peterdelecto/cubevox/hardware/reference/README.md

fxbox sources (Teensy-H7-Port 48f1e82), read-only reference; not the cubevox schematic.
