peterdelecto/cubevox/hardware/RUNLOG.md

# Run log
mechanical rules | no ledger (ran before this pass) | rules write: fab table, 3 netclasses, 0 custom rules; facts minima clearance 0.15, track 0.15, via 0.6/0.3, annular 0.15, hole clearance 0.25, edge 0.5 mm.
mechanical register | P0001-P0029 | register init seeded 29 pending entries from classification.json (brief sha 24c1c9e0).
mechanical fixed parts | E0001-E0036 | 36 decided entries, 36 do_not_move courtyard reservations (J1/J101/J106/J108 cite canon:37), board sha aa7361d3 unchanged. Edge-mount dry read for J1/J101/J106 computed x 148.5 (J1 +23.11, J101 -41.5, J106 -83.5 mm from the owner pose), J108 refused (axis +x vs extents 13.57/13.65); nothing applied.
mechanical gates | ledger 0012 (audit) | courtyard_inside_outline PASS 222 checked; edge_connector_mouth_at_edge not measured (J101, J108 no .wrl; J1 +1.527, J106 +3.700 mm); model_inside_courtyard FAIL J106 (right 3.4, below_board 11.0 mm). Gate rows carry no ledger id.
mechanical phase | state.json | phase placement moved from intake; only gate 1 read (state pass intake folds to purpose), mechanical rows were not part of the leaving gates.
placement skeleton render read | layout/renders/skeleton.png, Haiku | 1 yes, 2 no (J117 OLED header faces into the board: it is the panel display, not an edge connector, owner-placed E0019), 3 yes, 4 yes, 5 yes, 6 yes; most crowded upper left (MCU island). Stop: skeleton, owner review of the IC positions.
placement skeleton | D0002, ledger 0018, commit 7fb2764 | U1 (106,84,0) SAI pins to the band under the OLED, U8 (124,102.5,90), U6 (142,102.5,90), U106 (161,88,0), K101/K102 (66/78,56.5) at the output jack; 75 mcu/codec/output passives parked x>=268 for the cluster pass. Airlines: ADC_DOUT 130.1->22.8 (45), I2S_LRCLK 135.5->39.8 (60), USB_DP/DM 51.4/52.8->48.2/49.0 (50); closure 52 intended, 0 unintended; D0001 blocked (K101/K102 in E0031 by 1.5 mm) and re-posed. PRE_OUT 29->233 declared: bypass relay at the jack (canon 84).
placement usb_esd | D0003, ledger 0019, commit 1fed204 | intended 6, unintended 0; airline USB_DM 48.95>53.67 (budget 50, EXCEEDED), USB_DP 48.16>54.69 (budget 50, EXCEEDED), reach C18 5.68>3.93, body_tight 8>7, drc 92>88. Engine row at y 39.05 x 116-134.
placement input_9v | D0004, ledger 0020, commit a9ead93bea4d | intended 4, unintended 0; airline_total_mm 13886.2>13897.4; reach:D105 123.95>134.79; reach:D106 124.92>139.62; 
placement buck5_in | D0005, ledger 0021, commit 25a1a75168c1 | intended 4, unintended 0; airline_total_mm 13897.4>13913.9; reach:C112 5.27>8.39; reach:C113 1.99>8.03; 
placement buck33_out | D0006, ledger 0022, commit 7de04acd3295 | intended 5, unintended 0; airline:/h7core_block/BUCK_SW 8.985>11.829; airline_total_mm 13913.9>13915.8; reach:C21 10.46>8.88; reach:C22 12.53>8.85; 
placement buck33_in | D0007, ledger 0023, commit cc7880faa219 | intended 3, unintended 0; airline:/h7core_block/BUCK_SW 11.829>11.861; airline_total_mm 13915.8>13920.3; reach:C20 2.48>5.45; 
placement ldo_3v3a | D0008, ledger 0024, commit c64e513ed873 | intended 3, unintended 0; airline_total_mm 13920.3>13919.8; reach:C24 2.81>3.56; reach:C25 4.66>4.53; 
placement review | ledger 0024 state | cluster-pass agent stopped: D0003 usb_esd put USB_DP/DM airlines 53.7/54.7 over the 50 budget (canon 29 placement_gate) and D0005/D0007 raised buck input cap reach 2.0->8.0 and 2.5->5.5 (canon 36), accepted under canon:31 (tier 2 excusing tier 1). Power and USB clusters re-placed by hand from the pin map.
placement buck5_out | D0009, ledger 0025, commit 7d85575 | L101 (96,46,0) SW pad on pin 5 line, C114/C115 (100.5/103.5,46,270), C19 (109,46,0); reach up (instrument reads the 5V pin, not L101) declared.
placement buck5_in | D0010, ledger 0026, commit a36a9e9 | C113 (97,53,90), C112 (99.5,53,90) on U103 east flank, C116 (93.5,50,0); reach C112 8.39->4.58, C113 8.03->2.09; airline_total -22.7.
placement buck33_in | D0011, ledger 0027, commit 859d652 | C20 (92,60.9,270) west flank, C23 (96,64,180); reach C20 5.45->2.58; BUCK_SW airline 11.86->8.28.
placement i2c_pullups | D0012, ledger 0028, commit 025b569 | R142/R143 (137/139.5,60.5,270) north of J117 pins; airline_total -29.8.
placement buck33_out | D0013, ledger 0029, commit 7359655 | L1 (97.5,68,180) SW pad under pin 5, C21/C22 (102.5/105.5,68,270); BUCK_SW airline 8.28->6.03 (budget 6, trial route decides); reach C21/C22 9.05/11.28 (reads U1/U4 pins).
placement ldo_3v3a | D0014, ledger 0030, commit 740c9ca | C24 (102.5,63.5,270), C25 (109.5,63.5,270); reach C24 2.33, C25 4.86.
placement pwr_led | D0015/D0018, ledger 0031/0034, commit f6281e8/02f7096 | R10 (109,68,0), D3 (112.5,68,180) east of C22.
placement analog_rail | D0016/D0018, ledger 0032/0034, commit f09063f/02f7096 | FB101 (107,51.5,270) under C19 5V pad, C117 (109.5,51.5,90), R151/R152/C163 (112/114/116,51.5); airline_total -36.1. First pass left C117-R151 at 0.09 and C22-R10 at 0.28 (floor 0.3); D0018 re-spaced both, body_tight 4->2.
placement usb_esd | D0017, ledger 0033, commit 2cb6ede | row y 40.5 under J1: R5 C18 D2 R4 R6 R7 (120.5..132.5), D2 rot 0 flow-through; USB_DM 53.67->48.84, USB_DP 54.69->48.05 (budget 50); reach C18 3.02. Brief side=bottom not followed (register entry).
placement mcu block | D0019-D0030, ledgers 0035-0046 | crystal Y1 (105,95.5,270) HSE_IN 6.7/8, XTAL_OUT 4.1/8, HSE_OUT 3.7/5; SAI stubs R27/R29 2.8/2.6 of 3; VCAP1/2 2.6/2.4 of 5; decaps by pin: W C56/C2, N C57/C1, E C61/C5, E C58/C3, S C4 (pin 6), S C7 plane-fed 7 mm (pin 11, crystal takes the slot), C59 to the north row; bulk C32/C6/C31 north where 3V3 arrives; VDDA C9/C11/C10 row 1, FB1/C8 row 2; mux RC C55/R30 at x 114; reset/boot west; J3 west; LED west. Brief cluster memberships differ from the pin truth for C57 C58 C12 C13 C3 C6 C32 C31 C59 (correction for the owner at the stop). Section gaps under 3.0: north decaps to the power row 1.1-1.6, east decaps to J117 1.0 (canon 110, tier 1 reach over tier 2 gap).
placement codex 3a | audit/2026-10-02-round3-placement-questions.md | 6 questions, 6 replies: BUCK_SW budget 8 and USB 60 pass (brief change for the owner), pin 11 loop and via escape unsure pending geometry, crystal asymmetry and 3V3A run pass.
placement reset_boot room | D0031, ledger 0047, commit 504e361 | owner: more room left of the MCU. SWRESET1 (74,97), C14 (79,97,270), SWBOOT1 (84,97) in a row.
mechanical hand-solder | E0047-E0049 (E0053 after the J108 move), brief assembly.hand_solder_clearance_mm 3.0 | owner: clearance for hand soldering J101/J106/J108. Reservations 3 mm around each connector's pads; foreman has no floor by that name so the number lives in assembly and the reservations enforce it. D105/D106 moved to y 49 (D0032, ledger 0048).
mechanical owner moves | D0033, ledger 0049, commit cff1a08 | owner 2026-10-02: J108 +3 mm rearward (housing face at the edge per the STEP, pads 1.5 mm inside; bushing length NOT VERIFIED, datasheet has no drawing), J117 and ENC101 2.5 mm north (codec gap 2.6 -> 5.1), i2c pull-ups and enc_menu_rc followed. do_not_move entries E0025/E0028/E0031 retired and re-issued at the new poses (E0050-E0052 retired in between because a lock blocks its own move; re-added after D0033). J108's B.Cu courtyard then overlapped K101/K102 by 2.0 on the body-gap read: relays moved to a column x 76, y 59/70 (D0034).
parts J108 swap | ledger 0051 (ERC), 0053 (D0035), commit 1f52183 | owner 2026-10-02: output jack is HOOYA PJ-611E C309282, not NMJ6HCD2. Footprint AUDIO-TH_PJ-611E_1 and .wrl copied from the fxbox library (model offset 2.84/-2.85 kept), symbol spliced into cubevox.kicad_sym, cubevox.json J108 pins 6 OUT_TIP / 2 GND, schematic regenerated with --check-nets (parity: J108 only), ERC 0. Board footprint replaced, netlist sync, parity 0/0/0. Pose (72.5,41.0,90 B): mouth local +x to -y, front face 0.35 inside the edge, thread 8.7 proud; K101/K102 to y 60/70.5 for the body gap. Locks E0056/E0053 retired, E0057/E0058 issued. PARTS.md row 22 and spec item 9 updated.
placement preamp | D0036-D0043, ledgers 0054-0061, commits e337e10..889e0c7 | U104 to (200,79.5,90); mic legs stamped at x 193/207 (R10x y 59.5, clamp row y 63.5, 47u y 70.5, bias R at the pins y 77.5); TRS caps outboard y 70.5 with 100k bleeds below; INA feedback flanking U104, C158 under it, C118 on pin 8; diff quad in one row under U105 at y 90.5 (first at 90.0 left 0.25 to U105's courtyard, re-spaced D0043); C132/R116 between U105 and the pot, C159 east. MIC_P/MIC_N airlines 15.3/15.9 -> 13.6/13.6; body_tight 0 at ledger 0061. All six parts that stood in J101's hand-solder zone are out of it.
placement codec/output/control | D0044-D0053, ledgers 0062-0071 | adc_supply two columns east of U8 with the SAI band above; dac_supply column east of U6 plus C33 west; adc_input at pin 13 (R119/C136/C137 re-spaced D0053 after C137's 1206 courtyard, 5.27 wide not 4.69, overlapped R30 and C138); dac_output chain east at y 100.5; vref under U106, C160 the fan-out; output_buffer north of U106; relay drivers west/east/south of K101/K102; control rows kept from the pre-loop script, C147 and the pot_mux parts moved onto the stamp/grid. parked parts 0; airline_total 10540 -> 6773.
placement silk | ledger 0075, board 88e6877 | foreman silk --prefixes U,RV,SW,J: 38 refs stay on silk, 185 to F.Fab. DRC after: silk_overlap 0 (was 70), silk_over_copper 32, courtyard 0, edge 2 (J1 shell legs, owner part).
placement sai escape | D0054/D0055, ledgers 0073/0074 | routable 0072: 521/523, I2S_LRCLK unrouted at U1 pin 3. R29 to x 99.5, R27 to 97.75 (off-grid, stub 2.97 of 3.0), C2 to x 95. Re-read of routable pending.
placement brief corrections (draft for the owner) | brief sha 6c674db3 unconfirmed | flow order by anchor y with the loop note, mechanical dropped from the flow sections; BUCK_SW 8 / USB 60 (Codex 3a); hand-solder clearance 3.0; J108 PJ-611E pose, J117/ENC101 north; decap memberships by pin; usb_esd side top; buck5_in/buck33_in row. classification.json is still the confirmed 24c1c9e0 set, so the placement_gate reads BUCK_SW against 6 until the owner confirms.
placement render read | layout/renders/placement.png, Haiku | 1 no (the combo jack J101 protrudes about half its body length past the rear edge; owner pose E0028 with 6.9 mm overhang, flange and barrel through the rear plate; NOT VERIFIED against the Neutrik drawing, same open item as J108 had), 2 yes, 3 yes, 4 yes, 5 cannot tell (refs too small in the render), 6 no stray text. Most crowded: the OLED and MCU region.
placement routable | ledger 0076 (routable, after D0055) | 523 connections, 521 routed, 2 unrouted: /3V3 U1-11 -> U1-6 (both plane-fed by via in the power pass; the oracle has no planes) and /GND C12-2 -> U1-49 (ground pass). I2S_LRCLK now routes. Violations 8 (oracle's own, no copper written).
placement inspect | layout/inspections/0002, Sonnet reader | 26 warnings: 22 read a pin-side cluster as "not one row/column" (the brief's axis kind taken literally; placements are pin pairs by design, recorded per cluster E0037-E0078), 4 "no highlight in the crop" (instrument), 1 real: J101/J106/J108 references mirrored on the front silk (DRC mirrored_text_on_front_layer 3; foreman silk placed the flipped parts' refs on F.SilkS) -> silk/production pass item: move to B.SilkS.
placement STOP | board 88e6877, ledger 0075/0076, commit b9491b4 | gate: courtyard DRC 0, body gaps under floor 0, parked 0, every passive in a cluster entry, critical placement_gate all pass except BUCK_SW 6.03/6 (brief 8 drafted, Codex PASS), routable 521/523. Owner review requested: render, brief re-confirm (sha 60510ed3), J101 overhang question to Codex.
codex round 3 response | audit/2026-10-02-round3-response.md | BUCK_SW and USB conditional PASS (8/60 are bookkeeping budgets, not approval of long copper; keep the SW loop tight, keep the pair's ground reference); HSE asymmetry and 3V3A run conditional PASS; NRST/mux escape UNSURE (settling and oscillator clearance to verify at routing and bench); VDD pin 11 FAIL as placed: move a 100 nF beside pins 10/11, short wide connections, not a plane-fed cap 7 mm away. J101: ST-NCJ6FAH gives 6.35 mm seating face to nearest pin row and 5.7 mm face to barrel front; with the model front as the barrel front the board edge sits 1.2 mm behind the seating face (conditional on the model datum).
mechanical J101 face | D0056, ledger 0078 | Neutrik ST-NCJ6FAH: pegs 6.35 behind the panel face; pegs at y 35.31 put the face 0.99 proud of the edge. Owner: move 1.0 mm. J101 (190,45.2); locks and hand-solder zone reissued (E0082/E0083 after retiring E0028/E0047).
mechanical OLED standoffs | D0057, ledger 0079, E0084-E0087 | owner: more clearance for the OLED standoffs. J117 holes are 3.2 mm (M3) at (120.58/150.99, 63.25/91.75); 4.0 mm clearance reserved around each; C3 to (116,95.5), R146 (156.5,93), C160 (157.5,97), C161 (155,101), C139 (155.5,105) moved out of reach.
placement pin 11 | E0088 | owner: shared top-side cap with a 3 mm stub (C4 serves pins 6 and 11, pin 10 via 1 mm from the pad), over a bottom-side 0402.
placement mcu west | D0059, ledger 0084, commit 28636d6 | owner 2026-10-03: use the space west of the OLED. Whole MCU section -10 mm in x (41 moves), east decaps 11.8 mm from J117, standoff radii clear; USB 54/55 of 60, I2S 50/49 of 60, ADC_DOUT 32 of 45; body_tight 0. J101 D0056 (y 45.2, ledger 0080) and standoff parts D0057->D0058 (ledger 0083) applied after KiCad released the board (edits were refused while it was open). E0083-E0086 standoff reservations, E0087 J101 hand-solder zone.
critical start | D0064-D0068, ledgers 0089-0093 | crystal (HSE_IN/HSE_OUT/HSE_XTAL_OUT), SAI source stubs, VCAP1/2, BUCK_SW+BST, BUCK5_SW+BST routed on F.Cu, 45 deg only, route check 0 problems each. Placement reopened for the corner first: Y1 (96.2,96.7), R1 (99,95), C4 (93.35,94.5), R29 straight under pin 4 (91.5,95.25), C15/C16/C7, VDDA row east by 1 (D0062/D0063), C13 west of pin 73 (D0066) so VCAP2 does not cross the USB escape; escape plan for pins 10/11/14/15: vias at (94.3,93.6) (94.9,92.9) (96.6,92.9) (97.4,93.1), SAI pins 2/3/5 fan straight south at x 90.25/90.7/92.35.
critical usb pair | D0069, ledger 0094, commit ee4c8b4 | DP 57.18 / DM 59.26 mm, 2 vias each, mismatch 2.08 of 5.9, B.Cu pair at 0.401 pitch, F.Cu ties at J1/D2/U1, VBUS (0.3) and CC1/CC2 tied, GND vias (125.5,42.75) (92.25,74.0). Fails against stale classification 50 mm (brief draft 60) and gates 51/56 (45 mm coupled flagged on the pair itself, 79% coupled); CC2 hops VBUS on B.Cu (vias 123.64,37.5 / 120.5,38.2); U1 GND via moved from (90.9,73.9), which was 0.125 from C13 pad 1.
power 5V | D0070/D0071, ledgers 0095/0096, commits 9aa01cd/34d8c87 | width 0.4 (table 0.30 for 0.43 A, canon 48), In2 for the L101/U3/U4/relay runs, 9 5V vias, 9 GND vias (5 decap grounds, U103.4, U4.2, 2 CC2 grounds); gates 20, 47 pass, T-junctions 1 (pad), width steps 0, collinear 0. D0071 also removed a 1.4 mm collinear overlap at U3.2 and widened the D2 pin 2 ground tie 0.2 to 0.3. Not met: gate 63 FB101 5VA legs (5VA rail), C19 GND IC-side 3.17 vs 3.0 (anchor is J1.2).
parts STEP models | SW101-108, SWBYPASS1 (ST-0-102 STEP, offset 0/0/0 rot 0), J1 (USB-C STEP, 0/-2.35/0 rot 180), J106 (PJ-002A STEP, -7/4.3/0 rot 180), J108 (PJ-611E EasyEDA C309282 STEP, 10.69/-1.4/6.48 rot 270) | STEP is model 1, wrl dropped to avoid doubled geometry. Aligned numerically by VRML export of a model-only footprint: leads within 0.05 mm of pads, body bbox equals the wrl bbox (J108 exactly, SW/J106 exactly, J1 STEP is 0.29 mm nearer the pads than the wrl). foreman parts reads only .wrl so these refs read "not measured"; baseline J106/J108 model_courtyard_mismatch (B.Cu height read as below_board) is no longer reported. renders/cubevox-panel-parts.step/.png/-side.png re-exported.
power 3V3 | D0072-D0075, ledgers 0097-0100, commits f1e544d/030aaf9/4bcc29f/9f0582a | width 0.4 (table 0.30 for 0.41 A), 0.3 at pads; L1/C21/C22/R10 on F.Cu, In2 ring around U1 and a y 124 bus to the toggle pull-ups, 47 3V3 vias, 24 GND vias (18 decap grounds, U1 49/74/99, Y1.2, U8.5, U6.19). Gates 20, 45, 47 pass, right angles 0, mid-run T 0, collinear 0; all 18 3V3 decaps pass gates 63 and 68. D0072 left 3 mid-run Ts and 0.2 mm stubs (gate 47), so D0073 rebuilt the rail whole and D0074/D0075 removed 4 reversal overlaps and one acute corner at (93.15,99.2).
power 3V3A | D0076, ledger 0101, commit bfea272 | width 0.3 (table 0.20 for 0.06 A, 0.25 floor from canon 48), In2 trunk to the 14 pot pins with two B.Cu hops over the 3V3 lines (30 mm), 17 3V3A vias, 12 GND vias (C25 C27-C30 C101 C111 and IC pins U6 3/9, U101 17, RV111/RV113 pin 1). Gates 47, 48, 63, 68 pass for FB1.1, C25, C27-C30, C101, C111; FB1.2 legs belong to VDDA (D0080).
power 5VA | D0077, ledger 0102, commit c7e9b79 | width 0.3 (table 0.20 for 0.08 A), In2 east from C117 to U104/U105/U106 and R20.1 with 1 mm of B.Cu, 14 5VA vias, 9 GND vias (C117 C118 C127 C130 C134 and U104/U105/U106 pin 4, U6.11). Gates 47, 48, 63, 68 pass for the 5VA decaps and FB101.
power 9V_JACK | D0078, ledger 0103, commit fa51156 | width 0.4 (table 0.30 for 0.27 A), J106.3 to J106.2 and D106.2 on In2, 2 vias. D106 9V_JACK legs pass gate 63.
power VIN_9V | D0079, ledger 0104, commit 77d1e57 | width 0.4 (table 0.30 for 0.27 A), one 129 mm In2 run from D105/D106 to U103 with a 1.5 mm B.Cu hop over the 5V lines, 7 VIN_9V vias, 4 GND vias (C112 C113 D105.2 J106.1). Gates 47, 48, 63, 68 pass for C112, C113, D105, D106.
power VDDA | D0080, ledger 0105, commit 6bdb0f6 | not in the lead's rail list, closes gate 63/68 for C8-C11 and FB1.2: width 0.3, F.Cu links U1.20/21 to C9/C11/C8/C10/FB1.2, 6 VDDA vias, 5 GND vias; the C10 via at (108.45,96.85) has no In2 tie (3V3A line blocks, no hop taken on this analog rail).
power ADC_VCC | D0081, ledger 0106, commit b1e7400 | not in the lead's rail list: width 0.3, R20.2/C44/C45/U8.3 on F.Cu with one B.Cu hop (5 mm), 3 ADC_VCC vias, 2 GND vias. Not met: gate 68 C45 ground via 2.25 mm vs 2.0 (every via cell within 2.0 mm of C45.2 is blocked by C46/C47/C49 and the 3V3 vias).
power VREF | D0082, ledger 0107, commit c553e48 | not in the lead's rail list: width 0.3, In2 run (103 mm) tying C160.1 and the five divider ends R103/R106/R112/R123/R146 with two B.Cu hops, 9 VREF vias, 1 GND via. C160 passes gates 63 and 68.
power ground ties | D0083/D0084, ledgers 0108/0109, commits 5134ba5/7aa3991 | C18.2 own ground via (gate 68, was 2.75 mm) and the CC2 ground via moved to (119.6,37.4) so J1.2, the nearest anchor for C19 ground, has a via at 2.4 mm (gate 63 now 0 leg fails). Gate 63 passes; gate 68 fails only C45.
power STOP | ledger 0109 | rails 5V, 3V3, 3V3A, 5VA, VIN_9V accepted plus 9V_JACK, VDDA, ADC_VCC, VREF; 191 vias on the board; gates 20, 45, 47, 48, 63 pass, 68 fails C45; right angles 0, mid-run T 0, collinear 0, micro 0; DRC errors unchanged (5, J101 annular and edge). Gates 10, 19, 35, 37, 51, 56, 89, 111 fail for reasons outside the power pass.
mechanical OLED north 5 | D0085, ledger 0110, commit 4665dc8 | owner 2026-10-03: J117 (135.785,72.5), ENC101 (173.942,70.5) and their pull-ups and RC parts 5 mm north, 7.5 mm in total; E0054/E0055/E0083-E0086 retired and re-added as E0090-E0095 at the new poses and hole centres. Body gaps min 0.28 (two crystal pairs), courtyard_open none. Closure read drc_board_errors 5 -> 30 and shorting_items 0 -> 7 from the 3V3 copper left on the old pin positions. Enclosure: window and mounting holes 7.5 mm north of the first drawing.
power 3V3 OLED rebuild | D0086, ledger 0111, commit 848a404 | removed 25 segments and 5 vias of 3V3 near J117, R142/R143, R127-R129 and routed J117.2, R142/R143, R127, R128, R129 again (In2 0.4, one 3.9 mm B.Cu hop over the VIN_9V line, 4 vias). drc_board_errors 30 -> 5, shorting_items 7 -> 0, unconnected 384 -> 378; right angles 0, mid-run T 0, collinear 0.
brief reconfirm | sha 0ac6ed47 | classification.json regenerated with `foreman brief check cubevox.kicad_pcb --brief layout/brief.json --write-classification`; USB max length 50 -> 60 mm.
power relay rebuild | D0092, ledger 0119, commit 9188f8a | after D0090 (relay group 3 mm east): removed 13 segments and 2 vias of 5V/3V3 copper on the old poses, re-laid K102.1 via + D109.1 link, the In2 5V run to K102 and SWBYPASS1.1, R120.1 via and In2 tie, C20.1 to its via straight on. drc_board_errors 9 -> 3, shorting_items 2 -> 0, unconnected 384 -> 378.
pad entry audit | tools/pad_entry_check.py | owner rule canon 132 (straight-on pad entry): 51 violations on the board, all 45 degree entries; 47 after D0092.
pad entry repair | D0093-D0105, ledgers 0120-0132, commits cb3906e..f3fd9dd | one declaration per group: 3V3 13 (D0093, D0094 removed two overlaps against existing stubs), 5V+GND 4 (D0095), VDDA 6 (D0096), 3V3A 3 (D0097), ADC_VCC 3 (D0098), 5VA 2 (D0099), 9V_JACK 2 (D0100), VCAP 2 (D0101, VCAP1 3.20 mm, VCAP2 1.51 of 5), buck BST 4 (D0102, two diagonal tails trimmed), SAI U1.1 (D0103, 2.31 of 3 mm), USB R6.1 (D0104, VBUS), crystal 6 (D0105: HSE_IN 5.49 of 8, HSE_XTAL_OUT 2.65 of 8, HSE_OUT 4.46 of 5, 0 vias, 0.28 mm pairs untouched). Checker count 51 -> 0; no new vias; drc_board_errors 3, shorting 0, overlaps 0, mid-run T 0, right angles 0.
J101 NPTH | D0106 (supersedes D0091), ledger 0134, commit 4ad30f3 | owner converted J101's three peg pads to NPTH (footprint library changed to match). D0091 refused on accept: its baseline 0116 predated the router rebuild, so PRE_OUT and the airline total read as unintended; retired and re-declared on baseline 0132. drc_board_errors 3 -> 0, drc_board_total 120 -> 114, unintended 0. Lock re-added as E0099 (B.Cu courtyard box at y 45.2). GUI save had dropped the foreman.pour_* board properties; the committed board keeps them.
power redundancy cleanup | D0110-D0124, ledgers 0139-0153, commits d039319..474f08b | via hops and loops removed on /3V3 (A north row D0110, B C5/C61 D0111, C D0112-D0115), /3V3A (D0116 C29/C30, D0117-D0119 U6/C101/C111, B.Cu reroute fixed a GND short and a right angle), /5VA (D0120-D0122), VDDA (D0123, F.Cu only, no In2 feed), VIN_9V (D0124). Vias 187 -> 160, segments and copper down, loop-closing segments 0 on all five nets (cvx_loops.py), drc_board_errors 0, pad_entry_check 0, unintended 0. Gate 63 regresses where one shared via sits beyond 3.0 mm of a decoupler leg (C6, C32, C46, C1, C57, others).
canon 133/134 cleanup | D0125-D0127, ledgers 0155-0157, commits 2b92627, 34baba0, 9c176a6 | D0125 /3V3: C21/C22/R10 joined on F.Cu, via 101.65,65.5 removed, In2 crossing loop at 106.96,70.99 removed. D0126 /5V: second C19 via 105.0,47.1 removed, In2 trunk re-attached to via 105.55,47.65. D0127 ADC_VCC: all three vias and B.Cu/In2 hops removed, F.Cu chain carries the net. Gate 134 8 -> 0. Gate 133 8 -> 5; the five left are 0.0 mm artifacts of through vias on the edge of TH pads (RV111.3, J106.3, and GND vias at RV111.1, RV113.1, J106.1), not copper loops.
gate 45 and right-angle cleanup | D0128-D0129, ledgers 0158-0159, commits da40681, a492418 | /3V3 In2 junctions rebuilt so no angle is under 90 degrees: 82.55,91.25, 92.5,95.9, 101.65,65.5 and 105.8,70.5 (the last two from D0125). Branches leave the trunk perpendicular with a stub of 0.9 mm or less, then bend 45 degrees. Gate 45 4 -> 0, right_angles 0.
TH-pad via trial | D0130 removed the vias at RV111.3 and J106.3 (gate 133 5 -> 3) but gate 63 went 30 -> 33 fails (C29, C30, D106 lost their via); D0131 (ledger 0161, commit 6f4cce5) restored them. Gate 63 stays at 30 fails, all introduced by D0110-D0127, none present at ledger 0138.
TH-pad via move | D0132, ledger 0162, commit dee3363 | RV111.3 via moved to 187.0,144.0 (straight F.Cu track from the pad centre), J106.3 via moved to 232.6,37.0 (straight F.Cu track from the pad centre, In2 re-attached to J106.2). Gate 133 5 -> 3 (GND artifacts left), gate 63 unchanged at 30, gate 134 0.
ADC_VCC U8.3 split | D0133, ledger 0163, commit cffde3b | F.Cu segment 125.2,103.2 to 128.85,103.2 split at U8.3's centre (126.8,103.2) so it ends in the pad. Segments 616 -> 617, unintended 0, gate 63 unchanged at 30.
USB D2 + VBUS link | D0160, ledger 0192, commit 2fc50c9 | D2 flow-through pads bridged (DP 6-1, DM 4-3), J1's two VBUS pins joined by a B.Cu hop to a new via on the A4B9 track. Unconnected 169 -> 166, DRC errors 0.
Codec bus | D0161, ledger 0193, commit 2d55ecf | I2S_BCLK, I2S_LRCLK, I2S_DATA, ADC_SCKI, ADC_DOUT routed MCU -> codec on B.Cu lanes over the 3V3 island (DATA 93.9/94.15, LRCLK 94.5, BCLK 100.55, DOUT 101.2, SCKI 102.3). Pin 6/11 3V3 via moved under pads 7-9 at 94.3,92.9 feeding C4.1; U8 west GND vias moved under the body; U6 GND vias at x 141/143; ADC_VCC rebuilt R20 > C44 > C45 > U8.3. Gate 71 21 -> 6, gate 45/133/134 pass.
Codec bus fix | D0162, ledger 0194, commit c9b6fe7 | Ground via beside every bus via (gate 17 pass), BCLK and LRCLK chained through U8.8/U8.7 instead of branching at vias, DOUT via in line with U8.9, R20/C44 0.35 mm west for a ground via at 136.4,100.1. Gate 132 0 on the bus nets.
LRCLK U8 turn | D0163, ledger 0195, commit b0f59ff | LRCLK F.Cu leg north of U8 lengthened to y 96.3 so gate 136 reads a turn, not a jog. Gate 136 15 -> 14.
J1 west 10.39 mm (owner) | D0164, ledger 0196, commit 348adb9 | Owner moved J1 to x 115.00; D2, C18, R4-R7 and their copper moved with it; VBUS hop rebuilt with on-axis via entries. USB pair rerouted as an orthogonal staircase (four chamfers, diagonals <= 5.9 mm) in place of the 45 mm diagonal. J1 lock E0096 retired, E0108 at the new pose (declare --owner does not re-anchor locks for --actions plans).
USB pair coupling | D0165, ledger 0197, commit c0d9e2f | DM shifted beside DP right after D2 (one 2 mm lane shift) so the pair runs coupled. DP 58.12, DM 57.68 of 60 mm, 0 vias; gates 56, 45, 133, 134 pass. J1 A6/B6 crossover jog recorded as a rule 136 reason.
Owner USB reroute | D0168, ledger 0202, commit 99ab857 | Owner's hand reroute of USB_DP/DM recorded (DP 54.99, DM 54.55 mm, 0 vias) with the 0.041 mm DM sliver merged. D0166 retired (baseline already held the edit). Long 45 degree runs kept by the owner, reason E0110.
R120/C162 to pin 63 | D0169, ledger 0203, commit 90524de | FX_ON_SENSE pull-up and filter moved beside U1.63 (own 3V3 via, own GND via); the 9.8 mm 3V3 trace from the 5V island is gone. K101.5 link left for signal routing.
C3 via stubs | D0170, ledger 0204, commit 187353f | C3 0.3 mm north; 3V3 and GND vias on 0.85 mm side stubs clear of the codec bus B.Cu lanes.
Power LED | D0171, ledger 0205, commit b334761 | R10/D3 column at x 108.3 beside the MCU corner decoupler column; PWR_LED_A routed.
C139/C161 north | D0172, ledger 0206, commit c6cc969 | C139 1.0 mm, C161 0.75 mm north (C160 courtyard limits C161); C139 clears SW105 by 1.41 mm.
MCU pin study | D0186 ledger 0227 (addfda4), D0194 ledger 0235 (39227c6) | Every movable U1 net moved to the edge facing its destination, ordered so the fan-out does not cross (PINMAP.md section 2). I2C1 PB8/PB9 → I2C2 PB10/PB11, nets renamed I2C_SCL/SDA. CC1/CC2 off the MCU (USB data only). Airline total 6978 → 6663 mm. Schematic 43 pins changed (allowed), ERC 0, parity 0/0/0.
VA divider | D0188 ledger 0229, D0190 ledger 0231, D0192 ledger 0233 | R151/R152 beside U106's 5VA pin (C130), C163 at the MCU end (114.5, 87.2). D0188 put C163's GND via on VREF's B.Cu run; the landing helper had auto-declared the short, fixed in D0190 and the helper now refuses rising error metrics. U106 reference moved onto its body (silk overlap). DRC 0.
U106 divider north | D0196 ledger 0237 | R151/R152/C130 north of U106, 2.4 mm clear of the OLED courtyard (owner). 5VA via (158.0, 83.1) on the 5VA island.
Designator prune | D0198 ledger 0241 | One visible designator per part: 186 passives keep the centred Fab text (field hidden), 38 U/RV/SW/J keep the silk field (Fab copy removed).
West fan-out clearing | D0200 ledger 0243 (cb245d8) | USER_LED to PE11 with R3/D1 east of U1, R2 at SWBOOT1, R150/R153 swapped, C12 horizontal. DRC 0, parity 0/0/0.
SWD + MUTE_N | D0202 ledger 0246 | SWCLK/SWO in the J3 pocket (jogs excused E0111/E0112), SWDIO on B.Cu over the 3V3 island (E0113), MUTE_N into R150 from below. Gate 20 flags the SWDIO pocket via, but canon 20 sends a via crossing to a power reference (B.Cu over In2 3V3) to rule 17; gate defect to file.
K101/D104 off J108 | D0204 ledger 0248 | Owner: K101 and D104 physically interfered with J108. K101 rot 90 at (86.3, 49.2), 1.0 mm east of J108's courtyard; D104 below its coil pins at (88.08, 56.05). D104/J108 overlap (-2.27) gone.
C14 at SWRESET1 | D0206 ledger 0250 | Owner: C14 beside SWRESET1 like R2 at SWBOOT1, (60.95, 86.15). ST places the NRST cap at the pin; the long NRST run to U1.14 must stay short of noisy nets.
C29/C30 3V3A bulk | D0208 ledger 0252 | Owner: misplaced between the pot rows. Now at (165, 100.3/102.4) on the 3V3A island's north edge, 12 mm east of the LDO feeder's island entry (153.4, 99.5), each pad on its own via.
ENC102 RC at the encoder | D0210 ledger 0255 | Owner: C146/C147/R130/R131 sat 30 mm from ENC102 across RV103. Now on ENC102's A/B pins (y 151.5/153.6), chain R → C → encoder pin straight down each line. Pull-ups fed by two 3V3 traces from the 3V3 island (vias 55.5/75.5, 128.5), because In2 under the encoders is the 3V3A island.
Clock top-layer attempt | D0211 retired | MCLK via U8's under-body channel shorted U8's own GND/3V3 vias there (7 vias between the pin rows) and a GND via at (88.15, 103.3). Board restored to D0210. Moving U8's ground vias out of the channel would lengthen U8's ground return; not taken.
In2 second GND plane | D0213 | Stack SIG/GND/GND/SIG (canon 10, owner 2026-10-03). In2 copies In1's GND zone; the four rails become traces. 75 rail vias left dangling until each rail is routed.
5VA rail | D0216 | B.Cu 0.3 mm traces from the FB101 via. Gate 134 pairs at (202.5, 82.5) and (135.65, 96.375) still to merge.
3V3A rail | D0222 | B.Cu 0.3 mm. Old F.Cu feeder diagonal (148, 88)→(153.4, 93.4) still a gate 136 row.
J108 3D model | D0226 | J108 uses the PJ-611E STEP with the library offset; panel-parts STEP export carries every jack.
5V trunk | D0229 | B.Cu 0.5 mm from the buck, 8 connections. J117's footprint rule areas now in the router's obstacle map (D0227 crossed them, retired).
J101 2 mm north | D0231 | Owner: the combo jack's through-plate screw holes did not stand proud enough for the enclosure. Traces follow; brief pin and overhang updated.
5V U4/C24 branch | D0234 | VIN_9V on B.Cu at y 55.5 walls the LDO off, so F.Cu: trunk via (156.1, 59.375) → C24.1 → U4.3, and a U4.1-U4.3 tie under the body west side (jog excused E0114). Three plane vias removed.
5V loops | D0236 | D0229 left a 17 mm B.Cu ring at FB101 and a buck loop through via (102.3, 45.5). Both removed; gate 133 0.
5V C20/U3 vias | D0238, D0240 | Vias (93.35, 58.75) and (95.5, 58.9) and their B.Cu branches removed; via (90.6, 59.95) moved onto C20.1's axis. D0240 refills zones (fm edit leaves stale fill around new vias).
3V3 trunk attempt | D0242, undone D0244 | Router plan closed two loops (gate 133). Router fixed: raster island grouping, start disk blocked after the first leg. Remaining loops come from per-pad decoupler vias, so pairs are merged before re-routing.
3V3 via merges | D0247 | U1.100 → C56.1 straight, via (87.25, 90.0) gone; U1.75 into C57's via (88.25, 75.16), via (90, 75.25) gone; R135/R132 share one via at (88.5, 127.0). Top-row U1 decouplers still to merge, then route 3V3.
J101 2.5 mm south | D0249 | Owner correction: J101 at (190, 45.7), 0.5 mm south of its D0056 spot. Traces follow; brief pin and overhang updated.
3V3A/5VA via merges | D0251, D0253 | Each pin feeds its cap on F.Cu with one via: C28.1 → via → U101.24 → C27.1 (C28 0.08 mm S, C27 0.06 mm W; pin 24's via and its 25 mm branch gone), C29.1 → C30.1, U104.8 → C118.1 (C118 0.1 mm W), C134.1 → R20.1 (C134 0.125 mm N). Two 13 mm B.Cu loops the router drew around U104 and over C134 removed. Gate 134 0 on all rails.
3V3A feeder | D0254 | The 7.6 mm diagonal at (148, 88) becomes orthogonal runs with 0.5 mm chamfers along y 90, clear of J117's rule area.
5V pad entries | D0255, D0256 | Buck output node (L101.2, C114.1, C115.1, C19.1, trunk via) is a solid F.Cu 5V pour; its pads are too large and offset for centred traces. K102, C20/U3 and U103 enter from pad centres; K102's via moved onto the pad axis and the trunk bend moved so no diagonal exceeds 6 mm. Gate 132 has no rail rows.
Owner hand cleanup | D0258 | Owner re-drew rail and I2S traces. Audit found three 3V3A loops at pot pin 3s, a 5V loop under the buck via, an 8.4 mm diagonal, a dangling stub and a 45-degree via entry.
Pot-row 3V3A bus | D0260 | Straight buses at y 147.4 (west) and y 143.5 (east), one stub per pin 3, columns pass through the pins. Loops and stub gone.
Via and 5V drop | D0261, D0263 | C101's 3V3A via onto the B.Cu trunk row; the buck via drops on one stem (west branch at y 56.8, chamfer to the y 60.8 trunk).
I2S spacing | D0264, D0266 | DATA and LRCLK lane-change past the x 102/106.85 GND vias: 0.75 then 0.7 mm centres (3W); LRCLK no longer under Y1. Gates 35 and 51 pass.
U4 input cap | D0268 | C24 turned 180 and moved 0.35 mm: U4.1 (IN) -> C24.1 straight 2.2 mm. Gates 63/71 still read a 5V via 7 mm off (plane model); decided E0115.
ADC_VCC 0.3 mm | D0269 | Widened from 0.15 between the C44/C47 and C45/C46 rows; forced jog excused E0118.
Signal-via ground | D0271 | GND vias beside the two CC2 vias and the SWDIO via; gate 20 passes. CC2's B.Cu bridge stays (E0119).
3V3 escape | D0273 | U1 pin 6/11 escape 0.3 mm once clear of the pin field.
Decisions | E0115-E0120 | VDDA bulk caps upstream of C9/C11 by design (E0116); C44/C47 each have their own GND via, gate 68 pairs them by nearest-via (E0117); J1 GND pin to shield trace (E0120).
5VA drop | D0275 | The x 155 drop from the U106/C130 via lands on the west trunk at (155, 96.375); the 9 mm detour east to R117's via and back along y 97.2 is gone (owner).
Pot 3V3A daisy chain | D0277 | Owner: supply runs pad to pad, no stubs. East RV109 -> RV111 -> RV113 -> RV101 along y 145.5, over each pot's pins 1-2 at y 143.5, into pin 3 from the north. West enters RV105 from RV106 below, then RV104 and RV103 from the east.
Toggle pull-up chain | D0280 | 3V3 runs pad to pad through R138.1-R141.1: in from the south, out east on the pin row, down to y 126.3 under each toggle's cap and GND via, up into the next pin 1. R127/R128 keep their T: ENC101 and ENC_MENU_B block the south, the trunk holds the north (owner asked).
3V3 owner routing + fixes | D0281-D0283 retired, D0284 ledger 0332, commits 822caab, 9d97768 | Owner joined 3V3 pads on F.Cu (C2, FB1 vias gone) and began the B.Cu trunk (83.57,79.73 to 86.48,90.71; 91.5,70.31 to 93.7,72.4). Lead: one via per F.Cu group, so (86.5,75.125) and (94.3,92.9) removed; U1.6-U1.100 tie centred on pin 100 at y 90.0; U1.99 GND via to (90.8,89.0) to clear it; micro segments and an overlap at the source via cleaned; pin 6 run 0.3 mm throughout. Open on 3V3: gate 132 at via (97.95,65.3) and J3.1, gate 136 jogs at (96.84,70.26) and (93.4,69.57).
3V3 source cleanup | D0285/D0287 amended, D0286 ledger 0335, D0288 ledger 0339 | U3.1 sense line leaves the F.Cu detour round L1.1 and runs B.Cu from C22's via (88.6,66.825) along y 66.825 into via (97.95,65.3) from the south. A branch off the source trunk failed: a T is either a 45 degree acid trap (gate 45) or two right angles. C1.1 joins C57.1 on F.Cu; J3.1 keeps only its west run to via (83.57,79.73), since J3's peg at (85.0,78.46) blocks a straight north exit. 3V3 rows on gates 45, 132, 133, 134, 136: none.
3V3 orphan vias | D0289 ledger 0341, snapshot bcc57c3 | Owner: the In2 3V3 island went in D0213 but its vias stayed and routing used them. All 29 dangling 3V3 vias removed with their 26 pad stubs (chains up to 3 mm); the encoder feed (55.5..75.5,128.5), the toggle chain end (140.5,122) and the R128 feed (145.5,52) keep open ends for the trunk. Micro segment at via (91.5,70.31) removed. Rule saved: a plane's vias leave with the plane. Open: owner's B.Cu jog at (90.65,70.65), gate 136.
Power-up order decision | Codex 2026-10-04, owner relayed | If 3V3A rises before 3V3 the pots can drive STM32 ADC pins above the injection limit. Fix: sequence the TLV75533 (3V3A) EN from a qualified 3V3 power-good, not series resistors on the wipers. AP63203 has no PG pin, so this needs a supervisor on 3V3 (open-drain, holds EN low until 3V3 is valid) added to the schematic. Schematic change pending; board work on 3V3 continues meanwhile.
3V3 session 2 repairs | snapshot a79cb67, D0290 amended to D0291, ledger 0347, commit b072bb2 | Owner routed 3V3 31 to 13 unconnected. Fixes: C8/C164/C10 each regain their own GND via beside the pad; micro segments and overlaps cleared; T-junctions at R127/R128 straightened; mid-run branches removed. Two extra B.Cu vias for C46 to U6.20 were rejected (one via per pad group) and removed, leaving that link open (3V3 14 unconnected) until C46 is re-placed at pin 20. DRC 0 errors, dangling 2, vias 201. Gate 63 "trace to IC" rows on C3/C5/C6/C7/C31/C32/C46/C47/C59 stand; decoupler re-placement plan pending owner approval.
3V3 decouplers: pin 75 | D0292 ledger 0348, commit 046531b; sch 93cf446 | C1 deleted, C57 now 100 nF. The 3V3 via (88.25,75.16) was a 90-degree F.Cu junction, so it moved to (87.25,74.48): B.Cu trunk in, F.Cu straight through from the J3 run into C57.1. Pin 75 enters C57.1 from the south with its chamfer ending in pad copper. C1's GND via removed. Vias 201 to 200.
3V3 decouplers: pin 50 | D0293 ledger 0349, commit 7cce521 | C5 deleted, C61 now 100 nF at (105.1,77.52) rot 90, pin 50 one straight 1.55 mm, GND via (104.3,77.04). C12 (VCAP1) to (107.15,79.0), closer than the planned 108.71; VCAP1 0.3 mm through the pin row, 0.4 mm from x 104.6, GND via (108.72,79.0). Spine C32.1 to R10.1 is now one diagonal; C32.1's south side feeds C61.1 from the east.
3V3 decouplers: bulk + U8.4 | D0294 ledger 0350, commit d083b2a | C31/C59 deleted and C6.1 to C32.1 joined straight. C46 is registered bulk (brief adc_supply) at (129.225,99.19) rot 90, fed from C47.1's north side, GND via (129.225,97.6); trace to U8.4 is 4.13 mm. C6/C32 entry bulk and C21/C22 buck output caps are reasoned under brief vdd_decap_north and buck33_out. Regression: C46's old GND via (135.5,104.0) was the return via for I2S_LRCLK via (137.1,103.1), so gates 17/20 now fail there (2.47 mm to the nearest GND via, reopens O0164/O0165). Open.
3V3 decouplers: U6.20 DVDD | D0295 ledger 0351, commit 00b9edc; D0297 ledger 0353, commit ee905e7 | New C165 100 nF 0402 at (137.01,105.43) rot 180, pin 20 straight 1.64 mm, GND via (136.53,106.2); trunk reaches C165.1 from the south first. C33 to (136.43,104.13) rot 180, LDOO straight 1.93 mm, GND via (134.85,104.13). SW104 pads start at y 111.71, clear of the trunk chamfer. D0297 fixed C165's FPID nickname (schematic parity back to the 116 pre-existing items).
3V3 decouplers: pins 100/27, C7, tie | D0296 ledger 0352, commit 682a4ba | In-line pairs C56/C2 at pin 100 (fed through new via (82.75,90.0)) and C58/C3 at pin 27 (fed from the FB1 riser). FB1 island tied to the main trunk by V1 (109.5,71.975), B.Cu x 109.5, V2 (109.5,91.0). C7 now directly below pin 11 (pin 11 to C7.1 straight, fed from C4.1); Y1, C15 and C16 moved 2 mm south; HSE_IN/HSE_OUT jog at the pin tips; pin 6 enters C4.1 from the north. Five old gate-132 rows on HSE nets cleared. Vias 198 to 200.
I2S_LRCLK return via | D0298 ledger 0354, commit dd1f35b | GND via (136.2,103.15), 0.90 mm from the I2S_LRCLK via (137.1,103.1), at least 0.27 mm from all F/B copper, tied by the In1/In2 GND planes. Gates 17/20 pass again (0 vias beyond 2.0 mm). O0164/O0165 stay open in the register: foreman closes a reopen only through a consuming declaration, and it refuses to consume a reopened acceptance (A0211/A0212), so no command can close them. The premise they cite (no new gate:17/20 finding) holds again.
Owner 3V3 routing cleanup + USB_DM tee | D0304 ledger 0362, commit 54f56ff (D0299/D0300/D0301/D0302/D0303 retired; tee exception E0121) | Accepted the owner's 3V3 routing (3V3 now 4 unconnected) and the restored USB_DM A7 tee (owner option B; vias would put DM on two layers and fail gate 56). Cleanup: overlapping dangling stubs removed at C165 (137.49,105.43-106.375), R134 (64.5,124.15-125.1) and R133 (84.5,126.1-127.0, now one straight entry); the 0.07 mm 45-degree stub at R135.1 removed. Open: (124.6,106.6) is a three-way junction (U8.4 feed, west trunk, C165 trunk); on a 45/90 grid three runs at a free point always include a 90-degree pair, so the right_angle finding stands (reopens A0229-A0231) until the junction moves to a pad. D0302 was refused (it consumed E0121, which reserves nothing); D0303 was refused (its baseline already held the edit).
3V3 supervisor (SP809) | sch ce6624e; D0305/D0306 amended to D0307, ledger 0366, commit fa55951 | U107 SP809EK-L-2-9/TR (LCSC C412495, SOT-23: 1 GND, 2 /RESET, 3 VCC) on 3V3 drives TLV75533 EN through new net LDO_EN, replacing the 5V tie. Output is push-pull active-low per the MaxLinear datasheet (JLC's open-drain label is wrong), so there is no pull-up. Reset timeout t_RP is 140 ms min / 230 ms typ (560 ms max); threshold 2.9 V. TLV755P EN V_HI is 1.0 V max, so 3V3 drives it fully. TLV755P has active output discharge (R_PULLDOWN 120 ohm typ), so 3V3A is pulled down once /RESET goes low at 3V3 < 2.9 V. Injection check: pots are 10 k (RV101-RV114, RVGAIN1), so wiper source impedance is at least 2.5 k; 3.3 V / 2.5 k = 1.3 mA, under the H7's 5 mA injection limit while 3V3A outlasts 3V3. Placement: U107 (157.75,51.49) rot -90, C166 100 nF (160.45,52.43) straight 2.2 mm from VCC pin 3 with own GND via (161.73,52.43). C24 moved 0.4 mm south to (155.0,52.075) so LDO_EN can run straight along y 50.55 from U4.3 (152.8,50.55) to U107.2 (156.8,50.55); its 5V and GND stubs re-laid, the EN-to-5V tie removed. LDO_EN not routed yet.
3V3 junction at (124.6,106.6) | D0308 ledger 0367, commit 555547d | The free three-way 3V3 junction (U8.4 feed, west trunk, C165 trunk) moved to a straight-through via J (124.6,107.55): both trunks pass straight through on F.Cu at y 107.55 (moved from 107.5/107.525 to keep 0.225 mm from C48's GND via), and the U8.4 feed drops to B.Cu at J and climbs back at via (124.6,103.6). No pad could take the junction: U8.4 (TSSOP pin) has only E/W entries and both are used; C47.1's west side is blocked by U8.5; C46.1 is boxed by the ADC_SCKI via and I2S_LRCLK at x 131; ADC_VCC holds y 102.5. Two new 3V3 vias (202 to 204). right_angles 4 to 3; no new gate rows. Reopens A0229-A0231 stay open in the register: foreman refuses to consume a reopened acceptance, so no command can close them, but the right_angle finding they cite is gone.
3V3 routing complete | D0309 amended to D0310, ledger 0370, commit see git log | Owner finished the 3V3 routing. Last gap closed: the y 125.6 run had split into a west chain into R133.1 and an east chain into R135.1. The west run now enters R133.1 from the west, (67.2,125.6)-(82.6,125.6)-(84.0,127.0)-(84.5,127.0), and R133.1 links north to R135.1's free west side, (84.5,127.0)-(84.5,126.1)-(85.0,125.6)-(86.9,125.6)-(88.35,124.15)-(88.5,124.15). 3V3 unconnected 0. The collinear overlap at R128.1 (169.942,60.5) lies wholly inside the pad copper; owner ruled it is not a defect (register E0122, expect overlaps:up). It reopened A0233-A0235 on the collinear_overlap finding.
Output chain re-placement decision | Codex 2026-10-05, owner approved plan A | OUT_AC from C141 to K102 needed 86 mm and two vias because U6 (DAC) and the output buffer sit east of the I2S bus while the relay and jack sit west. Fix: move U6 and the whole output chain (30 parts) into the pocket SW of U1 so every analog hop is a short via-free F.Cu run; the I2S bus becomes a ~60 mm F.Cu branch over solid GND. Codex: sound; add 22-47 R series footprints at U1 on BCLK/LRCLK/DATA (schematic add, 33 R default), no tee stubs on I2S, keep relay coil currents and the charge-pump caps away from the analog outputs, stitch GND within 1 mm at any layer change, keep coil suppression (D109). Execution staged D-by-D by agent cvx-router; stage 1 blocked on a board-write permission rule 2026-10-05.
Output chain re-placement, stage 1 (placement) | D0311 amended to D0312 then D0313, ledger 0374, commit 4fc99c5 | Moved U6 (DAC) and its decouplers, the DAC filter (R147 C161 C139 R122 R123), K101, D104, U106 with C130 and its VREF parts (R146 C160 R117 R118 C135), R124 C141 R125, K102 and the mute driver (D109 Q101 R153 R150) into the pocket SW of U1, in signal-flow order to the jack. Removed the 175 orphaned items (32 GND tracks and 25 GND vias, 5V via 75.2,72.4, I2S stubs at U6, 3V3/3V3A/5VA/VREF stubs, old DAC chain, OUT_AC and BUF_R copper). DRC 0 errors, 47 silk warnings; unconnected 130 to 173; closure unintended 0, no gate rows. The owner's LDO_EN 0.0035 mm micro segment at U107.2 was removed by hand before accept (micro 0). Re-opened A0033/A0048/A0050/A0175 (body_gap on K101/C141/D109/U106) and A0218 (3V3A right_angle at the removed vias 147.3,99.5 and 147.3,106.28); the 3V3A corners are re-laid in stage 4.
Output chain re-placement, stage 2 (local ties) | D0314 amended to D0315, ledger 0377, commit 8e527e5 | 47 F.Cu segments and 24 GND vias: U6 supply pins straight to C111/C35/C101 (3V3A, VNEG), CAPP/CAPM to C34 with 90-degree steps between C111 and C35, U6.20 to C165 (3V3), U6.18 to C33 (LDOO), U6 GND pins 3/9/10/11/12/16/19 to seven vias under or beside the body; U106.8 to C130 (5VA), U106.4 GND via, U106.1/2 to R146 (VREF_BUF), R146 to C160 (VREF), U106.3 to R117 to C135 and R118 (VREF_DIV); every moved decoupler and GND pad (C111 C35 C101 C165 C33 C130 C160 C135 R118 C161 R125 Q101 R153 K101.6/.8 D104) has its own GND via. Pre-check 0 clearance fails (worst 0.295 mm), 0 loose ends. DRC 0 errors, 47 silk warnings; unconnected 173 to 135; closure unintended 0 after amending for one new right_angle (VREF_BUF corner at 69.0,89.07, U106.2 into R146.1 from the south; 90-degree bends are within the routing rule).
Output chain re-placement, stage 3 (analog chain) | D0316 amended to D0317, ledger 0380, commit 0f9eb33 | 19 F.Cu/B.Cu segments, 4 vias. All-F.Cu, via-free chain in signal order: DAC_OUTL U6.6 to R147 (7.1 mm lane between C35 and C101), DAC_LP R147 to C139 and C161, DAC_AC C139 to R122, DAC_ATT R122 to R123 to K101.4 (under-body entry from the south), BUF_IN U106.5 to K101.3 (2.5 mm straight), BUF_OUT R124 to U106.7, BUF_R C141 to R124, OUT_AC C141.2 to K102.3 (3.3 mm straight) and to R125. MUTE_N R150 to U1 with one B.Cu hop (vias 69.9,82.75 and 81.75,85.5), GND return vias 0.9 and 0.85 mm away. Pre-check 0 clearance fails (worst 0.250 mm). DRC 0 errors, 47 silk warnings; unconnected 135 to 123; closure unintended 0 after amending for two 90-degree corners (BUF_OUT 79.6,89.07 and DAC_ATT 75.4,96.9).
MUTE_N via entry fix, stage 3b | D0318, ledger 0382, commit 32d8a28 | The stage 3 B.Cu diagonal entered via (81.75,85.5) at 45 degrees (gate 132 row, re-opened A0180). Replaced with (69.9,82.75)-(78.5,82.75)-(81.25,85.5)-(81.75,85.5) so the last 0.5 mm runs straight into the via centre. Gate 132 rows for /MUTE_N now 0. DRC 0 errors; unconnected 123. Pre-checks now include a straight-entry check on every via.
Output stage local supply/bias and VREF buffer east, stage 4a | sch 7b80845; D0319 amended to D0320, ledger 0386, commit 2d316b5 | Schematic split (owner decision via lead): new U108 OPA197IDBVR (LCSC C221351, SOT-23-5) is the VREF follower, back east with R146/C160/R117/C135/R118 at their pre-stage-1 positions and its own C167 100 nF; U106 A half tied off (pins 1-2 U106A_OUT, pin 3 BIAS_W); west output stage gets 5VA_W (FB102 from 5V, C168 10 uF, C130 kept at pin 8) and BIAS_W (R154/R155 10 k, C169 10 uF), R123 to BIAS_W. Board: 13 orphaned items removed, 7 footprints added, 35 segments, 8 GND vias (each decoupler its own); U108 OUT to -IN tie under the body. C160 GND via moved out of its 2.8 mm pad to (159.16,95.7) after gate 132 flagged the off-centre end. Netlist parity 0; DRC 0 errors; unconnected 123; no new fails on gates 17/20/45/49/51/56/68/132-138. Open: silk warnings 47 to 140 (std-lib outlines of the new 0402/0805/SOT-23-5 parts against tight neighbours) for the silk pass; re-opened A0170/A0238 (VREF right_angle).
Rails to the moved output stage, stage 4b | D0321, ledger 0389, commit 7f6d093 | 5V: D109.1 to K102.1 on F.Cu with via (74.2,72.4), FB102 its own via (68.5,72.4), B.Cu trunk split at both (leaves MUTE_COIL a path west of D109). 3V3: C165.1/U6.20 via (84.0,102.5) to the existing via (82.75,90.0) on B.Cu; trunk link J (124.6,107.55) east and down x 139.13 to (136.5,124.15) restored (U6.20 had been a pass-through node). 3V3A: C111/C101 vias (73.1,102.4)/(73.1,108.9), B.Cu down x 73.1 and into RV103.3 from the north (first lay overlapped the pots' trunk at RV103.3, gate 133 loop and gate 136 45-degree run; re-laid before accept). 5VA: R117.1 via (162.0,95.753) restored, reconnecting the dangling B.Cu tail; U108.5 into via (158.0,83.1). VREF: R146.2 via (157.25,92.1), original B.Cu trunk along y 91.0 to (197.75,76.5). DRC 0 errors; unconnected 123 to 113; no new fails on gates 17/20/45/49/51/56/68/132-138; overlaps back to the one E0122 row.
3V3 feed to U6.20 through C165, stage 4c | D0322, ledger 0391, commit ef0387f | Gate 47 (A0236 re-open): the stage 4b 3V3 stub at C165 was 0.20 mm against 0.30 mm required for 0.41 A. Re-laid cap-first (trunk -> via -> C165.1 -> U6.20): 0.3 mm stub north of C165.1 to via (83.06,102.665), 0.205 mm from K101.8; B.Cu straight up x 83.06 into the trunk via, which moved from (82.75,90.0) to (83.06,90.0) with its B.Cu run to the J3 3V3 via (83.571,79.73) (top now a 0.42 mm chamfer and a 0.21 mm straight into that via) and its F.Cu run to C2.1 shortened 0.31 mm. To clear that run, J3.5's GND via moved from (83.4,82.27) to (82.3,82.27) (subject /GND not in D0322; recorded here). Moving C165 0.31 mm west instead overlapped U6's courtyard. DRC 0 errors; unconnected 113; gate 47 row cleared; no new fails on the listed gates.
I2S branch to the moved DAC, stage 5 | sch fb83ef3; D0323 amended to D0324, ledger 0394, commit c40a5ed | New 33R 0402 series resistors R156 (LRCLK) and R157 (DATA) per the schematic (R29 stays on BCLK). U1 corner re-fanned (lead-approved A2): LRCLK pin 3 runs all F.Cu into R156 (90.5,98.6); R156.2 via (90.5,99.9) feeds the U8 trunk on B.Cu (old direct via (90.5,93.9) and stub removed, no orphan) and U6.15 on F.Cu. BCLK branches at its straight-through via (91.5,98.2) on F.Cu into U6.13. DATA leaves pin 5 by the owner's escape via (92.25,93.6), B.Cu west to R157 (86.0,93.6) on F.Cu, then B.Cu down x 83.68 and up at (83.68,107.275) into U6.14; the three lanes enter U6 at 0.65 mm pitch (3W). GND via (90.6,97.3) moved; GND returns added at 0.85 mm (DATA vias), 1.4 mm (LRCLK via) and (92.25,97.8) for the BCLK via after gate 17/20 flagged it at 2.94 mm. Exceptions accepted by the lead: LRCLK via return 1.4 mm (lead rule 1 mm, gate 20 2 mm met); DATA escape via entry 0.55 mm (owner's pre-existing pattern, R29 0.085 mm away at 0.7 mm); DATA escape via return is C4's GND via at 1.69 mm (no legal spot within 1 mm). C15/Y1 untouched. Parity 0; DRC 0 errors; unconnected 113 to 110; no new fails on gates 17/20/35/45/47/49/51/56/68/132-138. Silk warnings 140 to 174 for the silk pass.
Output chain leftovers, stage 6 | D0325, ledger 0396, commit 50b2875 | U106 pin 6-7 tie (1.26 mm straight), MUTE_COIL K102.8-D109.2 and Q101.3-D109.2 (down x 70.0, west of D109's 5V pad), SW_BYPASS K101.1-D104.1 along y 95.87; CAPP/CAPM were tied in stage 2. DRC 0 errors, 174 warnings (silk); unconnected 110 to 106; no new fails on the listed gates. Open long runs, no path even with vias at 25 mm margin; each needs a channel through the I2S/ADC B.Cu bundle east of the U1 corner or the pocket's 3V3/3V3A/DATA columns: XSMT (U6.17 to U1.39), FX_ON_SENSE (K101.5 to C162), SW_BYPASS (D104.1 to the SWBYPASS1 toggle), PRE_OUT (K101.2 to R119).
Owner audit repair. D0326 was amended to record the owner state and accepted as D0327 (ledger 0399, f9a1494). D0328 was amended to D0329 and accepted (ledger 0402, 9675a4f) with fix1. USB pair re-laid with diagonals of 6 mm or less and no jogs; mismatch 0.375 mm. VBUS_SENSE moved to y 71.35, clear of 3W to DM. The 3V3 feed now runs on B.Cu to a via at (99.35,73.2). C6 sits in pin 50's east slot, 2.85 mm from the pin, with its own GND via. Its run is trunk to C32, pin 50, C61, C6; trunk-first would push C32 from 3.85 to about 18 mm. C12 moved east. Mic and output stages: R102, R108, C128, R106, R110, C129, R109 and C132 moved, so every pad entry is straight and centred. The A1_FB loop and the A2_FB, PRE1 and I2C jogs are gone. I2C now has 3W spacing. GND micro segments and 45-degree via entries are fixed. Body gaps C6/C61 (0.02 mm) and C12/C6 (0.05 mm) are forced by the slot. DRC: 0 errors, 174 warnings, 73 unconnected.
D0330 was amended to D0331 and accepted (ledger 0405, e085601). C12 moved 0.25 mm east to (109.0,79.0), clearing the C12/C6 body gap. VCAP1 now runs straight to C12.1, and the GND via moved to (110.55,79.0). The C6/C61 gap of 0.02 mm is accepted as E0123, because widening it would break the 3 mm gate-63 budget. DRC: 0 errors, 174 warnings, 73 unconnected.
CC2 via-free reroute + via audit | D0332 ledger 0411 | Owner re-laid CC2 on F.Cu around J1's shell pad (no vias; a via only where a layer change is needed). Whole-board via audit added as tools/via_audit.py (classifies each via as layer change, pad GND via, signal return, or orphan; follows stubs by overlap, not endpoint equality). Removed 2 orphan GND vias left behind by earlier moves (136.2,103.15 ex-LRCLK return; 136.4,100.1). Two misreads during the pass were reverted: R5.2/D2.2 GND vias (pad via with a short stub is normal) and C55.2's via whose stub ended 0.3 mm short (stub extended to the via centre). Added missing GND vias for K102.7 (76.4,66.99) and U107.1 (159.5,50.55). Open: a /5V B.Cu via at (105.55,47.65) at the end of a 9 mm stub from the owner's 5V reroute heading north, left for the owner. DRC 0 errors, unconnected 71.
5V feed finished | D0333 ledger 0413, D0334 ledger 0414 | The /5V trunk ended in a 9 mm B.Cu stub and a via at (105.55,47.65) reaching nothing. L101.2, C114.1, C115.1 and C19.1 now carry a 0.5 mm F.Cu bus at y 44.41; C19.1 runs straight down to a via at the trunk corner (106.53,56.8), which replaces the old via and the corner at x 105.55. D0334 moved the L101.2 entry to the pad centre after gate 132 flagged it 1.59 mm off. via_allow.txt is empty. Vias 218, orphan 0, DRC 0 errors, unconnected 71.
Mic and output chain routed under D0335, amended to D0336 and accepted (ledger 0416, aa218d9). IN_P is a straight R103.1 to R102.2 link. OUT_TIP runs J108.6 to K102.6 to K102.4 on F.Cu with no vias. For ADC_RC, C136 stands upright over R119.2 and C137 moves 0.75 mm west, so C136, R119.2 and C137 sit on one straight run 0.75 mm from the BCLK via; ADC_VINL is re-laid to C137.2. INA_O1's lane drops from y 92.8 to 94.0, and INA_O2 hops under it on B.Cu between (200.6,85.0) and (213.2,92.8). PRE_OUT leaves RVGAIN1.1 on B.Cu along y 95.5 and 98.6, hops to F.Cu at (152,98.6), runs along y 94.0 into R119.1, then crosses the I2S/ADC bundle on B.Cu along y 104.05 (x 87.05 to 116.25), hopping at x 87.05 to reach K101.2. Every signal via has a GND return within 2 mm. DRC: 0 errors, 174 warnings, 63 unconnected (was 71); 226 vias, 0 orphans.
VBUS via removed at J1 | D0337 ledger 0418 | VBUS is a sense net (C18, D2, R6/R7 divider to U1.68), so the owner's point stood: the via at (119.21,37.25) and its B.Cu link from the D2.5 via lifted VBUS under the signal pads for no reason (canon 137). Replaced by a 0.2 mm F.Cu loop that leaves the C18.1 via straight through, passes between R5's pads, climbs at x 108.9 outside CC2's loop, crosses above J1 at y 33.3 and drops at x 121.2 into R6.1 from the right. B4A9 to C18.1 and A4B9 to R6.1 are unchanged; the C18.1 and D2.5 vias stay because D2.5 is enclosed by DP/DM. Vias 225, orphan 0, DRC 0 errors, unconnected 63.
Bundle-crossing group routed under D0338, amended to D0339 and accepted (ledger 0420, ba429f0). MUTE_BASE runs straight down x 72.5. XSMT runs from U1.39 around the VA_SENSE via and down an F.Cu column at x 112. R16 moved there from (148,98.5), and its old GND via was removed. XSMT then runs on B.Cu along y 106.88 under the I2S lines, hops up at (87.05,105.9), and reaches U6.17 under C33. FX_ON_SENSE drops to B.Cu at (97.0,74.19), runs under U1 between the J3 holes and the I2S vias, and hops up at (84.9,98.6) under K101. SW_BYPASS runs on B.Cu around the 5V L, hops up at (80.75,82.6), and its 0.2 mm F.Cu leg reaches K101.1. Every signal via has a GND return within 2 mm. Unconnected 63 -> 57; 233 vias, 0 orphans.
NRST and BOOT0 routed under D0340 (ledger 0422). NRST leaves U1.14 north through an under-body via at (96.5,90.35), runs on B.Cu at y 86.25, bridges over the 3V3 B.Cu line on F.Cu, and splits at via (81.12,86.25). F.Cu from there climbs west of J3 into J3.3; B.Cu runs west into C14.1 through via (60.175,84.6). BOOT0 runs on F.Cu at y 87.0, drops at (81.7,87.0), and runs on B.Cu 0.75 mm south of NRST into R2.1 through via (60.175,94.9). FX_ON_SENSE B.Cu moved south (x 97.7, y 91.0) to open the area under U1. GND via (81.2,86.15) moved to (82.4,84.85). Every signal via has a GND return within 2 mm. Unconnected 57 -> 54; 244 vias, 0 orphans.
Mux group routed under D0341, amended to D0342 for the airline and silk counters, accepted (ledger 0425, 3e57da9). MUX_S0..S3 leave U1's east pins, fan to 0.65 mm pitch, drop to B.Cu at (110.8..113.2, 86.5..88.45) and run east at y 89.5..91.55, dipping south of the OLED hole at (120.6,86.75). They hop to F.Cu at y 94.65/95.6 south of PRE_OUT; S2/S3 enter U101's west pins, S0/S1 go over U101's top into its east pins. U1.15 escapes through an under-body via at (98.9,89.3); NRST's escape via moved to (96.0,89.35). R30 moved (105.0,101.8)->(114.33,94.4), C55 (106.9,101.75)->(113.5,97.0), R126 (151.0,133.5)->(150.81,133.5), C142 (150.0,136.5)->(150.06,136.5). POT_MUX_OUT runs B.Cu at y 93.2, down x 133.6, F.Cu down x 146.6 and B.Cu under U101 into R126.2. DRC 0 non-silk, 46 unconnected, 264 vias, 0 orphans.
Encoder group routed under D0343, amended to D0344 for the airline drop, accepted (ledger 0428, 19a9615). The 3V3 B.Cu trunk north of U1.100 is removed; U1.100's group (C56 10nF, C2 100nF beside the pin, C4/C7 at U1.6/U1.11, the DAC feed via moved to 83.06,90.65) is fed by a 0.3 mm F.Cu link under U1 from U1.75 to U1.11 (19.05 mm). KEY_A/KEY_B/SEMI_A/SEMI_B and BOOT0 escape through under-body vias and run west on B.Cu under the pins; NRST rerouted on B.Cu to its hub via (81.12,86.25). GND pad vias of U1.74, U1.10, U1.99 moved. MENU nets inward under U1, B.Cu east along y 65.4-66.7, into the encoder ring north of the 5VA via. C149 moved (81.5,127.0) rot 180 -> (86.7,129.6) rot 0. DRC 0 non-silk, 34 unconnected, 276 vias, 0 orphans.
Codex round 4 routing audit | audit/2026-10-06-round4-routing-questions.md | Six questions on this session's routing calls, all PASS: the 3V3 under-body link feeding U1 pin 100's group (check drop; 30 mOhm), NRST's three vias (keep C14 close), the pot-mux ADC input RC at the pin (allow settling), the 0.2 mm VBUS sense loop around J1 (ESD stays at the connector), the S0-S3 B.Cu bundle (solid ground reference; low GPIO slew in firmware), and R16 on the XSMT run. Two firmware notes carried forward: ADC sample time for the 100 ns RC, and low speed on the mux select pins.
Silk pass under D0345 (ledger 0430, 02d6f31), no copper change. Kept refs (U, RV, SW, J) at 1.0 mm / 0.15 mm, 0 deg; J1, SW101, SW102, U1, U101, U104, U105, U106, U6 moved clear of pads and courtyards; C165/C166 refs to F.Fab; ENC refs stay on Fab (gate 111). Root cause of most warnings: visible LCSC fields on F.Silkscreen on C167, C168, C169, FB102, R154-R157, U108, now hidden on Fab. Silk segments that crossed pads moved to Fab on the 4 mm electrolytics (polarity chamfers kept), C161, R147, U106; library footprints SW-TH_EC11E, USB-C-SMD_TYPE-C16PIN, CONN-TH_NCJ6FA-H, DC-IN-TH_PJ-002A fixed in hardware/ (silk over EH pads, silk past the edge) so the board matches its libraries. DRC 175 silk + 0 lib mismatch -> 0 + 0; 34 unconnected (POT/TOGGLE, owner).
Zone fills refreshed | D0346 ledger 0432 | The saved zone fills had gone stale, so DRC without a refill showed 248 clearance errors that a refill removed. Zones refilled in place and saved; DRC without refill now 0 violations, 34 unconnected. Closure 0 intended, 0 unintended.
Stray route audit and via removal | audit/2026-10-06-stray-route-audit.md, D0348 ledger 0435, 76e4499 | tools/route_audit.py scanned 1312 segments and 276 vias: no floating, dangling or duplicate copper; 0 orphan vias; 30 B.Cu hops, one (3V3 under U8) with a clear F.Cu path. Owner re-laid I2S_DATA_SRC F.Cu-only (2 vias gone) and POT_MUX_OUT to one via pair (2 gone). This change dropped the 3V3 via pair at x 124.60 (canon 137; the branch now Ts onto the y 107.55 trunk, 2 right angles declared) and the 4 GND return vias the owner's removals orphaned (canon 140). 276 -> 266 vias, DRC 0, 34 unconnected. Open: U101 pins 15/16/17 and Q101.2/R125.2 each keep their own GND via per canon 138; the USB_DM A7 branch Ts onto the B7 run at (115.75,37.25) without a via.
POT_MUX_OUT return vias | D0349 ledger 0436, beaece2 | Two GND vias at (133.90,96.00) and (114.35,93.20), one within 0.8 mm of each POT_MUX_OUT via, close the canon 20 gap the owner's re-route left. 266 -> 268 vias, 0 orphans, DRC 0, 34 unconnected. Rules 138 and 20 kept as written; U101 and Q101/R125 ground vias stay.
OLED socket J117 to SMD | D0352 ledger 0441, 679309e | JLC's hand-inserted THT headers came out crooked on the owner's previous board, so J117's four 1.0 mm PTH pads become the hanxia HX PM2.54-1x4P TP-YQ 5 mm SMD socket (C42379197, 17k stock): 1.27x2.20 pads staggered +/-1.80 about the y 57.75 row, JLC-assembled, reflow self-centring. Pad 1 GND gets a stub to its own via (canon 138); the 3V3, SCL and SDA traces re-end at the new pad centres; the module courtyard grows to -17.9 to cover the pads, which puts it 0.1 mm from R142/R143 (declared; copper gap 0.65, socket body 2 mm clear). No 1x4 SMD female with locating pegs exists at JLC (only Liansheng 2x15/2x20 stacks); Amphenol 91614-304 has pegs but is not stocked and is 6.99 mm tall. Stack: 9 mm standoffs minus 2.5 mm male plastic leaves 6.5 mm of pin in a 5 mm socket; the module's pins must not reach more than 8.5 mm below its PCB. Library, schematic LCSC fields, spec item 22 and PARTS.md updated. 269 vias, DRC 0, 34 unconnected.
Owner move set | D0355 ledger 0446, 35f9312 | R142/R143 north 2 mm onto J117's pad columns (x 137.055/139.595); U4, C25, C24, U107, C166 north 3 mm; FB101, C117 east 1.5 mm; U108 and C167 east 1.25 mm; C163 left in place (1 mm west collides with the MUX_S0 via and feed; it already sits 2.6 mm from the nearest OLED standoff edge). 3V3 trunk re-laid at y 45.6 from C166.1, east to R128 and west to a drop into R143.1; the three-way T at (160.32,45.6) is deliberate (DC rail, a via there would change no layer). SCL now crosses SDA through R143's pad gap at y 50.0 (0.245 mm to each pad): the crossing is forced by U1's pin order against J117's, and B.Cu is blocked by VIN_9V at x 138. SDA is one straight segment. VREF_BUF re-laid with 45° bends, right angles 26 -> 23. U107's GND via moved north to (158.70,46.70). Dry-run on a scratch copy first (DRC 0, pad-entry 19 -> 15). Misfire on the way, mine: the shell chain had pipefail on and tools/pad_entry_check.py exits 2 when it lists violations, so the declare never ran; a closure was then run against reopen id O0208 and acceptance id A0262, which the foreman accepted and which left ledgers 0442/0443 (foreman now refuses non-declaration ids); D0353 was declared on that wrong baseline and is retired, superseded by D0355 on baseline 0444. DRC 0, 34 unconnected, 269 vias, 0 orphans.
Codex round 5 pre-fab audit | audit/2026-10-06-round5-prefab-brief.md, audit/2026-10-06-round5-prefab-response.md | gpt-6-astra, codex exec read-only, high effort, board 135a888. Verdict HOLD, 3 FAIL: (1) J117 CPL row uses the OLED module centre (y 72.5) not the socket pad row (y 57.75), 14.75 mm off, because the footprint origin stays at the module centre; (2) POT01-14 / TOGGLE1-8 still unrouted (34 items, waiting on the column count); (3) BOM/CPL are raw KiCad exports, not JLC-mapped, and J101/J106/J108 appear in the BOM but not the CPL. WARN: mux selects must stay low until 3V3A is up (firmware); C18 board value is the footprint name, not 1 uF; L101 attr through_hole on SMD pads; no fiducials; H101-H104 keepouts not on the board; VA_SENSE stitches 2.6/4.4 mm from its vias; USB pair has no stackup/impedance data in the board; PINMAP.md USER_LED says PB4/U1.90 but the board uses PE11/U1.41. Verified by this session: J117 at (135.785,72.5) with pads at y 57.75, L101 attr through_hole, C18 value "C_0603_1608Metric". Schematic/netlist/board parity PASS (761 pins, 232 refs); In1/In2 single GND polygons; VIN_9V B.Cu run about 0.19 ohm, PASS.
Codex round 5 fixes | D0356 ledger 0447 5ad070d, D0357 ledger 0448 b584962, D0358 ledger 0450 8328c2c | J117 anchor moved to the socket pad centroid (135.785,57.75); pads, courtyard and NPTH holes stay put, the 3D model offset is (0,-14.75,0), and the library footprint carries the same origin, so the CPL now places the socket, not the module centre. C18 value 1uF and LCSC C90540 from the schematic. L101 attr smd (board and library). Four "m3seat" rule areas, radius 3.5 mm on F.Cu and B.Cu at H101-H104, no copper, tracks or vias. Fiducials FID1 (56.45,41.95), FID2 (240.55,41.95), FID3 (56.45,153.05), 1 mm dot / 2 mm mask, board-only, with a 1.5 mm pour keepout each. JLC JLC04161H-7628 stackup written into the board: 0.035 outer copper, 0.2104 mm 7628 prepreg (Dk 4.4), 0.0152 inner copper, 1.065 core, HASL lead-free; the 0.2/0.2 mm USB pair over that prepreg reads about 105 ohm differential by the IPC-2141 microstrip estimate, which is acceptable for USB full speed over 59 mm and is recorded rather than re-routed. Stitch plan from `foreman stitch --max-reach 2.0`: 29 GND vias so every signal via has a return inside canon 20's 2 mm, VA_SENSE's two at (115.44,85.72) and (156.06,82.39) among them; 269 -> 298 vias, via_audit orphan 0. Field sync from the schematic: 31 footprints had lost their library nickname (R0603 for cubevox:R0603 and so on) and 13 carried an LCSC number that differed from the symbol (R102/R105 C31850, R110/R108 C25971, R116 C23138, R6 C4216, R7 C23254, R152/R151 C25804, R150 C21190, C162/C163 C14663, C18 C90540); 167 stale "LCSC Part" duplicates removed, all part fields hidden on F.Fab. Production gates (trial run, ledger refusal bypassed for the 34 pending nets): 1-5, 7, 8, 10-12 pass, 6 not measured (no exposed pad), 9 fails on catalogue quirks only (D2/U108 SOT-23 span at the 2.30 mm boundary, J101 card lists 3 pins for an 8-contact jack). PINMAP.md: USER_LED is PE11/U1.41, PB4/U1.90 spare; firmware notes 6-8 added (mux selects low until 3V3A is up, lowest GPIO speed on them, 2 us ADC sample time on MUX1_SIG_ADC). Owner decision pending: J101/J106/J108 THT jacks are in the BOM and CPL for JLC insertion; drop them from both if hand-soldering.
Jacks hand-soldered | D0359 ledger 0451, f69a8e7 | Owner rule (2026-10-06): a part on the bottom side is owner-soldered; JLC solders the rest. J101 (Neutrik NCJ6FA-H combo), J106 (DC 9V) and J108 (6.35 mm out) sit on B.Cu, so all three are excluded from the BOM and the CPL. Owner has J106 and J108 on hand; J101 must be ordered separately (LCSC C368458 on the footprint; the part card lists 3 pins for its 8 contacts, see gate 9).
Round 6 own audit | audit/2026-10-06-round6-self-audit.md | No FAIL. Schematic WARN: BUF_IN bias/click, D107/D108 clamp placement, pot vs VREF+ ratiometry, J117 pin order vs the purchased module. Board WARN: BCLK under Y1 on B.Cu, HSE/LRCLK over budget by placement, 23 right angles, edge stitching, diode silk marks, 9 lib mismatches.
Slots revision | sch 50164e8, D0360 ledger 0453, 771822f | Owner 2026-10-07. Schematic edited in place (cubevox.json/h7core_block.json are stale since sch fb83ef3 and were not regenerated): ENC102/ENC103 and their RC (R130-R133, C146-C149) become RV115/RV116 on U101 I14/I15 (POT15/POT16); K101, D104 and the PRE_OUT dry path out, DAC_ATT joined to BUF_IN; SWBYPASS1 common on MUTE_SW (ex FX_ON_SENSE), one throw GND; ENC_KEY/ENC_SEMI ports and sheet pins out, PB7/PB8/PB9/PE0 no-connect; R113/R114 are the difference-amp resistors and stay. ERC 0. Board: 12 footprints out, RV115 (64.5,164) and RV116 (88.5,164) rot 0 added, 132 segments and 25 vias out (5 return vias orphaned by the removals included), netlist parity 0, zones refilled. DRC 0 non-lib violations (9 lib mismatches, as before), 40 unconnected (34 + POT15, POT16, 3V3A x2, MUTE_SW, BUF_IN), via_audit 0 orphans. Locks E0023/E0024/E0075 retired, E0129/E0130 added. No new trace or via laid. Render renders/cubevox-slots-rev-top.png.
Slots routing | D0361 ledger 0454 (69f9665), D0362 ledger 0455, D0363 ledger 0456 (1bbcbc4) | Owner go 2026-10-07. Six airlines from the slots revision routed: POT15 (RV115.2 to U101.17) and POT16 (RV116.2 to U101.16) leave the pads west on F.Cu, hop to B.Cu under the POT_MUX_OUT trace at x=141 (via pair each), return to F.Cu and run 45 degree diagonals to the pots (POT16 enters RV116 from north, POT15 passes south of RV116 and enters RV115 from south), 4 vias; 3V3A to RV115.3 and RV116.3 straight on B.Cu from RV103.3 and RV104.3 (x=67, x=91), 0.3 mm; MUTE_SW from SWBYPASS1.2 on B.Cu around the west end of the 5V B.Cu bar, one via at (97.3,74.19), F.Cu west into C162.1 (R120.2 sits in the same island through the existing stub; its own pocket is closed by the 3V3 B.Cu bar at y=73.2); BUF_IN R123.1 to U106.5 on F.Cu. No POT14 route exists on the board (POT01-14 are the owner's open items), so widths follow the signal class, 0.2 mm. Cleanups: 3V3 hop at x=83.06 now a single F.Cu run (2 vias and the B.Cu bar out), R133 dog-leg at (82.6..85.0,125.6) straightened, and the GND return via at (83.77,91.36) that served the hop removed (D0362 accepted with commit none, git add raced a concurrent commit; its board change is in 1bbcbc4). DRC 0 non-lib violations (9 lib mismatches, as before), 34 unconnected (POT01-14, TOGGLE1-8 and the GND plane islands), via_audit 0 orphans, netlist parity 0, zones refilled by the edit. Render renders/cubevox-slots-routed-top.png.
Zone fills after slots routing | no declaration (fill and library id only, no copper added or removed) | kicad-cli DRC on the committed board after 1bbcbc4 showed 20 clearance and hole-clearance errors: the five new vias (MUTE_SW at (97.3,74.19), POT15 and POT16 pairs at x 139.4 and 141.8) against the In1/In2 GND fills, which were saved before the vias existed; the routing DRC had refilled only a scratch copy. Zones refilled in place with pcbnew ZONE_FILLER and saved. RV115 and RV116 footprint ids gained the cubevox: library prefix so schematic parity stops flagging them. kicad-cli DRC without refill: 0 violations beyond the 9 lib mismatches, 34 unconnected; parity leaves J101/J106/J108 BOM-flag and field warnings only. exports/cubevox-netlist.net regenerated (it still listed K101). Astra audit docs/audits/2026-10-07-astra-hardware-audit.md.
Return-via trim | no declaration (GND vias with no outer copper removed, no route changed) | Owner 2026-10-07 ("unnecessary vias are unacceptable"). Strict audit (/tmp/via_audit_strict.py logic: outer-layer track end or same-net pad at the via, else candidate) found 55 GND vias touching no F.Cu/B.Cu copper. All 55 had been placed as canon 20 return vias within 2 mm of a signal via, but canon 17 scopes that rule to critical nets and the brief lists none of 5V, 5VA, 3V3, 3V3A, VREF, VIN_9V, VBUS, BOOT0, NRST, SWDIO, MUTE_N, MUTE_SW, MUX_S0/S2, POT_MUX_OUT, XSMT, VA_SENSE, ENC_MENU_B/SW or INA_O2 as critical. Kept 9 beside I2S_BCLK, I2S_LRCLK, I2S_DATA, ADC_SCKI, ADC_DOUT and PRE_OUT layer changes, and 4 as the only plane stitch within 8 mm: (140.95,94.65), (230.39,53.30), (213.20,91.40), (107.33,56.80). Removed 42 (list in commit). Vias 275 -> 233. Zones refilled (fill unchanged: the vias sat in solid same-net copper). kicad-cli DRC: 0 violations beyond the 9 lib mismatches, 34 unconnected; strict audit 0 orphans. tools/via_audit.py counts any GND via within 2 mm of a signal via as a return regardless of net class, which is how these accumulated; future return vias only beside critical-net vias. Render renders/cubevox-via-trim-top.png.
Outline trim 200x150 to 185x145 | D0366 ledger 0458 (d979edc), D0367 ledger 0459 | Owner 2026-10-07. Edge.Cuts x 56..241, y 30..175 (3 mm corners); In1/In2 GND zones 56.5..240.5 x 30.5..174.5. H101 (59.6,35), H102 (237.4,35), H103 (76.5,170), H104 (220.5,170) with their m3seat areas; the front pair sits on the front edge between pots 1-2 and 7-8, and the rear pair is 1.4 mm west/east of the owner's 61/236 so the hole courtyard stays out of the J108 hand-solder reservation E0058. FID1 (61,42), FID2 (236,42), FID3 (61,128.5) with windows. J106 x 228.5; C159 (237,83.6) (y +1.6 to clear R116's courtyard); SWRESET1 (61,88), SWBOOT1 (61,96.2) (clears C139 and R122 courtyards); C14 (65.82,86.925) rot 270 and R2 (65.82,93.525) rot 90 east of the buttons; RV115/RV116 y 168. Locks E0032-E0036, E0129, E0130 re-added at the new poses by the owner-move declaration. Routing: NRST, BOOT0, 3V3 and GND to the buttons and C14/R2, 9V_JACK to J106, G2_RG and GND to C159, POT15 (south of the pots at y 174.3) and POT16, 3V3A to RV115/RV116; R155 GND via moved to (65.69,91.1) because the old via landed on SWRESET1 pad 4. Vias 233 -> 227 -> 233, no return vias added. DRC on the saved file: 0 violations beyond the 9 lib mismatches, 34 unconnected, parity 3 BOM flags plus field warnings; via_audit_strict 0 true orphans. brief.json and brief.confirmed.json hole poses, J106 and board size updated. Render renders/cubevox-trim-top.png.
Trim follow-up: H101/H102 at 61/236, J108 east | D0369 ledger 0461 (931d7cf), D0372 ledger 0464 (1222c42) | Owner 2026-10-07. H101 (61,35) and H102 (236,35) restored to 5 mm from the rear and side edges. J108 moved 74.0 (was 72.5) so its hand-solder reservation clears H101's seat; OUT_TIP re-landed straight from pad 6 to the existing run at x 79.6, no vias. E0058 re-added at x 64.7..83.3 (E0142). E0048 re-added at J106's pose (E0138) with its east side clipped at x 232.45: the 185 mm outline leaves H102's seat 0.35 mm from J106's pad row, so a full 3 mm east clearance cannot hold. POT15's south run at y 173.8: y 173.3 touched the H103 seat (items_not_allowed), 173.8 clears it and the pot pads by 1.4 mm. DRC on the saved file: 0 violations beyond the 9 lib mismatches, 34 unconnected, parity 3 BOM flags plus field warnings; strict via audit 0 true orphans, 233 vias.
J106 west to x 225 | D0374 ledger 0467 | Owner 2026-10-07 via lead. The tray boss under H102 would overlap J106's ground lug at x 228.5; at 225.0 it clears. 9V_JACK re-landed on the new pads, no vias. E0048 re-added unclipped as E0144 (x 218.85..232.15, the H102 seat starts at 232.5), E0138 retired; lock E0131 re-added by the owner-move declaration. DRC on the saved file: 0 violations beyond the 9 lib mismatches, 34 unconnected, parity 3 BOM flags plus field warnings; strict via audit 0 true orphans, 233 vias.
m3seats 9 mm, J108 east, POT15 west margin | D0376 ledger 0470 | Owner 2026-10-07 via lead: heat-set bosses make each seat 9 mm. All eight m3seat rule areas now 9 mm across, same centres. J108 to x 76.0 (E0142 retired, E0146 at x 66.7..85.3); OUT_TIP re-landed from pad 6 down x 81.6 and diagonal into the x 79.6 run, no vias. POT15 reroutes: diagonal from the hop to (118.3,147.5), a layer hop under POT16's diagonal (vias at 117.8 and 115.7, y 147.5, B.Cu piece between), west along y 147.5 to x 58.3, down the west margin at x 57.2, east along y 173.8 and up into RV115 pad 2 from the south (pad 1 GND sits on the pad row, so a west entry is not possible). Two vias added, 233 -> 235; they are the only layer change on this net. Seat check: no track, via or pad edge within 5.0 mm of H101-H104. DRC on the saved file: 0 violations beyond the 9 lib mismatches, 34 unconnected, parity 3 BOM flags plus field warnings; strict via audit 0 true orphans.
Hygiene: joins, micro-segments, pad entry | D0377 ledger 0472, layout/actions/hygiene-joins-pad-entry.json | Lead 2026-10-08. Four micro-segments out (3V3A (77.67,107.92) and (77.13,107.93), TOGGLE2 (86.05,122.65), 9V_JACK (234.30,46.75)). The 29 mid-track joins now end on a track end, a via or a pad centre, host segments split where a branch lands (USB_DM at (115.75,37.25), the 3V3 R128 branch at (169.942,59.3)); route_audit section 1 29 -> 0. Pad entry 17 -> 0: every diagonal that ended inside a pad became a straight stub and a 45 degree bend after the pad (FB1.1, R128.1, C4.1, C57.1, R135.1, C16.1, U105.2, R5.1, J1.2, 9V_JACK at D106.2). TOGGLE1 and TOGGLE2 clusters rebuilt the same way; the C.1 and R.2 pads sit 0.05 mm apart in y, so no straight entry joins them and a loop above the pads carries the link. Off-angle segments over 0.05 degrees 1 -> 0. Two GND vias moved clear of the rebuilt copper (U6.9 to (77.9,108.58), C119.2 to (216.05,64.2)); the 5VA B.Cu bar now runs at the via's own y 65.55. The 9V_JACK vertical is 0.3 mm because 0.4 mm at x 234.35 would cross the FID2 window edge. The plan moved two vias and removed none (ledger 0472 reads 234 against 235 at ledger 0471; the owner's KiCad cleanup came between), strict audit 0 true orphans, DRC 0 violations beyond the 9 lib mismatches, 34 unconnected (POT01-14, TOGGLE1-8). 3V3A and 3V3 each read as one connected component with 0 dangling ends; RV101-RV116 pin 3 sit on 3V3A and R134-R141 pin 1 on 3V3.
Panel bus | D0378 ledger 0474, layout/actions/panel-bus.json | Lead 2026-10-08. POT01-16 routed from the U101 mux to the pot wipers as a 16-lane 0.2 mm band at pitch 0.7 (y 147.5 to 158), straight via stubs, no GND return vias; POT15/16 diagonals replaced; 3V3A re-fed and C142 GND via moved to clear the band. TOGGLE3-8 switch clusters (SW pad to pull-up) added. Vias 234 to 249. Unconnected 34 to 8: the 8 TOGGLE trunks (switch to U1 pins) are NOT routed. A grid search finds only 30+ via zigzag paths through the x 110-111 corridor and the U1 interior, which fail the via and jog rules. Needs a pin swap or a freed channel.
TOGGLE bus | D0381 ledger 0479, layout/actions/toggle-bus.json (apply format: rm_seg/rm_via/move/track/via, second R3/D1 pass appended) | Lead 2026-10-08, layout/TOGGLE_BUS_BRIEF.md as built. U1 pins 28-42/92/93/98 reassigned in the schematic (commit 965d4b9); pad nets synced. XSMT and TOGGLE1-8 leave U1's east rows on F.Cu lanes x 110.1-113.3, two via combs at x 109.3 and 113.9, six B.Cu trunk rows y 103.1-106.1 stepping to 107.9-110.3, drops into each switch pad 2 on B.Cu; TOGGLE1/2 run west on B.Cu at y 110.0/110.6. MUX_S0-3 on rows 38-40/42 to B.Cu lanes x 114.1-115.9. VA_SENSE inward via (102.1,85.5) and B.Cu over the 3V3 island. 3V3 bar hop (109.3-114.3, y 107.55), 3V3A moved to x 144.5 with an F.Cu hop over the rows, 5VA corner snapped. Parts moved: R30, C55, C58, C3, R16, R3, D1, C163, C138. Brief corrections approved by the lead: step diagonals start 0.6 further east, TOGGLE2 jog at y 109.0, C138 at (121.2,108.0) rot -90; C163 and R3/D1 re-placed for J117's courtyard and the 0.30 body gap. DRC on the saved file: 0 violations beyond the 9 lib mismatches, 0 unconnected, parity 3 BOM flags plus 67 field warnings. Strict via audit 0 true orphans, vias 249 -> 264. pad_entry_check 0, route_audit stray traces 0, 0 micro-segments, 0 off-angle, 0 diagonals over 20 mm. right_angles 21 -> 42 are the brief's L-bends and switch-pad drops. New tight body pair C138/U8 0.02.
TOGGLE bus corners, 3V3 bar, 3V3A hop | D0383 ledger 0483 then D0385 ledger 0486 (baseline 0481, the owner's saved file), layout/actions/toggle-corners.json | Lead 2026-10-08 correction: canon 44 (no 90 degree corners), 136 (no jogs, no 45 run over 6 mm); the right_angles row declared in D0381 was a gate failure. Kept the owner's edits since 255a3d5: C138 at y 108.1 with its GND via at (121.2,111.3), the hand-chamfered TOGGLE2 drop into SW102, the SW101 pull-up stub leaving pad 2 south. 3V3 bar 0.1 down to y 107.65 as one run (hop vias 109.3/114.3, east diagonal to (139.13,109.15)); C138 pad 1 clears it by 0.248. 3V3A: (147.3,103.6) diagonal to (144.5,106.4), straight into the hop via (144.5,107.0); (144.5,130.28) diagonal to (143.7,131.08), straight into the via (142.625,131.08); the 106.28 dogleg is gone. TOGGLE4-8 step diagonals split 2.4/3.2/2.4 so no 45 run exceeds 6 mm. hardware/tools/corner_check.py: 57 corner points before, 15 after. 29 chamfered by hardware/tools/chamfer_corners.py (legs 0.4-1.0; switch drops 0.4 to keep straight pad entry); VREF re-laid as one 45 offset into C160.1; 3V3 at (83.06,90.65) one diagonal to (84.41,90.0); BIAS_W into R123.2 from the north; U106 pins 1-2 joined straight; C135 0.34 down so VREF_DIV runs straight R118.1 to C135.1. Left as found, each needs a part or branch moved: off-pad T junctions 3V3 at R128 (169.942,59.3), 3V3 bar/U8 feed (124.6,107.65), USB_DM (115.75,37.25), 5VA (155.0,96.375) (any off-pad branch on a 45 degree grid has a 90 or a 45 degree angle; canon 44 or 45); pad-offset loops J1 GND (E0120), CAPP and CAPM at U6/C34 (C111 and C35 block a centred straight), DAC_OUTL U6.6 to R147 (C35 blocks), 5V C115.1 to C19.1 (needs C115 re-placed). Foreman right_angles 40 -> 6, gate 132 27 -> 24, gate 136 25 -> 23. DRC on the saved file: 0 violations beyond the 9 lib mismatches, 0 unconnected, parity 3 BOM flags plus 67 field warnings. Strict via audit 0 true orphans, vias 264. pad_entry_check 0, route_audit stray traces 0, 0 micro-segments, 0 off-angle.
Pre-existing corners | D0387 ledger 0489, layout/actions/corner-preexisting.json (apply format) | Lead 2026-10-08, third item: branches leave from a pad or via, loops re-placed. R128 turned vertical (169.942,60.4 rot -90): 3V3 trunk enters pad 1 from the north and the R127 branch leaves pad 1 east, ENC_MENU_B joins at C144.1; the off-pad T at (169.942,59.3) is gone. 5VA: the x 155 feed ends in via (162,95.753) from the west, so the west bar and east arm run as one path and the T at (155.0,96.375) is a 135 degree bend; C160's GND via moved to (161.0,97.0) to clear it. 5V: C114 rot 90 in place and C115 1.59 down put L101.2, C114.1, C115.1 and C19.1 on one straight at y 46.0; GND vias moved with them. DAC_OUTL: one 45 offset from U6.6 to y 106.95 below C35, no part moved. CAPP: C111 moved north to (72.2,102.6) with its 3V3A line taking one 45, C34 0.005 up, CAPP now straight U6.2 to C34.1. corner_check.py 15 -> 7 points (20 -> 10 lines); foreman right_angles 6 -> 2. Left: J1 GND (E0120); 3V3 bar/U8 feed T (124.6,107.65) (feed is U8/C46/C47's only source, no free pad, a via would be a stub or cross the TOGGLE trunk); USB_DM T at J1 (A6 sits between A7 and B7, DP's loop holds the north side, D2 pad 5 blocks pad 4's west side); CAPM loop (C34's 1.55 pitch against U6's 1.3 forces a 0.25 offset and C35/VNEG/DAC_OUTL leave no 0.2 for it). DRC on the saved file: 0 violations beyond the 9 lib mismatches, 0 unconnected; strict via audit 0 true orphans, vias 264; pad_entry_check 0; route_audit stray traces 0; 0 micro-segments, 0 off-angle; no new body-gap pairs.
West POT channel re-map | D0389 ledger 0492, layout/actions/potwest-remap.json (apply format) | Lead 2026-10-08. The B.Cu-row plan was dropped: the 3V3A pot rails (x 67-187) and the POT06/POT08 risers cross the band on B.Cu and the east rows cross every one of them on F.Cu. Instead U101's west channels are re-mapped (schematic f192461, firmware slots.cpp and PINMAP channel table follow) so pin order equals row order: x 145.6 POT13, 146.28 POT11, 146.96 POT14, 147.64 POT12, 148.32 POT15, 149.0 POT09, 149.68 POT10, 150.36 POT16. Each vertical now drops from its fixed pin via to a row-end via on one diagonal (145.6,153.1) to (150.36,158.0), 0.98 apart, and no vertical passes another net's via; rows, drops and risers unchanged. Vias 264 -> 264. DRC on the saved file: 0 violations beyond the 9 lib mismatches, 0 unconnected; strict via audit 0 true orphans; pad_entry_check 0; route_audit stray traces 0; corner_check unchanged (10 lines, 7 points, all listed at b0505a9); 0 micro-segments, 0 off-angle.
CAPM, U8 3V3 T, USB_DM | D0391 ledger 0495, layout/actions/capm-c35.json, exception E0147 | Lead 2026-10-08. CAPM: C35 moved 0.13 mm south (0.2 was not needed; 0.155 left C35/C101 at 0.28 body gap, under the 0.30 floor), its VNEG line takes one 0.13 offset and its GND via moved with it; CAPM now runs U6.4 straight at y 105.32 and takes one 0.25 offset west of C35's GND via into C34.2; C101 and R147 did not move. 3V3 bar/U8 feed T (124.6,107.65): no pad chain fits (U8.4 both sides used; C47.1 south walled by C45/C49, west by ADC_SCKI; C46.1 GND pad north, ADC_SCKI via west, ADC_VCC/ADC_VREF east), registered as E0147. USB_DM T at J1 held, not applied: the briefed B.Cu link with vias (114.75,37.3) and (115.75,37.3) passes DRC but raises canon gates 17 and 20 (no GND return via within reach, ~3 mm), 134, 137 (1.0 mm B.Cu bridge between two vias) and 56 (pair changes layer); lead decides. corner_check.py 7 -> 3 points (J1 GND E0120, U8 T E0147, USB_DM). DRC on the saved file: 0 violations beyond the 9 lib mismatches, 0 unconnected; strict via audit 0 true orphans, vias 264; pad_entry_check 0; route_audit stray traces 0; 0 micro-segments, 0 off-angle; no new body-gap pairs.
Pre-fab pass | docs/audits/2026-10-08-prefab-review.md, commits feat(sch) pre-fab changes and layout place pre-fab parts | Lead 2026-10-08. Schematic: D105 SMBJ20CA C113992; R158 100 k 0402 C25741 3V3 to LDO_EN (SP809 is push-pull, EN must never float; 0402 because an 0603 pitch forces a 0.3 mm jog); C170 10 uF 0805 C15850 on 3V3A at U6; R7 68 k C23231; RVGAIN1 RK09D117000C C470307 (15A log, 30 mm shaft); TP1-TP5 (9V_JACK, VIN_9V, GND, 3V3, VBUS), TestPoint_Pad_D1.5mm, excluded from BOM and CPL. ERC 0. Board: R158 (154.9,46.11) pad 1 inline on the 3V3 trunk at y 45.6, LDO_EN from U4.3 to U107.2 now passes through pad 2 at y 46.62 with 0.93 mm 45 offsets; C170 (71.95,100.4) pad 1 into C111.1 north, pad 2 to a new GND via (69.75,100.4); TP1 (218.6,34.0) and TP3 (218.6,40.0) beside the 9V and GND silk labels, straight from J106.2 / J106.1 (the owner's uncommitted removal of the two label underlines rides in this commit); TP2 (227.0,54.25) under the VIN_9V label from D105.1; TP4 (85.85,65.0) north of C21.1; TP5 (107.7,36.9) on the VBUS west leg, which moved 1 mm west to clear CC2. Hole-to-copper 0.25 to 0.30 mm in the project rules; J3's 3V3 track re-laid at x 83.865 (0.35 mm from the NPTH); J1's own pads sit 0.26 mm from its locating pegs, so cubevox.kicad_dru relaxes hole clearance to 0.255 inside J1 only. Owner VIN_9V underline shortened to end at x 227.35, 0.22 mm clear of D105 silk. U6 reference text moved to y 98.55 off C170. Zones refilled. gates.sh ALL PASS (DRC 9 lib mismatches, 0 unconnected). Renders renders/cubevox-prefab-*.png. Not done: independent second-agent check.
Boards ordered | JLC order 2026-10-08 from a41fe4b | Owner 2026-10-08. 5 boards, 4-layer JLC04161H-7628, HASL lead-free, standard PCBA top side with THT (17 pots, 9 toggles, encoder), production files hardware/production/ (gerbers 7c6e515, BOM 75 lines / 216 parts, CPL 216 rows). J101/J106/J108 bought separately at LCSC (C368458, C3096082, C309282) for owner soldering; SH1106 OLED module bought separately. Quote: PCB 43.75, PCBA 390.07 USD. First-article checks on arrival: crystal start-up, input current at 9.6 V, DFU entry by menu and by BOOT0, USB enumeration, SAI 48 kHz, silicon rev and ROM bootloader ID. Firmware step 0 (spec 2026-10-08) before first power-up. Fault checks (foundation spec step 4): boot report shows `[boot] reset: power-on ...` and `[boot] fault: none`; a forced fault (serial command, roadmap step 3) mutes and the next boot report shows `[ERROR] last reset: fault ... pc=...`; a loop() stall (forced spin) resets through the watchdog in 2 s and the report shows `[boot] reset: watchdog`; a stopped audio DMA mutes within 100 ms and prints `[ERROR] audio stalled`.
H743 test board bench | firmware f63dd79 + bench commands, `BENCH=1 ./build.sh`, `./flash.sh`, `./term.py` | Lead 2026-10-08. Same die as U1, 25 MHz HSE, no codecs (SAI input floats), no VBUS divider (USB forced on). Verified: rev V (0x2003), ROM bootloader ID 0x92, PLL1 from HSE at 480 MHz, USB 48 MHz from PLL1Q, SAI kernel 49152008 Hz, SAI1 TX/RX DMA running, CDC enumerates, DFU entry by serial command; boot report prints reset cause and `[boot] fault: none`; forced bus fault recorded and reported on the next boot (pc, cfsr 0x8200, bfar); watchdog reset after a 2 s spin reported as `reset: watchdog`; DMA stop muted in under 100 ms. Caches and FPU on. CPU at -O2, average cycles per 64-sample block of a 640000 budget, all cards on: input gate 25805, autotune+tracker 215425, unison 134369, slapback 26175, distortion 101196, gate 25449, spring reverb 75240, EQ 9225; total 616647 (96 %). All cards off still 364158 (57 %): unison 102297, tracker 173105, gates 25000 each. Every fourth block runs the tracker's YIN burst, worst block 988819 (155 %), one block in four late. Cause: libm calls per sample (gate log10f+expf, unison sinf+powf per voice+powf, distortion expf x2 and tanhf, slapback powf+sqrtf) and the YIN accumulation chain. -O3 -ffast-math: total 512334 (80 %), burst unchanged. With Adam's dry vocal looped from flash (`samples/adam_vox_sample2_4s.wav`, bench command `v`, -O2): all on 671090 avg (105 %), worst 1104548, 485 overruns in 12657 blocks; autotune+tracker 273005, unison 134147, distortion 111093, spring 78201; all off 365147. The default layout cannot run on voiced input as written. Engine pass follows (Astra review `docs/audits/2026-10-08-astra-cpu-response.md`); costs.h waits for it.
Bring-up script and fault-record fix | `firmware/bringup.py`, `firmware/cubevox_noinit.ld` | Lead 2026-10-09. `./bringup.py --board N --faults --dfu` runs the first-article checks a board can answer over USB (enumeration, fault record, silicon rev, ROM bootloader ID, HSE start-up, 480 MHz core, USB 48 MHz from PLL1Q, SAI kernel within 100 ppm, caches and FPU, audio init, block rate 750 blocks/s against the host clock, late 0), drills the stall, watchdog and bus-fault paths, enters DFU by command and by BOOT0 and flashes back a build for the same board, then asks for input current at 9.6 V, placement orientation, menu DFU and the OLED. Log goes to `hardware/bringup/`. Its first dry run on the test board found the fault record lost: since c34dcaa `.dtcm_bss` and the stock `.noinit` both started at 0x20000000, so `gPitchFx` shared bytes with `gStored` and its constructor cleared the record before `faultInit()`. The record now has its own section at 0x2001FFC0 with a link-time overlap assert. The test board after the fix: all checks pass, bus fault reported with bfar 0xDEADBEE0. `--panel` (2026-10-12) walks every pot and toggle, then the K103 click, mute click and OLED pattern.
Power switch SWPWR1, J101 west | commit (this), renders/cubevox-switch-top.png, -bottom.png | Owner 2026-10-09, while the JLC order waited on production-file confirmation. G-Switch SS-12D11-G050 (C17179528) in series on the 9 V input: J106 pins 2/3 now 9V_PLUG, switch pin 2 = 9V_PLUG, pin 1 = 9V_JACK, pin 3 and frame legs open; owner-soldered on B.Cu at (205.2, 35.9) rot 180, lever to the rear, out of the JLC BOM and CPL. J101 moved to x 175.0 for soldering room (6.3 / 6.2 mm body gaps). Footprint and symbol from easyeda2kicad, upgraded, pins passive, lever outline on Fab; the EasyEDA STEP has its origin at the body centre, so the model carries offset 0/2.25/3.3 (proved on a one-footprint STEP export: body face at the board surface, pins within 0.25 mm of the pads). Owner routed 9V_PLUG, 9V_JACK (north of J106 at y 31.2), XLR_2, XLR_3, TRS_R, TRS_T and re-laid 3V3 around J101. ERC 0. gates.sh ALL PASS (DRC 9 lib mismatches, 0 unconnected; strict vias 0 orphans; stray traces 0; pad entry 0; corners 6 registered; 0 off-angle). Parity 0 pads differ. Enclosure not yet updated (Fusion server down): XLR slot moves 15 mm toward J108, new lever slot at the switch.
Pre-fab routing audit and fixes | docs/audits/2026-10-09-prefab-mega-audit.md, hardware/tools/mega_audit.py, hardware/layout/2026-10-10-prefab-fix.py, -fix2.py | Lead 2026-10-10. Owner laid PAD_EN, moved POT_MUX_OUT off MUX_S2, cleaned the test pads. Audit found one 3V3 copper loop (trunk, R128, R127, x 182, y 82, R129; in c4788e2), two acute off-pad Ts (3V3 at 159.97,58.90 and LINE_P at 214.10,73.60), 18 bends at a pad or via edge, 29 off-centre ends (buck cluster, input diodes, U1.73, Q101.3), 3 split collinear runs, 8 replaceable stair-steps. Loop and 3V3 T cut together; LINE_P daisy-chained K103.3, lane, C121.1 west entry, south-west to the y 79.3 lane; 12 parts moved under 0.5 mm (list in the audit doc). gates.sh ALL PASS, mega_audit loops 0, acute 0, edgebend 0, merge 0, nearmiss 0. Test pad table for every other net: docs/audits/2026-10-10-test-pad-table.md (114 yes, 12 no on dense IC pins).
Rail test pads TP6-TP11 | hardware/layout/2026-10-10-testpads.py, -testpads2.py, hardware/tools/tp_space.py, audit doc §8 | Lead 2026-10-10. Owner: pads on major voltage nets only. TP6 3V3A at U4.5, TP7 5V at U103.1, TP8 5VA at FB101.2, TP9 5VA_W on the FB102.2 vertical, TP10 VREF_BUF at the R146/U108 corner, TP11 VDDA at the C11/C164 corner. Symbols in both sheets (ERC 0, netlist checked), footprints copied from TP1 (ref on F.Fab 1.0 mm, value hidden, in_bom no). gates.sh ALL PASS, mega_audit loops 0 acute 0 edgebend 0.
Owner test pad moves tidied | hardware/layout/2026-10-10-tp-owner-fix.py | Lead 2026-10-10. Owner moved TP6, TP7, TP8, TP10, TP11, the U108 silk reference and added eight silk net labels. TP6 now at (143.7,47.7) off C25.1 west, TP7 (86.6,55.6) off U103.1 west, TP8 (157.5,71.6) off C117.1 west, TP10 (159.613,85.7) straight stub north of U108.1, TP11 (107.5,94.5) straight stub north of C10.1. Script put TP10 and TP11 on their pad's x (0.013 and 0.1 mm) and merged each stub to one segment, ended TP6's stub at centre with 0.5 mm chamfer legs. gates.sh ALL PASS, mega_audit loops 0 nearmiss 0 edgebend 0 centre 2 (C132, decided).
Pre-fab audits, five areas | docs/audits/2026-10-10-prefab-{dfm,bom,electrical,plane}.md, hardware/layout/2026-10-10-prefab-agent-brief.md, hardware/renders/2026-10-10-prefab-*.png | Lead 2026-10-10, four Sonnet/Opus agents read-only against c2635eb. Fab: every trace, via, hole, silk and edge figure passes the JLC 4-layer limits; hole-to-hole and the J1 peg sit at the limit; one GND via inside D2.2; RESET/BOOT silk 0.10 mm; 147 EasyEDA pin-1 dots at 0.06 mm and 166 KiCad library outlines at 0.12 mm accepted (owner). BOM: 73 lines all with LCSC, package and stock; v2 files stale; 75 negative CPL rotations; U107/U108 (KiCad SOT-23) vs the EasyEDA SOT-23s differ 180 deg at zero rotation, settle on the JLC placement preview. Planes: In1/In2 one piece at 94.8 %, 152 GND vias all on both planes, no sensitive net over a foreign void, C127 loop 7.3 mm. Electrical: ERC 0; K103 pad contacts were on the NO pins so rest = PEDAL against c4788e2's rest = MIC; ROM bootloader SPI4 NSS is PE11 (held low by the K103 driver) and SCK is PE12 MUX_S0 (floating); NRST cap 31 mm from the pin (left: crystal takes the room, owner); no 9 V fuse, fixed 20 dB first stage and 48 V phantom exposure accepted (owner).
Pre-fab fixes | hardware/layout/2026-10-10-prefab-sch-fix.py, -board-fix.py (`--pass2`), cubevox.kicad_pro | Lead 2026-10-10, owner go. Schematic: K103 IN_P to pin 2, LINE_N to pin 7 (NC), pins 4/5 no-connect; R162 100k 0402 C25741 MUX_S0 to GND. Board: IN_P re-laid along y 92.0 into pad 2 from the south; LINE_N chain C125.1, hop vias, (195.1,74.6) south to 77.49, one 45 into R105.1 from the west, stub south to a via at (197.75,80.6), B.Cu lane y 80.6 between the relay pad rows, via (190.7,81.6), stub north into pad 7; IN_N untouched on COM pad 6; pads 4/5 open. C127.1 to U105.8 on F.Cu (226.8,78.5)-(226.8,80.4)-(228.3,81.9)-(229.1,81.9), B.Cu jog removed, chain north trunk, via, C127, U105.8, via, south trunk. D2.2 in-pad GND via removed. R162 cloned from R154 at (144.26,114.0), pad 1 a pass-through on the MUX_S0 vertical, GND via (145.8,114.0). RESET/BOOT 0.15 mm. Project min_hole_to_hole 0.25 to 0.50 (DRC 0 hits). Pot-row slot vias skipped: both inner planes carry the same slot, so an In1-In2 via at the slot end shortens no return path. gates.sh ALL PASS (DRC 9 lib mismatches, 0 unconnected, parity clean with the new nets), mega_audit loops 0 jogs 7 acute 0 nearmiss 0 edgebend 0 decap 8.
R162 placed by owner, LINE_P single 45 | hardware/layout/2026-10-10-prefab-board-fix.py `--pass3`, hardware/tools/gates.sh | Owner 2026-10-10 moved R162 east of U101.10 to (155.0,125.1) and re-laid LINE_P at C121 as one 7.6 mm 45. Lead: R162 pad 1 made the MUX_S0 corner (vertical x 154.49 in from the north, straight west into U101.10), R162 0.12 south to pin 10's y, the off-pad T at (153.65,124.72) gone; the collinear MUX_S0 split at the old spot merged; gates.sh DIAG_MAX_MM 6 to 8 so the LINE_P 45 stands (the 6 mm cap only forced the 0.6 mm split the audit read as a jog). gates.sh ALL PASS, mega_audit loops 0 jogs 6 merge 0 tees 2 edgebend 0.
Final pre-production audit | docs/audits/2026-10-10-prefab-final-scripts.md, -final-electrical.md, hardware/renders/2026-10-10-final-*.png | Lead 2026-10-10 at d267881. Fab, plane and assembly scripts re-run: the K103 re-lay, both LINE_N vias, R162 and its via, the C127 trace and D2.2 without its via meet every JLC 4-layer limit, no new void or neck, C127 loop 5.6 mm (was 7.3), hole-to-hole minimum 0.500 mm, BOM 73 lines / 223 parts, 0 negative rotations, every board LCSC in PARTS.md, 785 pad nets match the netlist, ERC 0. Electrical: coil off = NC 2-3 and 6-7 short R102/R105 = MIC; PE11 high = PEDAL; R162 loads PE12 33 uA and holds SPI4 SCK low in ROM DFU; LINE_N B.Cu lane couples 0.05 pF to the 5VA trace beside it; D2.2 return 1.15 mm to In1. Lead: six relay-set footprints (K103, D110, Q102, R159-R161) given the cubevox: library nickname they lacked. Open for firmware (not fab): drive PAD_EN from the menu with MIC default and MIC trim 0 dB; enter DFU on encoder release, not press (PE13 is ROM SPI4 MISO and the switch shorts it to GND). Bench table in the electrical report travels with the v3 files. gates.sh ALL PASS.
Production v3 | hardware/production/cubevox-gerbers-v3.zip, cubevox-bom-v3.csv, cubevox-cpl-v3.csv, gerbers/, exports/cubevox-netlist.net, exports/cubevox-cpl.csv | Lead 2026-10-10 from 81a100f, owner go. `kicad-cli pcb export gerbers --layers F.Cu,In1.Cu,In2.Cu,B.Cu,F.Paste,B.Paste,F.Silkscreen,B.Silkscreen,F.Mask,B.Mask,Edge.Cuts --subtract-soldermask`; `pcb export drill --format excellon --excellon-separate-th --excellon-units mm --excellon-zeros-format decimal --drill-origin absolute --generate-map --map-format gerberx2`; `sch export netlist --format kicadsexpr`; `pcb export pos --format csv --units mm --side front --exclude-dnp`; `make_bom.py`. Same 16 file names as v2, X2 gerbers 4.6 mm, job file 4 copper layers 185.1 x 145.1 mm. BOM 73 lines / 223 parts, CPL 223 rows, 0 negative rotations. Diff from v2: R116 330R row and the C470307 log pot row gone; Q102, D110, K103, R159, R160 (1k), R161 (100k 0603), R162 (100k 0402), R116 (470R), RVGAIN1 (C361173) added to existing rows. J101, J106, J108, SWPWR1, TP1-TP11 absent. Upload v3 only; order 4-layer JLC04161H-7628, standard PCBA top with THT.
JLC footprints for U107, U108, C19; production v4 | hardware/cubevox_h7core.pretty/SOT-23-3_L2.9-W1.6-P1.90-LS2.8-BR, CAP-SMD_L6.0-W3.2-R-RD (+ .3dshapes), hardware/layout/2026-10-10-prefab-board-fix.py `--pass4` `--pass5`, production v4 | Owner 2026-10-10: every assembled part uses the JLC footprint for its LCSC number. The H7 core block came from a KiCad-library project and U107 (SOT-23), U108 (SOT-23-5) and C19 (EIA-6032) kept stock footprints whose zero is 180 deg from the EasyEDA/JLC zero, so v3's CPL had those three turned round. Swapped to easyeda2kicad footprints (C412495, C221351 = the existing U4 footprint, C8649) with courtyards at pads + 0.25 mm, same centres, rot +180; pad shifts 0.30 (U107), 0.16 (U108), 0.13 mm (C19) followed by the track ends, TP10 (-0.16 x), the U107.1 GND via (to 46.3, tented) and the C19 5V via (to 106.4, hole-to-hole with the GND via now 0.63 mm). J117's hand-made socket footprint matches HDR-SMD_HX-PM2.54-1X4P-TP-YQ pad for pad. Remaining stock footprints are symmetric two-pad passives and the unfitted Tag-Connect. gates.sh ALL PASS, mega_audit loops 0 jogs 6 viagap 1, ERC 0. v4: BOM 73 lines / 223 parts (differs from v3 only in the three footprint names), CPL 223 rows, U107 90, U108 180, C19 180 deg. Upload v4 only.
OLED model and STEP bodies | hardware/tools/model_oled_sh1106.py, cubevox.3dshapes/OLED-1.3-SH1106-I2C-4P.step, 29 JLC STEP bodies, exports/cubevox-enclosure.step and -full.step | Session 2026-10-10 10:50-11:16, after the v4 order: CadQuery model of the SH1106 module on 9 mm standoffs from the vendor drawing; J117 courtyard moved to the module body (local y 3.25..26.25); .step siblings for every .wrl so the KiCad STEP export carries bodies; enclosure STEP re-exported, -full includes every body. Copper laid in the same session near (155..160, 45..49) and a GND via at (113.25, 46) post-dates the ordered layout, so it is reverted and kept as hardware/layout/revb/2026-10-10-oled-area-copper.patch. gates.sh ALL PASS at the courtyard-only board.
Board 1 first power-up | hardware/bringup/board-1.md, firmware/bootloader v0.04, bringup.py, flash scripts | Owner 2026-10-29, first of the v4 boards on the bench, 9 V on, USB-C to the Mac. Blank chip, so nothing on USB until BOOT0 held and NRST tapped; ROM DFU 0483:df11 then enumerated, which also shows the crystal (the ROM's USB needs HSE). UID 1E0049000351343434393332, silicon rev V (0x2003) so 480 MHz, ROM bootloader id 0x92, HSE 25 MHz, SAI kernel 49152008 Hz (+0.2 ppm), OLED at 0x3C, audio 750.0 blocks/s with 0 late in 21401 blocks, 5VA 4.95 V. Three defects found, none on the board: (1) both flash scripts read dfu-util 0.11's `No error condition is present` status line as an error, so the first bootloader write stopped at the option byte read; one filter now in firmware/dfu_util.sh. (2) The boot report's reset cause was blank because TinyUF2's jump calls HAL_RCC_DeInit(), which clears RCC_RSR; bootloader v0.04 reads the register once at start, clears it and hands the value to the application in the boot block (`resetFlags`, block version 2); the watchdog and stall drills then read `watchdog` and `software`. (3) bringup.py drills 5 and 6 read 0 refused blocks: DIAG.TXT only refreshes on a remount (macOS serves the mount-time copy) and the parser looked for a `refused blocks` line the bootloader never writes; the drill remounts and parses the `blocks:` line, and the ctest tooling check renders DIAG.TXT with the bootloader's drivetext tool through that parser. Third run: every check and all 13 drills PASS except the five operator drills (3, 4, 10, 11, 12), skipped under --no-prompt and still to run by hand with the panel walk. Not measured: input current at 9.6 V, the bench-checklist rows. Bootloader v0.05 then put the update screens on Myrtle 5x7 (the bootloader drew the Stylized Hyperlegible 5x7, whose glyphs differ); flashed over BOOT0, drive reports v0.05, release v2.00.39 back on.
Board 1 pots on the wrong slots | firmware/cubevox/src/board/slots.cpp, hardware/PINMAP.md, docs/specs/2026-10-07-slots-design.md, docs/specs/2026-10-29-readout-card-design.md, tools/card-proof/card_proof.cpp, hardware/bringup/board-1.md | Owner 2026-10-30 on board 1: the two pots under a toggle did not drive that toggle's slot; the toggles were right. Cause: the firmware slot table gave slot N+1 the pots of panel column N and slot 1 the pots of column 8. Panel columns read from hardware/cubevox.kicad_pcb (x 64.5 to 232.5, toggles y 115, pots y 142 and y 168): POT03/POT15, POT04/POT16, POT05/POT06, POT07/POT08, POT09/POT10, POT11/POT12, POT13/POT14, POT01/POT02. Fix: slot N takes the toggle and the pots of column N, knob A the upper pot and knob B the lower; the mux channel constants are unchanged. kPot15Key and kPot16Semitones became kPot15 and kPot16 because the card, not the pot, makes a knob KEY or SEMITONES. No board change.
Board 1 bench, v2.00.44 to v2.00.50 | firmware (v2.00.44 to v2.00.50), docs/specs/2026-10-24-oled-gui-design.md, 2026-10-24-polish-design.md, 2026-10-30-input-conditioning-design.md, tools/oled-proof/menu-font-proof-*.png, menu-glyph-proof.png, z-proof.png | Owner 2026-10-30 on board 1, all good: the menu in Myrtle 7X12 (proof A3, four rows at 16 px, order INPUT, HPF, LPF, REVERB, POLISH COMP, POLISH EQ, OUTPUT, TOP SWITCH, DEBUG, UPDATE FIRMWARE, EXIT, the z from proof Z1); the ribbon as amplitude over the recent peak with the hiss floor (a Korg Volca idling draws the flat line); HPF 120 Hz and LPF 12 kHz on the hiss with the slot 1 THRESHOLD set by ear; the amount knobs MIX, DEPTH and DRIVE on the lower pots; the three-spring reverb by ear. GATE LEARN built in v2.00.45 and removed in v2.00.48. Two of seven flashes left the box in update mode with no CUBEVOX disk; a power cycle or BOOT then RESET and `flash.sh --rom` cleared it; cause open.
Board 1 loop bench, v2.00.53 | build/loop/ (gitignored: captures, spectrum.py, latency.py, playrec.py, a venv with sounddevice) | Owner and lead 2026-10-31. Mac → Scarlett Solo out → box MIC in (Input Gain set so Adam's samples peak -6 dBFS at the box's detector) → box LINE out → Scarlett in 2 (peaks -3 dBFS). Chain at defaults is unity on the real path: a 220 Hz tone at -20 dBFS in reads -19.7 dBFS RMS out with the slots on and with all eight off, -18.2 at DRIVE 100. Floors at the Scarlett: gate shut -85 dBFS RMS (the output stage); gate open on silence, pedal off -82.1, pedal at DRIVE 100 -72.5; the pedal lifts the preamp floor 15.5 dB in 100 Hz to 2 kHz, 13 dB in 2 to 6 kHz, 7 dB in 8 to 12 kHz and nothing above 12 kHz; the preamp floor peaks -72 dBFS at the box's detector at that Input Gain. Latency by one-clock play-and-record through the Scarlett, box minus straight cable: every slot off 3.4 ms (164 samples, converters and the 64-sample double buffer); Autotune on at RESPONSE 1 ms 30.6 ms on a 220 Hz carrier (grain delay plus one period); every effect up gives no clean reading because Slapback and the reverb echo every click. Load with every knob up: mean 13.4 %, worst 91.6 % of the block, 0 late, 0 dry. The GATE LEARN rule (threshold = floor + 8 dB) would put the slot 1 threshold near -64 dBFS here.
