peterdelecto/cubevox/docs/specs/2026-10-12-serial-protocol-design.md

# Serial protocol and live layout apply — design

Roadmap step 3 of `2026-10-08-update-and-slots-design.md` (Apply item 4, Serial item 6).
JSON handling follows `2026-10-08-firmware-foundation-design.md` (Decisions, "JSON"): hand-written,
flat requests, replies built with `snprintf`, no ArduinoJson.

## Transport
1. USB CDC, one JSON object per line, `\n` terminated. Requests carry `"id"` (integer) and `"cmd"`;
   the reply echoes `id`.
2. The port also carries the boot report and diagnostic log lines. A byte `{` starts a JSON line,
   which runs to `\n`. Every other byte outside a line is ignored and counted (`stray_bytes` in
   `status`), so no single byte can act. The app reads only lines that start with `{`.
3. Lines longer than 768 bytes are dropped with an error reply (`id` 0).
4. Output never blocks `loop()`. Replies, the boot report and bench prints go through a bounded
   transmit queue drained with non-blocking writes each pass, so a host that stops reading can't
   stall the loop into the watchdog. Overflow drops whole lines and counts them. The queue holds
   16 kB. Log lines stop 6 kB short of full, so the largest reply (a bench build's `hello`, about
   5.3 kB) always fits behind them; `core_tx_queue` measures it against the reserve.
5. The layout `name` is 1 to 31 printable ASCII characters; anything else is rejected. Replies
   escape every string they carry.
6. Input never holds `loop()` either. Each pass reads bytes until one line event (a line, a line
   too long, a NUL) or 769 bytes, then drains the queue (`protocol::pollPassDone`). A host that
   keeps sending gets one line handled per pass, and each reply drains before the next line.

## Commands
| cmd | Request fields | Reply |
|---|---|---|
| `hello` | — | `proto` 1, `fw` version, `serial` (24 uppercase hex characters of the MCU's 96-bit unique id, the text the update drive serves as its USB serial), `build` (`release` or `bench`), `bench_ops` (ops this build accepts), `cards` (registry: id, name, group, cost avg/worst, measured, knobs: name, kind, positions, min, max, unit, curve), `layout`, `settings` (the box always sends it; the host tool that has no board leaves it out) |
| `get_layout` | — | `layout`: `name`, `slots` (8 card ids); `settings` |
| `set_layout` | `name`, `slots` (8 card ids), optional `settings` | `ok`, or an error |
| `status` | — | CPU load % mean and worst since the last status (own baseline; never resets the shared peaks), `late` (blocks past their budget or written after the DMA began reading their half), `dry_blocks` (blocks that passed the dry input because the one before was late; `2026-10-30-output-safety-design.md` item 4), `muted`, record `seq` and write errors, serial lines dropped, `stray_bytes`, `boot_fails` (earlier starts that never reported healthy, read at boot), the load rule's `held` (bitmask of the slots it holds off, bit 0 for slot 1), and `steps` (cards it has held since boot; `2026-10-31-stage-survival-design.md`), the audio faults since boot (`overruns`, `sai_errors`, `restarts`, `nan_blocks`, `stalled` for the stall watch, true from a stall until the reset it starts), `power_trips` (power-fail mutes), `reply_overflows` (reply pieces lost to the format buffer), `floor_dbfs` (the Input gate detector's highest level since the previous status, in dBFS, -120 when no block ran the Input gate; `2026-10-30-input-conditioning-design.md`), `update_reason` (why the bootloader last stayed in update mode: `none`, `MenuHeld`, `AppRequest`, `ImageInvalid`, `ImageUnreadable` or `BootFailed`) |
| `enter_dfu` | — | `ok`, sent and flushed before the box mutes and reboots into the UF2 update drive (the `CUBEVOX` volume, spec `2026-10-24-field-update-design.md`) |
| `bench` | `op`, plus `slot` (1 to 8) for `slot_off` | `ok` after the op runs, or an error; diagnostic text goes to the log lines |

## Settings object
Owner 2026-10-24, `2026-10-24-polish-design.md`. The settings that live in the layout record's
settings block and belong to the polish stages travel with the layout, as one object next to it.

| Field | Values | Default on a fresh box |
|---|---|---|
| `polish_comp` | `true`, `false` | `true` |
| `vox_eq` (was `polish_eq`, true/false; owner 2026-11-05, `2026-11-05-vox-eq-design.md`) | `"off"`, `"on"`, `"cuts"` | `"off"` |
| `top_switch` | `"mute"`, `"bypass"` | `"mute"` |

1. Replies always carry all three. A `set_layout` request may leave out the object or any field in
   it, and a missing field leaves the box's current value. Only the fields a request carries change,
   so a request without `settings` changes none of them.
2. A wrong type or an unknown word is an error that names the field, for example
   `top_switch must be "mute" or "bypass"`. Unknown keys inside the object are skipped.
3. The output level and input jack settings stay off the wire; the menu owns them.
4. The box applies the settings with the layout and saves the record through the usual debounce.

## Bench operations
Owner 2026-10-12: a performance box must never act on an unframed byte, and Adam's release image
carries no drill it doesn't need. This realises item 5 of `2026-10-08-effect-registry-design.md`
(bench behind `CUBEVOX_BENCH`).

| Class | Ops | Builds |
|---|---|---|
| Query | `report`, `stats`, `record_status` | all |
| Service | `diag_clear` (erases the diag log; reply `diag log busy` while an entry or a record erase is in flight; owner 2026-11-13, `2026-10-24-field-update-design.md` Diagnostics item 4) | all |
| Bench | `slot_off`, `slots_on`, `pin_knobs`, `chasm`, `clip`, `reset_peaks`, `stop_audio`, `fault`, `spin`, `record_save`, `record_erase`, `panel_test`, `panel_summary`, `panel_dump`, `panel_jack`, `panel_mute`, `panel_oled`, `slot_on`, `all_on`, `slots_live`, `set_knob`, `knobs_live`, `bypass`, `polish_comp`, `vox_eq`, `stream_fault`, `fail_restart` | `CUBEVOX_BENCH` only |

Panel levers (owner 2026-11-01, "you can control the toggles. we need autonomous stress testing";
`2026-11-01-stress-bench-design.md`): `slot_on` with `"slot":1..8` forces that slot's toggle on,
`all_on` forces all eight, `slots_live` clears the forced-on and forced-off masks so the panel
rules again; `set_knob` with `"slot":1..8`, `"knob":1|2` (upper, lower) and `"value":0..100`, an
integer percent of travel, pins that one knob (a stepped knob at the nearest step), `knobs_live`
clears every per-knob pin and the pin-at-top. A slot runs when `(toggle || forcedOn) && !forcedOff`;
a per-knob pin wins over `pin_knobs`. Out-of-range arguments reply `knob must be 1 to 2` and
`value must be 0 to 100`. Letters: `n` all_on, `u` slots_live, `y` knobs_live; `slot_on` and
`set_knob` are sent as JSON.

1. One table in `core/bench_ops` holds each op's wire name and class. `hello` lists the ops the
   build accepts, from that table.
2. A bench op sent to a release image replies `op not in this build: <op>`. Its board code sits
   under `#if CUBEVOX_BENCH`, so the release image does not contain it.
3. DFU stays `enter_dfu` in every build, because the app needs it.
4. `./build.sh` makes the release image and `BENCH=1 ./build.sh` the bench image. The boot report
   prints `[boot] build release|bench`.
5. Host tools map the familiar letters to ops in one place (`firmware/bench_ops.py`), so
   `term.py -s p` still works and sends JSON.
6. First-article bring-up flashes the bench image, runs every check, then flashes the release image
   and confirms `hello` reports `release`.

Errors reply `{"id":N,"ok":false,"error":"<reason>"}`. Reasons are short and readable on the page,
for example `unknown card "foo" in slot 3`, `two reverb cards`, `same card twice: slapback`,
`over CPU budget (worst 97 %)`. A `set_layout` with an unknown id is an error; only the record
load maps unknown ids to `empty`.

## Apply
1. `set_layout` validates with `layoutValid` (with a reason), then sets the sketch's layout,
   publishes, requests a record save, and replies.
2. The audio interrupt holds its own copy of the active snapshot. A published snapshot with the
   same layout is adopted at once (knob moves). One with a different layout starts a fade: the
   held snapshot keeps running while the output ramps to zero over 50 ms; at zero the interrupt
   adopts the new snapshot, resets the engines whose slot changed card, and ramps back over 50 ms.
   A second layout arriving mid-fade is taken at the next zero point.
   Clearing a large engine (reverb, pitch) inside the interrupt costs block time. The bench check
   measures the worst block through a swap. If it goes late, the clears are spread over the
   silent blocks before the fade-in.
3. A layout change that cannot alter what is heard skips the fade (owner 2026-11-13: a card picked
   from the menu for a slot whose bypass toggle is off dipped the output for over 100 ms). The
   interrupt adopts it at once when both hold:
   1. Every slot whose card changes is off in the held snapshot and in the new one (`slotOn`, the
      toggles of `slotToggles()` with the overload holds on top) and its slot crossfade sits at off.
   2. Every slot that is on or still fading plays from the same engines in both layouts, and none of
      them clears (`enginesReadBy`, `changeHeard` in `core/layout_fade`). A card plays from its own
      engine, Autotune's when it reads Autotune's tracker (Formant or Apraxia with only Empty slots
      between, Mob or Deepthroat anywhere behind) and the Input gate's when it is Chatter.

   The changed slots' engines, old card and new, then clear one per chain block (`kResetsPerChainBlock`),
   lowest engine first, on top of a full chain pass. The largest is Mob's, 65,792 B, about 34k cycles
   at the board memset's rate (51 kB in 10k to 26k), 5.3 % of a 640,000-cycle block beside the
   costliest layout's 44 % worst block. A slot that plays from a waiting engine stays at the dry input
   with its engine stopped, even with its toggle up, and fades in by the slot crossfade once the engine
   is clear. The board's swap watch (`audioSwapStats`) starts at such a change too, so the bench reads
   the worst block through its clears. Every other layout change fades as in item 2.

   Every card the menu's SLOT rows swap into an off slot of the default layout is taken at once.
   The cases that keep the fade come only from a `set_layout` that changes an off slot ahead of an on
   reader: Autotune placed or removed ahead of an on Formant, Apraxia, Mob or Deepthroat; the Input
   gate placed or removed with Chatter on; a card placed in, or taken from, a slot between Autotune
   and an on Formant or Apraxia, which starts or ends their shared grain cut.
4. The ramp is a pure core sequencer (`core/layout_fade`): per block it gives the gain and whether
   to swap. Host-tested.
5. Controls re-seed knob steps for the new cards (already in place). No menu row opens the chain
   view (`2026-10-24-polish-design.md`).

## Modules
| Tier | Module | Owns |
|---|---|---|
| core | `protocol` | line framing state, request parse, reply formatting into a writer interface |
| core | `layout_fade` | fade-out, swap, fade-in per block; `changeHeard`, which picks the change taken at once |
| board | `serial_link` | reads CDC bytes, cuts JSON lines and ignores every other byte (counted as stray), writes replies |
| sketch | | dispatches commands to layout, record, audio stats, mute and DFU |

## Verification
1. Host tests: each command parses; malformed JSON, missing fields, wrong types, overlong lines and
   unknown commands give error replies; `hello` output parses as JSON (checked by a small reader
   in the test) and lists every card; fade gain is monotonic, reaches zero before the swap and
   returns to one. A fuzz loop feeds random bytes and truncated JSON through the parser under the
   sanitizers. `core_swap_at_once` holds Apply item 3: every menu card swapped into an off slot plays
   the same samples as no swap with no fade, the cases that keep the fade do fade, a toggle raised
   after the swap waits for the clear and then crossfades in, no stale engine state is heard, and no
   block clears more than one engine.
2. `tools/protocol_check.py`: talks to the box over the port; runs hello, get, set valid, set
   invalid (unknown id, two reverbs, duplicate), status, and checks the layout survives a reset.
   Run on the test board (chip checks only); audio stays at 0 late through every apply.
