peterdelecto/cubevox/docs/specs/INDEX.md

# Specs

One spec per stage and per subsystem. All still apply unless a later spec says it supersedes a
part. Filenames are usually `YYYY-MM-DD-name-design.md`. Add a row here with every new spec.

| Spec | Covers | Status |
|---|---|---|
| `2026-10-01-autotune-design.md` | Autotune and the pitch front end as built: KEY (twelve keys round the circle of fifths) and RESPONSE (NATURAL 500 ms to MECHANICAL 1 ms, default hard tune); the correction inside `PitchFx` replaces the dry path through an equal-power crossfade that waits for the tracker's first period; the target is the nearest major-scale note with a 0.15 st hold at the halfway point, follows the newest frame within a fifth of the median, passes a clamped frame uncorrected and glides from 0 after a reset; grid PSOLA with a 1,040-sample grain delay (latency the delay plus one period, 22.7 to 36.0 ms); no pull range. "The pitch front end" section: the 265.75 ms ring, the two-stage tracker and its gating (Autotune or Crowd; fine pass for Autotune only; idle and replay with no reader), the three equal-power crossfades, the reset rule, 61,420 B of DTCM, the chain's reset from all-off, and the host and board cost figures (`kTracker` 4 / 5, `kAutotune` 3 / 5, estimates). The KEY glide (decision 4: the old note's side runs down over 50 ms, hard tune holds), the hard-tune gates at about twice the readings with the 4 cents of 2026-10-02 as the ceiling for a future CPU change (decision 9), trimDb +0.35 dB (decision 10). Log: the 2026-10-01 design, the 2026-10-02 match to Adam's box, the 2026-10-31 audits, the three passes of 2026-11-01 (CPU, correctness, clean-up), the KEY step glide with `kPitchStage` (log item 8) and the Autotune fix pass of 2026-11-02 with the lead's call on the 98 Hz KEY step (log item 9). | current at v2.01.13; a stress run of the pitch slot owed; "The pitch front end" section is superseded by `2026-11-05-pitch-split-design.md` (built 2026-11-05: `PitchFx` is gone; `AutotuneFx` owns the ring, the tracker and the crossfade) |
| `2026-10-01-chasm-design.md` | CHASM reverb, a second engine ported from DrumSynthV3, the Chasm Reverb card. "Box code" is the box at v2.01.11: four loop allpasses, TIME straight to feedback through `kChasmFeedback` (T60 0.77 / 0.95 / 1.79 s), the fitted 8-unit chirp, wobble as two tuning fields, MIX through `kReverbWet`, wetDb 17.7 dB from Adam's clips, `kReverbChasm` 5 / 6 est. from the M7 model | current; the port sections are history where "Box code" differs; `kReverbChasm` owed a stress run |
| `2026-10-01-distortion-design.md` | Distortion stage, a Boss BD-2 model with DRIVE and TONE | current; the menu bypass is the slot toggle; always 2x oversampled; the fixed treble cut after the clipping is −2.7 dB, half the BD-2's (owner 2026-11-01, "a bit dark"); every 2026-11-02 audit finding fixed in v2.01.16 (owner: "fix all"): a quadratic knee in place of tanh, stage-major loops in DTCM, level fitted on Adam's clips, DRIVE off under 4 % and on at 5 % with a 16 ms fade, section "Audit fixes"; `kDistortion` {5, 6} is the M7 model until the box stress run |
| `2026-10-01-gate-design.md` | Gate stage; the stage specs follow its shape | current |
| `2026-10-01-harmony-design.md` | Harmony stage, a Zoom V3 model with KEY and MIX | the box has no Harmony card (owner 2026-10-08); out of the code: no card, engine, test or emulator controls; the key tables live in `engine/scale.h` |
| `2026-10-01-harmony-engines-design.md` | Harmony shifter engines A, B and C, per-voice formant, chromatic mode | out of the code with Harmony; reference only |
| `2026-10-01-level-rule.md` | The level rule (every stage at its default outputs 0 to +0.5 dB RMS over its input) and how `level_test` trims it | current; CLAUDE.md states the rule |
| `2026-10-01-octave-b-design.md` | Octave engine B, epoch-aligned PSOLA with formant control | out of the code; reference only |
| `2026-10-01-octave-c-design.md` | Octave engine C, an asynchronous granular shifter. "Box code" is the box at v2.01.10: two taps on one sawtooth and Hann rotor with Q18 delays, `octaveFade_` the one fade (equal-power through SEMITONES 0), a 2 ms correction smoother, the 5 Hz DC blocker, trim 1.1 dB on Adam's clips, MIX default 10 %, `kOctave` 2 / 2 est. from the host bench | current; the only Octave engine; `kOctave` owed a stress run |
| `2026-10-01-octave-pitchfx-design.md` | The Octave stage and the first shared pitch front end `PitchFx` | Octave decisions current; the front end it describes (three voices, Harmony, 51,944 B) is history, and `PitchFx` is gone since 2026-11-05 (`2026-11-05-pitch-split-design.md`) |
| `2026-10-01-polish-eq-design.md` | The final output EQ ("polish"), a menu stage last in the chain | the 300 Hz dip and 3.5 kHz presence stand; the 110 Hz high-pass, the air shelf and the single place in the tail are superseded by `2026-10-31-polish-eq-adam-voice-design.md` (built, bench pending); the menu row is set by the polish spec |
| `2026-10-01-slapback-design.md` | Echo stage (id `slapback`): TIME 60..250 ms with a glide that bends the repeat, AMOUNT for echo level and repeats, the low-pass in the loop, the dry at unity, the level row, the render keys | current, rewritten to the code 2026-11-02 after the audit fix pass; named ECHO on the box from 2026-11-01 (owner: "SLAPBACK -> ECHO") |
| `2026-10-01-unison-emulator-design.md` | UNISON, and the emulator skeleton, engine contract, threading and build layout the stage specs share | current for the contract; its panel table is superseded by the slots spec; the fixed-detune shifter is out of the code; the emulator skeleton is the prototype's, superseded by the 2026-11-01 emulator spec |
| `2026-10-02-adam-face-design.md` | Adam's face: hardware knobs and musician tuning sliders in the emulator | prototype only; the prototype is parked (owner 2026-10-24) and the 2026-11-01 emulator spec replaces it; the reverb engine radio is superseded |
| `2026-10-02-hardware-design.md` | The board | the firmware-update sentences of items 10 and 13 (menu reboot into the ROM DFU) are superseded by the field-update spec; item 27 by the enclosure-closure spec |
| `2026-10-03-spring-b-design.md` | The Spring reverb engine, the Spring Reverb card (`engine/spring.h`): three springs, the in-loop disperser, rest at silence, no DC blocker | current at v2.01.11: loops at 24 kHz behind a half-band pair, 24 sections at a = 0.846, wetDb +0.37 dB from Adam's clips, `kReverbSpring` 6 / 7 est. from the M7 model; the panel is MIX and TIME (v2 spec); a stress run is owed |
| `2026-10-07-slots-design.md` | Eight slots of two pots and a toggle, 16 pots on the mux, the MUTE toggle, the default slot table | current; card placement and chain order are superseded by the update-and-slots spec, and the menu reboot into the ROM DFU by the field-update spec |
| `2026-10-07-v2-mic-reverb-time-slapback.md` | v2: a live mic in the emulator, reverb TIME in place of DWELL, slapback 60 to 250 ms | built; the box has reverb TIME and the slapback range |
| `2026-10-08-update-and-slots-design.md` | Mac app, slot layout, firmware updates | page parts superseded by the Mac-app spec; the Release row (`cubevox.bin`, app tar, `install.sh`), the Recovery section (ROM DFU, BOOT0, no A/B) and the menu item that enters DFU are superseded by the field-update spec |
| `2026-10-08-effect-registry-design.md` | Firmware effect registry: card ids, knob descriptors, groups, costs, bench | current |
| `2026-10-08-enclosure-closure-design.md` | Enclosure closure: straight PETG bead-and-groove walls and a double-bead TPU boot, no fasteners | current |
| `2026-10-08-firmware-foundation-design.md` | Firmware directory tiers (core/board/ui), host tests, fault handling (a stream fault past the restart budget resets the box, owner 2026-11-10), toolchain pin | current |
| `2026-10-08-pitch-cpu-pass-design.md` | Pitch stage CPU pass of 2026-10-08: tracker gating, rings that fill while the stage runs (reset when every pitch card is off), spinning window, block-rate gains | its decisions stand where the 2026-11-01 passes did not move them; the present front end and its cost figures are in `2026-10-01-autotune-design.md` |
| `2026-10-08-cpu-pass-2-design.md` | CPU pass 2: Unison, Distortion, DTCM placement, pane tracker, PSOLA weights, 75 % / 95 % budget rule | done 2026-10-08 with the bench numbers and the measured cost table; owner listening done 2026-10-09 (both pairs fine) |
| `2026-10-08-cpu-pass-3-design.md` | CPU pass 3: Distortion restore after the D3 regression, Spring disperser pair, Unison voice interleave, restrict/locals, agent worktree merge rule | done 2026-10-09; chain 54.7 % / 64.2 %, default layout sums 61 / 72 |
| `2026-10-11-font-sizes-design.md` | OLED fonts: Stylized Hyperlegible 5x7, 9X12 and 16X24 (owner 2026-10-11), exported to `tools/font-editor/fonts/cubevox_fonts.h` | current; renamed Myrtle 5x7 / 9X12 / 16X24 (owner 2026-10-29) |
| `2026-10-12-layout-record-design.md` | Layout record in flash bank 2: schema v1 and v2, append log, ECC recovery; settings byte 8 holds BRIGHTNESS, 0 reading as HIGH (2026-11-02, schema stays 2); read limits across fault resets, failed-start give-back, no append after a torn entry, save retry, sequence floor, no flash work on a power trip (2026-11-10 fix pass) | current; byte 8 built v2.01.14 |
| `2026-10-12-firmware-structure-design.md` | Firmware module map and ownership rules (snapshot, pure menu, canvas); new firmware follows it | current |
| `2026-10-12-serial-protocol-design.md` | USB JSON protocol, live layout apply with a 50 ms fade, a 16 kB transmit queue with a 6 kB reply reserve, one request read per loop() pass | current; a layout change that only swaps cards in slots that are off, with no on card reading them, skips the fade, clears one engine per chain block and holds the swapped slot at the dry input until its engine is clear (owner 2026-11-13, Apply item 3) |
| `2026-10-15-mac-app-design.md` | Mac app: one page, slots and a card bank, headroom meter, one Update button | app parked (owner 2026-10-24); box side of Update superseded by the field-update spec |
| `2026-10-24-field-update-design.md` | Field update: TinyUF2 bootloader in sector 0, app at 0x08020000 with a CRC header, shared boot block, Adam drags a `.uf2` onto the `CUBEVOX` drive; `firmware/platform/` absorbed into `board/`; bootloader v0.06 (2026-11-01) keeps the drive mounted after the last block and restarts on the host's eject or the cable coming out, so macOS shows no "disk not ejected properly" notice; v0.07 (2026-11-10) checks the image after the last block, stops a copy idle for 5 s, restarts on an eject mid-copy, refuses every block of a file based off 0x08020000 or too large, keeps a bank 2 fault address across an update, and says `Unplug USB to cancel.` on the menu screen with a computer connected | current; host side built and on `main` 2026-10-24, screens approved except proofs 04 (new line), 08, 09 and 10; v0.07 flashed on board 1 2026-11-13, drill 7 failed on the `INFO_UF2.TXT` line; v0.08 (2026-11-13) rebuilds `INFO_UF2.TXT` with `DIAG.TXT`, flashed on board 1 the same day (ROM DFU, BOOT0 by hand), drills 1, 2, 5 to 9 and 13 pass; v0.09 (2026-11-13) removes MENU held at power-on, so update mode comes only from the menu or `enter_dfu`, a bad image, three failed starts or a clock failure, built, not yet flashed; Decisions item 5 (no bootloader self-update) is superseded by the bootloader-update spec, and `firmware/bootloader/flash.sh` takes the drive path by default with the ROM DFU behind `--rom`; shop steps and drills wait for a board |
| `2026-10-24-polish-design.md` | Polish tail: POLISH COMP and POLISH EQ close the chain, TOP SWITCH is MUTE or BYPASS, the menu's 14 rows in order (INPUT PAD and OUTPUT PAD, the five SLOT rows 3, 4, 6, 7, 8 with SLOT 8 the former REVERB, OLED BRIGHT, all renamed or moved 2026-11-05), the user's walk for the menu with the 600 ms MENU hold that closes it (owner 2026-11-05), layout record schema v2 and the protocol `settings` object | built, bench pending; BRIGHTNESS built v2.01.14; the POLISH EQ section is superseded by the 2026-10-31 POLISH EQ spec; menu row 7 (POLISH EQ, default ON, ON/OFF) is superseded by `2026-11-05-vox-eq-design.md` (VOX EQ, default OFF, three settings); the POLISH COMP section, its menu row (the menu has 13 rows), `Settings::polishComp` and the comp's place in the tail are superseded by `2026-11-10-comp-removal-design.md` |
| `2026-10-25-font-16x24-neo-grotesque-design.md` | The 16X24 value font redrawn as a condensed neo-grotesque from pixel recipes: the construction rules, widths, per-glyph forms, the gate with 0/O dropped, and the build procedure | built 2026-10-25 |
| `2026-10-24-oled-gui-design.md` | OLED runtime screens: the voice ribbon, the knob readout with rolling digits centred on what they draw, holding still within a digit count and re-centring by half a cell when a digit or the sign comes or goes (owner 2026-10-30), MUTED or BYPASS, the 2-frame dissolve, the burn-in walk, OLED BRIGHT (was BRIGHTNESS; LOW, MID, HIGH, MAX) and the dim to contrast 8 after 10 minutes with no control or voice (owner 2026-11-02), and the `level`, `gui`, `screens` and `face` modules; settles the `ui/screens` split the structure spec deferred; the SH1106 driver shared with the bootloader and its retry rule, which supersede item 6 (U8x8 tile mode) of the font-sizes spec; the toggle flip readout (ON or OFF on the value row, owner 2026-10-30); the splash's error text and code A1 to A3 after an audio fault restart (owner 2026-11-10, proofs await approval) | host part built 2026-10-24, proofs 3 to 10 approved 2026-10-24; meter box at columns 5 to 20 (owner 2026-11-01); bench pending; the Readout section stands again since the readout card was set aside; brightness and dimming built v2.01.14, bench pending; its Voice items 1 (output tap), 2 (amplitude map), 4, 5 and 7, Burn-in item 2 (rim dither), the Timing ribbon row, the ribbon module rows and Tests items 2 and 9 are superseded by `2026-11-06-scope-design.md` |
| `2026-10-24-solder-jig-design.md` | Printed jig for hand-soldering the four underside jacks; `solder-jig` component in the Fusion enclosure document | current; rev 4 shadow pockets built 2026-10-27 |
| `2026-10-27-oled-adapter-design.md` | Printed adapter between the board's OLED holes and the module's, which sit about 1 mm north; posts with crush ribs slid by the parameter `oledOffset` | current; pegs chosen 2026-10-27; crush ribs fit no hole, plain pegs held nothing, tapered barbs drawn; final 2026-10-30: eight split pins at the hole diameters with a 0.5 slot, owner's values, printed and fits |
| `2026-10-29-readout-card-design.md` | The readout redrawn as one effect's card: slot and name in a strip, a knob picture beside each parameter name, a switch picture for the toggle, the big value; rows follow the panel's upper and lower pot | set aside by the owner 2026-10-30, not built; the Readout section of the OLED GUI spec stands |
| `2026-10-30-input-conditioning-design.md` | A fixed high-pass and low-pass ahead of the slots (menu rows HPF and LPF, settings bytes 6 and 7, one-block crossfade on change, flush-to-zero at startup), the slot-1 Input gate as a hard downward expander (peak detector on the conditioned signal, 3 dB hysteresis, 50 ms hold, release on the DECAY pot, -80 dB range, threshold -80 to -30 dBFS), `floor_dbfs` in the status reply, host and bench acceptance, the analog floor items for a later hardware change. Owner draft 2026-10-30, amended the same day; GATE LEARN built then removed by the owner the same day. | the Input gate, `floor_dbfs` and the host and bench acceptance stand; the conditioning block, the HPF and LPF rows and settings bytes 6 and 7 are superseded by `2026-10-31-polish-eq-adam-voice-design.md`: the filters are POLISH EQ's front half, and the bytes are retired |
| `2026-10-30-output-safety-design.md` | Six small additions from the owner's list: an 8 ms equal-power crossfade on every slot toggle, a 5 Hz DC blocker after Octave (the reverb's came out 2026-11-02, measured doing nothing), the soft ceiling ahead of the output trim, a late block passing the dry input with a `dry_blocks` count, the PVD brownout interrupt dropping the mute relay at once, and the power-on release order (XSMT first, 100 ms of blocks, then the relay). Owner list 2026-10-30. | current; the slot crossfade is an S-curve pair that sums to 1, not equal power; a slot turned on across a layout swap clears its engine too; the 6 s relay wait runs once per reset |
| `2026-10-31-polish-eq-adam-voice-design.md` | POLISH EQ voiced for Adam's voice under its one menu row, in two places: ahead of slot 1 a 70 Hz high-pass, a 6 kHz low-pass and a de-esser (4.5 to 7 kHz detector, 5.8 kHz notch, 6 dB cap); after POLISH COMP the 300 Hz dip, 3.5 kHz presence and trim. The HPF and LPF rows, the conditioning block, the EQ's 110 Hz high-pass and the air shelf go. His voice measured on the three clips (G2, harmonics end 4.5 kHz, ess 5.8 kHz). Owner direction 2026-10-31. | built 2026-10-31 (2d0691a); settled 2026-11-02: Octave −12 at 48 Hz kept uncut, the 6 dB cap kept; the one ON/OFF row, the default ON and the always-on filters are superseded by `2026-11-05-vox-eq-design.md` |
| `2026-10-31-crowd-design.md` | Crowd, a new library card: eight PSOLA copies of the lead, each another person, with its own pitch offset, formant offset, tone shelf and lag behind the lead, so it is another performance; four tuned copies and, for each, a raised copy 1.75 st higher and 75 ms later with its own scatter and drift (owner 2026-11-01); upper pot WIDTH (spreads the copies' offsets and stretches their lags, with a melodic bottom tenth where every copy sits exactly on the lead's pitch, and drift and contour scale with it so an instrument stays in tune; a lag change waits for a quiet gap), lower pot VOICES (the copies fade in one pair at a time, then the lead leaves); unity power at every knob position; the voices read the pitch front end's ring and the tracker runs whenever the card is on. Owner design 2026-10-31, with its retunes, the simplification (no room, no wobble), WIDTH, two enhancements behind their own tuning controls (loudness scatter and per-copy contour; breath removed), timing scatter and drift, the owner's working set as the defaults, and the rule that the copies sound like actual people. Epoch-aligned cutting was built and removed, so epoch align and its shadow ring are gone. Host cost per 64-sample block 1.57 us for four copies and 2.40 us for eight (the live copies mix four at a time); `costs.h` carries an estimate from that figure until a board bench. Owner 2026-11-01: a layout holds Crowd or Unison, not both. | named Mob since 2026-11-01 (the menu shows MOB) (display name Mob, id `crowd`); board bench 2026-11-01 measured 12.3 % mean, 14.8 % worst in slot 3 with all slots on, row 13 / 16 from v2.00.83 (worst from the stress run's sweeps); swapped with Unison from the menu's SLOT n row (polish spec); owner 2026-11-01: VOICES is ten steps, 0 to 8 copies then MOB with the lead gone, and WIDTH is renamed DIVERGE |
| `2026-11-01-stress-bench-design.md` | Hands-free bench and stress run: the panel levers in the bench image (`slot_on`, `all_on`, `slots_live`, `set_knob`, `knobs_live`), `firmware/stress.py` (four layouts, all slots forced on, knobs at top then swept, 84 gates on late/overrun/dry counts, every cost row and the 75 / 95 lines, report under `build/bench/`), the rule that a bench never waits on the owner, the fault levers `stream_fault` and `fail_restart` with `bringup.py --stream-faults`, and the first run's figures (worst layout 61 % mean, 69 % worst; four worst rows raised) | built v2.00.83; `stress.py` is the method of record for the cost rows; the fault levers added 2026-11-10, not yet run on a box; the COMP bucket, its stats field and its gate are gone (`2026-11-10-comp-removal-design.md`) |
| `2026-11-01-emulator-design.md` | The emulator, `cubevox-emulator` under `firmware/host/`: the firmware's core, ui and engine code running on the Mac behind the panel (8 slots of two knobs and a toggle, MUTE, the MENU knob), the OLED at 4x, five card switches, one per SLOT row (OCTAVE / FORMANT / APRAXIA, UNISON / MOB, DISTORTION / DEEPTHROAT, GATE / LO-FI / CHATTER, SPRING / CHASM) through the menu's own actions, the MENU knob's click and 600 ms hold, the CPU line from the cost table (owner's pick over host timing), one CLIP / MIC source switch and nothing else; the headless `emulator_check` in ctest; and the user LED rule, a PWM brightness that follows the mean load squared up to the 75 % line, with a 100 ms full flash on a late block (`core/load_led.h`), on the box and in the emulator alike | built 2026-11-01; the prototype `cubevox-proto` stays in the tree and gets no work |
| `2026-11-01-slot-7-choices-design.md` | The SLOT n menu row that cycles slot 7 through Gate, Lo-fi and Chatter (Formant moved to slot 3, section 5; Bloom shows as Chatter, section 6), passing over a layout over the CPU lines; the emulator's four-position switch; the CPU table for every slot 4 / slot 8 / slot 7 combination | built 2026-11-01 (v2.00.95), rows are estimates until the stress run |
| `2026-11-01-formant-design.md` | Formant card as built, Octave's alternate in slot 3: SHIFT −7..+7 st stepped with a 20 ms glide, and MIX; a second PSOLA voice with a grain playback rate inside the pitch stage (`FormantPsolaVoice` in `engine/formant_voice.h`, shared with Mob), on Autotune's note and delay; MIX on linear gains with a level gain over 0.04 s powers, capped at +6 dB; a trim per SHIFT fit on Adam's clips; the tracker's fine pass runs for it; `kFormant` 3 / 4 est. History in section 10 | built 2026-11-01 (v2.00.95), slot 3 v2.00.96, level gain v2.01.00, audit fix pass v2.01.10; `kFormant` owed a stress run |
| `2026-11-01-lofi-design.md` | Lo-fi card: TONE (band centre 600 Hz to 2.4 kHz) and AMOUNT (band closes and drives over the first half, sample-and-hold to 6 kHz and 5 bits over the second); `kLofi` 2 / 2 est. | built 2026-11-01 (v2.00.95), rows are estimates until the stress run |
| `2026-11-01-bloom-design.md` | Bloom card, DrumSynthV3's D2 BLOOM adapted to the voice: slices of each word looped and re-cut while it lasts, the last one fading over TAIL after the word ends; keyed from the Input gate's detector; the drum's ambience dropped for slot 8's reverb. Shown as Chatter from v2.01.02 (sections 14 and 15): slices follow AMOUNT, each plays twice, the tail repeats one slice. Upper knob LENGTH (was LINGER), 20 ms to 3 s, the age limit only within a word (section 16). Audit fix pass (sections 17 and 18): cuts with a gap skipped, the key blip leaves the tail alone, the dry at unity with the trim on the slices alone. Voice-major rewrite (section 19): each voice runs its own loop, byte-identical, 5.36 ns a sample on the host on Adam's clip (12.09 before the fix pass); `kBloom` 3 / 5 est. | built 2026-11-01, rewrite v2.01.09; the row is an estimate until the stress run |
| `2026-10-31-stage-survival-design.md` | The ways the box can fail on stage and what it does about each, rewritten 2026-11-13 from the owner's rules of that day: after a fault the box restarts as it was (same layout and settings, panel read again, relay closed without the 6 s wait, a code A3, A4, C1 or W1 on the splash), an overload takes out the costliest running card and brings it back by itself (12 late of the last 48 blocks, waits of 2 s doubling to 16 s, an `OVERLOAD:` row on the voice screen, never the Input gate), a mid-song restart never ends in update mode, and the hands-free drill table of section 3. Owner direction 2026-10-31. | built, v2.01.92 to v2.01.94 (2026-11-13); drills by `bringup.py --survival`; on board 1 with v2.01.94 all 12 drills pass: the restart drills (relay 87 ms after the firmware starts, the Mac sees the box unmuted 0.85 s after USB drops) and the overload drills (Mob alone out 49 ms after the load, back after 1.99 s; a load outside the cards takes every card but the Input gate in 0.36 s and all are back 14.2 s after it ends); the `OVERLOAD:` row and the error screens seen and passed by the owner (2026-11-13) |
| `2026-11-02-cane-face-design.md` | Cane weave inlay on the lid face: flush 0.4 mm two-colour cane webbing (pairs, diagonals, octagonal holes, gaps for the over-and-under), 3 mm border, 1 mm clearance round every hole, `tools/cane-weave/weave.py` for the geometry, the Fusion build in the Lid component | built in Fusion 2026-11-02 and suppressed there the same day; the owner chose C12 for the face (`2026-11-02-circle-face-design.md`); the border, clearance, depth and print rules carry over |
| `2026-11-02-circle-face-design.md` | Circle inlay on the lid face, candidate C12: 2,307 separate light circles 0.94 to 2.66 mm across on the dark lid, a crumpled-tissue relief lit from the upper right, 0.65 mm dark gaps, flush 0.4 mm; the generator `c12_circle_list()` in `tools/cane-weave/candidates_c.py`, `c12_export.py` for the circle list, `fusion_c12.py` for the Fusion build (sketch `C12`, cut `C12 cut`, the dots as one body of 2,307 lumps in base feature `C12 dots`, group `C12`) | chosen and built in Fusion 2026-11-02 (sketch, cut, one-body dots, group `C12`; the cane group stays suppressed); OrcaSlicer wants one dots body, not 2,307 (owner); document not saved |
| `2026-11-04-yawn-design.md` | Apraxia (shown name since 2026-11-05, written Yawn in this spec; code id `formant_follow`): slot 3's third choice beside Octave and Formant, the Formant voice's shift driven by the singing like an envelope filter pedal: a 3 ms / 70 ms follower on the block peak, SENSITIVITY (upper pot) setting the full-drop level with a 12 dB window, an onset detector, a sweep that drops the throat by RANGE (lower pot, 0 to −7 st) and comes back over DECAY (tuning, 300 ms) while the note holds; wet only, pitch unchanged; `kFormantFollower` 5 / 8 est. (a388e76). Three audition builds in the log; the plain follower, the LFO modes and the upward range heard and dropped. Owner direction 2026-11-04. | built 2026-11-04, v2.01.22 (`build/audit/report-yawn-ship.md`): pluck law only, YAWN on glass, the unpicked modes removed; the three picked renders come out bit-identical; the row is an estimate until the stress run; 2026-11-05: RANGE runs −12 st, 0 at noon, +12 st (the top was +6 st), the Formant trim table reaches ±12 st and the card behind Autotune gets a +0.5 dB lift at +12 st (log entry 6); 2026-11-10: a soft note under the onset plucks instead of holding the throat (log entry 8), so the picks no longer match the third build's files bit for bit (they had drifted −0.2 dB before this) |
| `2026-11-04-decal-addin-design.md` | Decal add-in for Fusion, self-contained: a PNG, an SVG or typed text cut 0.4 mm into a face the user picks (flat or cylindrical, emboss wraps the cylinder; others refused by name); one raster pipeline at 0.1 mm in a plain-Python core (`tools/decal/Decal/decal_core/`, own PNG decoder, shading or dark threshold, keep-outs drawn in, minimum width 0.8 mm by distance transform, border-following trace, 0.08 mm simplify); the dialog (face, source, width, offset, rotation, mirror, keep-outs on/off with a diameter per round-hole size and one margin, depth, store cut body) with a custom-graphics preview, a live count and ceilings (10,000 points, 1,000 pieces) that disable OK; the bake as one undo step (sketch, cut or emboss, one-body inlay by the slab route, stored cut body, group named after the file) with a volume and lump check; settings stored in attributes and a REBAKE DECAL button; every error named with the design left as it was; `decal_core_test` under ctest without Fusion. Owner direction 2026-11-04. | built 2026-11-04: 127 core tests under ctest; flat, cylinder, SVG, text, keep-outs, stored cut, rebake and colour all ran on a scratch design through `api.run_decal` with exact volumes (section "As built"); the cylinder cut is one emboss per piece (Fusion's emboss rejects axially offset profiles), profiles match by bounding box; the dialog itself is not yet driven; the ceilings are still the hand-build numbers. Superseded in part 2026-11-04: dialog, button, rebake, folder layout and the one-decal-per-body rule now live in `2026-11-04-image-text-decal-design.md`; pipeline, bake, cylinder rules, constants, ceilings, errors and core tests still apply |
| `2026-11-04-image-text-decal-design.md` | Image Decal and Text Decal, two Fusion add-ins (one promoted button each on the Solid tab's Modify panel) written as the user's step-by-step walk with intent at each step: face pick with preselection, image file (PNG or SVG; JPEG refused by name) with a trace thumbnail, the decal on the face at once (centred, upright to the camera, fitted inside the face outline or 0.3 mm per pixel), a triad on the face for move and turn and a width arrow for size, mirrored by typed X, Y, Angle and Width, Place by click, Measure from a corner, tones named by result with an Ink slider, keep-outs as a group with a header tick and a red tint, colour swatches, a drawn preview in the inlay colour with edge lines, a worker-thread decode and re-trace, a Preview the cut button with Cancel, a four-line full-width readout (face, place with edge gaps and hole clearance, count and cost, worst message first with a numbered fix), Name, Freeze the cut on by default only over 10 s, Edit and Delete of any decal from either dialog, decals stacked on a body and re-cut above an edit with Clear earlier decals under it, stale-decal detection by a timeline-marker read of the body before the lowest decal; Text Decal adds a multi-line text box with the last words pre-filled, Fusion's font list with recents, Find a font and ◀ ▶ stepping, bold and italic, Align, cap height in mm with its own arrow, letter spacing, and words round any circular edge reading Over or Under the hole. Dialog rules (fifteen rows at open counting every row Fusion draws, under 600 px, one group open at a time), API table from the installed Fusion's Python stubs, changes to the earlier pipeline, decisions, performance budget, build order, owner's acceptance walk. Audit in `docs/audits/2026-11-04-decal-ux-audit.md`. Owner direction 2026-11-04 second talk. | spec written and audited 2026-11-04 (16 findings from the lead's walk, 40 and 25 contradictions from a cold read, all folded in); not built; the one-button `Decal` add-in of the same day is the base it is rebuilt from |
| `2026-11-04-sympath-design.md` | Sympath (was Strings, code id `strings`): the sympathetic strings that follow the held note. A note counts as held when the card's own tracker stays within 0.5 st of one semitone for 150 ms; the strings then retune to that note's root and fifth over four octaves, 8 strings (down from 12), no 3rd. The old bank fades over 200 ms, and the strings stay silent before the first held note. Sympath does not rely on Autotune or its key. Owner decisions 2026-11-04. | removed (owner 2026-11-05); the box has no Sympath card; out of the code: no card, engine, test or emulator controls |
| `2026-11-05-pitch-split-design.md` | The shared pitch stage split into per-slot engines (`AutotuneFx`, `OctaveFx`, `FormantFx` for Formant and Apraxia), each on its own slot's input with a ring of its own, so the chain-order rule holds for them (audit entries 4 and 5, owner option A); Mob keeps a ring of Autotune's input and Autotune's tracker (exempt); which card reuses Autotune's tracker and which runs its own; `UpstreamPitch` in place of `outputShiftSemis` and `outputLatency` for Deepthroat; the grid sharing removed and Formant's base aligned to its voice; rings, DTCM 46.6 % and D1 53.3 % after; latency (Formant and Apraxia +1.6 to +21.5 ms); host bench and rows (default 33 / 47 unchanged, `kPitchStage` removed); tests, build order and two owner questions | built 2026-11-05 (steps 1 to 5; the box, step 6, is the lead's): with Ringer gone, DTCM 47,296 B (36.2 %), D1 279,264 B (53.3 %); default layout 6.43 to 6.44 us a block before and 6.46 to 6.48 after on the host; Formant's added delay is settled by the grain group (it waits for Autotune's delay once); Octave's ear check passed (owner 2026-11-05, v2.01.66); the latency row for Formant and Yawn and the section 2 Formant row are superseded by `2026-11-05-grain-group-design.md`; fix pass 2026-11-10 (section 1 items 5 to 9, section 2 tracker gating item 1): a stopped pitch card keeps writing its ring and idles its tracker, so a switch-on comes in at once (Octave, Formant behind a running Autotune) or after the tracker's 10.7 ms replay; after a clear the card waits for its ring; the switch-on crossfade and Octave's step through 0 hold their level (`crossfade_hold.h`); Formant at MIX 0 runs no tracker |
| `2026-11-05-grain-group-design.md` | One grain pass for Autotune and the Formant or Apraxia card directly behind it (owner 2026-11-05, "fix it properly"): grain cards next to each other share one cut, so the group waits once, for Autotune's grain delay, and Formant's or Apraxia's voice lands with Autotune's (22.7 to 36.0 ms) instead of 1.5 cycles later (47 ms on G2). Alone, or with a card between, they keep the split's own ring and tracker. The group forms and dissolves over Autotune's crossfade with no click or pitch bend. Octave stays the granular pedal octaver of 2026-10-01 and is not grouped | built 2026-11-05 (steps 1 to 5; "As built" at the end of the spec lists where the build differs from the design: the alone lag is the grain delay plus a period, not 1.5 cycles, so Autotune's toggle moves no delay; the Autotune slot feeds its input to Formant's ring, so Autotune's ring and DTCM, 36.2 %, stay; D1 53.4 %); supersedes the split spec's Formant latency row and its section 2 Formant row; fix pass 2026-11-10 ("Switch-on, MIX 0, range return and the rule"): the Autotune slot feeds the card behind it on or off, so the card snaps on with the slot fade; no tracker for MIX 0; fresh grains after a range dropout; the chain-order rule's grain-pair clauses pinned in `pitch_split_test` and `core_chain_run` |
| `2026-11-05-vox-eq-design.md` | VOX EQ, the POLISH EQ menu row renamed and widened to three settings, default OFF (owner 2026-11-05): OFF runs nothing, ON runs a 40 Hz subsonic high-pass and the de-esser ahead of slot 1 and the dip, presence and trim after POLISH COMP, ON+CUTS adds the 70 Hz high-pass and 6 kHz low-pass. The user's walk, the retired record byte 3 and the new byte 9, the `vox_eq` protocol string, level readings at each setting, and what it supersedes in the 2026-10-24 and 2026-10-31 specs | built 2026-11-05; trim +1.15 dB since 677f55c, readings re-read 2026-11-10; POLISH COMP is gone (`2026-11-10-comp-removal-design.md`), so the back half follows the last slot and walk item 9's whole-tail readings no longer apply; the row's name and values are superseded by `2026-11-10-cleanup-eq-design.md` |
| `2026-11-05-cover-design.md` | Printed 68D TPU cover over the knobs for travel: Adam's walk, the numbers from the Fusion model and the owner (20 mm knobs, 254 mm bed), a 3 mm plate 4 mm over the knobs, a 2 mm skirt down the flush walls to a 5 mm band that stretches 0.4 mm over the TPU boot on front and sides, a 13.5 mm rear skirt ending at the lid seam clear of the jacks, user parameters, print rules, the `Cover` component plan | superseded whole by `2026-11-07-protector-design.md` (owner 2026-11-07) |
| `2026-11-13-bootloader-update-design.md` | Updating the bootloader from the `CUBEVOX` drive: a bootloader file in the application's format that carries the new bootloader and a small updater, dragged like a firmware file, then the firmware dragged after it; no buttons, enclosure closed; BOOT0 stays for a box that cannot start | built and run on board 1 (2026-11-13): `firmware/bootloader/updater/`, `cubevox-bootloader-v0.09.uf2` from `build.sh`, the drive path in `flash.sh`; v0.08 to v0.09, v0.09 over v0.09, and a file with one flipped byte kept its bootloader (`bootloader file damaged: crc wrong`); owner asked for it 2026-11-13 |
| `2026-11-07-protector-design.md` | The Protector: a 68D TPU cup that is the box's tray in use and the cover over the knobs for travel; locks into the two windows the owner cut in the boot's side walls with four notches, two per wall; the lid and dish carry nothing; Adam's walk, the numbers from the model, 60 mm depth, parameters, print rules, the `Protector` component plan with a second occurrence jointed on top | superseded whole by `2026-11-11-protector-design.md` (owner 2026-11-11); never built |
| `2026-11-11-protector-design.md` | The Protector, redone: one Siraya Tech TPU-GF cup, 38.6 mm tall, that lies flat on the desk under the boot in use and turns over side to side to cover the knobs for travel; no change to the boot, lid or dish; a rear wall with notches formed round each jack, the switch and the USB-C; one snap rib on each solid side wall that clicks into the seam between lid and dish; 18 knob pockets inside the plate set the cup's place and depth; Adam's walk, numbers from the model given from the desk up, force estimates, parameters, print rules, the as-built timeline and checks | built in Fusion 2026-11-11, STL in `hardware/exports/protector.stl`; Fusion document not saved; a flush inlay in the underside face is open |
| `2026-11-06-scope-design.md` | The voice screen's ribbon replaced by an oscilloscope trace (owner 2026-11-06): Adam's walk; 103 columns at 8 samples each (17.2 ms), a 1 px trace drawn as joined column runs, the horizon line alone in silence; a scale that fits each frame's peak and falls 3 dB a frame, with a fixed silence level of -54 dBFS (the ribbon's floor rule is gone) and a minimum scale of -40 dBFS; a rising zero-crossing trigger; the tap on the block leaving the last slot, before POLISH COMP, VOX EQ's back half, output trim and the soft ceiling, a 2048-sample ring in D1 read with a block count; supersedes the OLED GUI spec's Voice items 2 (scale only), 4, 5 and 7 | spec written and UX-audited 2026-11-06 (7 findings folded in: peak-anchored trigger, every block written); built 2026-11-06; scale rebuilt 2026-11-07 to fit each frame and silence made a fixed level (owner), ear and eye check pending; walk item 9 matches the code 2026-11-10 (the ring is ahead of the layout fade, and the open menu covers the swap); no POLISH COMP follows the tap since `2026-11-10-comp-removal-design.md` |
| `2026-11-10-comp-removal-design.md` | POLISH COMP removed (owner 2026-11-10): the reasons (the venue compresses, the tuning was fit to the clips, the makeup ran the box 5.85 dB louder between phrases), the user's walk, the tail without it, the retired record byte and `polish_comp` key, the menu at 13 rows, `kFixed` at 5 / 6, what it supersedes in the polish, VOX EQ, stress bench and scope specs | built 2026-11-10; the record's byte 2 and the protocol's `polish_comp` key and comp bench op in the 2026-10-12 record and protocol specs are retired by it; the other specs that name the comp describe the box before this one |
| `2026-11-10-cleanup-eq-design.md` | VOX EQ renamed CLEANUP EQ with the values OFF, LIGHT and STRONG (owner 2026-11-10): the user's walk, the 8 px gap of `CLEANUP EQ` to `STRONG`, the unchanged record byte 9, the protocol key `cleanup_eq` (`off`, `light`, `strong`), the renamed settings, cost row, bench op and `cubevox-render` flag; the stage's sound is unchanged | built 2026-11-10; the specs written before it say VOX EQ, ON and ON+CUTS for the row, LIGHT and STRONG |

Research notes live in `docs/audits/`. `2026-10-08-pitch-tracker-research.md` is the note behind
the tracker plan.
