peterdelecto/cubevox/docs/specs/2026-10-31-stage-survival-design.md

# cubevox — the ways the box can fail on stage, and what it does about each

Owner direction 2026-10-31: a robust way to ensure the box cannot die during a performance.
Target: the H7 firmware on the v4 board, 48 kHz, 64-sample blocks, float32. Revised 2026-11-13
against the code at v2.01.90; the build started that day, in the order load rule and NaN guard,
warm restart, drills.

Settled (owner 2026-11-13, replacing the 2026-10-31 rule that a card stayed off until its toggle
was flipped): a card the box turns off comes back by itself, so Adam never has to act in the middle
of a song, and the screen says `OVERLOAD`. The heaviest layout the menu builds costs 70 % in its
worst block against the 95 % limit, so the load rule is a net for a catastrophic fault that should
never be seen. Board changes are out of scope.

## How to read this
One entry per failure. Each gives how it arises, what Adam hears today, what he hears after this
spec, the bound the box must meet, and the drill that proves it (section 4). A bound without a
measured number in the run log is not met.

## 1. Failures

### F1. One block runs long
How. A worst-case block in Autotune, Octave or Reverb lands with an interrupt on top. Rare and
single.
Today. The block is counted late; the next block passes the dry input; the chain resumes. One tick.
After. Unchanged. The late block also counts into the load rule's window (F2).
Bound. One tick, no mute.
Drill. `burn 700000` for one block.

### F2. The load stays over the limit
How. A layout near the 95 % line with knobs at their costliest positions, a firmware regression, or
an input that drives a tracker hard.
Today. Every chain block is late, so blocks alternate dry and effected every 1.3 ms. A buzz. The
dry blocks hand back enough time that the overrun mute never trips, so nothing recovers until the
load falls.
After. The load rule. The block interrupt keeps the late verdict of the last 48 blocks (64 ms).
Two late blocks inside the window raise a trip, and `loop()` takes the trip on its next pass. On a
trip the rule holds the engaged card with the highest `worst` in the cost table, the later slot on
a tie, and the card goes out through its slot's 8 ms fade (`SlotFades`). The hold is one more term
where a slot is switched (`compose.cpp`, beside the bench's forced-off mask), so the chain code
does not change. The Input gate card is never held, wherever the layout puts it. CLEANUP EQ, the
soft ceiling and the BYPASS mix are not cards and keep running. Steps are at least 50 ms apart, and
the window starts empty after each step. The bottom is every card held: his dry voice through the
Input gate and CLEANUP EQ.

The card comes back by itself. Each held card has its own wait, counted from the moment it was
held: 2 s the first time. When the wait is up and the window holds no late block, the rule lets
the card go and it fades back in. If the same card is held again, its wait doubles: 4 s, 8 s, 16 s.
A card held a fifth time stays off for the rest of the power cycle, so a card that keeps failing
ends up out of the chain instead of coming and going all song. A flip of the card's toggle off and
on lets it go at once and starts its count again at 2 s (the rule watches the toggle levels in the
panel reading). A layout apply or a card swap clears every hold and every count, because that path
restarts the chain anyway.

Text row 0 of the voice screen says what happened while any card is held, and is blank otherwise:
`OVERLOAD: REVERB OFF`, naming the held cards in slot order, each by the word the menu's SLOT rows
show for it. When the names pass 21 columns the row reads `OVERLOAD: 4 CARDS OFF` with the count.
The row moves with the screen's burn-in walk. Proof by number.

What Adam does. Nothing. He hears one tick and a card drop out, his voice never stops, and the top
row says `OVERLOAD` and names the card. A few seconds later the card is back and the row is blank.
Bound. His voice at every moment, one tick per step, never a buzz, the mute relay never drops
for load.
Drill. `burn 200000` (about 103 %), `burn 400000` (about 134 %), a ramp 0 to 400 000 over 10 s.

### F3. An engine produces NaN or infinity
How. A numeric edge in one card.
Today. The block is silenced and every engine is cleared, so every tail and every tracker starts
cold. One silent block and a cold chain.
After. The NaN guard names the slot. The chain checks each running slot's output as it goes, with
the guard's own test (one sum of squares, which also catches a finite output past +60 dBFS; a card
that loud is broken too). At the first slot that fails, the chain stops for that block, so no later
card takes in the bad block; the block is silent and only that card's engine is cleared. The load
rule holds that card at once, with no window, because an engine that produces NaN is broken, not
busy. The other cards keep their state. The card comes back by the same waits as in F2, with its
engine cleared, and the row reads `OVERLOAD` for it as well. The check costs eight sums of 64
samples per block, and the stress run measures it.
Bound. One silent block, then his voice through the other cards.
Drill. `nan <slot>`.

### F4. The audio interrupt stops
How. A stuck DMA stream, a SAI error the stream did not ride through, a lock in the block
interrupt.
Today. Eight overruns in a row drop the mute relay; the stream restarts, the mute holds, then opens.
At most three restarts fit in any minute. Three cases reset the box, all by one path
(`faultAudioWatch`), each with an error code (owner 2026-11-10): A1, a fourth fault inside a
minute of three restarts (owner 2026-11-10); A2, a restart that fails; A3, a stall, where no block
finishes for 100 ms. The box mutes at once, writes one `audio` entry whose fault text names the
code and the cause (`A1 repeated stream faults`, `A2 stream restart failed`, `A3 audio stalled`),
waits up to 3 s for the flash to be idle (`ResetWait`), and resets. Every reset then takes the power-on path,
so the relay closes 6 s after the app starts. Through that wait the splash explains the error and
shows its code (`ERROR A1` to `ERROR A3`), so Adam sees why the sound went (OLED GUI spec,
Priority 11). A start that does not run
audio for 5 s counts as a failed start, so a stream that faults past the budget inside 5 s of every
start ends on the third start in "Startup failed." (update mode, until the power is cycled). A stream
that runs longer than 5 s before it faults resets the box again and again, with the 6 s gap each
time.
After. Warm restart. The reset cause in the boot block (`resetFlags`) with 5VA good decides the
path. A start is warm when the flags hold SFTRSTF, IWDG1RSTF or WWDG1RSTF, hold neither PORRSTF
nor BORRSTF, and the power sense has a reading with no trip. Every other start is cold and keeps
today's 6 s; that includes a bare NRST tap and a start with no 5VA reading. PINRSTF decides
nothing, because this chip sets it on every reset (the boot report reads `reset: software pin`).
The bootloader's `cvBootPowerOn` is the same test, and `core/restart_rule.h` shares its masks.
1. Order. On every start `setup()` runs the mute pins, the power sense, the fault record, the
   record read and then audio (the engines, SAI and DMA, XSMT high at
   zero output). The panel, USB and the menu come after audio.
2. Knobs. The first real snapshot needs all 16 pots read. On a cold start the mux selects wait
   1100 ms for U107 to bring 3V3A up. On a warm start 3V3A never went down, so the scan starts at
   once, and the first snapshot follows as soon as the 16 pots are in. Until then the output stays
   held, as today.
3. Relay. On a warm start the mute sequence skips the 6 s: MUTE_N goes high as soon as the clocks
   run and the first snapshot is in, then 20 ms for the relay and the 50 ms fade up.
4. Input relay. On a warm start K103 already sits where the settings put it, so `setup()` does not
   drive it again.
5. Flash wait. Today the reset waits up to 3 s for the stores to go idle (`ResetWait`). The audio
   fault reset caps that wait at 200 ms; past it the box resets without the DIAG.TXT entry.
6. Screen. Audio is back before the panel starts. The splash with its `ERROR A1` to `ERROR A3`
   text stays up 6 s on a warm start, the reading time it has today, and ends early when Adam
   touches a knob, a toggle or MENU.
7. Report. The boot report prints warm or cold, and on a warm start the time from the start of
   `setup()` to the first block, to the first snapshot and to the relay.
Bound. Gap ≤ 1.5 s from the last good block to the first good block, same layout and settings,
nothing pressed. Budget: stall detect 100 ms, flash wait ≤ 200 ms, reset and bootloader ≤ 20 ms,
setup to the first block ≤ 400 ms (target, measured), the 16 pots read (measured), relay 20 ms,
fade 50 ms.
Drill. `stall`.

### F5. loop() hangs
How. The panel's SPI, USB or a flash write waits forever.
Today. The audio interrupt keeps running, so the sound continues while the menu and screen freeze.
IWDG1 fires at 2 s and the box resets onto the 6 s path.
After. Same until the watchdog, then the warm restart of F4. The RX DMA interrupt sits above the
block interrupt and the block interrupt above everything else, so a stuck loop() never touches
audio before the watchdog.
Bound. Sound for the 2 s, then a gap ≤ 1.5 s.
Drill. `hang`.

### F6. A hard fault or a runaway
How. A bad pointer, a stack overflow, a corrupt table.
Today. The fault handler mutes and resets; the reason reaches DIAG.TXT. Then the 6 s path.
After. The warm restart of F4.
Bound. Gap ≤ 1.5 s.
Drill. `crash`.

### F7. A card crashes the box every time it runs
How. A fault inside one engine that the layout and his input reach each time.
Today. Crash, reset, the same layout, crash. After three starts that never reach healthy the
bootloader stays in update mode, a silent box showing the update screen until a power cycle.
After. No special mode (owner 2026-11-13: a stage box comes back in the state the musician
expects; it does not show a fault-finding screen or ask him to work out what failed). Every restart
is the warm restart of F4: the same layout, the same settings, and the panel as it stands, read
again from the toggles and pots. The software keeps no memory of a toggle or a knob, so what the
panel shows is what the box plays. A crash that repeats restarts the box again each time, and a
restart in the middle of a song never ends in update mode (owner 2026-11-13: a box that fails to
start before a gig is a different case from a box that restarts mid-song). The bootloader's
three-strikes rule, three starts in a row that do not run audio for 5 s end in update mode, is
for a box that cannot start after power-on or after an update. So once the box has run audio for
5 s since power-on, the application sets a mark in the boot block's application area, which the
bootloader zeroes at every power-on. On a warm start with the mark set, `setup()` zeroes the
failed-start counter at once, before audio starts, so mid-song restarts never add up to three.
The bootloader does not change.
Bound. Gap ≤ 1.5 s at each restart, however many in a row.
Drill. `crash` five times, 2 s apart, after the box has run 10 s: the same layout and panel after
each, never update mode. With the box freshly powered and the image made to fail at once, the
third start is update mode, as today.

### F8. Brownout or power loss
How. The 9 V supply sags or is pulled.
Today. The PVD interrupt drops the mute relay at once; the power-fail path holds XSMT low until
5VA recovers; power-on returns on the 6 s path.
After. Unchanged. A cold reset keeps the 6 s because the pop it prevents is real.
Bound. Mute before garbage. Return in the power-on time.
Drill. 9 V pulled to 7 V, then cut.

### F9. A flash write during a song
How. A menu click saves the layout record while the chain runs.
Today. The record store writes bank 2 while code runs from bank 1, chunked and polled from loop().
A reset mid-write lands in the store's ECC recovery and append log (layout-record spec).
After. Unchanged, now drilled under full load and with a reset during the write.
Bound. No late block from a save. A record cut mid-write loads or falls back to the default layout.
Drill. 20 menu saves during `burn 300000`; `crash` during a save.

### F10. USB plugged or unplugged mid-song
How. A host attaches or drops.
Today. Handled in loop(). The USB interrupt sits at level 1, above the block interrupt at 15,
so USB traffic counts toward block time. The serial reader handles one line per loop() pass, so a host that
keeps sending cannot hold loop() into the watchdog.
After. Unchanged, drilled.
Bound. No late block.
Drill. Plug and unplug the host under load.

### F11. The panel fails
How. The OLED ribbon or the SH1106 stops answering.
Today. The driver's retry rule (OLED GUI spec) retries without blocking the loop beyond its budget.
After. Unchanged, plus `setup()` starts audio before the panel on every start (F4), so a dead panel
never delays the first block.
Bound. Sound continues with a blank screen. No late block.
Drill. `panel-fail`, forcing the driver's error path.

### F12. A door into update mode during a song
How. A hand on MENU.
Today. UPDATE FIRMWARE opens a confirm screen first. MENU held at power-on is the only other way in.
After. Unchanged, drilled.
Bound. No single click or hold leaves audio.
Drill. Click UPDATE FIRMWARE, cancel; hold MENU with the box running.

### F13. A corrupt or over-budget layout at start
How. Power lost during a save, a record from a bad app build, a layout past 75 % mean or 95 %
worst.
Today. The record is refused and the default layout loads; the reason is in the boot report.
After. Unchanged.
Bound. Sound with the default layout.
Drill. `corrupt-record`, then power cycle.

### F14. A hot input or DC
How. A shouted note, a plugged jack, a DC step from Octave or the reverb.
Today. The soft ceiling never passes 1.0, the 5 Hz DC blockers after Octave and the reverb,
flush-to-zero, the Input gate.
After. Unchanged.
Bound. No sample past full scale, no NaN.
Drill. A +6 dBFS burst; a jack plugged under load.

### F15. The processor dies
How. A hardware fault, a rail.
Today and after. K102 mutes. Nothing on the board passes the mic around a dead processor, so the
output is silent until the restart, and silent for good if it never restarts.
Bound. None on this board. Board changes are out of scope.
Drill. None.

## 2. Counters and reports
`held` (a bitmask of held slots), `steps` and `window_worst` join the status reply. The boot
report's audio line prints steps since boot and, on a warm restart, the time to the first block and
to the relay. DIAG.TXT gets one line per step with the card and the window's worst percent. It goes in
the entry's text field under the audio kind, as the A1 to A3 texts do, so the entry layout and the bootloader do not change.

## 3. Host tests
1. `core/load_rule.h`, pure: window counts, the two-late trip, step order by `worst`, 50 ms
   spacing, the later slot on a tie, the Input gate never held, a NaN slot is held at once; a held
   card comes back after its wait when the window holds no late block, the wait doubles from 2 s
   to 16 s, the fifth hold stays, a flip off and on lets the card go at once and resets its count,
   a layout apply clears holds and counts.
2. `core/restart_rule.h`, pure: warm against cold from the reset flags and 5VA.
3. (No safe-start rule; F7 has no special mode.)
4. `core_chain_run`: a NaN block names its slot.
5. `test/firmware/ui_*`: the `OVERLOAD` row, proof by number.
6. `core_protocol`: the three new status fields.

## 4. Fault drills, on the bench, every release
The drills are bench ops, so they exist only in the bench image (`BENCH=1 ./build.sh`) and only
over the serial port; nothing on the panel can reach them and the release image carries none.
`stall` is the op `stop_audio`, `hang` is `spin` and `crash` is `fault`, all three built. The new
ops are `burn` (cycles spun inside each block), `nan` (a slot), `panel_fail`
and `corrupt_record`. `bringup.py --survival` runs them from the Mac with no hands on the box and
writes the measured column to the board's log in `hardware/bringup/` beside the version. The rows
for F8, F10, F12 and F14 need hands on the box; their behaviour is unchanged by this spec and the
run skips them.

| Failure | Drill | Expected | Measured |
|---|---|---|---|
| F1 | `burn 700000` once | one dry block, one tick | ticks |
| F2 | `burn 200000` | one step inside 120 ms, Reverb held, voice continuous, the row reads `OVERLOAD: REVERB OFF`; after `burn 0` Reverb is back 2 s after it was held and the row is blank; with the burn left on, its waits run 2, 4, 8, 16 s and the fifth hold stays | time to step, time to return, ticks |
| F2 | `burn 400000` | steps to the bottom at 50 ms spacing, voice continuous, no mute | steps, time to bottom |
| F2 | ramp 0 to 400 000 over 10 s | one step at a time, no mute, no buzz | steps, late count |
| F3 | `nan <slot>` | that card held at once, other tails intact, the card back after 2 s | silent blocks |
| F4 | `stall` | mute inside 100 ms, reset, back with the same layout | gap |
| F5 | `hang` | sound for 2 s, watchdog, back | gap after the watchdog |
| F6 | `crash` | mute, reset, back; DIAG.TXT entry | gap |
| F7 | `crash` five times, 2 s apart, after 10 s of running | the same layout and panel after each, never update mode | gap, five times |
| F8 | 9 V to 7 V, then cut | mute before garbage; return on the power-on path | gap on return |
| F9 | 20 saves during `burn 300000`; `crash` during a save | no late block beyond the rule's steps; the record loads or the default layout does | late count |
| F10 | host plug and unplug under load | no late block | late count |
| F11 | `panel-fail` | sound continues, blank screen | late count |
| F12 | UPDATE FIRMWARE then cancel; MENU held while running | audio unbroken | late count |
| F13 | `corrupt-record`, power cycle | default layout, reason in the boot report | — |
| F14 | +6 dBFS burst; jack plugged under load | nothing past full scale, no NaN | peak |

## 5. Costs
The load rule is a few compares per block and a 48-byte window. The rest costs nothing at run time.

## Open item for the owner
1. The 1.5 s bound in F4, or tighter, which forces `setup()` to be measured and trimmed.
