peterdelecto/cubevox/docs/specs/2026-11-11-protector-design.md

# Protector

One printed cup of Siraya Tech TPU-GF with two jobs. In use the box stands in it and the cup
lies flat on the desk under the boot. For travel the same cup turns over, side to side, goes
down over the knobs and snaps into the seam between the lid and the dish. The boot, lid and
dish carry no feature for it and do not change (owner 2026-11-11: the boot does not grow).
Supersedes `2026-11-07-protector-design.md` whole.

Heights are given from the desk up, with the boot flat on the desk and the lid face sloping
2 degrees toward Adam. "Above the plate" means measured square to the plate from its inner
face, which is the face the boot's underside lies on.

## Adam's walk

1. In use. The box stands in the cup on the desk. He sees a low tray round the boot whose rim
   stops 13.6 mm above the boot's top edge. The lid and the top of the dish stand clear above
   it. The rear wall is cut away round each jack, the power switch and the USB-C, so all of
   them are open. He plays the knobs and toggles as before.
2. Gig over. He unplugs the leads, holds the cup's side walls and pulls the box up. The boot's
   top edge meets the sloped underside of the two snap ribs, pushes the side walls out 2.25 mm
   and passes. The pull is about 28 N.
   Goes wrong: he lifts the box by the lid only. The cup comes up with it until he holds the
   cup down.
   Goes wrong: he pulls one end only. The box tilts out; the jacks leave through their
   notches, which are open at the rim. Nothing binds.
3. He turns the cup over, side to side, so its notched wall is still at the back where the
   jacks are, and lowers it over the knobs. The ribs meet the lid's top chamfer and ride down
   the lid's side walls, pressed out 0.25 mm. He pushes until the knob tops seat in the 18
   pockets inside the plate (owner 2026-11-11: the plate may rest or be pressed on the knobs;
   tolerated, not wanted). At that depth the ribs drop into the seam and he feels a click.
   Goes wrong: back to front. The closed front wall meets the jacks and stops on them. He
   turns it round.
   Goes wrong: the knob tops land beside the pockets. Each pocket has a 0.8 mm lead-in, so a
   small shift seats them.
   Goes wrong: a knob stands higher than 20 mm. The cup stops short and the ribs rest on the
   lid's wall just above the seam, held by squeeze only.
4. In the bag. The knobs and toggles are under the 3 mm plate, the lid is covered past the
   seam, and the dish shows as a band between the rim and the boot. The rear wall closes the
   space behind the knobs except at its notches. The ribs in the seam hold the cup on.
   Goes wrong: something heavy lands on the bag. The plate presses on 18 knob tops at once.
5. Next gig. He grips the cup's walls and pulls it up off the lid; the ribs click out of the
   seam. He turns it over, sets it on the desk and pushes the box down into it. The boot's
   bottom edge meets the sloped tops of the ribs and passes with about 28 N.

## Numbers from the model and the owner

| Item | Value | Source |
|---|---|---|
| Lid face above the boot's underside | 42.9 mm front, 48.35 mm rear | Fusion `cubevox-enclosure`, 2026-11-11 |
| Boot's top edge above its underside | 22.0 mm all round | Fusion, Boot |
| Boot outer size | 196.0 mm wide (x -5.5 / 190.5), 156.1 mm front to rear, walls square to its underside | Fusion, Boot faces |
| Boot outer corner radius | 8.5 mm | Fusion (6.5 inner plus the 2.0 wall) |
| Boot bottom edge | 1.0 mm chamfer | Fusion |
| Lid and dish walls | x -3.5 / 188.5, front y -148.5, rear y 3.5; square to the lid face; 2.0 mm inside the boot's line per side | Fusion |
| Lid side wall, flat part | z 0.76 to 11.6 (10.8 mm tall); top chamfer 1.25 mm wide, 2.17 mm tall | Fusion, Lid |
| Seam between lid and dish | a rounded groove 1.12 mm tall (z -0.36 to 0.76) and 0.25 mm deep, centred at z 0.2; the lid's bottom edge and the dish's top edge are each rounded about 0.5 mm | Fusion, side wall |
| Lid face | z 13.77 | Fusion |
| Knob | 15 mm across, top 20 mm over the lid face (z 33.77) | owner 2026-11-05 and 2026-11-10 |
| Toggle lever tip | z 25.2 | Fusion |
| Shaft axes (the 6 mm cylinder of each pot and of MENU) | pots x 8.5 + 24 k, k 0 to 7, y -108.5 and -134.5; gain (176.5, -31.5); MENU (117.94, -40.75) | Fusion, 2026-11-11. Earlier figures (y -107.8, -133.8, -30.8) were a detail at the shaft tip, 0.7 mm off the axis |
| Rear openings in the dish and lid, x and height above the boot's underside | 1/4" jack x 13.5 to 23.7; combo jack x 105.1 to 131.5 from 4.6 mm; switch x 141.1 to 157.3 from 26.5 mm; barrel jack x 160.7 to 172.6 from 22.1 mm; USB-C x 52.5 to 65.5 from 35.2 mm | Fusion, rear faces |
| Jacks past the boot's rear wall | 1/4" jack 2.2 mm, combo jack 1.1 mm | Fusion |
| Material | Siraya Tech TPU-GF (Fibreheart TPU-GF, 15 % glass fibre), the owner's 68D; rigid, bends by hand | owner 2026-11-05, 2026-11-11 |
| Material figures | bending modulus 450 MPa (ISO 178), Young's modulus 445 MPa along the layers, Shore 67D, 1.32 g/cm³; no figure across the layers | Siraya Tech data sheet |
| Printer bed | 254 x 254 mm | owner |

## Geometry

1. Plate. 3.0 mm thick, flat on both faces. In use it lies on the desk and the boot's
   underside lies on its inner face. For travel it rests on the knob tops, parallel to the
   lid face.
2. Walls. 2.0 mm thick, square to the plate, on all four sides. Inner faces 0.4 mm outside the
   boot: 196.8 mm wide, 156.9 mm front to rear. Corner radius 8.9 mm inside, 10.9 mm outside,
   concentric with the boot's corners.
3. Depth. 35.6 mm inside, 38.6 mm outside, rim level (owner 2026-11-11: 38.6 is fine). In use
   the rim is 13.6 mm above the boot's top edge and 7.3 mm (front) to 12.75 mm (rear) under
   the lid face. For travel the rim is at z -3.33, 3.5 mm past the seam's centre.
4. Rear wall (owner 2026-11-11: formed round the space the jacks need, close to the DC jack
   and the switch, no sharp corners). Notches open at the rim, given as x across the box and
   floor height above the plate:
   1. 1/4" jack: x 7.6 to 29.6, floor 17 mm. Wide enough for a plug body 20 mm across.
   2. USB-C: x 47.5 to 70.5, floor 31.6 mm. The rim would otherwise stand 0.4 mm over the
      bottom of the lid's USB-C opening and in the way of the plug's body.
   3. Combo jack: x 102 to 134.5, down to a lip 1.5 mm tall.
   4. Switch: x 134.5 to 159, floor 24.5 mm, 2.0 mm under the dish's opening.
   5. Barrel jack: x 159 to 174.6, floor 20.1 mm, 2.0 mm under and beside the dish's opening.
      A plug up to 15 mm across fits.
   Notches 3 to 5 are one opening with a stepped floor. Inside corners are rounded 4 mm and
   outside corners 3 mm; the USB-C notch and the step between the switch and barrel floors
   are rounded 2 mm.
5. Snap ribs. One on each side wall, at mid-length (centred 78.45 mm from the inner front
   face), mirrored left to right. Each is a ridge 40 mm long at its base and 5.7 mm tall at
   its base, with all four flanks at 45 degrees. Its crest stands 2.65 mm from the wall,
   32.07 mm above the plate, and is rounded 0.4 mm. The lid and dish walls are 2.4 mm from the
   cup wall, so the crest reaches 0.25 mm into the seam. The rib's top flank meets the wall
   0.68 mm under the rim.
6. Knob pockets. 18 round pockets inside the plate, 16.0 mm across and 1.5 mm deep, each with
   a 0.8 mm lead-in chamfer, one over each knob and over MENU, placed for the cup turned over.
   For travel the knob tops seat in them and set the cup's place and its depth. In use the
   boot's underside lies flat over them. 1.5 mm of plate is left under each pocket.
7. Plate edge. The outer edge of the plate carries the lid's own chamfer, 1.25 mm wide and
   2.17 mm tall.
8. Rim. 0.5 mm round, inside and outside, carried round every rear notch.
9. Inside corner. 1.5 mm fillet where the walls meet the plate.
10. Outer size. 200.8 x 160.9 x 38.6 mm. Fits the 254 mm bed flat. 136.3 cm³, 180 g.

## What holds it

1. In use. The boot sits under the two ribs, which are 7.2 mm above its top edge. The box
   leaves only when the side walls are pushed out 2.25 mm. The ribs press 0.25 mm on the dish
   and lid walls where they are not over the seam.
2. Travel. Each rib's crest sits in the seam with the wall relaxed, so the hold does not fade
   as the TPU relaxes. The knob tops in their pockets set the depth that puts the crest on
   the seam's centre.
3. Why the ribs are on the solid wall. A cover that clicks onto a box carries its snap on the
   wall and lets the wall flex. At mid-length the 2.0 mm side wall is as soft as a slotted
   finger and strains about 0.7 % when the boot passes, so no slots are needed.
4. Forces, estimates from the data sheet's 450 MPa and the wall taken as a strip fixed at the
   plate. The wall gives about 2.65 N per mm at a rib. The boot pushes each wall out 2.25 mm,
   about 6 N a side, so the box takes about 28 N to push in or pull out. Leaving the seam
   takes 0.25 mm, so the hold for travel is about 4 to 7 N, two to four times the cup's
   weight. The walls bend across the layers, where the data sheet gives no figure.
5. The snap is 0.25 mm, about one layer. The first print's hold could be off by a factor of
   two either way. `snapStand` tunes it.

## Parameters in Fusion

| Name | Value | Sets |
|---|---|---|
| `protPlate` | 3.0 mm | plate thickness |
| `protWall` | 2.0 mm | wall thickness |
| `protClear` | 0.4 mm | air between the walls and the boot |
| `protRearClear` | `protClear` | air between the rear wall and the boot |
| `protDepth` | 35.6 mm | plate inner face to rim |
| `protLip` | 1.5 mm | lip under the combo jack |
| `pocketDia` / `pocketDepth` / `pocketLead` | 16.0 mm / 1.5 mm / 0.8 mm | knob pockets and their lead-in |
| `snapLen` | 40 mm | snap rib length at its base |
| `snapStand` | 2.65 mm | rib crest stand-off from the wall; tunes the snap |
| `snapCrest` | 0.4 mm | flat on the crest before rounding, and the rounding radius |
| `snapCentre` | 32.07 mm | plate inner face to the crest: knob top to seam centre (33.57 mm) less `pocketDepth` |
| `rearJackFloor` | 17 mm | notch floor at the 1/4" jack |
| `rearUsbFloor` | 31.6 mm | notch floor under the USB-C |
| `rearSwitchFloor` / `rearBarrelFloor` | 24.5 mm / 20.1 mm | notch floors under the switch and the barrel jack |
| `rearCorner` / `rearEdge` / `rearStep` | 4 mm / 3 mm / 2 mm | inside, outside and small corner radii of the rear notches |
| `protChamferW` / `protChamferH` | 1.25 mm / 2.17 mm | plate edge chamfer, the lid's |
| `protRim` | 0.5 mm | rim round |
| `protFillet` | 1.5 mm | inside fillet, wall to plate |

`snapCentre` does not follow `pocketDepth` by itself; a change to one needs the other changed.

## Print

1. Siraya Tech TPU-GF, 0.4 mm nozzle, 0.2 mm layers.
2. Plate down on a textured sheet, walls up. The textured face is the travel top.
3. No supports. The face on the bed is flat. Each rib's underside is a 45 degree slope.
4. Plate, walls and ribs are explicit solids. No infill volume.
5. Fit is built for the first print: 0.4 mm air at the boot covers swell. No feature is under
   0.4 mm except the snap's 0.25 mm reach into the seam.

## As built in Fusion

1. Component `Protector` in `cubevox-enclosure`, placed once: `Protector:1`, the cup in use
   under the boot. A second placement of the same cup, turned over on the lid for travel,
   was used for the travel checks below and then deleted with its joint (owner 2026-11-11:
   one Protector in the document).
2. Timeline, 17 items, all healthy: `layout`, `plate`, `walls`, `knob pockets`,
   `pocket leads`, `rear`, `rear notches`, `rear notch corners`, `centre`, `snap`, `snap rib`,
   `snap crest`, `snap rib mirrored`, `plate edge`, `inside fillet`, `rim round`.
3. Three sketches, all fully constrained: `layout` on the boot's underside face (the boot's
   walls projected, the cup's outline, the 18 pockets), `rear` on the rear wall's outer face
   (the notches), `snap` on a side wall's inner face (one rib's base).
4. One construction plane, `centre`, midway between the side walls, used to mirror the rib.
5. Checks, by intersecting the bodies, 2026-11-11. In use: 0.08 mm³ film with the boot;
   1.8 mm³ with the dish and 2.1 mm³ with the lid, all at the two ribs, 0.25 mm deep. Travel:
   the two rib crests touch the dish's top edge and the lid's bottom edge with no measurable
   overlap; nothing with the boot. Neither position touches any of the 122 bodies on the
   board. The knobs are not in the model. The 18 pockets are placed on the 18 shaft axes;
   measured in the travel cup, the largest pocket-to-shaft offset is 0.0 mm.
6. Travel placement, measured before it was deleted: plate inner face z 32.27, pocket floors z 33.77 (the knob
   tops), rim z -3.33.
7. STL at `hardware/exports/protector.stl`, in the model's frame (the plate is 2 degrees off
   level; the slicer lays it on the plate).
8. Renders looked at: `build/protector-proofs/G-1` (in use, rear), `G-3` (rib), `G-4` and
   `G-7` (travel).

## Decisions

1. No change to the boot, lid or dish (owner 2026-11-11). Windows in the boot cannot be
   reached: a cup this shallow ends above the boot when it is over the knobs.
2. Plate flat on the desk in use; its slope for travel does not matter (owner 2026-11-11).
3. Nothing covers the jacks or switches in use (owner 2026-11-11). First built with the whole
   rear open; the owner then asked for a rear wall formed round the space the jacks need.
4. Height. The owner chose a low cup ("35 seems fine"), then 36.5 mm, then 38.6 mm so the
   ribs have room for a 45 degree lead under the rim (2026-11-11).
5. The plate rests on the knobs for travel (owner 2026-11-11). No stop on the box.
6. The hold is a snap into the seam (owner 2026-11-11: the cup can grab it). An earlier line
   here said the seam was too shallow to catch; that was wrong.
7. No squeeze pads and no fingers. Pads that gripped the lid by friction had to be pushed out
   3.0 mm by the boot, because the boot is 2.0 mm wider per side than the lid. Built on
   slotted fingers they gave about 3.5 N of hold for about 60 N of push and pull, stayed bent
   in both positions, and put eight slots in the side walls. The owner dropped them
   (2026-11-11). A snap gives more hold for less push because it holds by its shape.
8. No underside relief (owner 2026-11-11). That face lies on the bed, so a recess in it has
   nothing under it and cannot print cleanly. A flush two-colour inlay in that face is still
   open; it is the owner's taste.
9. Other approaches were weighed on 2026-11-11. A cover fitted to the lid that the box stands
   on in use (proof P3) was set aside: the protector is stashed nested, with the box in it.
   A second loose part is out (owner). A stepped cup and a tall cup that reaches the boot
   were set aside for their height.

## Status

Written 2026-11-11 from the owner's words and the Fusion model, and rewritten the same day to
match the model after the owner's choices: formed rear wall, no fingers, snap into the seam,
38.6 mm. Built. The Fusion document is not saved. The walk above was checked against the
model's numbers; no separate UX audit was run on this last form.
