peterdelecto/cubevox/docs/specs/2026-10-30-output-safety-design.md

# cubevox — six small firmware additions: slot crossfade, Octave's DC blocker, ceiling order, late blocks, brownout, power-on

Owner list 2026-10-30, after board 1's first week on the bench. Six changes to how the box
treats the edges of its signal path: a toggle flip, a block that runs late, the rails going
down, the rails coming up. Each is small and gets its own host test where the host can reach it.

## 1. Slot toggle crossfade
Today a slot's bypass toggle switches the slot's output hard between the engine and the dry
copy, which clicks on a loud note. Now the flip crossfades over 8 ms (6 blocks of 64 samples),
on an S curve (`3x^2 - 2x^3` of the fade's progress for the engine, the rest for the dry copy, so
the two gains sum to 1 and a card whose output carries its input holds its level; `mixSlotFade`
in `core/chain_run`).
During the fade the engine runs and both paths mix; at the end of a fade out the engine stops
running (no CPU for a bypassed slot, as today); on a fade in the engine is cleared first, so a
re-engaged reverb or delay starts from silence and not from a tail it held while bypassed. A
flip during a fade turns the fade round from where it is. The per-slot fade level lives in the
audio interrupt's state, advanced per block; the main loop only publishes the toggle. Host test:
`core_chain_run` drives a slot flip on a steady tone and checks the output has no step larger
than the fade allows, that both gains read 0.5 at the midpoint, that the engine runs
for exactly the fade blocks after a flip to off, and that a flip back on starts from a cleared
engine.

## 2. DC blocker after Octave
Octave's granular shifter can carry a DC offset into the compressor, which then pumps on it. It
gets a one-pole high-pass at 5 Hz on its output, inside the engine header (`engine/octave.h`) so
the emulator and `cubevox-render` carry it too. Distortion keeps its own at 10 Hz. Host tests: the
engine's test feeds a 0.5 DC step and checks the output settles under -60 dBFS within 200 ms, and
a 100 Hz tone passes within 0.05 dB; the level rule rows stay within their bands.

The reverb had the same blocker until the 2026-11-02 Spring fix pass. The owner said "we can
remove the dc blocker if it does nothing", so it was measured first. A 0.5 DC step leaves the wet
mean at -129 to -145 dBFS on Spring and -141 to -164 dBFS on Chasm (TIME 0 / 50 / 100 %), and
with Distortion at 100 % ahead of it the DC the blocker took out sat at -104 to -149 dBFS on
Adam's clips. The blocker went; `reverb_clean_test` holds the wet mean under -90 dBFS.

## 3. Soft ceiling ahead of the output trim
Today the output stage applies the trim and then the ceiling, `softCeiling(a[i] * gain)`. With
MIC's -30 dB trim the ceiling never touches the signal, so a clipped chain reaches the DAC at
-30 dB with its clip intact. Now the ceiling shapes the full-scale signal first and the trim
scales the result, `softCeiling(a[i]) * gain`; the clamp stays after both. LINE (0 dB) is
unchanged bit for bit. Host test in the output stage's test: a 0 dBFS square through MIC lands at
the ceiling's shoulder times the trim, and LINE output equals today's.

## 4. A late block passes the dry input
Today a block past its 640 000-cycle budget is counted and everything keeps running, so the
next block starts late too and the DMA can overrun. Now a late block sets a flag; the next block
skips the chain and passes the dry input (through the output stage as BYPASS does, with the
gain ramp and the ceiling), clears the flag, and counts `dry_blocks`. The engines' state goes
one block stale, which is inaudible against the overrun it prevents. `dry_blocks` joins the
status reply beside `late`, and the boot report's audio line prints it. Host test in `core_load`
or `core_chain_run`: with the late flag raised the next block's output equals the dry input
through the output stage, the counter reads 1, and the block after runs the chain.

## 5. Brownout drops the mute relay at once
Today the mute on power loss waits for the main loop to read 5VA on VA_SENSE and trip under
4.75 V. The H7's programmable voltage detector (PVD) on VDD, level 6 (2.85 V, the highest internal
step on the H743; level 7 selects the external PVD_IN pin, as built 2026-10-30), raises
EXTI line 16; its interrupt pulls MUTE_N low in the first instruction, writes the mute
holder flag the main loop already honours (`power_trips`), and returns. The main loop then
runs the ordinary power-fail path (XSMT low, hold, release after 5VA recovers) as today. The
PVD interrupt sits at a priority above the audio block (priority 1) so it runs inside a block.
No host test; the firmware builds through the warn gate, and bench 1 below shows it on the
board.

## 6. Power-on mute order
Today the mute release is MUTE_N high, 20 ms for the relay, then XSMT high, so the DAC's
unmute step reaches the output after the relay has closed, and the relay closes 500 ms after
the SAI clocks start, 2 to 3 s after power-on.

The pop at power-on (owner 2026-10-30, "is it possible to close the relay so that no pop?") has
two parts. The output buffer sits at its bias and feeds the jack through C 10 µF with R 100 kΩ
to ground on the jack side (hardware spec item 9), a 1 s time constant: at power-on the jack
side of the cap jumps to the bias and decays toward zero, and reaches 10 mV only after about
5.5 s. Closing the relay earlier puts the remainder on the tip. The second part is whatever
signal the chain is passing at the instant the contacts meet.

Now the release from power-on is: XSMT high as soon as the SAI runs, into the grounded tip;
the chain's output held at digital zero (the layout fade's zero point, `core/layout_fade`);
MUTE_N high no earlier than 6.0 s after the app started (`kRelayCloseAfterPowerOnMs = 6000`,
counted from `setup()`; the bootloader's time is not counted, so the cap has had longer); then
20 ms for the relay; then the output fades up over the fade's 50 ms. A release after a wanted
mute (the MUTE toggle, a jack change) keeps the same order without the 6 s wait: XSMT high,
output at zero, MUTE_N high, 20 ms, fade up. The mute order stays XSMT low, 5 ms, MUTE_N low,
so a wanted mute has no relay click. The 500 ms hold after the SAI clocks start is subsumed.

The face shows the splash through the power-on wait (owner 2026-11-10). `MuteSequence::powerOnWait()`
is true from reset until the sequence is Unmuted, or until 6.0 s have passed with something else
(the toggle, a hold, a latch, a trip, clocks not running) keeping the output muted. The splash
stays up while it is true, so MUTED shows only for the MUTE toggle or a fault.

Host test in the mute sequence's test: the power-on release steps in this order with the
6.0 s wait and the fade after the relay, the later releases without the wait, the mute steps
unchanged. The emulator is unaffected.

Board, next revision (not this change): R on the jack side of the output cap 100 kΩ → 10 kΩ,
time constant 0.1 s, settled in 0.6 s; the OPA2197 drives 10 kΩ in parallel with the PA's input
without strain. The firmware wait then drops to 1 s.

## Costs and budget
Items 1 and 2 add work: six blocks of double running per flipped slot (bounded, not steady), and
one one-pole filter per block (two until the reverb's came out on 2026-11-02). No `costs.h` card row changes by more than a point; the agent
measures with the host bench method in `costs.h` and says what moved.

## Bench (owner)
1. Brownout: 9 V pulled with the box singing; the relay opens before any thump reaches the PA.
2. Power-on: no pop at the PA on the slide switch.
3. A slot toggle flipped on a held note: no click.
4. MIC output with Distortion at full DRIVE: no square edge at the DAC.
