peterdelecto/cubevox/docs/specs/2026-10-31-crowd-design.md

# cubevox — Crowd card, Mob on the box (eight copies of the lead, DIVERGE and VOICES)

Date 2026-10-31. Owner design in chat 2026-10-31 and 2026-11-01; this file is the implementation
reference. The first part states the card as it is at v2.00.79. The log at the end records how it got
there, with the commit that holds each thing that was built and then removed.

Name (owner 2026-11-01): the card is **Mob**; the menu and readout show MOB, in capitals like every menu value (owner 2026-11-02). The registry's display name is Mob from
v2.00.82; the card id `crowd`, the engine, the cost row and the file names keep the old name until
a rename pass. The menu row after REVERB swaps the slot that holds Unison or Mob between the two
(`2026-10-24-polish-design.md`, menu section). Board bench 2026-11-01 (bench image with Adam's
5.5 s clip, knobs at top, all slots on, two runs of 24 s): Mob in slot 3 of the crowd bench layout
78.7k cycles mean (12.3 %), lowest worst block 94.97k (14.8 %), second run worst 101.0k; Octave's
slot carried the tracker at 47.5k; zero late, overrun or dry blocks. The stress run of the same
day (`2026-11-01-stress-bench-design.md`, all slots forced on, knobs at top then WIDTH and VOICES
swept) put the lowest run worst at 15.6 % in the default layout with Mob for Unison and 15.9 %
with Chasm as well, so the row is `kCrowd{13, 16, true}` from v2.00.83: mean from knobs at top,
worst from the sweeps. That layout sums to 72 % mean and 84 % worst against the 75 / 95 lines,
and the menu's swap to Mob goes through.

## Purpose

Adam sings in a speaky, near-monotone style, so effects that need a key do not serve him. The Crowd
card makes a crowd out of his own voice: up to eight copies, each another person, saying his lines a
little after him. Four are the tuned copies the tuning lists; each has a raised copy that shares its
throat, tone shelf and contour, sits 1.75 st higher and comes 75 ms later, with its own scatter and
drift (owner 2026-11-01). Owner 2026-10-31: "we are supposed to be offsetting by a few semitones and
formants to give the effect of the voice belonging to a totally different person. then we use a
little lfo or delay to make it sound like it's not the same performance." Each copy has a pitch
offset of a few semitones, a formant offset (a throat), its own tone shelf, and its own lag behind
the lead, so it is another performance. The crowd as a whole has a fixed low cut. The card never
reads the key. It reads the pitch period from the tracker Autotune uses.

The card cuts on one pitch, between about 70 Hz and 1 kHz, so a single melodic line works through it
and a chord does not. The bottom tenth of WIDTH keeps that line in tune (WIDTH law below). Outside
the tracker's range the copies fall back to plain delayed doubles (Per-voice chain, item 4).

## Rule (owner 2026-10-31)

"They need to sound like actual people though. Not an alien, not a cartoon." Every move a copy makes
stays inside what a human voice does. Copies read as people inside about ±5 semitones of pitch and
±3 semitones of formant, paired the natural way, the lower pitch with the longer throat. Timing
scatter stays under about 25 ms, pitch drift under about 30 cents and loudness scatter under 4 dB.
The engine clamps every tuning value to its range, and the render tool refuses a value outside it.

## Decisions (owner 2026-10-31)

1. A new library card and its own effect, id `crowd`, name Crowd. It is not a replacement for
   Unison and is not compared against it. Which slot it takes is a layout decision for the owner;
   the default layout does not hold it. Owner 2026-11-01: a layout would hold Crowd or Unison, not
   both; whether Crowd takes Unison's place in the default layout waits on the board bench (CPU and
   memory below).
2. Lower pot VOICES, the amount knob. 0 is dry. The copies fade in one pair at a time, a tuned copy
   with its raised copy, then the lead fades out, so the top of the knob is the crowd alone. Owner:
   "if the effect is dimed, we don't hear Adam, we hear the crowd." The lead leaves from 80 % of the
   knob, so each pair owns a round fifth of the travel and the percent readout tells the count (20 %
   one pair, 40 % two, 60 % three, 80 % all eight). The owner tuned on 80 % all day.
   Superseded 2026-11-01 (owner: "0 - 8 - MOB"): VOICES is a stepped knob of ten positions, 0 to 8
   copies one at a time, then MOB with the lead gone; the readout shows the count, or MOB. The
   stepped law is under "VOICES law" below.
3. Upper pot DIVERGE, named WIDTH until 2026-11-01 (owner: "width should possibly be called
   DIVERGE"; WIDTH suggested stereo, and the knob moves the copies away from the lead). It spreads the copies' pitch and formant offsets and stretches their lags, so
   the bottom is eight plain delayed doubles of the lead on its own pitch and the top is the crowd at
   its full offsets and longest lags. Owner: "nix the distance knob and replace it with a 'width
   knob'. the width knob will spread the voices." The bottom tenth is for instruments and melodic
   lines. At the top the pitch offsets reach two thirds of their listed values: "width shouldn't
   cause so much variation in pitch. cut its extremity by 1/3 at its max."
4. The tracker runs whenever the Crowd card is on. Autotune is not expected on with this card, and
   the card needs neither Autotune's tracker precision nor exact timing (owner 2026-10-31), so the
   tracker skips its fine pass while Autotune is off.
5. The copies read the pitch front end's ring, the voice as Autotune left it, and add Autotune's
   correction to their ratio, as Octave does. Octave's wet is not doubled.
6. Eight copies (owner 2026-11-01: "go but we need to make sure that it is cpu efficient"; "for the
   4 new voices, lag them all by an additional 75 ms"). Copy v + 4 is tuned copy v raised 1.75 st
   (`kRaisedSt`) and lagged 75 ms more (`kRaisedLagMs`), with its own scatter and drift seeds; every
   copy carries the four-copy gain over √2 (`kCopyGain`), so the crowd's power at each VOICES
   position is the four-copy card's. With the listed offsets the raised copy of copy 0 (−1.75 st)
   sits on the lead's pitch and the raised copy of copy 3 (+1 st) sits on copy 1's (+2.75 st); the
   owner heard both and kept 1.75 st. The ring grows to 225 ms (`kCrowdMaxLagMs`), 51,024 B, for
   a raised copy 75 ms behind a tuned copy at the 150 ms ceiling.
6. The defaults are the owner's working set, tuned by ear in the emulator on 2026-10-31 (Interface
   below). The firmware never sets the tuning; the box runs the struct's defaults.

## Panel

| Pot | Name | Kind | Readout |
|---|---|---|---|
| upper (knob A) | DIVERGE | continuous, 0..100 % | `DIVERGE 35 %` |
| lower (knob B) | VOICES | stepped, 10 positions | `VOICES 3`, `VOICES MOB` |

Card id `crowd`, name `Mob` on the box, Group Pitch, Engine Crowd. DIVERGE is the registry's percent
knob with no decimals. VOICES is a stepped knob with named positions, as Autotune's KEY is: `0` to
`8`, then `MOB` (owner 2026-11-01).

### VOICES law, position k in 0..9 (2026-11-01)

1. Position k in 0..8 has exactly k copies in and the lead playing; position 9, MOB, has all eight
   in and the lead gone. 0 is Adam alone, the same sound as the toggle off, with the tracker
   running so the first copy enters clean.
2. Copies enter one at a time, each tuned copy followed by its own raised partner: tuned 0, raised
   4, tuned 1, raised 5, tuned 2, raised 6, tuned 3, raised 7. A copy not in is silent and does
   not tick.
3. Total power is unity at every position. The copies keep the fixed gain g of the earlier law; the
   lead gain is sqrt(1 − Σ g²) over the copies in, never below 0. At MOB the lead is 0 and the
   eight copies are scaled together to unity power, as span B's top was.
4. A step change glides on the engine's existing per-sample gain ramps, so a copy entering or
   leaving and the lead moving take the fade they took before; nothing clicks.
5. The engine takes the position as `voicesStep` (0..9), not a float. `solo` is unchanged.

### VOICES law until 2026-11-01, knob position k in 0..1 (superseded)

1. Span A, k in [0, 0.8]. u = k / 0.2 runs 0..4. Pair v (0..3, fade order below), tuned copy v and
   raised copy v + 4, has weight w_v = sin(π/2 · clamp01((u − v) / holdFrom)). Each pair fades in
   over the first three quarters of its fifth and holds for the last quarter.
2. Span B, k in (0.8, 1]. s = (k − 0.8) / 0.2. Every w_v = 1. Crowd power rises from P_8 to 1 and
   the lead falls to 0.
3. Level law at every k. Each copy carries the fixed gain g = 10^(voiceDb / 20) / √2 (`kCopyGain`);
   with voiceDb −9 dB eight copies sum to the power P_8 = 8 g² ≈ 0.50, the four-copy card's. Crowd
   power is P = Σ (g w_v)² over the eight in span A and P = P_8 + (1 − P_8) · sin²(π/2 · s) in
   span B. The lead gain is sqrt(1 − P). The crowd multiplier is sqrt(P / Σ (g w_v)²), which is 1 in
   span A and reaches sqrt(1 / P_8) at the top, so each copy goes from −12 dB to −9 dB there. Total
   power is unity at every k. The trim (Output below) takes up the residue level_test measures on
   the program.
4. Fade order, low, high, low, high, by tuned copy index (listed pitch, throat, delay before the lag
   law): 0 (−1.75 st, −1.75 st, 40 ms), 1 (+2.75 st, −1 st, 100 ms), 2 (−2.5 st, −1 st, 70 ms),
   3 (+1 st, −1.5 st, 75 ms); each brings its raised copy (its pitch + 1.75 st, its delay + 75 ms).
   One pair is a second singer with a higher shadow, two pairs a group, four pairs the crowd.
5. The law runs when VOICES, the solo or its tuning moves. Gains ramp per sample across the block, as
   Octave and the reverb MIX do. A copy whose ramped gain sits at 0 is reset and does not tick, so one
   pair costs a quarter of eight plus the fixed part. The live copies render first and mix four at
   a time, the crowd sum and both shelf sums held in registers.
6. Solo, `CrowdParams::solo`, a bit per copy, is an emulator tuning hook. A soloed copy sits fully
   faded in and the others are silent whatever VOICES says; the lead follows from the soloed power.
   The firmware never sets it.

### WIDTH law, knob w in 0..1

Owner 2026-10-31: "from about 0 to 10 percent, we need much less detuning. for a melodic line, should
the user want to pipe an instrument through that effect, we don't want it to be out of tune." After a
piano loop through the bottom tenth sounded discordant: "we might want to start with a baseline of
0 st per voice and maybe even 0 formant at 0 on the width slider." On the top: "at max width, add a
little bit more time spread between voices, maybe adding 20 ms to the max."

WIDTH scales the pitch offset, the formant offset, the drift and the contour of every copy, and it
stretches the lags. One shape f(w) is linear between three points. The formant offsets take f(w)
whole. The pitch offsets, the drift and the contour deviation take fp(w) = f(w) × 2/3, the constant
`kWidthPitchTop` in `engine/crowd.h`. Per copy and per block, copy v's pitch offset in semitones is
pitchSt[v] × fp(w) and its formant offset is formantSt[v] × f(w).

| Point | f (formant factor) | fp (pitch, drift and contour factor) |
|---|---|---|
| w = 0 | 0 | 0 |
| w = `widthKnee` (0.1) | `widthKneeFrac` (0.012) | 0.008 |
| w = 1 | 1 | 2/3 (0.667) |

Between the points f is linear in w, so f(0.5) = 0.451 and fp(0.5) = 0.301. At w = 0 f is exactly
0, so every copy sits at pitch ratio exactly 1 with a grain playback rate of exactly 1, and the
cutting returns the input delayed by the copy's lag (the WIDTH 0 is a delay test). A melodic line or
an instrument gets eight plain delayed doubles on its own pitch. At w = 0.1 the −2.5 st copy sits
2.0 cents off the lead and carries 1.2 % of its formant move. At w = 1 every copy sits at two thirds
of pitchSt[v] (−1.167, +1.833, −1.667 and +0.667 st) and at the whole of formantSt[v]. A pitchSt or
formantSt of 0 stays 0. The w the factor reads follows the knob through the 20 ms one-pole of
`engine/smooth.h`, updated per block, so a knob step glides the copies over a few blocks. It takes
the knob value outright on the first block after a reset, and a settled w equals the knob bit for
bit. `widthKnee` is clamped to 0.02..0.9 and `widthKneeFrac` to 0..1.

1. Drift follows fp. The drift range in cents is driftCents × fp(w): 0 at w = 0, 0.12 cents at the
   knee and two thirds of driftCents (10 cents at the default 15) at w = 1.
2. Contour follows fp. The contour a copy uses is 1 + (contour[v] − 1) × fp(w): exactly 1.0 at
   w = 0, within 0.5 % of 1.0 at the knee and 1 + (contour[v] − 1) × 2/3 at w = 1.
3. Timing scatter, loudness scatter, the tone shelves, VOICES and solo do not follow the knob.
4. The trim follows f (Output below), so the level holds at every WIDTH position.

Lag multiplier. WIDTH also moves every lag by one multiplier m(w), linear in w. m(0) is
`widthLagBottom` (0.5). m(1) is 1 + `widthLagMs` / L, where L is the longest delayMs[v] × `lagScale`
(120 ms at the defaults) and `widthLagMs` is 20 ms, so the longest copy sits 20 ms further back at
w = 1 than `lagScale` alone puts it and the others sit further back in proportion. At the defaults
m(1) = 1.1667 and m reaches 1 at w = 0.75. The lags are 24, 60, 42 and 45 ms at WIDTH 0 and 56, 140,
98 and 105 ms at WIDTH 1. m reads the knob value, not the smoothed w, so the target steps with the
knob and each copy takes the new lag at its next gap (Lag law below). `widthLagBottom` is clamped to
0.2..1 and `widthLagMs` to 0..60.

### Lag law

Tuned copy v's lag target is delayMs[v] × `lagScale` (1.2) × m(w), capped at `maxLagMs` (150 ms)
and floored at the voice's own minimum (1.5 periods plus 4 samples, 21.5 ms at the lowest period).
Raised copy v + 4's target is tuned copy v's target plus 75 ms (`kRaisedLagMs`), before scatter,
capped at `kCrowdMaxLagMs` (225 ms), the lag the ring was sized for. Only WIDTH moves them.

A copy changes its lag only in a gap. Each block it measures the mean square of the ring at its read
point (the block's samples `lag` behind the head). While a new target is pending (a tuning move, a
WIDTH move, or a fresh scatter draw), the copy counts the blocks in which the ring is under the gap
floor both at the lag it plays and at the lag it would move to. After two such blocks it takes the
new lag at once by resetting its grain marks there, and the grains in flight finish. The jump then
replays or skips only quiet material, so a copy never bends in pitch mid-word. The first lag after a
reset or a fade-in lands at once. A gap shorter than the move (the distance between the two read
points) never admits the move, so a large lag step waits for a long pause.

The gap floor follows the signal. It sits 20 dB (`kGapUnderPhraseDb`) under the recent phrase level
and never under `gapFloorDb` (−50 dBFS), so lags land between phrases over a stage's noise floor as
well as over silence. The phrase level is the loudest mean square the copies read at their lags for
the gap test, through a one-pole that rises in 50 ms and falls in 1 s, so it holds a phrase's level
through the gap after it and costs no reading of its own. A gap ends once the copy's read point
sounds 6 dB over the floor (`kGapRearm`, a power ratio of 4), so noise wandering about the floor
inside one pause counts as one gap and draws once. On Adam's clips each copy lands about three or
four times a second; on the test program, which has two gaps a second over a −40 dBFS floor, once
per gap.

Scatter. With `scatterMs` above 0, each gap gives the copy a fresh uniform random offset in
[−scatterMs, +scatterMs] on top of its target, drawn from a per-copy xorshift32 seeded at reset, so
a run repeats. The copy takes one offset per gap.

Pitch drift. With `driftCents` above 0, each copy holds a drift in cents that walks inside
[−driftCents × fp(w), +driftCents × fp(w)]. A new random target comes every `driftHoldS` (2 s) and
the drift slews toward it with a time constant of 1 s, updated per block. The pitch ratio gains the
term 2^(drift / 1200) through exp2Fast. With `driftCents` at 0 the term is exactly 0.

Filter coefficients update per block at most, and only when the tuning moves.

## Engine `engine/crowd.h`

### Interface

```
namespace cv {
struct CrowdTuning {
  std::array<float, 4> pitchSt   = {-1.75f, 2.75f, -2.5f, 1.0f};    // offset before the WIDTH pitch top (2/3 sounds at WIDTH 1)
  std::array<float, 4> formantSt = {-1.75f, -1.0f, -1.0f, -1.5f};   // grain playback rate 2^(st / 12) at WIDTH 1
  std::array<float, 4> shelfDb   = {-3.0f, -4.0f, 3.0f, 5.0f};      // high shelf gain above shelfHz
  std::array<float, 4> delayMs   = {40.0f, 100.0f, 70.0f, 75.0f};   // lag behind the lead before lagScale
  float lagScale     = 1.2f;      // a copy's lag is delayMs times this times the WIDTH multiplier
  float shelfHz      = 2500.0f;
  float voiceDb      = -9.0f;     // a tuned copy and its raised copy together against the lead at unity
  float trimDb       = 2.1f;      // level rule residue at WIDTH 1
  float trimBottomDb = 0.7f;      // the same at WIDTH 0; between, the trim follows f(w)
  float leadFadeFrom = 0.8f;      // VOICES position where the lead starts to leave
  float holdFrom     = 0.75f;     // part of each copy's fifth spent fading; the rest holds
  float hpHz         = 120.0f;    // low cut on the crowd sum
  float maxLagMs     = 150.0f;    // ceiling on a copy's lag before scatter, up to kCrowdMaxLagMs
  float gapFloorDb   = -50.0f;    // the gap floor never sits under this
  float scatterMs    = 12.0f;     // peak random lag offset taken at each gap, 0..30
  float driftCents   = 15.0f;     // peak of each copy's slow random pitch walk, 0..50
  float driftHoldS   = 2.0f;      // time between new drift targets
  float widthKnee    = 0.1f;      // WIDTH where f reaches widthKneeFrac, 0.02..0.9
  float widthKneeFrac = 0.012f;   // f at the knee, 0..1 (f is 0 at WIDTH 0)
  float widthLagBottom = 0.5f;    // lag multiplier at WIDTH 0, 0.2..1
  float widthLagMs   = 20.0f;     // the longest lag grows by this at WIDTH 1, 0..60 ms
  float levelScatterDb = 2.0f;    // each copy takes a new loudness at every gap, uniform in +- this, 0..4 dB
  std::array<float, 4> contour = {0.8f, 1.2f, 0.7f, 1.1f};  // share of Adam's pitch deviation a copy follows, 0.6..1.4
};
struct CrowdParams {
  bool on = false;
  float width  = 1.0f;   // knob A, 0..1
  float voices = 0.5f;   // knob B, 0..1
  CrowdTuning tuning;
  uint8_t solo = 0;      // a bit per copy; an emulator tuning hook, never set by the firmware
};
class Crowd {
 public:
  void reset();
  // in is this slot's input, the lead. pitch has already run this block, so the block's
  // samples sit at ring index head() - n + i.
  void process(const float* in, float* out, int n, const CrowdParams& p, const PitchFx& pitch);
};
}
```

Off: out equals in bit for bit. The engine's clamps and the render tool's checks share one set of
constants in `crowd_detail`: offsets ±12 st (`kMaxOffsetSt`), shelf ±12 dB (`kMaxShelfDb`), delays
5..150 ms, scatter 0..12 ms (`kMaxScatterMs`, the ring's allowance `kCrowdScatterMs`, so the longest
lag never shortens at the ring's ceiling; a `static_assert` holds the shipped scatter inside it),
drift 0..50 cents (`kMaxDriftCents`), voiceDb −24..0,
both trims ±12 dB, lagScale 0.5..2, shelfHz and hpHz 20..21,600 Hz.

Constants in `crowd_detail`: `kVoices` 4 (the tuned copies, one per entry of the tuning's arrays),
`kCopies` 8 (the tuned copies, then the raised copies; copy v + 4 reads tuned copy v's entries),
`kRaisedSt` 1.75 (added to pitchSt[v] before the WIDTH pitch scaling), `kRaisedLagMs` 75 (added to
the tuned copy's lag target before scatter), `kCopyGain` 1/√2.

### Per-voice chain

ring → voice (PSOLA grains at playback rate f_v, pitch ratio r_v, read delay D_v) → × g w_v → crowd
sum, with the four tone shelves as one shared filter on weighted sums.

1. Voice. A PSOLA voice with a grain playback rate, in crowd.h. Grain length 2p, Hann from a
   1,025-entry table of 1 − cos(2πk/1024) built at compile time and read through a 32-bit turn
   counter with interpolation between entries, launch interval p / r_v, grain duration 2p / f_v, a
   per-sample read at a fractional delay that moves by (1 − f_v) per sample, grain gain
   f_v · 2 / (len / p) / r_v. Reads are linear, two taps. Grains sit on the period grid, as
   Autotune's `PsolaVoice` does. The launch search jumps from launch to launch rather than stepping
   every sample, and each grain's run splits once at the ring seam, so the per-sample loop carries
   no wrap test. A voice that starts with no grain in flight lays its first grain one output period
   older, so its overlap sums to one from the first sample.
2. Read delay D_v is the copy's adopted lag in samples (Lag law), a per-voice member set per block.
   The voice clamps it to at least 1.5 × the clamped period + 4 and at most the ring less the
   longest grain less the call's n (kBlock when the call is shorter), so a grain never reads the
   samples the pitch stage wrote this call in place of the oldest. The ring is 12,756 samples,
   265.75 ms (`kVoiceRingLen` in `psola.h`): the 225 ms lag ceiling of a raised copy, 12 ms of
   scatter and the longest grain. Autotune reads under 2,100 samples back and Octave under 3,850.
3. Ratio r_v = 2^(pitchSt[v] · fp(w) / 12) · 2^(drift_v / 1200) · 2^((contour_v − 1) · dev)
   · 2^(pitch.correctionSemis() / 12), where dev is Adam's deviation from his running mean pitch in
   octaves (Contour below), and the grain playback rate is 2^(formantSt[v] · f(w) / 12). The voice
   clamps the ratio to 0.5..2.0.
4. Period from `pitch.pitch().period`. The card holds the tracker's last nonzero period through its
   own ramp out, so switching the card off never drops a grain at the block edge. Until the tracker
   has given a period the plan holds the lead at 1 and the copies at 0. Unvoiced frames keep the
   last period. After an unvoiced run as long as the copy's own reach (its lag ceiling plus scatter:
   162 ms for a tuned copy, 237 ms for a raised one, so the copy has read past the last voiced
   sample), or while the tracker flags the note outside its 70 Hz to 1 kHz range
   (`PitchResult::outOfRange`: a dip below its lowest lag or off its slow end), the copy's pitch and
   formant moves glide to 0 through the 20 ms one-pole. Ratio and rate are then exactly 1,
   the WIDTH 0 path, exact at any period; they glide back when the note returns.
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
