peterdelecto/cubevox/docs/specs/2026-11-01-bloom-design.md

# Bloom card: each word restates itself as it dies

Owner 2026-11-01: "let's also adapt the 'bloom' effect from drumsynth as a possible effect for slot
7", with DrumSynthV3's BLOOM technical spec (D2, R10, code at a4149ed) pasted in. Offered for slot 7
in place of Gate, through the slot 7 row (`2026-11-01-slot-7-choices-design.md`).
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
