peterdelecto/cubevox/hardware/renders/enclosure-closure-section.png

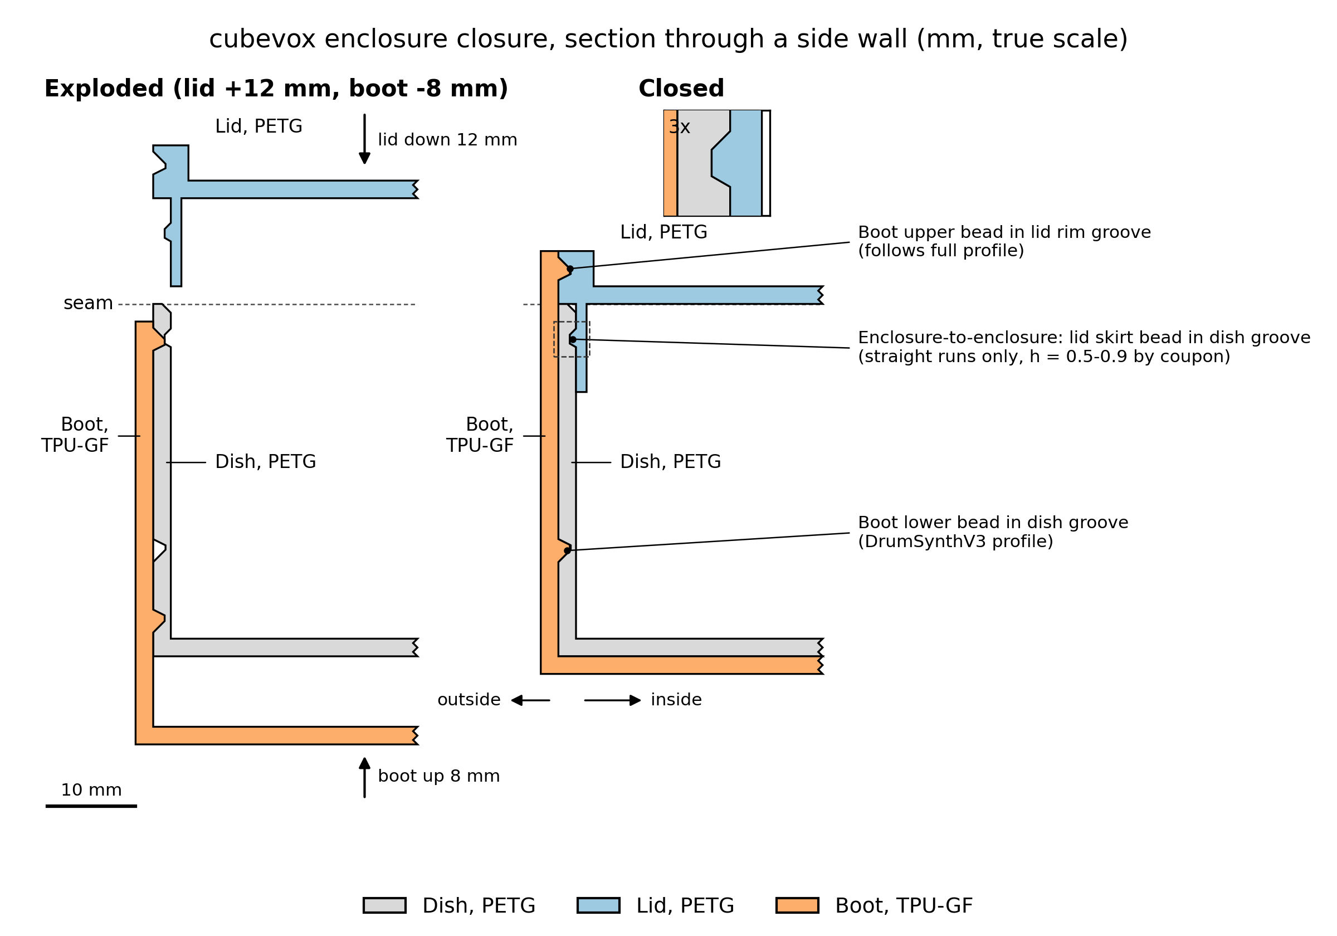
hardware/renders/enclosure-closure-section.png
