peterdelecto/cubevox/hardware/exports/protector.stl

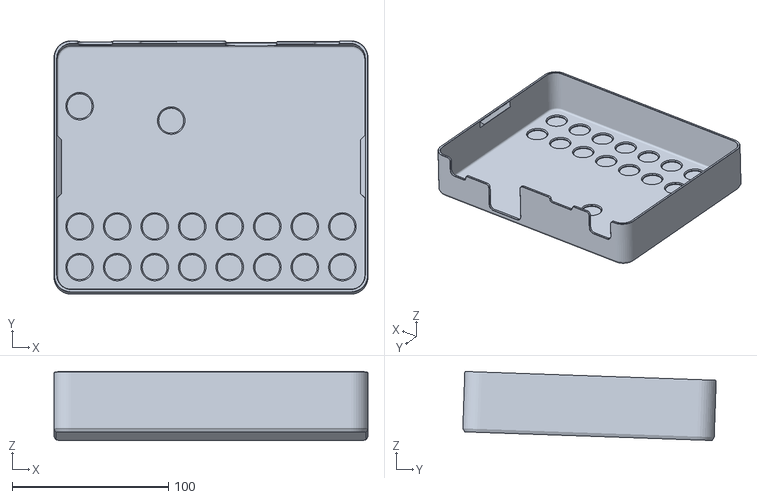
[picture p2: CAD file, 2026-11-11]
hardware/exports/protector.stl
200.8 x 162.0 x 44.1
