peterdelecto/cubevox/hardware/renders/cubevox-panel-parts.step

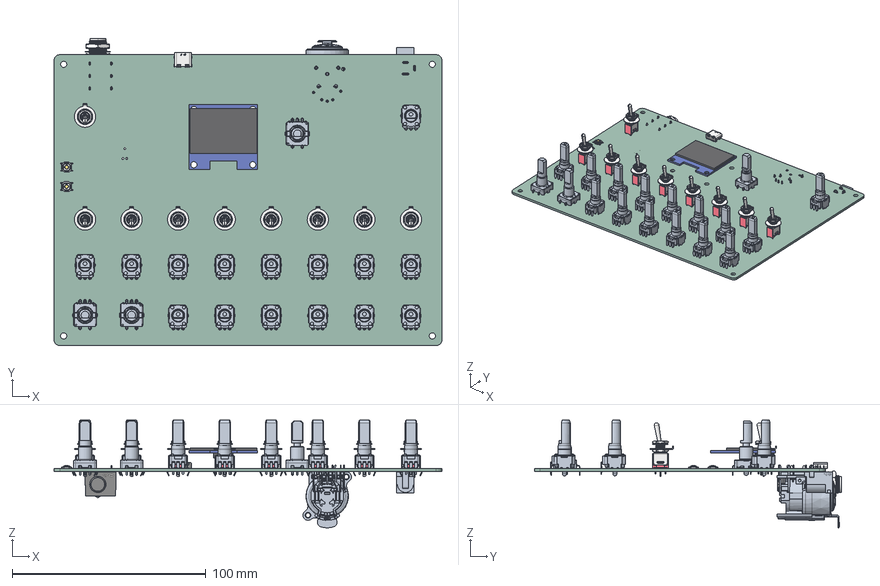
[picture p3: CAD file, 2026-10-06]
hardware/renders/cubevox-panel-parts.step
200.0 x 158.4 x 55.6 mm
零件10 x 9
module_pcb
glass
header_body
pins
USB-C-SMD_TYPE-C16PIN
SW-SMD_4P-L5.1-W5.1-P3.70-LS6.5-TL_H1.5 x 2
AUDIO-TH_PJ-611E_1
cubevox_PCB
