peterdelecto/cubevox/hardware/exports/solder-jig.stl

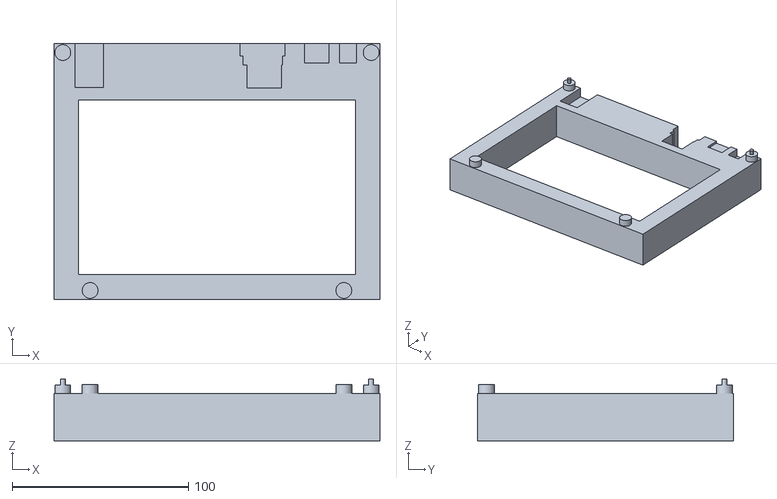
[picture p4: CAD file, 2026-10-24]
hardware/exports/solder-jig.stl
185.0 x 145.0 x 35.0
