peterdelecto/cubevox/hardware/exports/cubevox-enclosure.step

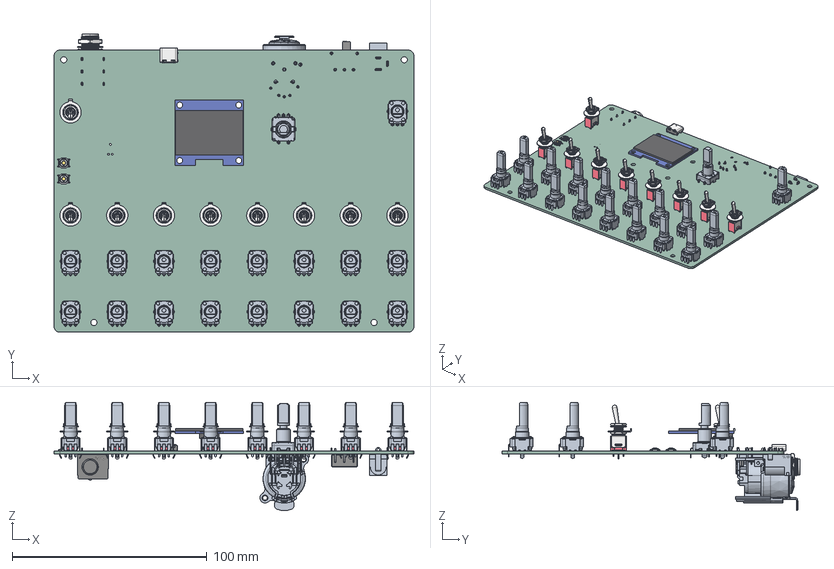
[picture p5: CAD file, 2026-10-15]
hardware/exports/cubevox-enclosure.step
185.0 x 153.4 x 55.6 mm
零件10 x 9
module_pcb
glass
header_body
pins
USB-C-SMD_TYPE-C16PIN
SW-SMD_4P-L5.1-W5.1-P3.70-LS6.5-TL_H1.5 x 2
AUDIO-TH_PJ-611E_1
SW-TH_5P-P4.70_SS-12D11-G050
cubevox_PCB
