peterdelecto/cubevox/hardware/exports/closure-coupon-skirt-07.stl

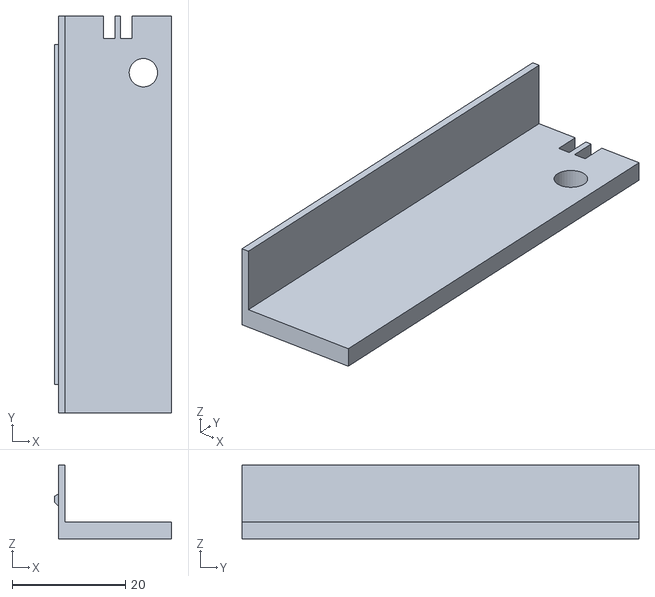
[picture p6: CAD file, 2026-10-08]
hardware/exports/closure-coupon-skirt-07.stl
20.7 x 70.0 x 13.0
