peterdelecto/cubevox/hardware/exports/closure-coupon-skirt-09.stl

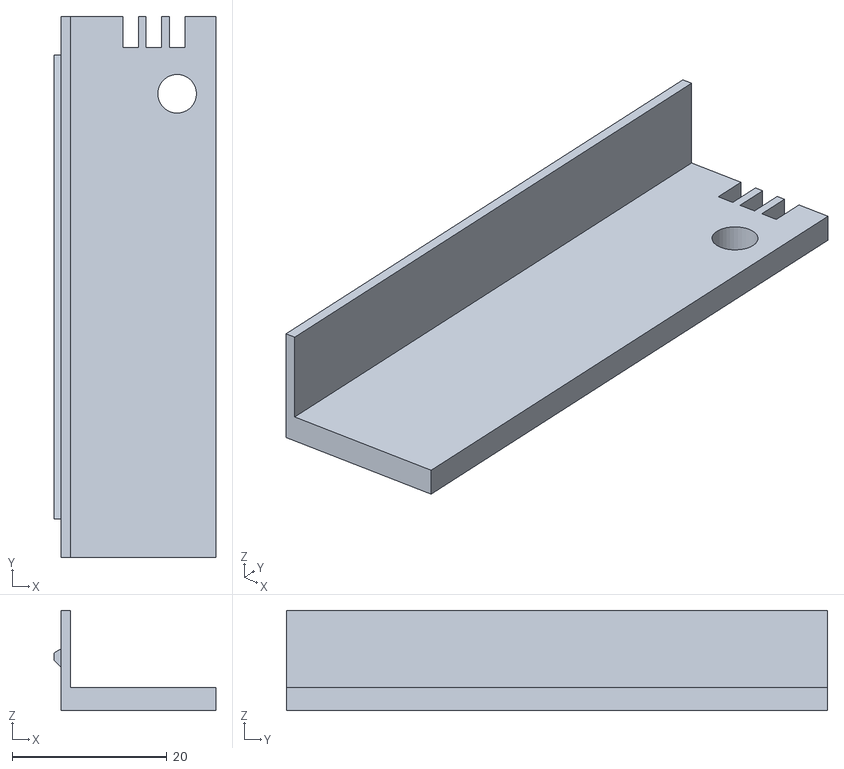
[picture p7: CAD file, 2026-10-08]
hardware/exports/closure-coupon-skirt-09.stl
20.9 x 70.0 x 13.0
