peterdelecto/cubevox/hardware/exports/closure-coupon-wall-07.stl

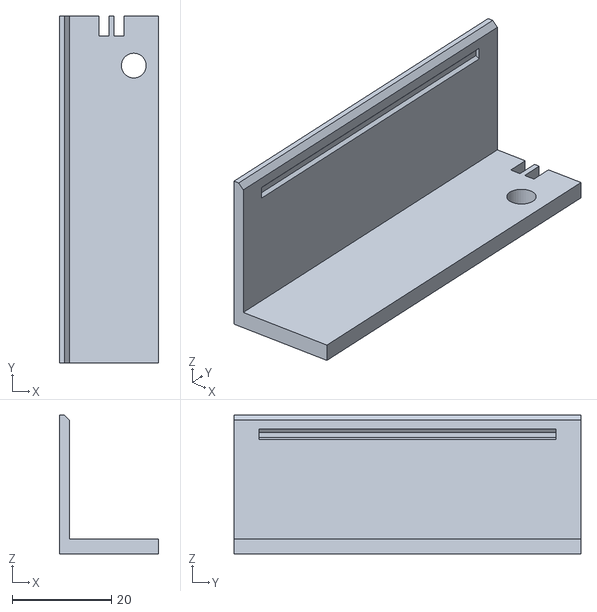
[picture p8: CAD file, 2026-10-08]
hardware/exports/closure-coupon-wall-07.stl
20.0 x 70.0 x 28.0
