peterdelecto/cubevox/hardware/exports/closure-coupon-wall-05.stl

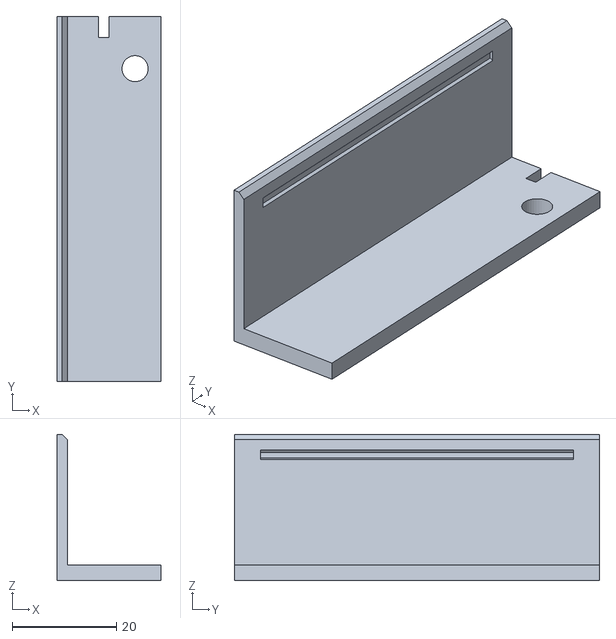
[picture p9: CAD file, 2026-10-08]
hardware/exports/closure-coupon-wall-05.stl
20.0 x 70.0 x 28.0
