peterdelecto/cubevox/hardware/exports/closure-coupon-skirt-05.stl

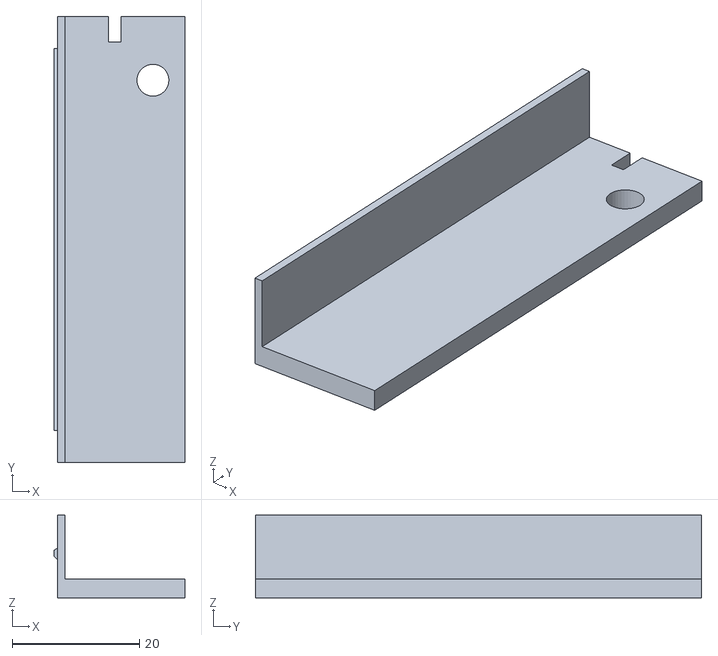
[picture p10: CAD file, 2026-10-08]
hardware/exports/closure-coupon-skirt-05.stl
20.5 x 70.0 x 13.0
