peterdelecto/cubevox/hardware/exports/closure-coupon-lid-05.stl

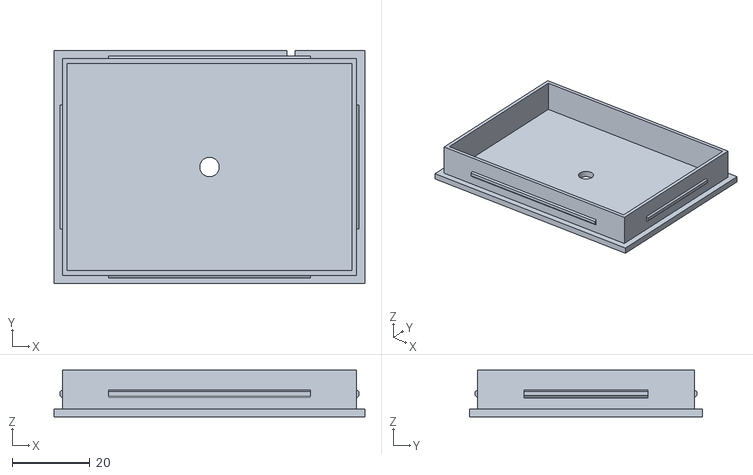
[picture p11: CAD file, 2026-10-08]
hardware/exports/closure-coupon-lid-05.stl
80.0 x 60.0 x 12.0
