peterdelecto/cubevox/hardware/exports/closure-coupon-dish.stl

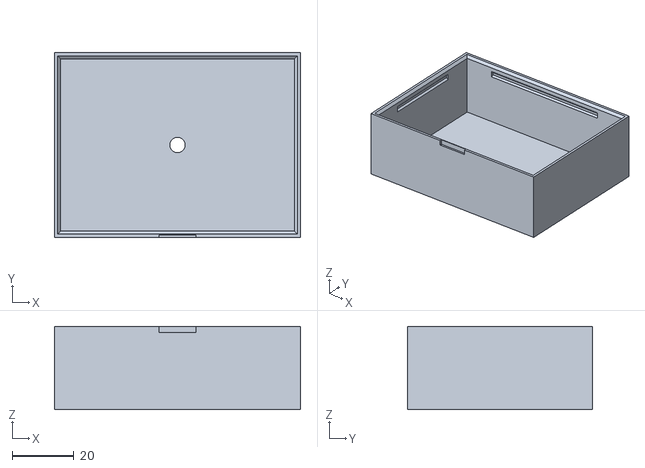
[picture p12: CAD file, 2026-10-08]
hardware/exports/closure-coupon-dish.stl
80.0 x 60.0 x 27.0
