peterdelecto/cubevox/hardware/exports/closure-coupon-lid-09.stl

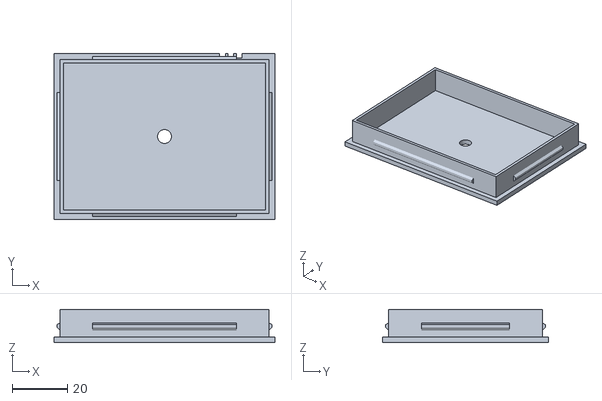
[picture p13: CAD file, 2026-10-08]
hardware/exports/closure-coupon-lid-09.stl
80.0 x 60.0 x 12.0
