peterdelecto/cubevox/hardware/exports/cubevox-board.step

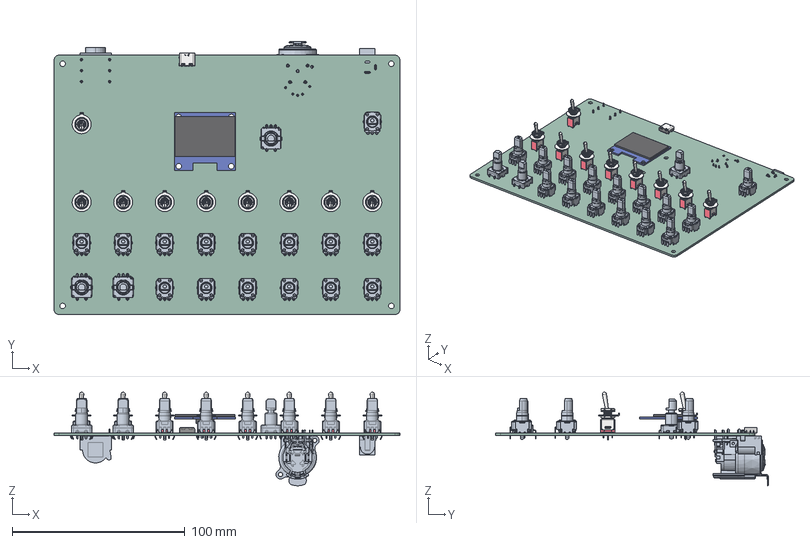
[picture p14: CAD file, 2026-10-02]
hardware/exports/cubevox-board.step
200.0 x 157.9 x 54.2 mm
零件10 x 9
module_pcb
glass
header_body
pins
USB-C-SMD_TYPE-C16PIN
onboard_tmp_PCB
