peterdelecto/cubevox/(list of files, cad)

Other CAD files:
hardware/exports/cubevox-enclosure-full.step
hardware/exports/closure-coupon-wall-09.stl
hardware/exports/closure-coupon-lid-07.stl
