peterdelecto/cubevox/hardware/renders/cubevox.pdf

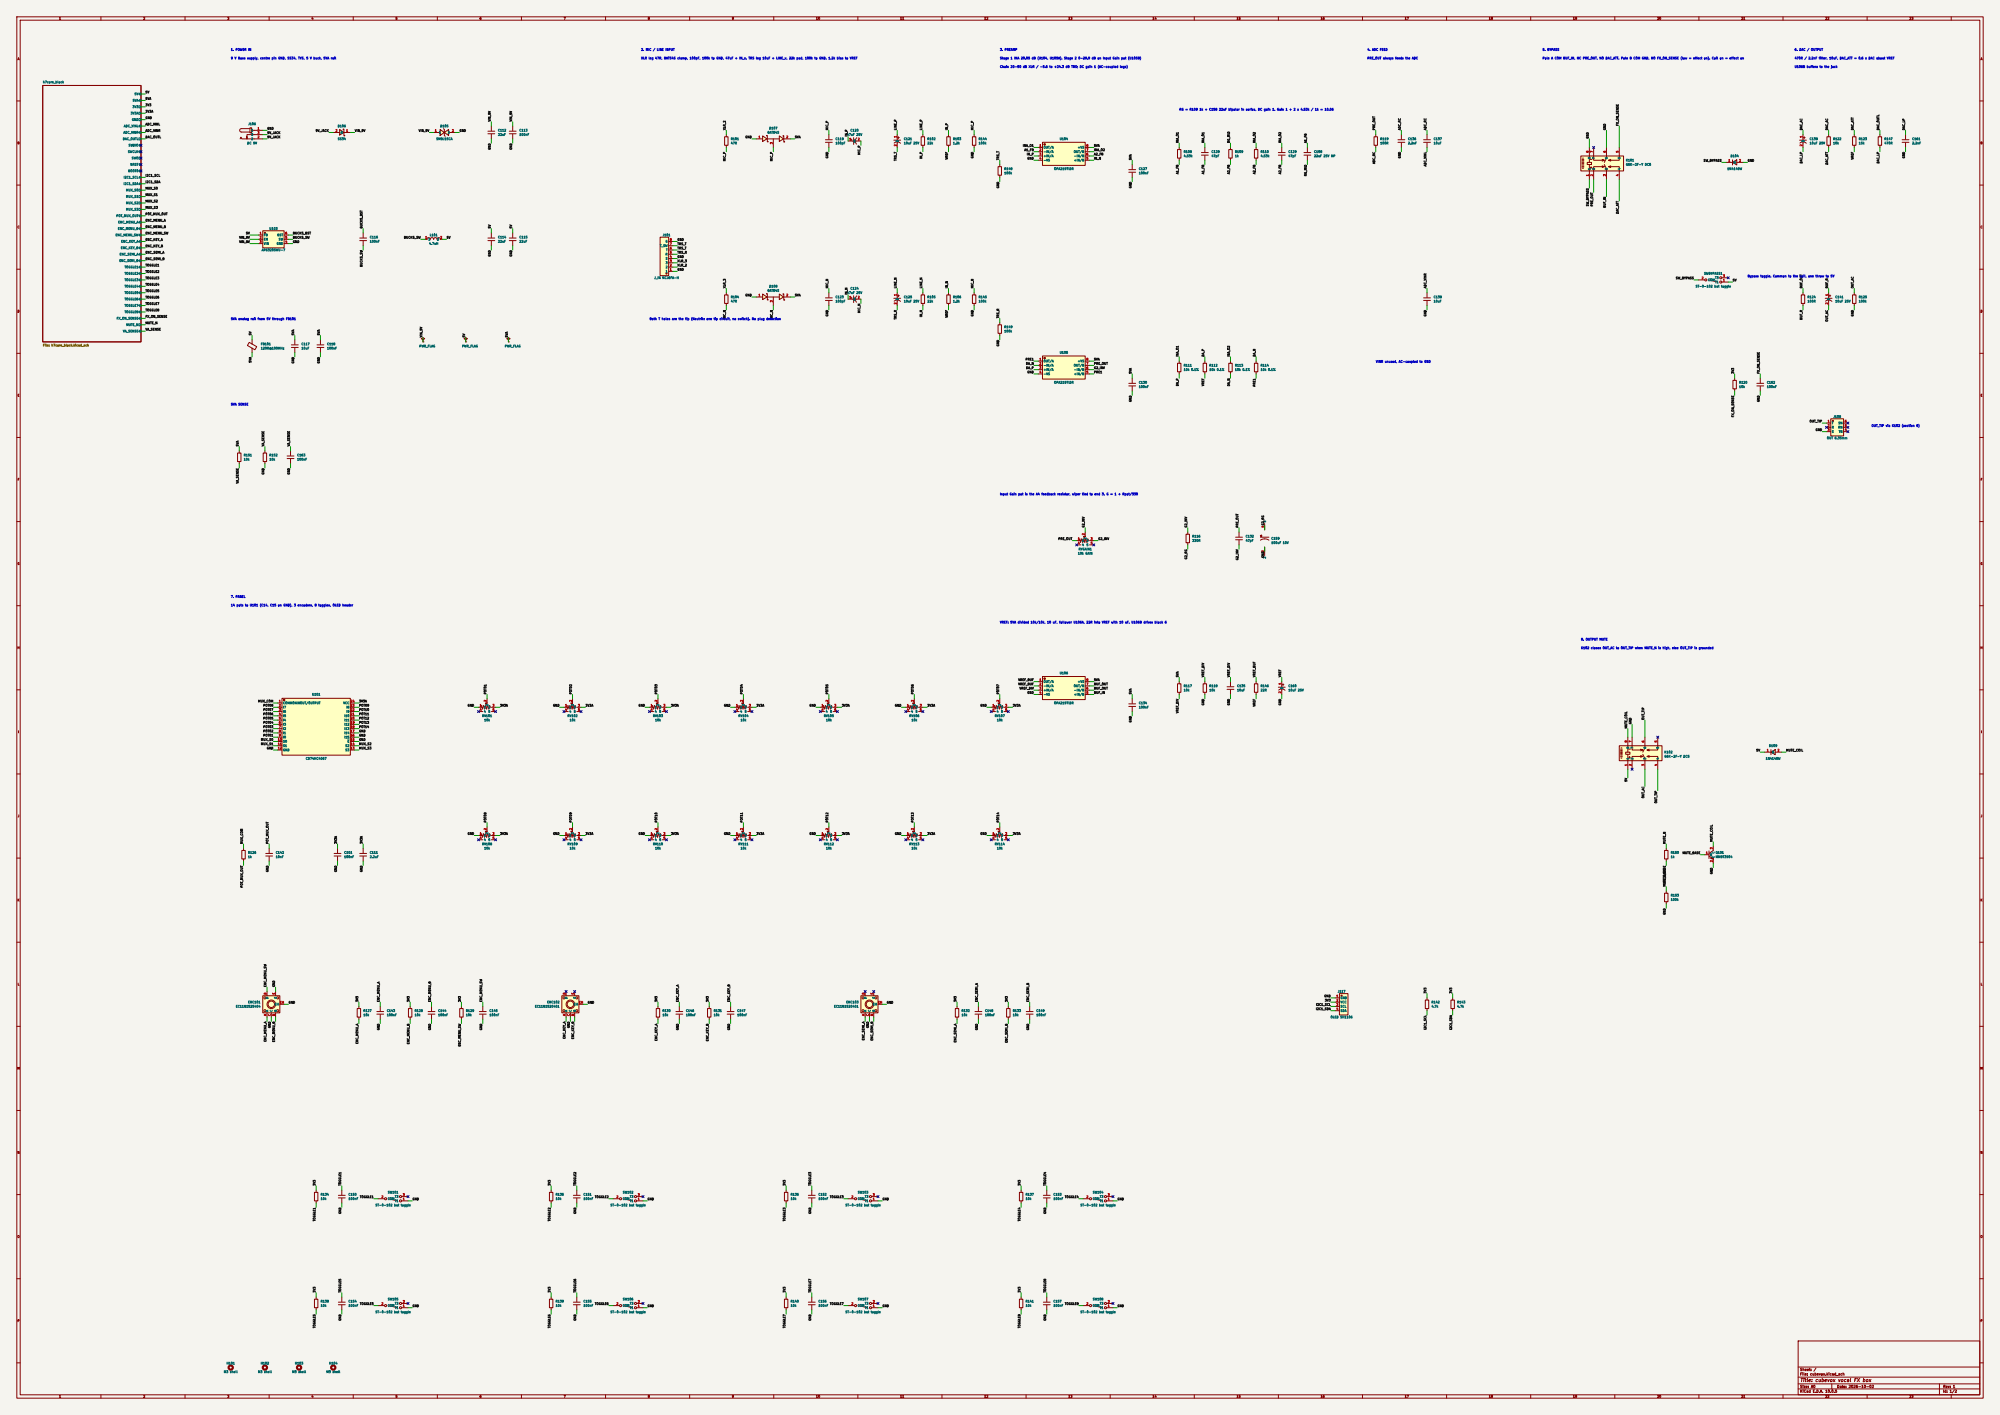
[picture p15: page 1]

Pole A COM BUF_IN, NC PRE_OUT, NO DAC_ATT. Pole B COM GND, NO FX_ON_SENSE (low = effect on). Coil on = effect on 4. ADC FEED

6. DAC / OUTPUT 470R / 2.2nF filter, 10uF, DAC_ATT = 0.6 x DAC about VREF U106B buffers to the jack 5. BYPASS

9 V Boss supply, centre pin GND, SS34, TVS, 5 V buck, 5VA rail

PRE_OUT always feeds the ADC

Chain 20-50 dB XLR / -5.6 to +24.3 dB TRS; DC gain 1 (AC-coupled legs)

Both T holes are the tip (Neutrik: one tip circuit, no switch). No plug detection

VINR unused, AC-coupled to GND

Input Gain pot is the A4 feedback resistor, wiper tied to end 3. G = 1 + Rpot/330

7. PANEL 14 pots to U101 (C14, C15 on GND), 3 encoders, 8 toggles, OLED header

VREF: 5VA divided 10k/10k, 10 uF, follower U106A, 22R into VREF with 10 uF. U106B drives block 6

K102 closes OUT_AC to OUT_TIP when MUTE_N is high, else OUT_TIP is grounded 8. OUTPUT MUTE

Sheet: /
File: cubevox.kicad_sch
Title: cubevox vocal FX box

Size: A0 | Rev: 1
KiCad E.D.A. 10.0.5 | Id: 1/2

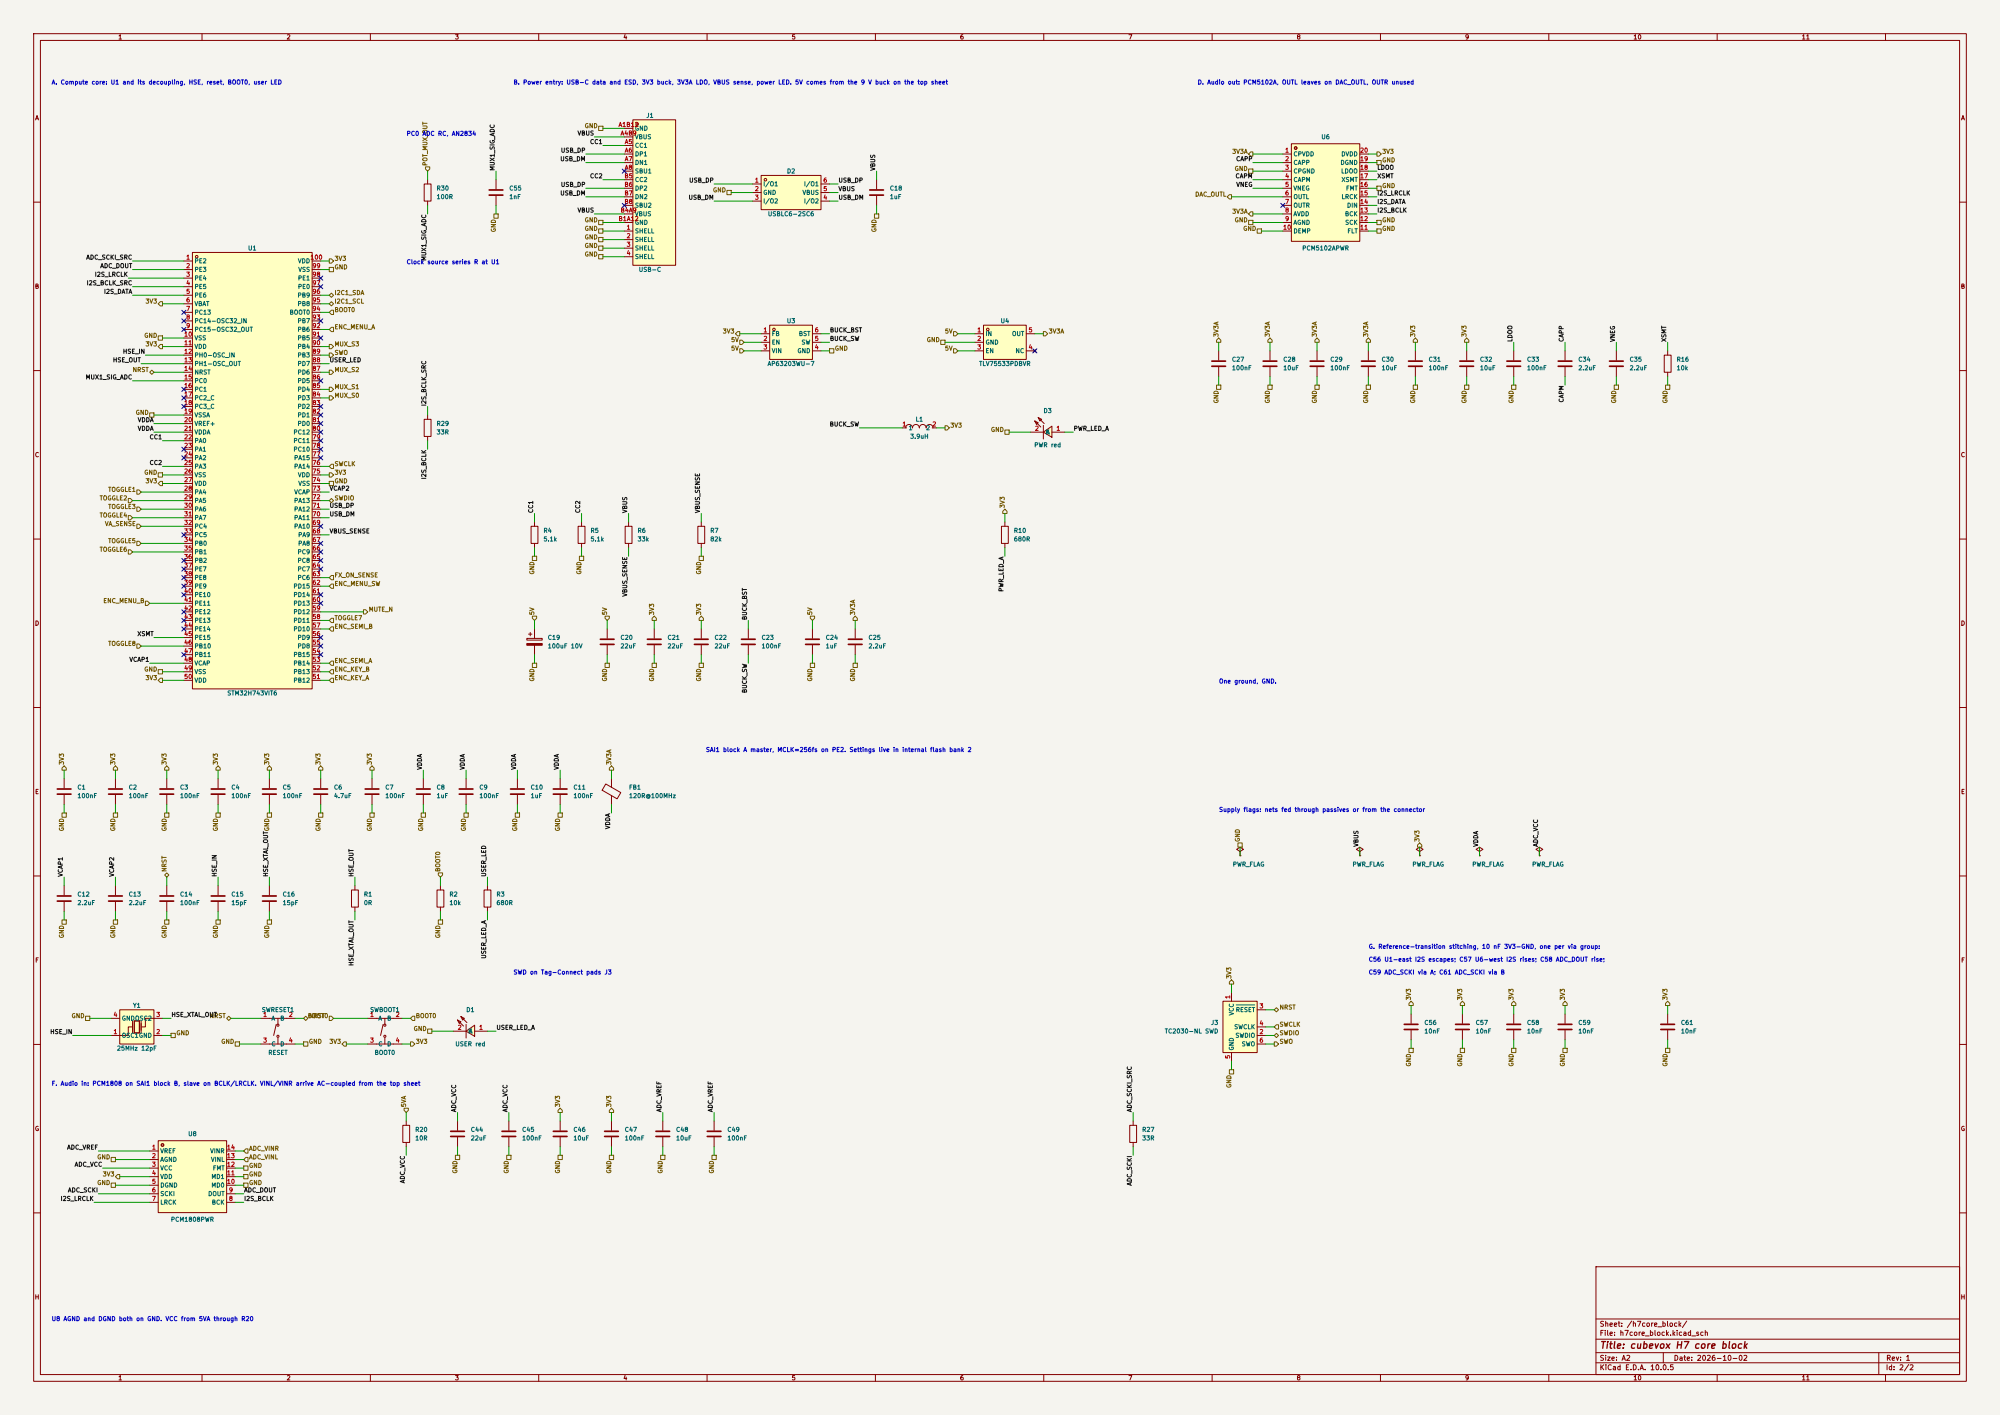
[picture p16: page 2]

A. Compute core: U1 and its decoupling, HSE, reset, BOOT0, user LED

SWD on Tag-Connect pads J3

F. Audio in: PCM1808 on SAI1 block B, slave on BCLK/LRCLK. VINL/VINR arrive AC-coupled from the top sheet

Sheet: /h7core_block/
File: h7core_block.kicad_sch
Title: cubevox H7 core block

Size: A2 | Rev: 1
KiCad E.D.A. 10.0.5 | Id: 2/2
