peterdelecto/cubevox/hardware/cubevox.kicad_pcb

## KiCad design hardware/cubevox.kicad_pcb (2026-11-04)

Schematic: cubevox.kicad_sch, cubevox vocal FX box

Parts:
C101, C113, C116, C118, C127, C130, C134, C143, C144, C145, C150, C151, C152, C153, C154, C155, C156, C157, C162, C163: 100nF; C0603; LCSC C14663
C111: 2.2uF; C0603; LCSC C23630
C112, C114, C115: 22uF; C1206; LCSC C12891
C117, C135, C137, C138: 10uF; C1206; LCSC C14860
C119, C123: 100pF; C0603; LCSC C14858
C120, C124: 47uF 25V; CAP-SMD_BD6.3-L6.6-W6.6-LS7.6-FD; MPN RVT1E470M0605; LCSC C72521
C121, C125, C139, C141, C160: 10uF 25V; CAP-SMD_BD4.0-L4.3-W4.3-FD; MPN RVT1E100M0405; LCSC C72484
C128, C129, C132: 47pF; C0603; LCSC C1671
C136, C161: 2.2nF; C0603; LCSC C2991172
C142: 10nF; C0603; LCSC C57112
C158: 22uF 25V NP; CAP-SMD_BD6.3-L6.6-W6.6-FD; MPN EEEHP1E220P; LCSC C413679
C159: 100uF 10V; CAP-SMD_BD5.0-L5.3-W5.3-LS6.3-FD; MPN VT1A101M0505; LCSC C191859
C167: 100nF; C_0402_1005Metric; LCSC C1525
C168, C169: 10uF; C_0805_2012Metric; LCSC C15850
D105: SMBJ20CA; SMB_L4.4-W3.6-LS5.4-BI; MPN SMBJ20CA; LCSC C113992
D106: SS34; SMA_L4.3-W2.6-LS5.2-RD; MPN SS34; LCSC C8678
D107, D108: BAT54S; SOT-23_L2.9-W1.3-P1.90-LS2.4-BR; MPN BAT54SLT1G; LCSC C19726
D109, D110: 1N4148W; SOD-123F_L2.7-W1.6-LS3.8-RD; MPN 1N4148W; LCSC C81598
ENC101: EC11E15244B2; SW-TH_EC11E; MPN EC11E15244B2; LCSC C470754
FB101: 120R@100MHz; L_0603_1608Metric; MPN BLM18PG121SN1D; LCSC C14709
FB102: 120R@100MHz; L_0603_1608Metric; LCSC C14709
H101, H102, H103, H104: M3 shell; MountingHole_3.2mm_M3
J101: J_IN NCJ6FA-H; CONN-TH_NCJ6FA-H; MPN NCJ6FA-H; LCSC C368458
J106: DC 9V; DC-IN-TH_PJ-002A; MPN PJ-002A; LCSC C3096082
J108: OUT 6.35mm; AUDIO-TH_PJ-611E_1; MPN PJ-611E; LCSC C309282
J117: OLED SH1106; OLED-1.3-SH1106-I2C-4P; MPN SH1106 1.3in I2C 128x64; LCSC C42379197
K102, K103: G6K-2F-Y DC5; RELAY-SMD_G6K-2F-X-XX; MPN G6K-2F-Y-TR DC5; LCSC C47190
L101: 4.7uH; IND-SMD_L5.0-W5.0_ANR5040T; MPN ANR5040T4R7M; LCSC C7427135
Q101, Q102: MMBT3904; SOT-23-3_L2.9-W1.3-P1.90-LS2.4-BR; MPN MMBT3904; LCSC C20526
R101, R104: 47R; R0603; LCSC C23182
R102, R105: 22k; R0603; LCSC C31850
R103, R106: 1.2k; R0603; LCSC C22765
R108, R110: 4.53k; R0603; LCSC C25971
R109, R126, R150, R159, R160: 1k; R0603; LCSC C21190
R111, R112, R113, R114: 10k 0.1%; R0603; MPN ARG03BTC1002; LCSC C309083
R116, R147: 470R; R0603; LCSC C23179
R117, R118, R120, R122, R127, R128, R129, R134, R135, R136, R137, R138, R139, R140, R141, R151, R152: 10k; R0603; LCSC C25804
R119, R124: 100R; R0603; LCSC C22775
R123: 15k; R0603; LCSC C22809
R125, R144, R145, R148, R149, R153, R161: 100k; R0603; LCSC C25803
R142, R143: 4.7k; R0603; LCSC C23162
R146: 22R; R0603; LCSC C23345
R154, R155: 10k; R_0402_1005Metric; LCSC C25744
R162: 100k; R_0402_1005Metric; LCSC C25741
RV101, RV102, RV103, RV104, RV105, RV106, RV107, RV108, RV109, RV110, RV111, RV112, RV113, RV114, RV115, RV116: 10k; RES-ADJ-TH_RK09D1130C2P; MPN RK09D1130C2P; LCSC C361173
RVGAIN1: 10k GAIN; RES-ADJ-TH_RK09D1130C2P; MPN RK09D1130C2P; LCSC C361173
SW101, SW102, SW103, SW104, SW105, SW106, SW107, SW108: ST-0-102 bat toggle; SW-TH_3P-L8.3-W5.2-P2.54_ST-0-102-A01-T000; MPN ST-0-102-A01-T000-LF; LCSC C1788487
SWBYPASS1: ST-0-102 bat toggle; SW-TH_3P-L8.3-W5.2-P2.54_ST-0-102-A01-T000; MPN ST-0-102-A01-T000-LF; LCSC C1788487
SWPWR1: SS-12D11-G050 power; SW-TH_5P-P4.70_SS-12D11-G050; MPN SS-12D11-G050; LCSC C17179528
TP1: 9V_JACK; TestPoint_Pad_D1.5mm
TP2: VIN_9V; TestPoint_Pad_D1.5mm
TP3: GND; TestPoint_Pad_D1.5mm
TP4: 3V3; TestPoint_Pad_D1.5mm
TP6: 3V3A; TestPoint_Pad_D1.5mm
TP7: 5V; TestPoint_Pad_D1.5mm
TP8: 5VA; TestPoint_Pad_D1.5mm
TP9: 5VA_W; TestPoint_Pad_D1.5mm
TP10: VREF_BUF; TestPoint_Pad_D1.5mm
U101: CD74HC4067; SSOP-24_L8.1-W5.3-P0.65-LS7.8-BL; MPN CD74HC4067SM96; LCSC C98457
U103: AP63205WU-7; TSOT-23-6_L2.9-W1.6-P0.95-LS2.8-BL; MPN AP63205WU-7; LCSC C2071056
U104, U105, U106: OPA2197IDR; SOIC-8_L4.9-W3.9-P1.27-LS6.0-BL; MPN OPA2197IDR; LCSC C139363
U108: OPA197IDBVR; SOT-23-5_L3.0-W1.7-P0.95-LS2.8-BR; LCSC C221351

Connections:
/3V3: J117.2 (VCC), R120.1, R127.1, R128.1, R129.1, R134.1, R135.1, R136.1, R137.1, R138.1, R139.1, R140.1, R141.1, R142.1, R143.1, TP4.1 (1_1); also elsewhere on the board
/3V3A: C101.1, C111.1, RV101.3, RV102.3, RV103.3, RV104.3, RV105.3, RV106.3, RV107.3, RV108.3, RV109.3, RV110.3, RV111.3, RV112.3, RV113.3, RV114.3, RV115.3, RV116.3, TP6.1 (1_1), U101.24 (VCC); also elsewhere on the board
/5V: C114.1, C115.1, D109.1 (K), D110.1 (K), FB101.1, FB102.1, K102.1, K103.1, L101.2, TP7.1 (1_1), U103.1 (FB); also elsewhere on the board
/5VA: C117.1, C118.1, C127.1, C134.1, C167.1, D107.2 (C), D108.2 (C), FB101.2, R117.1, R151.1, TP8.1 (1_1), U104.8 (+VS), U105.8 (+VS), U108.5 (V+); also elsewhere on the board
/5VA_W: C130.1, C168.1, FB102.2, R154.1, TP9.1 (1_1), U106.8 (+VS)
/9V_JACK: D106.2 (A), SWPWR1.1, TP1.1 (1_1)
/9V_PLUG: J106.2, J106.3, SWPWR1.2
/A1_FB: C128.2, C158.1, R108.2, U104.2 (-IN/A)
/A2_FB: C129.2, R109.2, R110.2, U104.6 (-IN/B)
/ADC_RC: C136.1, C137.1, R119.2
/ADC_VINL: C137.2; also elsewhere on the board
/ADC_VINR: C138.1; also elsewhere on the board
/BIAS_W: C169.1, R123.2, R154.2, R155.1, U106.3 (+IN/A)
/BUCK5_BST: C116.1, U103.6 (BST)
/BUCK5_SW: C116.2, L101.1, U103.5 (SW)
/BUF_IN: R122.2, R123.1, U106.5 (+IN/B)
/BUF_OUT: R124.1, U106.6 (-IN/B), U106.7 (OUT/B)
/BUF_R: C141.1, R124.2
/DAC_AC: C139.1, R122.1
/DAC_LP: C139.2, C161.1, R147.2
/DAC_OUTL: R147.1; also elsewhere on the board
/DA_N: R113.2, R114.1, U105.2 (-IN/A)
/DA_P: R111.2, R112.1, U105.3 (+IN/A)
/ENC_MENU_A: C143.1, ENC101.A, R127.2; also elsewhere on the board
/ENC_MENU_B: C144.1, ENC101.B, R128.2; also elsewhere on the board
/ENC_MENU_SW: C145.1, ENC101.D, R129.2; also elsewhere on the board
/G2_BOT: R116.1, RVGAIN1.3
/G2_INV: C132.2, R159.1, RVGAIN1.2, U105.6 (-IN/B)
/G2_RG: C159.1, R116.2, R159.2
/GND: C101.2, C111.2, C112.2, C113.2, C114.2, C115.2, C117.2, C118.2, C119.2, C123.2, C127.2, C130.2, C134.2, C135.2, C136.2, C138.2, C142.2, C143.2, C144.2, C145.2, C150.2, C151.2, C152.2, C153.2, C154.2, C155.2, C156.2, C157.2, C159.2, C160.2, C161.2, C162.2, C163.2, C167.2, C168.2, C169.2, D105.2, D107.1 (A), D108.1 (A), ENC101.C, ENC101.E, ENC101.EH, J101.1, J101.4 (S), J101.8 (G), J106.1, J108.2, J117.1 (GND), K102.7, Q101.2 (E), Q102.2 (E), R118.2, R125.2, R144.2, R145.2, R148.2, R149.2, R152.2, R153.2, R155.2, R161.2, R162.2, RV101.1, RV102.1, RV103.1, RV104.1, RV105.1, RV106.1, RV107.1, RV108.1, RV109.1, RV110.1, RV111.1, RV112.1, RV113.1, RV114.1, RV115.1, RV116.1, SW101.1 (T1), SW102.1 (T1), SW103.1 (T1), SW104.1 (T1), SW105.1 (T1), SW106.1 (T1), SW107.1 (T1), SW108.1 (T1), SWBYPASS1.1 (T1), TP3.1 (1_1), U101.12 (GND), U101.15 (~E), U103.4 (GND), U104.4 (-VS), U105.4 (-VS), U106.4 (-VS), U108.2 (V-); also elsewhere on the board
/I2C_SCL: J117.3 (SCL), R142.2; also elsewhere on the board
/I2C_SDA: J117.4 (SDA), R143.2; also elsewhere on the board
/INA_O1: C128.1, R108.1, R111.1, U104.1 (OUT/A)
/INA_O2: C129.1, R110.1, R113.1, U104.7 (OUT/B)
/IN_N: C124.1, K103.6, R105.2, R106.1, U104.5 (+IN/B)
/IN_P: C120.1, K103.2, R102.2, R103.1, U104.3 (+IN/A)
/LINE_N: C125.1, K103.7, R105.1
/LINE_P: C121.1, K103.3, R102.1
/MIC_N: C123.1, C124.2, D108.3 (A/C), R104.2, R145.1
/MIC_P: C119.1, C120.2, D107.3 (A/C), R101.2, R144.1
/MUTE_BASE: Q101.1 (B), R150.2, R153.1
/MUTE_COIL: D109.2 (A), K102.8, Q101.3 (C)
/MUTE_N: R150.1; also elsewhere on the board
/MUTE_SW: C162.1, R120.2, SWBYPASS1.2 (COM); also elsewhere on the board
/MUX_COM: R126.1, U101.1 (COMMONINOUT/OUTPUT)
/MUX_S0: R162.1, U101.10 (S0); also elsewhere on the board
/MUX_S1: U101.11 (S1); also elsewhere on the board
/MUX_S2: U101.14 (S2); also elsewhere on the board
/MUX_S3: U101.13 (S3); also elsewhere on the board
/OUT_AC: C141.2, K102.3, R125.1
/OUT_TIP: J108.6, K102.4, K102.6
/PAD_BASE: Q102.1 (B), R160.2, R161.1
/PAD_COIL: D110.2 (A), K103.8, Q102.3 (C)
/PAD_EN: R160.1; also elsewhere on the board
/POT01: RV101.2, U101.9 (I0)
/POT02: RV102.2, U101.8 (I1)
/POT03: RV103.2, U101.7 (I2)
/POT04: RV104.2, U101.6 (I3)
/POT05: RV105.2, U101.5 (I4)
/POT06: RV106.2, U101.4 (I5)
/POT07: RV107.2, U101.3 (I6)
/POT08: RV108.2, U101.2 (I7)
/POT09: RV109.2, U101.18 (I13)
/POT10: RV110.2, U101.17 (I14)
/POT11: RV111.2, U101.22 (I9)
/POT12: RV112.2, U101.20 (I11)
/POT13: RV113.2, U101.23 (I8)
/POT14: RV114.2, U101.21 (I10)
/POT15: RV115.2, U101.19 (I12)
/POT16: RV116.2, U101.16 (I15)
/POT_MUX_OUT: C142.1, R126.2; also elsewhere on the board
/PRE1: R114.2, U105.1 (OUT/A), U105.5 (+IN/B)
/PRE_OUT: C132.1, R119.1, RVGAIN1.1, U105.7 (OUT/B)
/RG_MID: C158.2, R109.1
/TOGGLE1: C150.1, R134.2, SW101.2 (COM); also elsewhere on the board
/TOGGLE2: C151.1, R135.2, SW102.2 (COM); also elsewhere on the board
/TOGGLE3: C152.1, R136.2, SW103.2 (COM); also elsewhere on the board
/TOGGLE4: C153.1, R137.2, SW104.2 (COM); also elsewhere on the board
/TOGGLE5: C154.1, R138.2, SW105.2 (COM); also elsewhere on the board
/TOGGLE6: C155.1, R139.2, SW106.2 (COM); also elsewhere on the board
/TOGGLE7: C156.1, R140.2, SW107.2 (COM); also elsewhere on the board
/TOGGLE8: C157.1, R141.2, SW108.2 (COM); also elsewhere on the board
/TRS_R: C125.2, J101.5 (R), R149.1
/TRS_T: C121.2, J101.6 (T), J101.7 (T_SW), R148.1
/U106A_OUT: U106.1 (OUT/A), U106.2 (-IN/A)
/VA_SENSE: C163.1, R151.2, R152.1; also elsewhere on the board
/VIN_9V: C112.1, C113.1, D105.1, D106.1 (K), TP2.1 (1_1), U103.2 (EN), U103.3 (VIN)
/VREF: C160.1, R103.2, R106.2, R112.2, R146.2
/VREF_BUF: R146.1, TP10.1 (1_1), U108.1 (OUT), U108.4 (-IN)
/VREF_DIV: C135.1, R117.2, R118.1, U108.3 (+IN)
/XLR_2: J101.2, R101.1
/XLR_3: J101.3, R104.1

Notes on the sheet:
1. POWER IN
9 V Boss supply, centre pin GND, SS34, TVS, 5 V buck, 5VA rail
5VA analog rail from 5V through FB101
2. MIC / LINE INPUT
XLR leg 47R, BAT54S clamp, 100pF, 100k to GND, 47uF + IN_x. TRS leg 10uF + LINE_x, 22k pad, 100k to GND. 1.2k bias to VREF
Both T holes are the tip (Neutrik: one tip circuit, no switch). No plug detection
3. PREAMP
Stage 1 INA 20.05 dB (U104, U105A). Stage 2 0-29.9 dB on Input Gain pot (U105B)
Chain 20-50 dB XLR / -5.6 to +24.3 dB TRS; DC gain 1 (AC-coupled legs)
RG = R109 1k + C158 22uF bipolar in series, DC gain 1. Gain 1 + 2 x 4.53k / 1k = 10.06
Input Gain pot is the A4 feedback resistor, wiper tied to end 3. G = 1 + Rpot/330
VREF: 5VA divided 10k/10k, 10 uF, follower U106A, 22R into VREF with 10 uF. U106B drives block 6
4. ADC FEED
PRE_OUT always feeds the ADC
VINR unused, AC-coupled to GND
5. MUTE TOGGLE
MUTE_SW low = muted. K102 (section 8) does the muting
Mute toggle. Common to MUTE_SW, one throw to GND, other throw open
6. DAC / OUTPUT
470R / 2.2nF filter, 10uF, BUF_IN = 0.6 x DAC about VREF
U106B buffers to the jack
OUT_TIP via K102 (section 8)
8. OUTPUT MUTE
K102 closes OUT_AC to OUT_TIP when MUTE_N is high, else OUT_TIP is grounded
5VA SENSE
7. PANEL
16 pots to U101 (the mux is full), 1 encoder, 8 toggles, OLED header

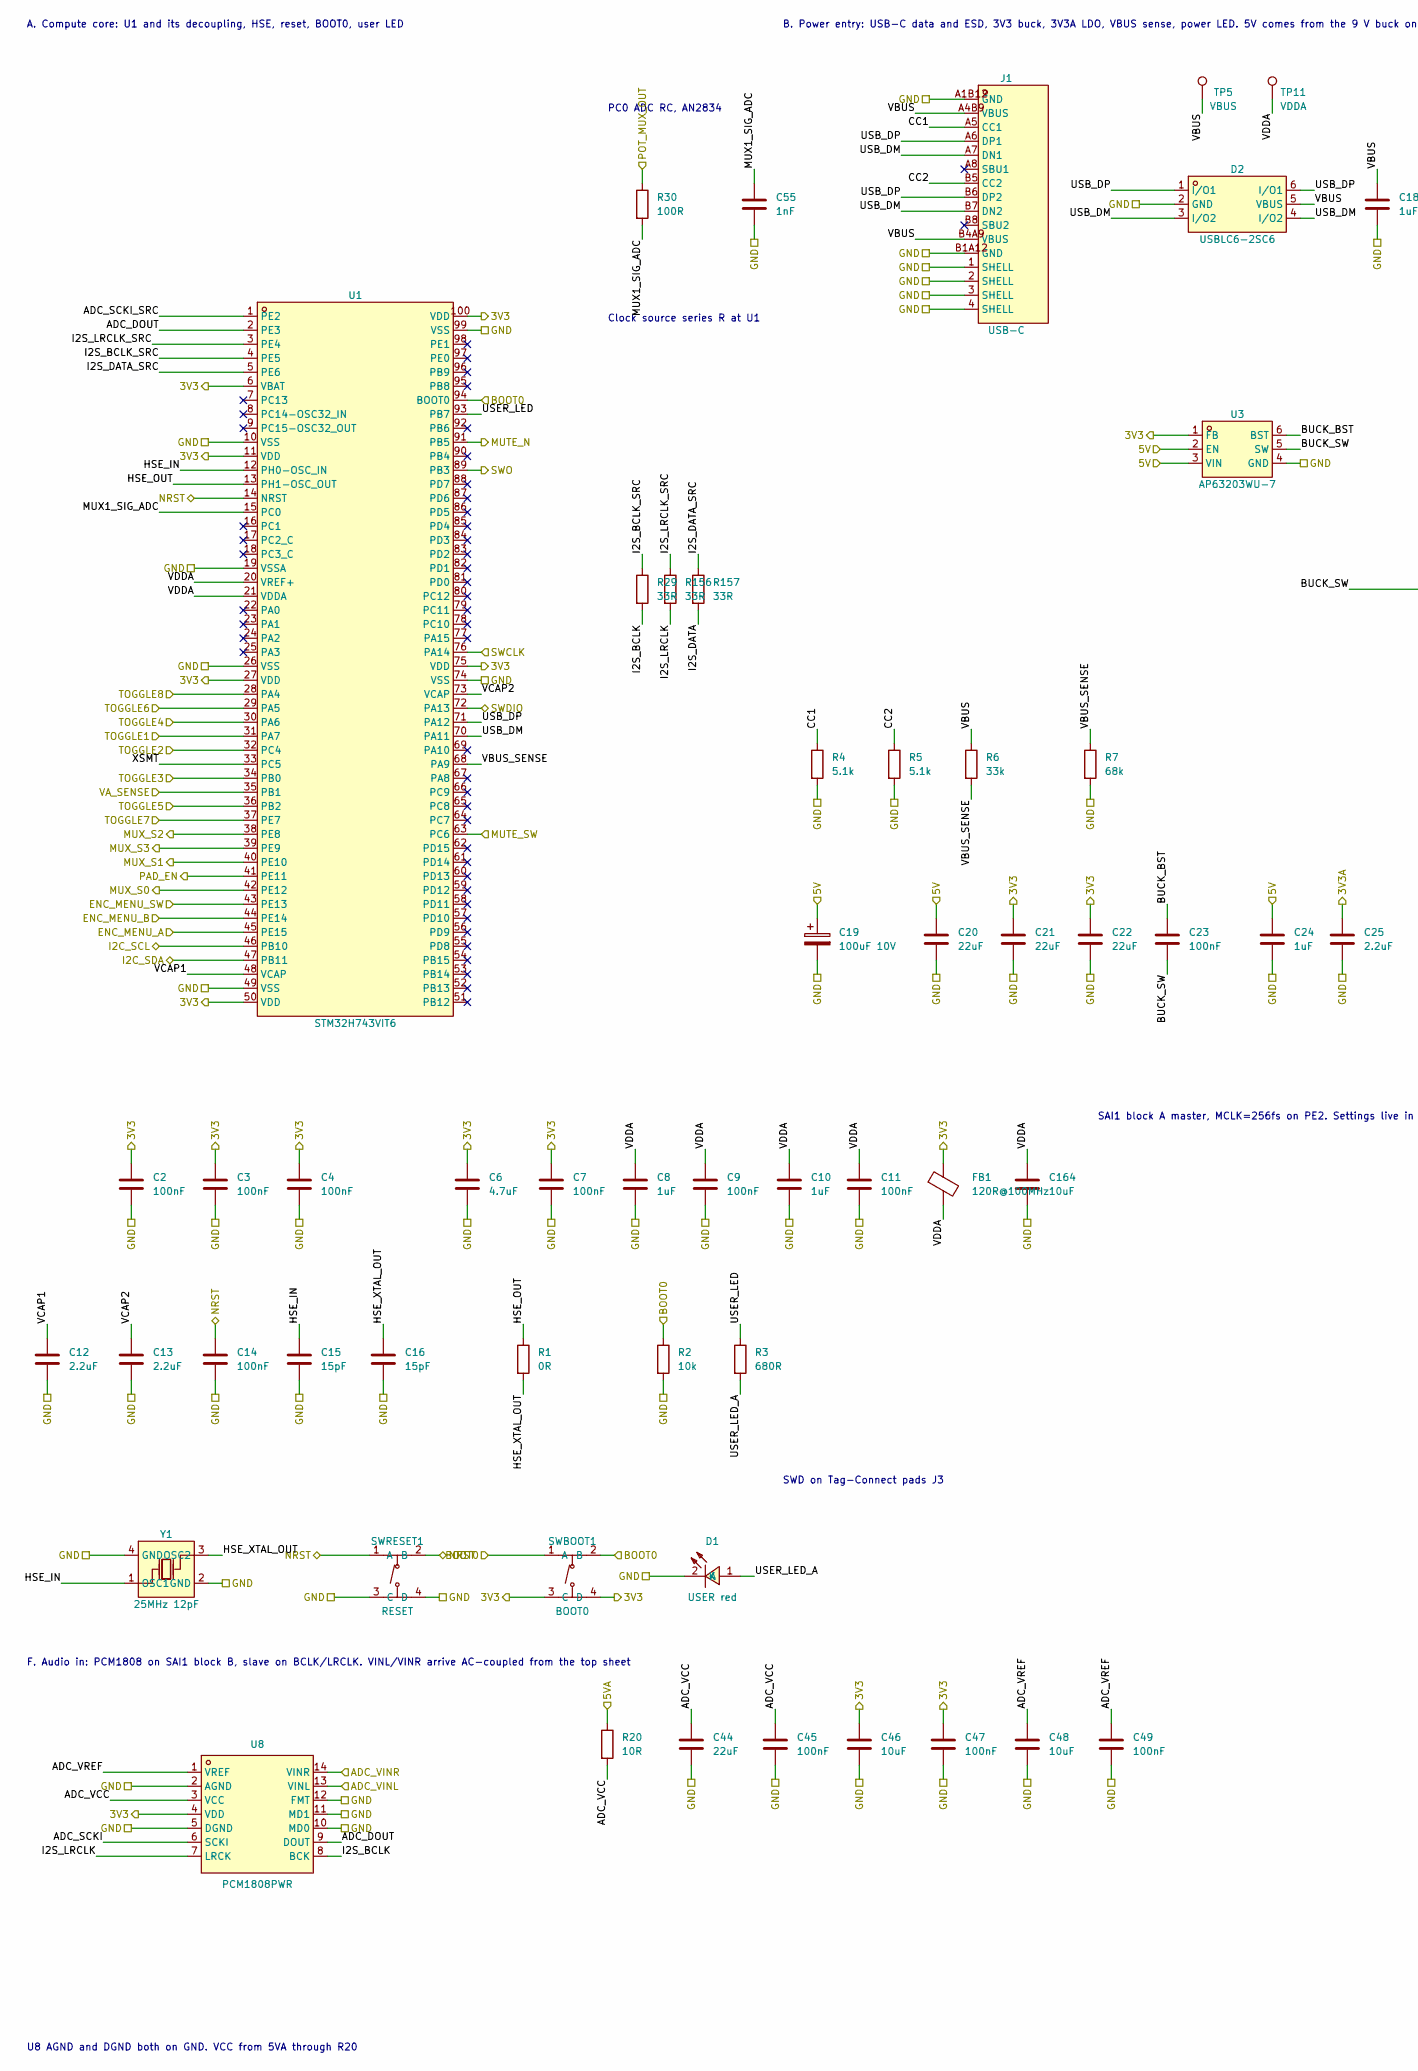
[picture p17: schematic h7core_block.kicad_sch, cubevox H7 core block, part in row 1, column 1]

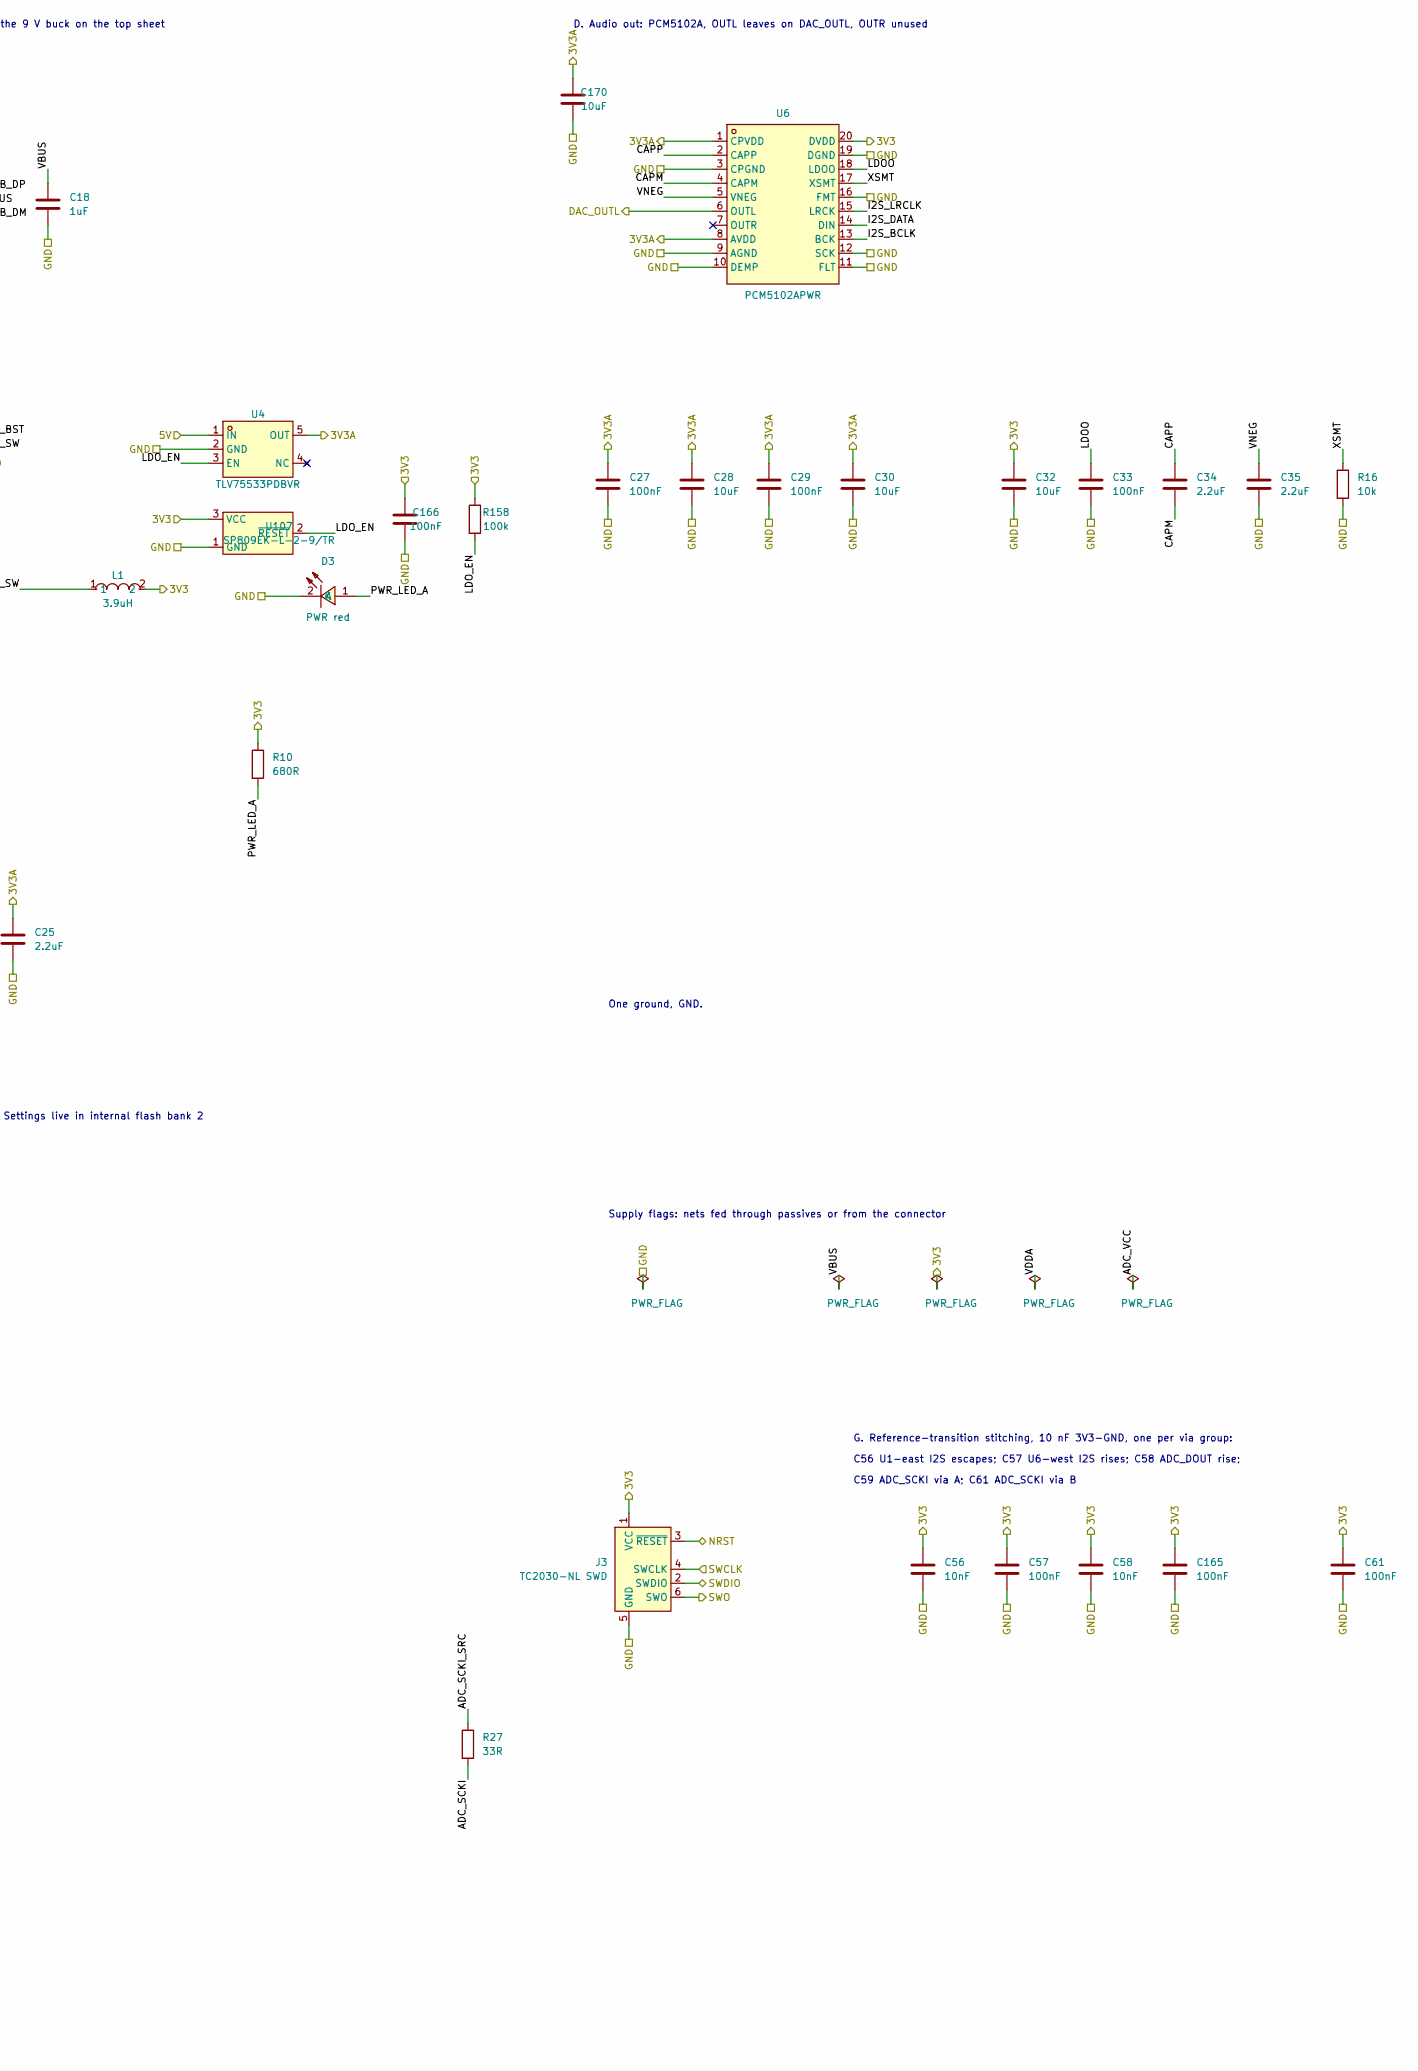
[picture p18: schematic h7core_block.kicad_sch, cubevox H7 core block, part in row 1, column 2]

Parts:
C2, C3, C4, C7, C9, C11, C14, C23, C27, C29, C33, C45, C47, C49: 100nF; C_0603_1608Metric; LCSC C14663
C6: 4.7uF; C_0603_1608Metric; LCSC C19666
C8, C10, C24: 1uF; C_0603_1608Metric; LCSC C15849
C12, C13, C25, C34, C35: 2.2uF; C_0603_1608Metric; LCSC C23630
C15, C16: 15pF; C_0603_1608Metric; LCSC C1644
C18: 1uF; C_0603_1608Metric; LCSC C90540
C19: 100uF 10V; CAP-SMD_L6.0-W3.2-R-RD; LCSC C8649
C20, C21, C22, C44: 22uF; C_1206_3216Metric; LCSC C12891
C28, C30, C32, C46, C48: 10uF; C_0603_1608Metric; LCSC C19702
C55: 1nF; C_0603_1608Metric; LCSC C1588
C56, C58: 10nF; C_0402_1005Metric; LCSC C15195
C57, C61, C165, C166: 100nF; C_0402_1005Metric; LCSC C1525
C164, C170: 10uF; C_0805_2012Metric; LCSC C15850
D1: USER red; LED-SMD_L1.6-W0.8-R-RD; MPN KT-0603R; LCSC C2286
D2: USBLC6-2SC6; SOT-23-6_L2.9-W1.6-P0.95-LS2.8-BL; MPN USBLC6-2SC6; LCSC C2687116
D3: PWR red; LED-SMD_L1.6-W0.8-R-RD; MPN KT-0603R; LCSC C2286
FB1: 120R@100MHz; L_0603_1608Metric; LCSC C14709
J1: USB-C; USB-C-SMD_TYPE-C16PIN; MPN TYPE-C16PIN; LCSC C393939
J3: TC2030-NL SWD; Tag-Connect_TC2030-IDC-NL_2x03_P1.27mm_Vertical
L1: 3.9uH; IND-SMD_L5.0-W5.0; MPN ANR5040T3R9M; LCSC C7427132
R1: 0R; R_0603_1608Metric; LCSC C21189
R2, R16: 10k; R_0603_1608Metric; LCSC C25804
R3, R10: 680R; R_0603_1608Metric; LCSC C23228
R4, R5: 5.1k; R_0603_1608Metric; LCSC C23186
R6: 33k; R_0603_1608Metric; LCSC C4216
R7: 68k; R_0603_1608Metric; LCSC C23231
R20: 10R; R_0603_1608Metric; LCSC C22859
R27, R156, R157: 33R; R_0402_1005Metric; LCSC C25105
R29: 33R; R_0603_1608Metric; LCSC C23140
R30: 100R; R_0603_1608Metric; LCSC C22775
R158: 100k; R_0402_1005Metric; LCSC C25741
SWBOOT1: BOOT0; SW-SMD_4P-L5.1-W5.1-P3.70-LS6.5-TL_H1.5; MPN TS-1187A-B-A-B; LCSC C318884
SWRESET1: RESET; SW-SMD_4P-L5.1-W5.1-P3.70-LS6.5-TL_H1.5; MPN TS-1187A-B-A-B; LCSC C318884
TP5: VBUS; TestPoint_Pad_D1.5mm
TP11: VDDA; TestPoint_Pad_D1.5mm
U1: STM32H743VIT6; LQFP-100_L14.0-W14.0-P0.50-LS16.0-BL; MPN STM32H743VIT6; LCSC C114409
U3: AP63203WU-7; TSOT-26_L2.9-W1.6-P0.95-LS2.8-BL; MPN AP63203WU-7; LCSC C780769
U4: TLV75533PDBVR; SOT-23-5_L3.0-W1.7-P0.95-LS2.8-BR; MPN TLV75533PDBVR; LCSC C404027
U6: PCM5102APWR; TSSOP-20_L6.5-W4.4-P0.65-LS6.4-BL; MPN PCM5102APWR; LCSC C107671
U8: PCM1808PWR; TSSOP-14_L5.0-W4.4-P0.65-LS6.4-BL; MPN PCM1808PWR; LCSC C55513
U107: SP809EK-L-2-9/TR; SOT-23-3_L2.9-W1.6-P1.90-LS2.8-BR; MPN SP809EK-L-2-9/TR; LCSC C412495
Y1: 25MHz 12pF; CRYSTAL-SMD_4P-L3.2-W2.5-BL; MPN X322525MOB4SI; LCSC C9006

Connections:
/3V3: C2.1, C3.1, C4.1, C6.1, C7.1, C21.1, C22.1, C32.1, C46.1, C47.1, C56.1, C57.1, C58.1, C61.1, C165.1, C166.1, FB1.1, J3.1 (VCC), L1.2, R10.1, R158.1, SWBOOT1.3 (C), SWBOOT1.4 (D), U1.6 (VBAT), U1.11 (VDD), U1.27 (VDD), U1.50 (VDD), U1.75 (VDD), U1.100 (VDD), U3.1 (FB), U6.20 (DVDD), U8.4 (VDD), U107.3 (VCC); also elsewhere on the board
/3V3A: C25.1, C27.1, C28.1, C29.1, C30.1, C170.1, U4.5 (OUT), U6.1 (CPVDD), U6.8 (AVDD); also elsewhere on the board
/5V: C19.1, C20.1, C24.1, U3.2 (EN), U3.3 (VIN), U4.1 (IN); also elsewhere on the board
/5VA: R20.1; also elsewhere on the board
/ADC_VINL: U8.13 (VINL); also elsewhere on the board
/ADC_VINR: U8.14 (VINR); also elsewhere on the board
/DAC_OUTL: U6.6 (OUTL); also elsewhere on the board
/ENC_MENU_A: U1.45 (PE15); also elsewhere on the board
/ENC_MENU_B: U1.44 (PE14); also elsewhere on the board
/ENC_MENU_SW: U1.43 (PE13); also elsewhere on the board
/GND: C2.2, C3.2, C4.2, C6.2, C7.2, C8.2, C9.2, C10.2, C11.2, C12.2, C13.2, C14.2, C15.2, C16.2, C18.2, C19.2, C20.2, C21.2, C22.2, C24.2, C25.2, C27.2, C28.2, C29.2, C30.2, C32.2, C33.2, C35.2, C44.2, C45.2, C46.2, C47.2, C48.2, C49.2, C55.2, C56.2, C57.2, C58.2, C61.2, C164.2, C165.2, C166.2, C170.2, D1.2 (K), D2.2 (GND), D3.2 (K), J1.1 (SHELL), J1.2 (SHELL), J1.3 (SHELL), J1.4 (SHELL), J1.A1B12 (GND), J1.B1A12 (GND), J3.5 (GND), R2.2, R4.2, R5.2, R7.2, R16.2, SWRESET1.3 (C), SWRESET1.4 (D), U1.10 (VSS), U1.19 (VSSA), U1.26 (VSS), U1.49 (VSS), U1.74 (VSS), U1.99 (VSS), U3.4 (GND), U4.2 (GND), U6.3 (CPGND), U6.9 (AGND), U6.10 (DEMP), U6.11 (FLT), U6.12 (SCK), U6.16 (FMT), U6.19 (DGND), U8.2 (AGND), U8.5 (DGND), U8.10 (MD0), U8.11 (MD1), U8.12 (FMT), U107.1 (GND), Y1.2 (GND), Y1.4 (GND); also elsewhere on the board
/I2C_SCL: U1.46 (PB10); also elsewhere on the board
/I2C_SDA: U1.47 (PB11); also elsewhere on the board
/MUTE_N: U1.91 (PB5); also elsewhere on the board
/MUTE_SW: U1.63 (PC6); also elsewhere on the board
/MUX_S0: U1.42 (PE12); also elsewhere on the board
/MUX_S1: U1.40 (PE10); also elsewhere on the board
/MUX_S2: U1.38 (PE8); also elsewhere on the board
/MUX_S3: U1.39 (PE9); also elsewhere on the board
/PAD_EN: U1.41 (PE11); also elsewhere on the board
/POT_MUX_OUT: R30.1; also elsewhere on the board
/TOGGLE1: U1.31 (PA7); also elsewhere on the board
/TOGGLE2: U1.32 (PC4); also elsewhere on the board
/TOGGLE3: U1.34 (PB0); also elsewhere on the board
/TOGGLE4: U1.30 (PA6); also elsewhere on the board
/TOGGLE5: U1.36 (PB2); also elsewhere on the board
/TOGGLE6: U1.29 (PA5); also elsewhere on the board
/TOGGLE7: U1.37 (PE7); also elsewhere on the board
/TOGGLE8: U1.28 (PA4); also elsewhere on the board
/VA_SENSE: U1.35 (PB1); also elsewhere on the board
/h7core_block/ADC_DOUT: U1.2 (PE3), U8.9 (DOUT)
/h7core_block/ADC_SCKI: R27.2, U8.6 (SCKI)
/h7core_block/ADC_SCKI_SRC: R27.1, U1.1 (PE2)
/h7core_block/ADC_VCC: C44.1, C45.1, R20.2, U8.3 (VCC)
/h7core_block/ADC_VREF: C48.1, C49.1, U8.1 (VREF)
/h7core_block/BOOT0: R2.1, SWBOOT1.1 (A), SWBOOT1.2 (B), U1.94 (BOOT0)
/h7core_block/BUCK_BST: C23.1, U3.6 (BST)
/h7core_block/BUCK_SW: C23.2, L1.1, U3.5 (SW)
/h7core_block/CAPM: C34.2, U6.4 (CAPM)
/h7core_block/CAPP: C34.1, U6.2 (CAPP)
/h7core_block/CC1: J1.A5 (CC1), R4.1
/h7core_block/CC2: J1.B5 (CC2), R5.1
/h7core_block/HSE_IN: C15.1, U1.12 (PH0-OSC_IN), Y1.1 (OSC1)
/h7core_block/HSE_OUT: R1.1, U1.13 (PH1-OSC_OUT)
/h7core_block/HSE_XTAL_OUT: C16.1, R1.2, Y1.3 (OSC2)
/h7core_block/I2S_BCLK: R29.2, U6.13 (BCK), U8.8 (BCK)
/h7core_block/I2S_BCLK_SRC: R29.1, U1.4 (PE5)
/h7core_block/I2S_DATA: R157.2, U6.14 (DIN)
/h7core_block/I2S_DATA_SRC: R157.1, U1.5 (PE6)
/h7core_block/I2S_LRCLK: R156.2, U6.15 (LRCK), U8.7 (LRCK)
/h7core_block/I2S_LRCLK_SRC: R156.1, U1.3 (PE4)
/h7core_block/LDOO: C33.1, U6.18 (LDOO)
/h7core_block/LDO_EN: R158.2, U4.3 (EN), U107.2 (~RESET)
/h7core_block/MUX1_SIG_ADC: C55.1, R30.2, U1.15 (PC0)
/h7core_block/NRST: C14.1, J3.3 (~RESET), SWRESET1.1 (A), SWRESET1.2 (B), U1.14 (NRST)
/h7core_block/PWR_LED_A: D3.1 (A), R10.2
/h7core_block/SWCLK: J3.4 (SWCLK), U1.76 (PA14)
/h7core_block/SWDIO: J3.2 (SWDIO), U1.72 (PA13)
/h7core_block/SWO: J3.6 (SWO), U1.89 (PB3)
/h7core_block/USB_DM: D2.3 (I/O2), D2.4 (I/O2), J1.A7 (DN1), J1.B7 (DN2), U1.70 (PA11)
/h7core_block/USB_DP: D2.1 (I/O1), D2.6 (I/O1), J1.A6 (DP1), J1.B6 (DP2), U1.71 (PA12)
/h7core_block/USER_LED: R3.1, U1.93 (PB7)
/h7core_block/USER_LED_A: D1.1 (A), R3.2
/h7core_block/VBUS: C18.1, D2.5 (VBUS), J1.A4B9 (VBUS), J1.B4A9 (VBUS), R6.1, TP5.1 (1_1)
/h7core_block/VBUS_SENSE: R6.2, R7.1, U1.68 (PA9)
/h7core_block/VCAP1: C12.1, U1.48 (VCAP)
/h7core_block/VCAP2: C13.1, U1.73 (VCAP)
/h7core_block/VDDA: C8.1, C9.1, C10.1, C11.1, C164.1, FB1.2, TP11.1 (1_1), U1.20 (VREF+), U1.21 (VDDA)
/h7core_block/VNEG: C35.1, U6.5 (VNEG)
/h7core_block/XSMT: R16.1, U1.33 (PC5), U6.17 (XSMT)

Notes on the sheet:
A. Compute core: U1 and its decoupling, HSE, reset, BOOT0, user LED
B. Power entry: USB-C data and ESD, 3V3 buck, 3V3A LDO, VBUS sense, power LED. 5V comes from the 9 V buck on the top sheet
D. Audio out: PCM5102A, OUTL leaves on DAC_OUTL, OUTR unused
One ground, GND.
SAI1 block A master, MCLK=256fs on PE2. Settings live in internal flash bank 2
SWD on Tag-Connect pads J3
Supply flags: nets fed through passives or from the connector
F. Audio in: PCM1808 on SAI1 block B, slave on BCLK/LRCLK. VINL/VINR arrive AC-coupled from the top sheet
U8 AGND and DGND both on GND. VCC from 5VA through R20
PC0 ADC RC, AN2834
Clock source series R at U1
G. Reference-transition stitching, 10 nF 3V3-GND, one per via group:
C56 U1-east I2S escapes; C57 U6-west I2S rises; C58 ADC_DOUT rise;
C59 ADC_SCKI via A; C61 ADC_SCKI via B

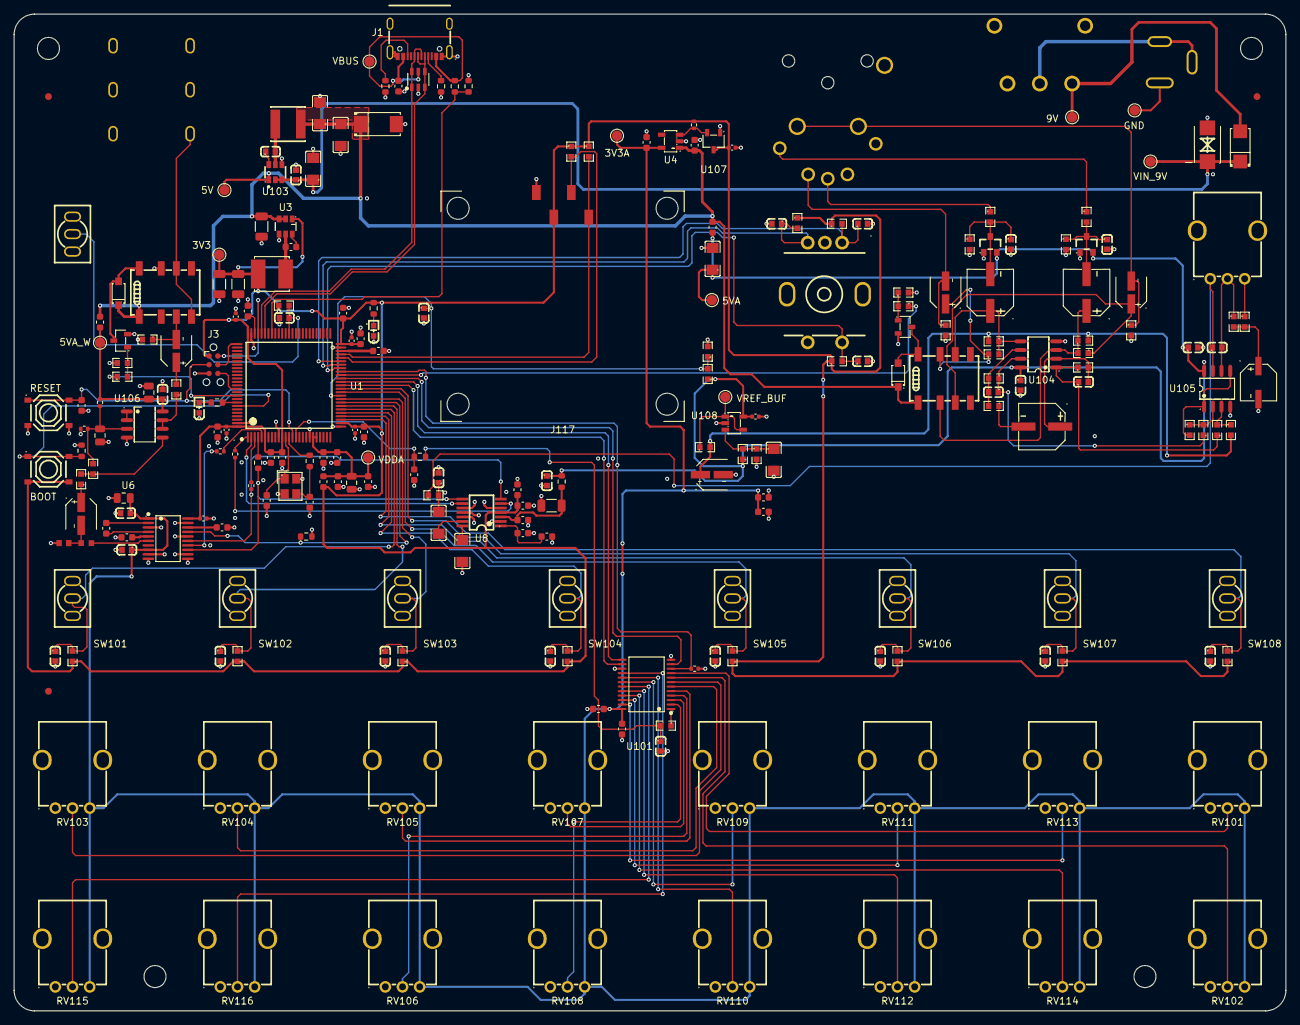
[picture p19: board cubevox.kicad_pcb from above]

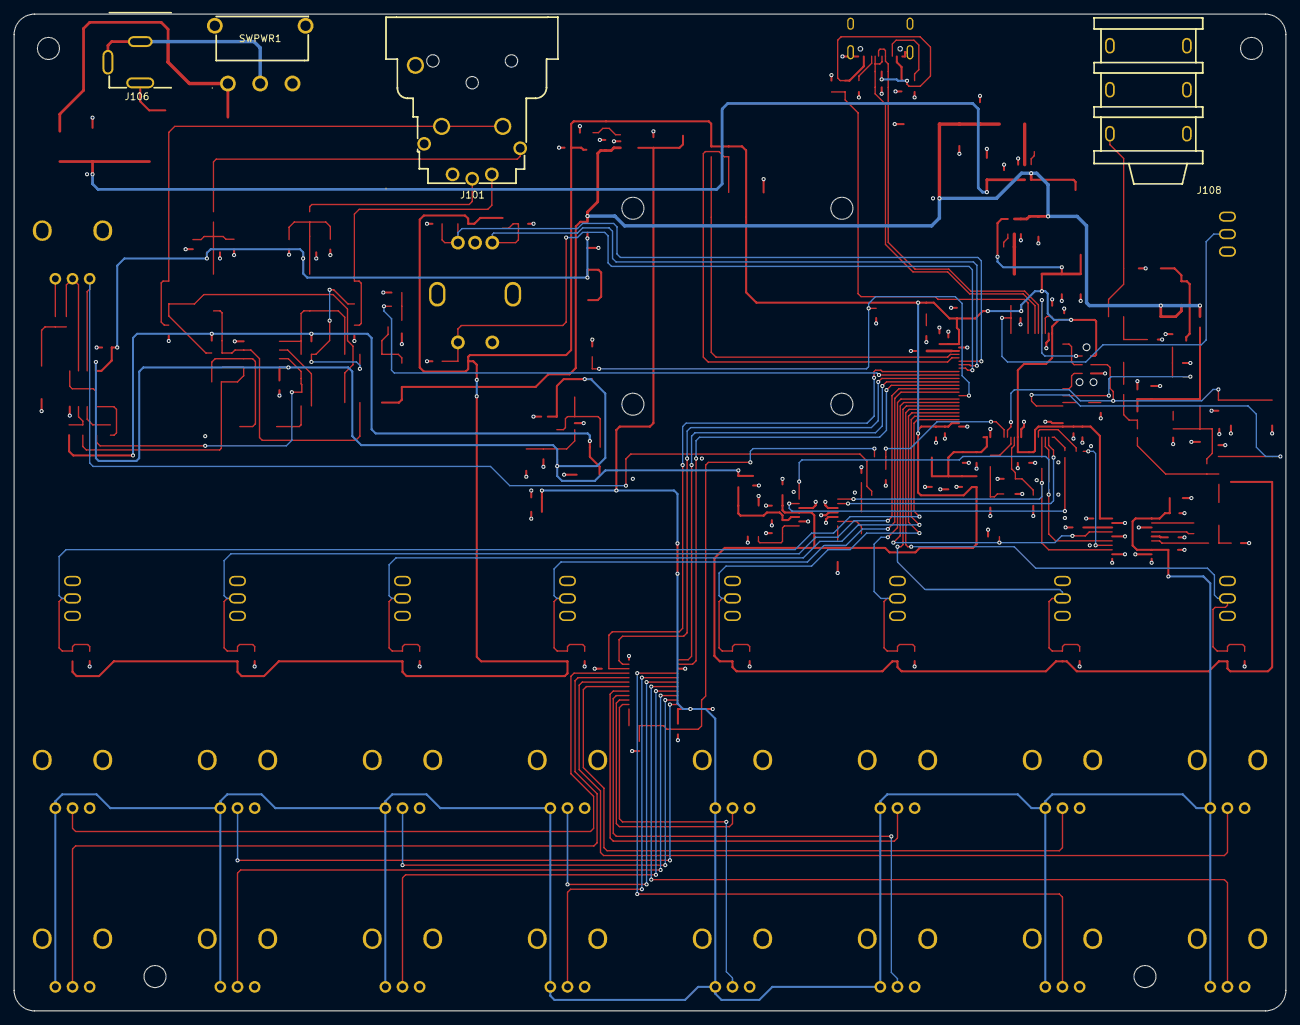
[picture p20: board cubevox.kicad_pcb from below]

Board: 4 copper layers, 185.0 x 145.0 mm, 246 parts (4 on the bottom side), 132 nets.

Other parts of the board:
FID1, FID2, FID3: Fiducial_1mm_Mask2mm
