peterdelecto/cubevox/firmware/cubevox/cubevox.ino

// cubevox firmware, STM32H743VIT6. Panel + layout + settings -> ChainSnapshot -> audio interrupt.

#include <Arduino.h>

#include "board/audio.h"
#include "board/bench.h"
#include "board/bench_panel.h"
#include "board/boot_health.h"
#include "board/boot_report.h"
#include "board/build_kind.h"
#include "board/controls.h"
#include "board/device_serial.h"
#include "board/dfu.h"
#include "board/diag_service.h"
#include "board/display_sh1106.h"
#include "board/fault.h"
#include "board/input.h"
#include "board/input_jack.h"
#include "board/mid_song_mark.h"
#include "board/mute.h"
#include "board/pins.h"
#include "board/planned_reset.h"
#include "board/power_sense.h"
#include "board/record_service.h"
#include "board/serial_link.h"
#include "board/start_timing.h"
#include "board/usb_link.h"
#include "core/compose.h"
#include "core/gate_floor.h"
#include "core/jack_switch.h"
#include "core/layout.h"
#include "core/load_led.h"
#include "core/loop_policy.h"
#include "core/protocol.h"
#include "core/restart_rule.h"
#include "core/settings.h"
#include "core/timing.h"
#include "core/version.h"
#include "ui/actions.h"
#include "ui/face.h"
#include "ui/gui.h"
#include "ui/menu.h"
#include "ui/screen_dim.h"
#include "ui/splash.h"

namespace {

constexpr uint32_t kStatsMs = 5000;

Layout gLayout = defaultLayout();
Settings gSettings;
Menu gMenu;
Face gFace;
Splash gSplash;
ScreenDim gDim;
JackSwitch gJack{Settings().inputJack};
Display* gDisplay = nullptr;
Canvas gCanvas;
bool gAudioRunning = false;
PublishGate gPublish;
FallingEdge gMenuClosed;
Every gStats{kStatsMs};
Every gLoadRefresh{kUiTickMs};  // the load figures move once a second; the UI tick reads them
int gLoadPercent = 0;
int gMeanLoadPercent = 0;
bool gAudioLive = false;  // audio running and not stalled; the LED's gate
BlockTroubleClock gTrouble;  // time since the last late, dry or overrun block, for the LED's flash
int gLedDuty = -1;  // the last PWM duty written, so an unchanged level costs no timer write

// The user LED (PB7, TIM4_CH2) runs on 12-bit PWM at 1 kHz.
constexpr int kLedPwmBits = 12;
constexpr uint32_t kLedPwmHz = 1000;
constexpr int kLedPwmMax = (1 << kLedPwmBits) - 1;

// FPSCR and FPDSCR bit 24: flush subnormal results and operands to zero. The input filters decay
// toward silence, and a subnormal state would cost the FPU extra cycles on every sample.
constexpr uint32_t kFlushToZero = 1u << 24;

// FPSCR covers the main loop. The FPU loads FPDSCR into FPSCR on exception entry, so FPDSCR covers
// the audio interrupt that runs the filters.
void flushDenormalsToZero() {
  __set_FPSCR(__get_FPSCR() | kFlushToZero);
  FPU->FPDSCR |= kFlushToZero;
}

void reportBoot() { bootReport(sh1106Present()); }

// True once the first snapshot has gone to the audio interrupt. Until then the blocks pass silence,
// so the relay stays open.
bool gSnapshotPublished = false;

// The snapshot publishSnapshot builds. It is over a kilobyte, so it lives here and not on the stack the
// interrupts share.
ChainSnapshot gCompose;

// Rebuilds the snapshot from the layout, panel and settings, then hands it to the audio interrupt.
void publishSnapshot() {
  composeSnapshotInto(gCompose, gLayout, controlsReading(), gSettings, benchOverrides(), audioHeldMask());
  audioPublish(gCompose);
  gSnapshotPublished = true;
  startTimingNoteSnapshot(millis());
}

// True on the pass after a layout apply or a card swap, which clears the load rule's holds.
bool gLayoutApplied = false;

// Runs the load rule over the pass. A step goes to DIAG.TXT, and any change of the held mask, a step
// or a release, sends a snapshot so the slot's fade starts at once.
void runLoadRule(uint32_t nowMs) {
  const uint8_t before = audioHeldMask();
  const std::array<bool, kSlotCount> toggles = slotToggles(controlsReading(), benchOverrides());
  const LoadStep step = audioLoadRulePoll(nowMs, gLayout, toggles, gLayoutApplied);
  gLayoutApplied = false;
  if (step.slot >= 0) {
    char text[64];
    loadStepText(step, text, sizeof text);
    diagNoteAudioFault(text);
  }
  if (audioHeldMask() != before) gPublish.markStale();
}

// The encoder's turns and clicks for the menu. While a planned reset waits on the flash the menu
// takes none, so a turn cannot leave the confirm screen behind an update that is already starting.
UiInput menuInput(uint32_t nowMs) {
  const UiInput input = inputPoll(nowMs);
  return plannedResetPending() ? UiInput{} : input;
}

// Applies what the menu asked for. Returns true when a setting or the layout changed. A new layout
// takes the same path as one from the app: the snapshot goes out stale, the audio fades and resets
// the engines whose card changed, and the save writes the layout record.
bool applyAction(UiAction action, uint32_t nowMs) {
  switch (ui::applyAction(action, gSettings, gLayout)) {
    case ui::ApplyResult::SettingsChanged: return true;
    case ui::ApplyResult::LayoutChanged:
      gLayoutApplied = true;
      gPublish.markStale();
      return true;
    case ui::ApplyResult::EnterDfu: enterDfu(nowMs); break;
    case ui::ApplyResult::None: break;
  }
  return false;
}

// A settings change saves kSaveDebounceMs after the last click, or at once when the menu closes,
// so the last click is in flash by the time Adam plays.
void saveSettings(bool changed, uint32_t nowMs) {
  if (changed) recordRequestSave(gLayout, gSettings, nowMs);
  if (gMenuClosed.update(gMenu.open())) recordSkipDebounce();
}

const char* layoutName() { return layoutDisplayName(recordName()); }

void replyStatus(uint32_t id) {
  const AudioLoad load = audioTakeLoad();
  protocol::Status status;
  status.cpuMeanPercent = load.meanPercent;
  status.cpuWorstPercent = load.worstPercent;
  status.late = load.late;
  status.dryBlocks = load.dryBlocks;
  status.muted = muteActive();
  status.seq = recordSequence();
  status.recordErrors = recordErrors();
  status.serialDropped = serialDropped();
  status.strayBytes = serialStrayBytes();
  status.bootFails = bootHealthFails();
  status.updateReason = bootHealthLastReason();
  const AudioHealth health = audioHealth();
  status.overruns = health.overruns;
  status.saiErrors = health.errors.count;
  status.restarts = health.restarts;
  status.nanBlocks = health.nanBlocks;
  status.heldMask = audioHeldMask();
  status.steps = audioLoadSteps();
  status.stalled = faultAudioStalled();
  status.powerTrips = powerSenseTrips();
  status.floorDbfs = peakDbfs(audioTakeGatePeak());
  protocol::replyStatus(serialWriter(), id, status);
}

// Validates and adopts a layout from the app. The save runs after the usual debounce.
void replySetLayout(const protocol::Request& req, uint32_t nowMs) {
  Layout next = defaultLayout();
  char err[protocol::kErrorBytes];
  if (!protocol::resolveLayout(req, next, err, sizeof err)) {
    protocol::replyError(serialWriter(), req.id, err);
    return;
  }
  gLayout = next;
  protocol::applySettings(req, gSettings);  // only the fields the request carried
  recordSetName(req.name);
  recordRequestSave(gLayout, gSettings, nowMs);
  gLayoutApplied = true;
  gPublish.markStale();  // goes out after controlsPoll() re-seeds the knobs for the new cards
  protocol::replyOk(serialWriter(), req.id);
}

// Replies after the op runs, so a failure reaches the host. Fault and spin never return, so
// they reply first and flush inside the drill before they act.
void replyBench(const protocol::Request& req) {
  protocol::Writer& out = serialWriter();
  if (req.op == BenchOp::Fault || req.op == BenchOp::Spin) protocol::replyOk(out, req.id);  // the drill flushes it
  BenchArgs args;
  args.slot = req.benchSlot;
  args.knob = req.benchKnob;
  args.value = req.benchValue;
  args.cycles = req.benchCycles;
  args.blocks = req.benchBlocks;
  const BenchResult result = benchRun(req.op, args, reportBoot);
  if (result.republish) gPublish.markStale();
  if (result.error) {
    protocol::replyError(out, req.id, result.error);
  } else {
    protocol::replyOk(out, req.id);
  }
}

void onRequest(const char* line, uint32_t nowMs) {
  protocol::Writer& out = serialWriter();
  protocol::Request req;
  char err[protocol::kErrorBytes];
  if (!protocol::parseRequest(line, req, err, sizeof err, kBenchBuild)) {
    protocol::replyError(out, req.id, err);
    return;
  }
  switch (req.cmd) {
    case protocol::Command::Hello:
      protocol::replyHello(out, req.id, kFirmwareVersion, layoutName(), gLayout, kBenchBuild, deviceSerial(), &gSettings);
      break;
    case protocol::Command::GetLayout: protocol::replyLayout(out, req.id, layoutName(), gLayout, gSettings); break;
    case protocol::Command::SetLayout: replySetLayout(req, nowMs); break;
    case protocol::Command::Status: replyStatus(req.id); break;
    case protocol::Command::EnterDfu:
      protocol::replyOk(out, req.id);
      enterDfu(nowMs);
      break;
    case protocol::Command::Bench: replyBench(req); break;
  }
}

// The relay switches only while the output is fully muted; the mute is held until it settles.
void runJackSwitch(uint32_t nowMs) {
  gJack.update(nowMs, benchJack(gSettings.inputJack), muteFullyMuted());
  // Unseeded knobs read 0 and the first snapshot is not in, so stay muted; the panel test can hold the
  // mute too.
  muteHold(gJack.holdMute() || !controlsSeeded() || !gSnapshotPublished || benchMuteHeld());
  inputJackApply(gJack.relay());
}

// The face owns the canvas except while the boot splash or the bench OLED pattern is up; it
// dissolves in from what they left once either ends. It ticks at 25 frames a second and only
// after the panel has taken the last frame. Without a panel the pages stay dirty, so the face waits.
void drawFace(const UiContext& ctx, uint32_t nowMs) {
  switch (gSplash.draw(nowMs, kFirmwareVersion, gCanvas, mutePowerOnWait(), faultRestartCode())) {
    case SplashStep::Up: return;
    case SplashStep::Ended: gFace.invalidate(); break;
    case SplashStep::Off: break;
  }
  switch (benchPanelPattern(gCanvas)) {
    case BenchPattern::Up: return;
    case BenchPattern::Ended: gFace.invalidate(); break;
    case BenchPattern::Off: break;
  }
  if (gFace.due(nowMs, gCanvas)) {
    const level::InputEnergy input = audioTakeInputEnergy();
    gDim.noteVoice(input, nowMs);  // the screen reads the voice from the energy the level bar reads
    gFace.tick(nowMs, ctx, input, audioScope(), gMenu, gCanvas);
  }
}

// Reads the DEBUG figure (the worst block, shown only with DEBUG on), the LED's mean and whether
// audio runs, once per UI tick. audioHealth() masks the audio interrupt briefly, so it is not read
// every pass; a stall darkens the LED within one tick.
void refreshLoad(uint32_t nowMs) {
  if (!gLoadRefresh.due(nowMs)) return;
  gLoadPercent = gSettings.debug ? audioWorstLoadPercent() : 0;
  gMeanLoadPercent = audioMeanLoadPercent();
  gAudioLive = gAudioRunning && !faultAudioStalled();
}

// Sets the user LED's brightness from the mean audio load (core/load_led.h). A high level lights
// it (the bootloader board file's LED_STATE_ON), so the duty is the brightness. The LED is dark
// while audio is not running or has stalled. The timer is written only when the duty
// changes, because every analogWrite reloads the timer's period.
void driveLoadLed(uint32_t nowMs) {
  gTrouble.note(audioTroubleBlocks(), nowMs);
  const float level = loadLedLevel(gMeanLoadPercent, kLoadLedLimitPercent, gAudioLive, gTrouble.sinceMs(nowMs));
  const int duty = static_cast<int>(level * static_cast<float>(kLedPwmMax) + 0.5f);
  if (duty == gLedDuty) return;
  gLedDuty = duty;
  analogWrite(pins::kUserLed, duty);
}

}  // namespace

// The bootloader starts the watchdog at 16 s (CV_WATCHDOG_BOOT_MS) right before the jump, and
// faultWatchdogStart() sets the box's own 2 s at the end. The refreshes after recordBoot and after
// audioInit split the time between into three stretches, each well inside 16 s:
//   1. Up to the end of the ECC recovery, at most 10.3 s: the clock setup's waits (0.2 s), the
//      power sense ADC (tens of ms), two erases at the driver's 5 s bound and eight program words
//      at 5 ms each.
//   2. The audio start, well under 1 s: the HAL's bounded PLL3, SAI and DMA waits (tens of ms).
//   3. From there to faultWatchdogStart(), well under 1 s: the panel's start (five tries 20 ms
//      apart, each a bus recovery of about 0.3 ms and one polled wait that gives up within about
//      15 ms, so 0.2 s at the most) and the HAL's bounded ADC wait (tens of ms).
//
// Audio starts before the panel, USB and the menu on every start, so a panel that hangs never delays
// the first block. A warm start (core/restart_rule) skips the 6 s power-on wait and the mux scan's
// wait for 3V3A.
void setup() {
  // First, so nothing that can fault or block runs ahead of it: it reads the boot block and four
  // words of flash and touches no pin. The static constructors and the core's clock setup run before
  // setup() and are not part of this application's start.
  midSongMarkClearFailedStarts();
  startTimingBegin(millis());
  flushDenormalsToZero();  // before the audio interrupt can run
  muteInit();  // MUTE_N and XSMT low before anything slow
  powerSenseInit();  // needs the mute pins; a failure prints in the boot report
  inputJackInit();  // PAD_EN low = MIC; a reset leaves the pin an input, so every start drives it
  faultInit();  // before recordBoot: the ECC recovery reads the fault record this loads
  const bool warm = isWarmStart(faultResetFlags(), powerSenseHasReading(), powerSenseTripped());
  startTimingSetWarm(warm);
  if (warm) muteWarmStart();
  recordBoot(gLayout, gSettings, millis());  // waits on the ECC recovery's erases, if any
  faultWatchdogKick();  // ends stretch 1 above
  gJack = JackSwitch(gSettings.inputJack);  // output is still muted, so no dip
  inputJackApply(gSettings.inputJack);

  gAudioRunning = audioInit();
  if (gAudioRunning) muteClocksRunning();
  faultWatchdogKick();  // ends stretch 2 above

  analogWriteResolution(kLedPwmBits);
  analogWriteFrequency(kLedPwmHz);
  driveLoadLed(millis());  // PWM at duty 0: dark until the first load figure
  usbLinkInit();  // USB attaches from loop() once VBUS is seen

  controlsInit(warm);
  gDisplay = &sh1106Display();  // starts the panel; one that does not answer is retried once a second
  gDisplay->setContrast(brightnessLevel(gSettings.brightness).contrast);  // goes out before the splash's first page
  inputInit();

  faultWatchdogStart();  // every init is behind us; from here loop() must keep running
  bootHealthInit();  // after the watchdog: a start only counts as healthy with both running
  diagInit();  // after recordBoot (ECC recovery) and bootHealthInit (failed starts, bootloader reason)
  if (warm && faultRestartCode() != AudioFaultCause::None) {
    gSplash.startAfterWarmError(millis());  // 6 s, ended by a touch, so Adam reads the error code
  } else {
    gSplash.start(millis());
  }
  gDim.start(millis());
}

void loop() {
  const uint32_t nowMs = millis();
  faultWatchdogKick();
  faultAudioWatch(nowMs, gAudioRunning, audioPoll(nowMs));
  bootHealthPoll(nowMs);

  usbLinkPoll(nowMs);
  if (usbLinkTerminalOpened()) {
    serialLinkSessionStart();
    reportBoot();
  }
  serialLinkPoll(nowMs, onRequest);

  controlsPoll(nowMs, gLayout);
  benchPanelPoll(nowMs);
  powerSensePoll(nowMs);  // before mutePoll, so a trip it clears starts the release this pass
  mutePoll(nowMs, gSettings.topSwitch);

  const UiInput input = menuInput(nowMs);
  if (input.detents != 0 || input.click || input.hold || input.press) {
    gDim.noteActivity(nowMs);
    gSplash.noteTouch();
  }
  const bool settingsChanged = applyAction(gMenu.update(input, nowMs, gLayout), nowMs);
  saveSettings(settingsChanged, nowMs);
  recordPoll(nowMs);
  diagPoll();
  plannedResetPoll(nowMs);  // after both stores took their step this pass
  runJackSwitch(nowMs);
  runLoadRule(nowMs);  // before the publish, so a hold or a release goes out this pass
  // The first publish carries the real panel; mutePoll sees the hold lift on the next pass.
  if (gPublish.take(controlsSeeded(), controlsTakeChanged() || settingsChanged)) publishSnapshot();

  const bool switchOn = topSwitchEngaged(gSettings.topSwitch, muteActive(), muteBypassOn());
  gDim.noteTopSwitch(switchOn, nowMs);
  refreshLoad(nowMs);
  const UiContext ctx{gLayout, controlsReading(), gSettings, switchOn, gLoadPercent, audioHeldMask()};
  LastMoved touch;
  if (controlsTakeTouch(touch)) {
    gDim.noteActivity(nowMs);
    gSplash.noteTouch();
    gFace.knobMoved(gLayout, ctx.panel, touch, nowMs);
  }
  ToggleFlip flip;
  if (controlsTakeToggle(flip)) {
    gDim.noteActivity(nowMs);
    gSplash.noteTouch();
    gFace.toggleFlipped(gLayout, flip, nowMs);
  }
  drawFace(ctx, nowMs);
  gDisplay->setContrast(gDim.contrast(nowMs, gSettings.brightness));
  gDisplay->flushStep(gCanvas);
  driveLoadLed(nowMs);
  if (gStats.due(nowMs)) reportAudioStats();
}
