peterdelecto/cubevox/engine/formant_fx.h

#pragma once

#include <array>
#include <cmath>
#include <cstring>
#include <limits>

#include "engine/autotune_fx.h"
#include "engine/common.h"
#include "engine/crossfade_hold.h"
#include "engine/dsp.h"
#include "engine/fastmath.h"
#include "engine/formant_params.h"
#include "engine/formant_voice.h"
#include "engine/input_ring.h"
#include "engine/pitch.h"
#include "engine/psola.h"
#include "engine/smooth.h"
#include "engine/upstream_pitch.h"

// The engine of the Formant card and of Apraxia, which drives the same engine with its MIX pinned at 1.
// It keeps a ring of its own input and cuts a grain voice from it. The voice plays at pitch ratio 1 and
// moves the formants by the SHIFT rate. The base, the other half of MIX, is the same ring read at the
// voice's lag, so the two line up at every setting and at SHIFT 0 the voice rebuilds the base.
//
// The grains sit on a period grid. Anywhere but directly behind the Autotune card the engine runs a tracker
// of its own on its own input, since the input can carry two pitches at once, and the voice reads at the
// tracker's alignment less the delay already on the audio, held over the floor a grain centred on a mark
// needs.
//
// Directly behind the Autotune card (only Empty slots between) the engine joins Autotune's grain pass. The
// chain feeds it the audio that entered Autotune (feed), the engine reads Autotune's tracker, and it cuts its
// grains from that audio, on Autotune's grid, at Autotune's delay. The corrected voice and the formant move
// then come from one cut, so the voice waits for Autotune's delay once. The audio the engine receives is
// `tuned` times Autotune's corrected voice plus `dry` times Autotune's input, and the engine renders the same
// shares: the voice at Autotune's pitch ratio for the first, a voice at ratio 1 for the second. Both start at
// the same grid, so Autotune's crossfade, whether its toggle or its fade, moves the voice from one to the
// other with no jump in the read position. Settled off, the ratio 1 voice alone runs, and it equals the voice
// that cuts the card's own input. The base is the audio as it arrives, with the share of Autotune's input
// moved to the voice's delay.
//
// The toggle's fade crosses the card's input to the mixed output over the 20 ms one-pole. The mix has
// linear gains, and a level gain that follows how far the base and the voice correlate (see levelGainAt)
// holds the level across SHIFT. A stopped card in the layout keeps writing its ring (idle), so a switch-on
// finds the voice's history. After a clear (power-on, a layout swap) the card comes on only once its ring
// holds the voice's deepest read, and passes its input until then, so it never plays the clear's zeros.
// A voice resets on its enable edge only once its crossfade has settled at zero, so a quick
// off and on keeps the running voice. Settled off, the output is the input bit for bit.

namespace cv {

constexpr int kFormantRingLen = formant_detail::kGrainRingLen;
static_assert(PitchTracker::kReplaySpan < kFormantRingLen, "the ring holds a tracker replay's history");

// The crossfade's chunk ramps run through a per-sample one-pole of 5 ms. The base sits a lag behind the
// input, so a ramp that starts with a slope puts a kink in the output of that slope times the difference
// between the two; the one-pole turns each slope change into a smooth bend.
constexpr float kFadeSmooth = smooth::kSmooth5msCoef;

// A switch-on's crossfade counts as done once the smoothed fade sits this near 1. The 5 ms one-pole parks
// about 7e-6 under 1, where its step falls below a float's resolution.
constexpr float kRiseDone = 1e-4f;
class FormantFx {
 public:
  using Voice = formant_detail::FormantPsolaVoiceT<kFormantRingLen>;

  FormantFx() {
    voice_.latchGain(true);
    tuned_.latchGain(true);
    reset();
  }

  // Leaves the ring zero and the tracker cold, as at power-on and when a layout swap places the card.
  void reset() {
    ring_.clear();
    zeroRun_ = kFormantRingLen;
    tracker_.reset();
    settle();
    fedN_ = 0;
    idle_ = false;
  }

  // A call for each block the card sits stopped in the layout. It writes the block into the ring, unless the
  // Autotune slot fed the ring this block, and idles the card's own tracker. A switch-on then finds the
  // voice's history in the ring and the tracker replays it (pitch.h) instead of starting cold. The first call
  // after the engine ran settles the crossfade and the voices at off.
  void idle(const float* in, int n) {
    if (!idle_) settle();
    if (fedN_ == n) {
      fedN_ = 0;
    } else {
      fedN_ = 0;
      for (int c = 0; c < n; c += kBlock) {
        const int m = n - c < kBlock ? n - c : kBlock;
        noteZeros(in + c, m);
        ring_.write(in + c, m);
      }
    }
    tracker_.idle(n);
  }

  // Puts the n samples that enter the Autotune card into the ring, ahead of the process() or idle() call of
  // the card directly behind it. The chain calls it from the Autotune slot every block the slot runs, so the
  // ring holds Autotune's input whether the card is on or off. A process() that joins Autotune's grain pass
  // then reads the ring and does not write the audio it is handed. Only a call of at most kBlock samples can
  // join, since Autotune holds the grain feed of its last chunk only; a longer one writes nothing.
  void feed(const float* in, int n) {
    if (n <= 0 || n > kBlock) return;
    fedZeroBefore_ = zeroRun_;
    noteZeros(in, n);
    fedFirst_ = ring_.write(in, n);
    fedN_ = n;
  }

  // Runs n samples of any call length, in chunks of at most kBlock. in and out may be the same buffer.
  // `up` names the Autotune engine, with its tracker, when the card sits directly behind the Autotune card,
  // and is empty otherwise. The card joins Autotune's pass only after a feed() of the same n. Without one, or
  // with an `up` that names no engine, it runs on its own ring and its own tracker.
  void process(const float* in, float* out, int n, const FormantParams& p, const UpstreamPitch& up = UpstreamPitch{}) {
    idle_ = false;
    for (int c = 0; c < n; c += kBlock) chunk(in + c, out + c, n - c < kBlock ? n - c : kBlock, p, up);
  }

  // The crossfade, 0 off .. 1 on, and SHIFT after its glide in semitones, for the tests and the render
  // tool.
  float fade() const { return fade_; }
  float shiftSemis() const { return shiftSm_; }

  // True while the card reads a tracker's period: the card is wanted at these params or its crossfade is up.
  // At MIX 0 it passes its input and reads none.
  bool needsTracker(const FormantParams& p) const { return wantedBy(p) || fade_ > 0.0f; }

  // The delay of the card's output behind its input in samples: the delay the voice and the base play at,
  // weighted by the toggle's fade. The input crosses to the mix as the fade rises. Cutting from Autotune's
  // ring, the card waits for Autotune's corrected voice and adds only the part of its delay that
  // Autotune's own latency (its corrected share, squared) does not already count.
  float outputLatency() const { return fade_ * baseLag_ * latencyShare_; }

  // The grain grid of the voice that cuts the audio of Autotune's input, for the Autotune engine to take
  // up when its corrected voice starts. Invalid unless that voice is running.
  GridMarks gridMarks() const { return grouped_ && dryRuns_ ? voice_.marks() : GridMarks{}; }

  // The tracker of the card's own, for the tests.
  const PitchResult& ownPitch() const { return tracker_.result(); }

  // Test hooks: the card cut from Autotune's input in the last chunk, the ring, the floats the ring clears
  // have zeroed, the lag the voice read at last, and how far behind the ring's head its oldest grain reads.
  bool groupedForTest() const { return grouped_; }
  const InputRing<kFormantRingLen>& ringForTest() const { return ring_; }
  uint32_t ringClearedForTest() const { return ring_.clearedForTest(); }
  float lagForTest() const { return lag_; }
  int voiceReachForTest() const { return voice_.reachForTest(ring_.head()); }

 private:
  // The crossfade's fade and the mix's gains: the base's share, and the shifted voice's with its trim.
  struct Gains {
    float fade = 0.0f;
    float base = 1.0f;
    float voice = 0.0f;
    float trim = 1.0f;
  };

  // The sums of base * base, voice * voice and base * voice over a chunk, for the running powers.
  struct Sums {
    float bb = 0.0f;
    float vv = 0.0f;
    float bv = 0.0f;
  };

  // Where a chunk cuts from. With `feed` null the card cuts from the audio it receives. Otherwise it cuts from
  // Autotune's input, which feed() put in the card's ring: `a0` and `a1` are the corrected voice's share of the voice (linear, 0 for Autotune's
  // input alone, 1 for the corrected voice alone) at the chunk's first and last sample, and `s0` and `s1`
  // the gain of the Autotune slot's engine against its input there.
  struct GroupChunk {
    const GroupFeed* feed = nullptr;
    float a0 = 0.0f;
    float a1 = 0.0f;
    float s0 = 1.0f;
    float s1 = 1.0f;
  };

  static bool wantedBy(const FormantParams& f) { return f.on && f.mix > 0.0f; }

  // The chunk's source. The card joins Autotune's pass only when the chain has fed it this chunk's audio and
  // handed over the Autotune engine, whose last chunk is this one.
  GroupChunk groupOf(const UpstreamPitch& up, int n) const {
    GroupChunk g;
    if (up.group == nullptr || up.result == nullptr || fedN_ != n) return g;
    const GroupFeed& f = up.group->groupFeed();
    if (f.n != n) return g;
    g.feed = &f;
    g.s0 = up.slotGain0;
    g.s1 = up.slotGain1;
    g.a0 = f.fade0 * g.s0;
    g.a1 = f.fade1 * g.s1;
    return g;
  }

  void chunk(const float* in, float* out, int n, const FormantParams& p, const UpstreamPitch& up) {
    const bool wanted = wantedBy(p);
    const GroupChunk group = groupOf(up, n);
    int first = fedFirst_;
    int zeroBefore = fedZeroBefore_;
    if (group.feed == nullptr) {
      first = ring_.write(in, n);
      zeroBefore = zeroRun_;
      noteZeros(in, n);
    }
    fedN_ = 0;
    const PitchResult& pr = group.feed != nullptr ? *up.result : ownPitchFor(in, n, first, wanted);

    // The two sources read different rings, so a change of source starts the voices over. The layout
    // changes that cause one clear the engines anyway.
    if ((group.feed != nullptr) != grouped_) {
      grouped_ = group.feed != nullptr;
      resetVoices();
      lagSet_ = false;
    }

    // A voiced frame on the edge of the tracker's range, or past it, reads the edge, not the note, so the
    // card steps aside for the dry voice until a frame inside the range returns. Unvoiced frames hold the
    // state, as they hold the period. The period stays set while the crossfade is up, so the grains never
    // lose their pitch mid-fade. The card also waits until the ring holds what the voice reads.
    if (pr.voiced) rangeBad_ = pr.clamped || pr.outOfRange;
    const bool on = wanted && pr.period > 0.0f && !rangeBad_ && ringHolds(pr.period, group, n);

    // A voice coming on starts clean only when its crossfade has settled at zero, whether the toggle, the
    // range or the ring held it off; while the crossfade is still up the running voice carries on. The
    // first rise after a switch-on runs the 12 ms S curve (rise_) with its level held (cross_), and the
    // level gain starts from the correlation SHIFT gives (seed_).
    if (on && !wasOn_ && fade_ == 0.0f) {
      resetVoices();
      resetLevelGain();
      shiftSet_ = false;
      lagSet_ = false;
      switching_ = switchedOn_;
      rise_ = switchedOn_ ? 0 : -1;
      switchedOn_ = false;
      seed_ = switching_;
    }
    wasOn_ = on;
    if (p.on && !wanted) switchedOn_ = false;  // MIX 0: the card's rise waits for the knob, not the toggle
    const float mixTarget = smooth::clamp01(p.mix);
    const float fadeTarget = on ? 1.0f : 0.0f;
    if (!on) {
      rise_ = -1;
      switching_ = false;
    }
    riseFrom_ = -1;
    if (fresh_) {
      mix_ = mixTarget;
      fade_ = fadeTarget;
      fadeSm_ = fadeTarget;
      gains_ = gainsNow();
      fresh_ = false;
      rise_ = -1;
    }
    if (fade_ == 0.0f && fadeTarget == 0.0f && fadeSm_ == 0.0f) {
      mix_ = mixTarget;
      shiftSet_ = false;
      lagSet_ = false;
      gains_ = gainsNow();
      if (out != in) std::memmove(out, in, sizeof(float) * static_cast<size_t>(n));
      cross_.reset();
      cross_.pass(n);
      return;
    }
    const Gains g0 = gains_;
    if (mix_ != mixTarget || fade_ != fadeTarget) {
      const float a = coef_.at(n);
      mix_ = smooth::step(mix_, mixTarget, a);
      fade_ = rise_ >= 0 ? riseStep(n) : smooth::step(fade_, fadeTarget, a);
    }
    prepareVoice(p, n, pr, group);
    gains_ = gainsNow();
    const Gains g1 = gains_;
    clearIdlePowers();
    const float level0 = levelGain_;
    levelGain_ = smooth::step(level0, levelGainAt(mix_), coef_.at(n));
    mix(in, out, n, first, zeroBefore, g0, g1, level0, group);
  }

  // True when the ring holds the deepest read of a chunk of n samples since its last clear: the voice's lag,
  // two periods for a grain's reach either side of its mark, and the chunk. A full ring holds every read.
  bool ringHolds(float period, const GroupChunk& group, int n) const {
    const int filled = ring_.filled();
    if (filled >= kFormantRingLen) return true;
    const float p = PitchTracker::clampPeriod(period);
    const float wanted = group.feed != nullptr ? group.feed->delay : static_cast<float>(PsolaVoice::kGrainDelay) + p;
    const float deepest = formant_detail::clampLag<kFormantRingLen>(wanted, period) + 2.0f * p + static_cast<float>(n);
    return static_cast<float>(filled) >= deepest;
  }

  // The crossfade, the voices and the level gain at off, the next chunk taking its targets outright. The
  // ring and the tracker stay.
  void settle() {
    resetVoices();
    resetLevelGain();
    mix_ = 0.0f;
    fade_ = 0.0f;
    fadeSm_ = 0.0f;
    shiftSet_ = false;
    gains_ = Gains{};
    wasOn_ = false;
    rangeBad_ = false;
    lagSet_ = false;
    lag_ = 0.0f;
    grouped_ = false;
    latencyShare_ = 1.0f;
    fresh_ = true;
    idle_ = true;
    switchedOn_ = true;
    switching_ = false;
    rise_ = -1;
    seed_ = false;
    cross_.reset();
  }

  // The crossfade n samples further along the S curve of a switch-on's rise. The mix reads the curve sample by
  // sample from riseFrom_, so any call length gives the same fade. The rise ends at 1.
  float riseStep(int n) {
    riseFrom_ = rise_;
    rise_ += n;
    const float at = riseAt(rise_);
    if (rise_ >= kFormantRiseSamples) rise_ = -1;
    return at;
  }

  // The rise's S curve, 3x^2 - 2x^3, at sample k of it.
  static float riseAt(int k) {
    if (k >= kFormantRiseSamples) return 1.0f;
    const float x = static_cast<float>(k) * (1.0f / static_cast<float>(kFormantRiseSamples));
    return x * x * (3.0f - 2.0f * x);
  }

  // At a switch-on the running powers start from the first chunk's base and voice, or from the stand-in
  // absorbPowers uses for an unheard base, and the level gain takes its value at once, so a card that comes
  // on at MIX between 0 and 100 % starts at its level instead of ramping up to it over 40 ms. Returns the
  // gain.
  float seedLevelGain(const float* base, bool baseHeard, int n) {
    Sums s;
    for (int j = 0; j < n; ++j) {
      const size_t k = static_cast<size_t>(j);
      const float v = voiceBuf_[k];
      const float b = baseHeard ? base[k] : 0.0f;
      s.bb += b * b;
      s.vv += v * v;
      s.bv += b * v;
    }
    const float inv = 1.0f / static_cast<float>(n);
    voiceSq_ = s.vv * inv;
    baseSq_ = baseHeard ? s.bb * inv : voiceSq_;
    baseVoice_ = baseHeard ? s.bv * inv : coherenceAt(shiftSm_) * voiceSq_;
    levelGain_ = levelGainAt(mix_);
    seed_ = false;
    return levelGain_;
  }

  // Starts the voices over: the ones that cut from Autotune's input start when the share they serve comes up.
  void resetVoices() {
    voice_.reset();
    tuned_.reset();
    dryRuns_ = false;
    tunedRuns_ = false;
  }

  // The card's own tracker result, for a chunk that cuts from its own ring. The tracker runs while the card
  // is on or fading. The 48 kHz fine pass runs, since the grains must sit on the sung pitch.
  const PitchResult& ownPitchFor(const float* in, int n, int first, bool wanted) {
    tracker_.readOutOfRange(wanted);
    if (wanted || fade_ > 0.0f) {
      tracker_.push(in, n, true, true, PitchTracker::History{ring_.data().data(), kFormantRingLen, first});
    } else {
      tracker_.idle(n);
    }
    return tracker_.result();
  }

  // SHIFT glides through the 20 ms one-pole, in semitones. A bare step leaves a bump in the grain window
  // sum that reads x1.23 of steady-state curvature next to SHIFT 0, and the glide holds every step under
  // x1.02. It takes the knob outright on the first call after the voice starts. The playback rate and the
  // trim follow the glided SHIFT and are worked out when it moves.
  //
  // Cutting from its own ring the voice plays at pitch ratio 1 on the tracker's period and reads at the
  // tracker's alignment, the grain delay plus a period. The base's delay slides toward the voice's at
  // kDryLagSlew a sample and starts on it. Cutting from Autotune's input is prepareGroup's.
  void prepareVoice(const FormantParams& f, int n, const PitchResult& pr, const GroupChunk& group) {
    const int st = f.shiftSt < -kFormantVoiceMaxShiftSt
                       ? -kFormantVoiceMaxShiftSt
                       : (f.shiftSt > kFormantVoiceMaxShiftSt ? kFormantVoiceMaxShiftSt : f.shiftSt);
    const float target = static_cast<float>(st);
    if (!shiftSet_) {
      shiftSm_ = target;
      shiftSet_ = true;
    } else if (shiftSm_ != target) {
      shiftSm_ = smooth::step(shiftSm_, target, coef_.at(n));
    }
    if (shiftSm_ != rateSemis_) {
      shiftRate_ = exp2Fast(shiftSm_ * (1.0f / 12.0f));
      rateSemis_ = shiftSm_;
    }
    if (!(f.tuning == tuning_)) {
      tuning_ = f.tuning;
      trimSemis_ = std::numeric_limits<float>::quiet_NaN();
    }
    if (shiftSm_ != trimSemis_) {
      trim_ = dbToGainFast(clampf(trimDbAt(shiftSm_), -kFormantMaxTrimDb, kFormantMaxTrimDb));
      trimSemis_ = shiftSm_;
    }
    if (group.feed != nullptr) {
      prepareGroup(n, pr, group);
      return;
    }
    const float aligned = static_cast<float>(PsolaVoice::kGrainDelay) + PitchTracker::clampPeriod(pr.period);
    const float lag = formant_detail::clampLag<kFormantRingLen>(aligned, pr.period);
    voice_.prepare(pr.period, 1.0f, shiftRate_, lag, kBlock);
    lag_ = lag;
    latencyShare_ = 1.0f;
    followVoice(PitchTracker::clampPeriod(pr.period), voice_.outputLag(), n);
  }

  // The voices that cut from Autotune's input. Autotune's input is one voice and the corrected voice
  // another, and the audio the card receives is a mix of the two that follows Autotune's crossfade, so the
  // card plays a voice for each share: `voice_` at pitch ratio 1 for the input, `tuned_` at Autotune's ratio
  // for the corrected voice. Each runs only while its share is up. Both read at the corrected voice's delay.
  // The one that starts takes its grid from Autotune's corrected voice (or, when that has not started, the
  // ratio 1 voice sets the grid Autotune takes up), so the two lay their grains on one grid and the
  // crossfade moves a voice from the first to the second with no jump in the read position.
  void prepareGroup(int n, const PitchResult& pr, const GroupChunk& group) {
    const GroupFeed& feed = *group.feed;
    const float period = pr.period;
    const float lag = formant_detail::clampLag<kFormantRingLen>(feed.delay, period);
    const bool needDry = group.a0 < 1.0f || group.a1 < 1.0f;
    const bool needTuned = group.a0 > 0.0f || group.a1 > 0.0f;
    if (needDry) {
      if (!dryRuns_) {
        voice_.reset();
        lagSet_ = false;
      }
      voice_.prepare(period, 1.0f, shiftRate_, lag, kBlock);
      if (!dryRuns_) voice_.adoptMarks(feed.marks);
      followVoice(PitchTracker::clampPeriod(period), voice_.outputLag(), n);
    }
    dryRuns_ = needDry;
    if (needTuned) {
      if (!tunedRuns_) tuned_.reset();
      tuned_.prepare(period, feed.ratio, shiftRate_, lag, kBlock);
      tuned_.adoptMarks(feed.marks);
    }
    tunedRuns_ = needTuned;
    lag_ = lag;

    // Autotune's own latency counts its corrected share squared of the delay the card shares with it.
    const float tuned = feed.tuned1;
    latencyShare_ = 1.0f - tuned * tuned;
    const float off = shiftSm_ < 0.0f ? -shiftSm_ : shiftSm_;
    const float top = shiftSm_ - static_cast<float>(kFormantVoiceMaxShiftSt - 1);
    const float lift = top <= 0.0f ? 0.0f : (top < 1.0f ? top : 1.0f);
    groupTrim_ = feed.trim * dbToGainFast(kFormantGroupTrimDb * (off < 1.0f ? off : 1.0f) + kFormantGroupTopTrimDb * lift);
  }

  // The base reads where the voice actually plays: the grain grid keeps the phase of its history, so the
  // voice's delay sits up to half a period from its lag. The base takes whole periods in one step, which a
  // periodic input hides, and slides the rest at kDryLagSlew a sample, so it never jumps by a fraction.
  void followVoice(float period, float delay, int n) {
    if (!lagSet_) {
      baseLag0_ = baseLag_ = delay;
      lagSet_ = true;
      return;
    }
    baseLag_ += floorf((delay - baseLag_) / period + 0.5f) * period;
    baseLag0_ = baseLag_;
    baseLag_ = smooth::toward(baseLag_, delay, formant_detail::kDryLagSlew * static_cast<float>(n));
  }

  // The trim in dB at the glided SHIFT, read between the two entries around it. Past -12 or +12 st it holds
  // the end entry.
  float trimDbAt(float st) const {
    const float pos = clampf(st + static_cast<float>(kFormantVoiceMaxShiftSt), 0.0f, static_cast<float>(kFormantShiftSteps - 1));
    const int i = static_cast<int>(pos);
    const int j = i + 1 < kFormantShiftSteps ? i + 1 : i;
    const float a = tuning_.trimDb[static_cast<size_t>(i)];
    const float b = tuning_.trimDb[static_cast<size_t>(j)];
    return a + (b - a) * (pos - static_cast<float>(i)) + tuning_.offsetDb;
  }

  // The mix of one chunk. The voice renders from the ring. The base is the ring read at the sliding lag,
  // and is skipped when MIX sits at 100 % at both edges: the powers then take a stand-in at the
  // correlation SHIFT gives. Cutting from Autotune's input, renderGroup makes the voice and the base.
  void mix(const float* in, float* out, int n, int first, int zeroBefore, const Gains& g0, const Gains& g1,
           float level0, const GroupChunk& group) {
    voiceBuf_.fill(0.0f);
    const bool needBase = g0.base != 0.0f || g1.base != 0.0f;
    const float inv = 1.0f / static_cast<float>(n);
    const float* baseSrc = baseBuf_.data();
    if (group.feed == nullptr) {
      voice_.render(ring_.data(), first, n, voiceBuf_.data(), zeroBefore);
      if (needBase) readBase(ring_.data(), first, n, inv);
    } else {
      baseSrc = renderGroup(in, n, first, zeroBefore, group, needBase, inv);
    }
    if (seed_) level0 = seedLevelGain(baseSrc, needBase, n);
    const float dFade = (g1.fade - g0.fade) * inv;
    const float dBase = (g1.base - g0.base) * inv;
    const float dVoice = (g1.voice * g1.trim - g0.voice * g0.trim) * inv;
    const float dLevel = (levelGain_ - level0) * inv;
    float fade = g0.fade;
    float keep = g0.base;
    float wet = g0.voice * g0.trim;
    float level = level0;
    float fadeSm = fadeSm_;
    Sums sums;
    for (int j = 0; j < n; ++j) {
      fade = riseFrom_ >= 0 ? riseAt(riseFrom_ + j + 1) : fade + dFade;
      fadeSm += kFadeSmooth * (fade - fadeSm);
      if (fabsf(fade - fadeSm) < smooth::kSnap) fadeSm = fade;
      keep += dBase;
      wet += dVoice;
      level += dLevel;
      const size_t k = static_cast<size_t>(j);
      const float voice = voiceBuf_[k];
      const float base = needBase ? baseSrc[k] : 0.0f;
      sums.bb += base * base;
      sums.vv += voice * voice;
      sums.bv += base * voice;
      const float mixed = (keep * base + wet * voice) * level;
      const float x = in[j];
      const float y = x + fadeSm * (mixed - x);
      out[j] = switching_ && fadeSm > 0.0f && fadeSm < 1.0f
                   ? cross_.hold(x * x + fadeSm * (mixed * mixed - x * x), y)
                   : cross_.release(y);
    }
    fadeSm_ = fadeSm;
    if (fade_ == 1.0f && 1.0f - fadeSm < kRiseDone) switching_ = false;
    absorbPowers(sums, inv, needBase, n);
  }

  // The base for the chunk into baseBuf_: a ring read at the sliding lag.
  void readBase(const std::array<float, kFormantRingLen>& ring, int first, int n, float inv) {
    const float lagStep = (baseLag_ - baseLag0_) * inv;
    float at = baseLag0_;
    for (int j = 0; j < n; ++j) {
      at += lagStep;
      const int head = wrapOnce<kFormantRingLen>(first + j);
      baseBuf_[static_cast<size_t>(j)] = readRing<kFormantRingLen>(ring.data(), head, at);
    }
  }

  // The voice into voiceBuf_ and the base for a chunk that cuts the audio fed from Autotune's input, which the
  // ring holds from `first`. The base is returned as a pointer, which is baseBuf_ or the input itself.
  //
  // The voice is the ratio 1 voice (Autotune's input) and the corrected one mixed by their linear shares.
  // The two share a grid, so at the same pitch they are one waveform and a linear pair holds the level
  // where an equal-power pair would swell it. The corrected voice carries Autotune's trim, which keeps the
  // level Autotune's voice holds.
  //
  // The audio that arrives is tuned * V + dry * I, with V Autotune's corrected voice and I its input, and
  // the base is that audio with I moved to the voice's delay and the shares made linear:
  // alpha * V + (1 - alpha) * I(t - lag). Autotune's input alone (tuned 0) is the ring read at the lag,
  // the same read the card makes of its own ring. The corrected voice alone (dry 0) is the audio as it
  // arrives.
  const float* renderGroup(const float* in, int n, int first, int zeroBefore, const GroupChunk& group,
                           bool needBase, float inv) {
    const GroupFeed& feed = *group.feed;
    const auto& src = ring_.data();
    const float tuned0 = feed.tuned0 * group.s0;
    const float tuned1 = feed.tuned1 * group.s1;
    const bool inputOnly = tuned0 == 0.0f && tuned1 == 0.0f;
    if (dryRuns_) voice_.render(src, first, n, voiceBuf_.data(), inputOnly ? zeroBefore : 0);
    if (tunedRuns_) {
      tunedBuf_.fill(0.0f);
      tuned_.render(src, first, n, tunedBuf_.data(), 0);
      const float dA = (group.a1 - group.a0) * inv;
      for (int j = 0; j < n; ++j) {
        const float a = group.a0 + dA * static_cast<float>(j + 1);
        const size_t k = static_cast<size_t>(j);
        voiceBuf_[k] = (1.0f - a) * voiceBuf_[k] + a * groupTrim_ * tunedBuf_[k];
      }
    }
    if (!needBase) return baseBuf_.data();
    const float dry0 = feed.dry0 * group.s0 + (1.0f - group.s0);
    const float dry1 = feed.dry1 * group.s1 + (1.0f - group.s1);
    if (dry0 == 0.0f && dry1 == 0.0f) return in;
    readBase(src, first, n, inv);
    if (inputOnly) return baseBuf_.data();
    const float k0 = tunedRatio(group.a0, tuned0);
    const float k1 = tunedRatio(group.a1, tuned1);
    const float dA = (group.a1 - group.a0) * inv;
    const float dDry = (dry1 - dry0) * inv;
    const float dK = (k1 - k0) * inv;
    for (int j = 0; j < n; ++j) {
      const float s = static_cast<float>(j + 1);
      const float a = group.a0 + dA * s;
      const float dry = dry0 + dDry * s;
      const float k = k0 + dK * s;
      const size_t at = static_cast<size_t>(j);
      const float input = src[static_cast<size_t>(wrapOnce<kFormantRingLen>(first + j))];
      baseBuf_[at] = k * (in[j] - dry * input) + (1.0f - a) * baseBuf_[at];
    }
    return baseBuf_.data();
  }

  // The corrected voice's linear share over its gain in the audio that arrives, which turns the audio's
  // corrected part into the base's. It tends to 2 / pi as both fall to 0, where the part it scales is 0.
  static float tunedRatio(float share, float gain) { return gain > 1e-6f ? share / gain : 2.0f / kPi; }

  // How many samples at the newest end of the ring are exactly 0, after m more samples in[]. The count of
  // a voiced chunk ends at its last sample. A grain that reads only the zeros before a chunk adds nothing,
  // so the voice skips its taps.
  void noteZeros(const float* in, int m) {
    int run = 0;
    while (run < m && in[m - 1 - run] == 0.0f) ++run;
    zeroRun_ = run < m ? run : (zeroRun_ + m < kFormantRingLen ? zeroRun_ + m : kFormantRingLen);
  }

  Gains gainsNow() const {
    Gains g;
    g.fade = fade_;
    g.base = 1.0f - mix_;
    g.voice = mix_;
    g.trim = trim_;
    return g;
  }

  // The correlation of the base and the shifted voice at a glided SHIFT, read between the entries around it.
  static float coherenceAt(float st) {
    const float pos = clampf(st < 0.0f ? -st : st, 0.0f, static_cast<float>(kFormantCoherence.size() - 1));
    const size_t i = static_cast<size_t>(pos);
    const float a = kFormantCoherence[i];
    const float b = kFormantCoherence[i + 1 < kFormantCoherence.size() ? i + 1 : i];
    return a + (b - a) * (pos - static_cast<float>(i));
  }

  // The chunk's sums move the three running powers one step of the one-pole. An unheard base stands in at
  // the shifted voice's level and the correlation that SHIFT gives, so the level gain is near right the
  // moment MIX leaves 100 %.
  void absorbPowers(const Sums& s, float inv, bool baseHeard, int n) {
    if (n <= 0) return;
    if (n != powerCoefN_) {
      powerCoef_ = smooth::blockCoef(kFormantPowerSec, n);
      powerCoefN_ = n;
    }
    voiceSq_ += powerCoef_ * (s.vv * inv - voiceSq_);
    if (!baseHeard) {
      baseSq_ = voiceSq_;
      baseVoice_ = coherenceAt(shiftSm_) * voiceSq_;
    } else {
      baseSq_ += powerCoef_ * (s.bb * inv - baseSq_);
      baseVoice_ += powerCoef_ * (s.bv * inv - baseVoice_);
    }
  }

  // The base and the shifted voice share a pitch, so how they add depends on SHIFT. Near 0 they are almost
  // one waveform and add in amplitude. A few semitones out they are unrelated and add in power. No fixed
  // pair of gains holds the level across both. The running powers of the two voices and of their product
  // give the power the linear gains produce. This returns the gain that raises it to the voices' own
  // powers averaged at weight x, the MIX. The gain is 1 for identical voices and 1.41 at x = 0.5 for
  // unrelated ones of equal level. It is exactly 1 at x = 0 and 1, so MIX 0 and MIX 100 % pass the plain
  // voices.
  float levelGainAt(float x) const {
    if (x <= 0.0f || x >= 1.0f) return 1.0f;
    const float keep = 1.0f - x;
    const float shifted = x * trim_;
    const float want = keep * baseSq_ + x * trim_ * trim_ * voiceSq_;
    const float got = keep * keep * baseSq_ + shifted * shifted * voiceSq_ + 2.0f * keep * shifted * baseVoice_;
    if (got < kFormantPowerFloor || want < kFormantPowerFloor) return 1.0f;
    const float gain = sqrtf(want / got);
    return gain < 1.0f ? 1.0f : (gain > kFormantLevelGainMax ? kFormantLevelGainMax : gain);
  }

  // The running powers clear once both fall under the floor, which digital silence would otherwise decay
  // into the denormal range, and when a NaN or an infinity has got into them, which no later sample would
  // wash out.
  void clearIdlePowers() {
    const float sum = baseSq_ + voiceSq_;
    const bool bad = !(sum >= 0.0f && sum < std::numeric_limits<float>::infinity());
    if (bad || (baseSq_ < kFormantPowerFloor && voiceSq_ < kFormantPowerFloor)) resetLevelGain();
  }

  // Clears the running powers and the level gain.
  void resetLevelGain() {
    baseSq_ = 0.0f;
    voiceSq_ = 0.0f;
    baseVoice_ = 0.0f;
    levelGain_ = 1.0f;
  }

  InputRing<kFormantRingLen> ring_;
  PitchTracker tracker_;  // the card's own, for a card that does not sit directly behind Autotune
  Voice voice_;           // cuts from the card's ring at pitch ratio 1 (the audio it receives, or Autotune's input)
  Voice tuned_;           // cuts Autotune's input at Autotune's pitch ratio
  std::array<float, kBlock> voiceBuf_{};  // the shifted voice's chunk
  std::array<float, kBlock> tunedBuf_{};  // the corrected share of it, before the two are mixed
  std::array<float, kBlock> baseBuf_{};   // the base's chunk
  int fedFirst_ = 0;          // the ring index of the audio feed() wrote
  int fedZeroBefore_ = 0;     // the exact zeros that stood at the ring's newest end before it
  int fedN_ = 0;              // the length of that audio, 0 once a chunk has taken it
  bool grouped_ = false;      // the last chunk joined Autotune's pass
  bool dryRuns_ = false;      // voice_ ran in the last chunk that cut from Autotune's input
  bool tunedRuns_ = false;    // tuned_ ran in it
  float latencyShare_ = 1.0f; // the part of baseLag_ that outputLatency() counts
  float groupTrim_ = 1.0f;    // the gain of the corrected voice's share: Autotune's trim and the group trim

  float mix_ = 0.0f;   // MIX after its smoothing
  float fade_ = 0.0f;  // the crossfade from the input to the mix, 0 off .. 1 on
  float fadeSm_ = 0.0f;  // the crossfade after the per-sample one-pole that rounds the chunk edges
  Gains gains_;        // the gains at the end of the last chunk
  smooth::BlockCoef coef_;  // the 20 ms one-pole's step over the last chunk length

  // SHIFT: the tuning, the glided value in semitones and what follows from it, and the level gain's
  // running powers.
  FormantTuning tuning_;
  float shiftSm_ = 0.0f;
  float shiftRate_ = 1.0f;  // the grains' playback rate at shiftSm_
  float trim_ = 1.0f;       // the trim at shiftSm_
  float baseSq_ = 0.0f;     // running power of the base, one step a chunk
  float voiceSq_ = 0.0f;    // running power of the shifted voice before its trim
  float baseVoice_ = 0.0f;  // running mean of base * voice
  float levelGain_ = 1.0f;  // the level gain at the end of the last chunk
  float powerCoef_ = 1.0f;  // the powers' coefficient for steps of powerCoefN_ samples
  int powerCoefN_ = 0;
  bool shiftSet_ = false;   // shiftSm_ holds a live value

  // The SHIFT that shiftRate_ and trim_ were worked out at; NaN until the first.
  float rateSemis_ = std::numeric_limits<float>::quiet_NaN();
  float trimSemis_ = std::numeric_limits<float>::quiet_NaN();

  float lag_ = 0.0f;      // the delay the voice reads at
  float baseLag_ = 0.0f;   // the delay the base reads at the chunk's end, sliding toward lag_
  float baseLag0_ = 0.0f;  // and at its start
  bool lagSet_ = false;   // baseLag_ holds a live value
  int zeroRun_ = kFormantRingLen;  // samples at the ring's newest end that are exactly 0

  bool wasOn_ = false;     // the card was on last chunk
  bool rangeBad_ = false;  // the last voiced frame sat on the edge of the tracker's range or past it
  bool fresh_ = true;      // the next chunk takes its targets outright
  bool idle_ = false;      // the card sat stopped since it last ran, its crossfade settled at off
  bool switchedOn_ = false;  // the card has not come on since it settled, so its next rise is a switch-on
  bool switching_ = false;   // a switch-on's crossfade runs: it rises on the S curve and holds its level
  bool seed_ = false;        // the level gain starts from the correlation SHIFT gives on the next chunk
  int rise_ = -1;            // samples into a switch-on's rise, -1 when none runs
  int riseFrom_ = -1;        // where the rise stood at this chunk's start, -1 when the chunk runs none
  CrossfadeHold cross_;      // holds the toggle's crossfade at its two sides' powers weighted by the fade
};

}  // namespace cv
