peterdelecto/cubevox/engine/bloom.h

#pragma once

#include <array>
#include <cmath>
#include <cstdint>
#include <cstring>

#include "engine/common.h"
#include "engine/dsp.h"
#include "engine/fastmath.h"
#include "engine/smooth.h"

// Chatter, the engine behind the Bloom card. While a word lasts, short slices of the voice loop
// under it. Each slice plays twice, then the next cut splices in at the slice boundary. When the word
// ends, its last good slice keeps repeating and fades over LENGTH, gritty in the middle and clean at
// the end (spec 2026-11-01-bloom-design, sections 14 to 17).
//
// A word is a key. The Input gate hands its detector state to process(), or the engine listens to its
// own input. Three slices cover a word, its capture and the old tail fading under the next word.
// Slices are cut from the `src` signal, through the low-pass, and the dry path is `in` at unity. Each
// voice's wet path runs drive, soft clip and its gain, then one high shelf and one level trim run over
// their sum, and the result adds to the dry.
//
// A chunk runs voice by voice. The cut schedule (arm, zero crossing, finish, splice) and two voice
// changes (the word's close fade, the end of a crossfade) act at single sample instants, so the chunk
// splits at those instants. Between two of them nothing changes the schedule, and each voice runs
// its stretch in one loop with its state in locals. The last voice's loop also carries the capture's
// low-pass and the pair gain, shelf and trim, because both filters are chains of dependent multiplies
// and run side by side in one loop at the cost of one. The sound is the sample-by-sample sound, bit
// for bit.

namespace cv {

// The values a bench or a listen may change. Everything else the engine fixes in constants.
struct BloomTuning {
  // Level of the wet path alone, the slices and the tail. The dry passes at unity at every AMOUNT, and
  // AMOUNT at the bottom of its travel adds no wet. At the default setting this puts the three sample
  // clips at +0.20 to +0.33 dB RMS over the input, with the Input gate key and with the own key.
  float trimDb = -14.5f;

  float firstCaptureMs = 40.0f;  // first slice, after the word starts
  float skipDb = -12.0f;         // a slice this far under the looping slice is skipped

  // The clipper's drive through the word, and how far the middle of the tail swells it.
  float driveWord = 2.8f;
  float driveBell = 2.0f;

  // Each cut's length drifts by up to this fraction either way, so the interval between cuts, two
  // plays of the slice, drifts with it.
  float drift = 0.03f;
};

struct BloomParams {
  bool on = true;
  float lengthMs = 300.0f;   // panel LENGTH, 20..3000
  float amount = 0.5f;       // panel AMOUNT, 0..1
  bool keyFromGate = false;  // false makes the engine listen to its own input
  BloomTuning tuning;
};

class Bloom {
 public:
  static constexpr int kSlices = 3;                          // the loop, the capture, the fading tail
  static constexpr int kSliceMax = 80 * kSampleRate / 1000;  // 80 ms, 3,840 samples
  static constexpr int kVoices = 4;                          // word, tail, and two fading tails
  static constexpr int kWord = 0;                            // voice numbers
  static constexpr int kTail = 1;
  static constexpr int kFade = 2;  // first of the fading voices
  static constexpr float kLengthMinMs = 20.0f;
  static constexpr float kLengthMaxMs = 3000.0f;
  static constexpr float kLowpassHz = 11000.0f;  // the low-pass a slice passes through as it is cut
  static constexpr float kLowpassQ = 0.70f;

  void reset() {
    closeAll();
    for (Slice& s : slice_) s = Slice{};
    wl_ = 0.0f;
    prevSrc_ = 0.0f;
    lcg_ = kSeed;
    clock_ = 0;
    armedAt_ = 0;
    writtenAt_ = 0;
    taken_ = 0;
    skipped_ = 0;
    commitSeq_ = 0;
    wetAmount_ = -1.0f;
    prepared_ = false;
  }

  // Cuts its slices from `in`, as a Chatter card with nothing ahead of it in the chain does.
  void process(const float* in, float* out, int n, const BloomParams& p, bool keyOpen = false) {
    process(in, in, out, n, p, keyOpen);
  }

  // `in` is the dry path and the own key's input. `src` is the signal the slices are cut from, the
  // same block time-aligned with `in`. `keyOpen` is the Input gate's detector state for this call and
  // counts only when `p.keyFromGate` is set. Any n; `out` may be `in`.
  void process(const float* in, const float* src, float* out, int n, const BloomParams& p, bool keyOpen = false) {
    const float lengthMs = clampf(p.lengthMs, kLengthMinMs, kLengthMaxMs);
    prepare(p.tuning, lengthMs);
    const Law law = lawFor(p, lengthMs);
    for (int done = 0; done < n; done += kBlock) {
      const int m = n - done < kBlock ? n - done : kBlock;
      runChunk(in + done, src + done, out + done, m, p, law, keyOpen);
    }
  }

  // Sum of the voices' wet gains before the shelf and the trim.
  float wetGain() const {
    float sum = 0.0f;
    for (const Voice& v : v_) sum += v.gain;
    return sum;
  }

  // True while a word is open (the key plus its hold).
  bool inWord() const { return v_[kWord].on; }

  // The gain on the summed loops: 1 with one loop sounding, kPairDb with more.
  float pairScale() const { return pairScale_; }

  // True while any voice has a slice looping.
  bool looping() const {
    for (const Voice& v : v_)
      if (v.on && v.slice >= 0) return true;
    return false;
  }

  // The accessors below report the engine's state to bloom_test and core_chain_run. The firmware
  // does not call them.

  // Starts the sample clock at `clock` instead of 0, so a test can run the engine across the wrap
  // of the 32-bit clock. Call it right after reset().
  void startClockAt(uint32_t clock) { clock_ = clock; }

  // The clock at the latest capture arm and write start, in samples since reset().
  uint32_t armedAt() const { return armedAt_; }
  uint32_t writeStartedAt() const { return writtenAt_; }

  // Slices committed, and slices skipped for a gap or for sitting too far under the looping one,
  // since reset().
  int taken() const { return taken_; }
  int skipped() const { return skipped_; }

  // Per voice: whether it runs, its gain, the commit number, cut clock and length of the slice it
  // plays (0, 0 and 0 when none), and the clock of its latest splice.
  bool voiceOn(int k) const { return v_[static_cast<size_t>(k)].on; }
  float voiceGain(int k) const { return v_[static_cast<size_t>(k)].gain; }
  uint32_t playingSeq(int k) const { return playing(k).seq; }
  uint32_t playingCutAt(int k) const { return playing(k).cutAt; }
  int playingLen(int k) const { return playing(k).len; }
  uint32_t spliceAt(int k) const { return v_[static_cast<size_t>(k)].splicedAt; }

  // The slices: whether one holds a finished cut, and its commit number, cut clock, length and samples.
  bool sliceValid(int slot) const { return slice_[static_cast<size_t>(slot)].valid; }
  uint32_t sliceSeq(int slot) const { return slice_[static_cast<size_t>(slot)].seq; }
  uint32_t sliceCutAt(int slot) const { return slice_[static_cast<size_t>(slot)].cutAt; }
  int sliceLen(int slot) const { return slice_[static_cast<size_t>(slot)].len; }
  const float* sliceData(int slot) const { return data_[static_cast<size_t>(slot)].data(); }

 private:
  static constexpr float kSmpPerMs = kSampleRate / 1000.0f;
  static constexpr uint32_t kSeed = 0x2545F491u;
  static constexpr float kLog2E = 1.44269504f;

  // Word timing, in ms.
  static constexpr float kCrossingWaitMs = 10.0f;  // longest wait for a zero crossing before a cut starts anyway
  static constexpr float kRampMs = 5.0f;           // wet gain rise to its level
  static constexpr float kFadeMs = 5.8f;           // pass fade in and out, and the splice crossfade
  static constexpr float kKeyHoldMs = 50.0f;       // both key sources hold a word open this long
  static constexpr int kPlaysPerSlice = 2;
  static constexpr int kEdgeShare = 8;  // a cut's edge is one eighth of it

  // AMOUNT laws. The wet level is kWetHi * AMOUNT^kWetExp, 0 at AMOUNT 0. The slice runs from
  // kSliceLoMs at AMOUNT 0 to kSliceHiMs at 100 %, LENGTH caps it at kSliceLengthFrac of its setting,
  // and no slice runs under kSliceMinMs.
  static constexpr float kWetHi = 0.70f;
  static constexpr float kWetExp = 0.6f;
  static constexpr float kSliceLoMs = 80.0f;
  static constexpr float kSliceHiMs = 45.0f;
  static constexpr float kSliceMinMs = 35.0f;
  static constexpr float kSliceLengthFrac = 0.8f;

  // While two loops sound together each plays kPairDb down, so two loops carry the power of one. The
  // change rides the 20 ms smoother.
  static constexpr float kPairDb = -3.0f;

  // Age and fades. During a word no slice plays longer than kMaxAgeMs after it was cut, and
  // kCloseMs ends a loop that has nothing newer to play. A tail has no age limit and runs LENGTH's
  // law out. kNextWordMs is the fade a new word puts on the tail it finds, and kQuickFadeMs the
  // faster fade a tail already fading takes when another word follows.
  static constexpr float kMaxAgeMs = 2500.0f;
  static constexpr float kCloseMs = 80.0f;
  static constexpr float kNextWordMs = 150.0f;
  static constexpr float kQuickFadeMs = 20.0f;

  // LENGTH laws. Life falls with a time constant of max(LENGTH, min(kTauScale * LENGTH, kTauMaxMs)).
  // At kEndFadeLife the end fade takes over with a time constant of kEndFadeMs, or LENGTH when that is
  // shorter, and under kCloseGain the wet gain writes 0 and the loop stops.
  static constexpr float kTauScale = 1.5f;
  static constexpr float kTauMaxMs = 300.0f;
  static constexpr float kEndFadeLife = 0.20f;
  static constexpr float kEndFadeMs = 80.0f;
  static constexpr float kCloseGain = 0.001f;

  // Wet tone: a high shelf over the summed loops.
  static constexpr float kShelfHz = 3000.0f;
  static constexpr float kShelfDb = 2.2f;
  static constexpr float kShelfSlope = 0.7f;

  // Word key from the engine's own input.
  static constexpr float kOwnOpenDb = -45.0f;
  static constexpr float kOwnHysteresisDb = 3.0f;

  // The times above in samples.
  static constexpr int kCrossingWaitSmp = static_cast<int>(kCrossingWaitMs * kSmpPerMs);
  static constexpr int kFadeSmp = static_cast<int>(kFadeMs * kSmpPerMs + 0.5f);
  static constexpr int kHoldSmp = static_cast<int>(kKeyHoldMs * kSmpPerMs);
  static constexpr int kCloseSmp = static_cast<int>(kCloseMs * kSmpPerMs);
  static constexpr int kNextWordSmp = static_cast<int>(kNextWordMs * kSmpPerMs);
  static constexpr int kQuickFadeSmp = static_cast<int>(kQuickFadeMs * kSmpPerMs);
  static constexpr uint32_t kLimitSmp = static_cast<uint32_t>(kMaxAgeMs * kSmpPerMs);
  static constexpr int kMinSliceSmp = 2 * kFadeSmp + 2;
  static constexpr float kInvFade = 1.0f / static_cast<float>(kFadeSmp);
  static constexpr float kInvRampSmp = 1.0f / (kRampMs * kSmpPerMs);

  static_assert(kFadeSmp == 278 && kCrossingWaitSmp == 480 && kHoldSmp == 2400 && kCloseSmp == 3840, "sample counts");
  static_assert(kNextWordSmp == 7200 && kQuickFadeSmp == 960 && kLimitSmp == 120000 && kMinSliceSmp == 558, "sample counts");

  enum class Cap : uint8_t { Idle, Waiting, Writing };

  // One finished cut. `seq` numbers commits from 1, so a bigger number was cut later.
  struct Slice {
    bool valid = false;
    int len = 0;
    uint32_t seq = 0;
    uint32_t cutAt = 0;  // clock at the first sample written
    float peak = 0.0f;
  };

  // One loop. The word, the tail and the fading tails are all voices; the array index says which.
  // `slice` is the slice that loops (-1 for none) and `prev` the one fading out under a splice. A
  // fade is a straight fall of the gain to 0 by fadeStep each sample.
  struct Voice {
    bool on = false;
    int slice = -1;
    int len = 0;
    int pos = 0;
    bool prevOn = false;
    int prev = 0;
    int prevLen = 0;
    int prevPos = 0;
    uint32_t splicedAt = 0;
    uint32_t staleAt = 0;  // clock where the word's slice has used its age and the close fade starts
    float refPeak = 0.0f;  // peak of the looping slice
    float life = 1.0f;
    float gain = 0.0f;
    float fadeStep = 0.0f;
  };

  // Everything AMOUNT, LENGTH and the toggle set for one call: the wet level the call heads for (0 when
  // the card is off), the slice length AMOUNT asks for in ms, the longest slice LENGTH allows, and the
  // fraction the cut length may drift.
  struct Law {
    float target;
    float sliceMs;
    float capMs;
    float drift;
  };

  // One chunk's signals and scratch. `wet` holds the sum of the voices' wet per sample. `wlp` points at
  // the wet level for sample 0 and steps by `wlStep` a sample (1 while the level moves, 0 while it
  // holds). `prev0` is the `src` sample before the chunk and `clock0` the clock at its first sample.
  struct Run {
    const float* in;
    const float* src;
    float* out;
    float* wet;
    const float* wlp;
    int wlStep;
    float prev0;
    uint32_t clock0;
    const Law* law;
    const BloomTuning* tune;
  };

  // Where a voice stores its wet: `base + y * gain` goes to `dst`, and `base` steps by `step` a sample.
  // `later` marks a voice that adds to the sum of the voices before it.
  struct Sink {
    float* dst;
    const float* base;
    int step;
    bool later;
  };

  // The ways a voice's gain and read move. Steady is the word riding toward the wet level, Decay a
  // tail whose life falls, and Fade a gain that falls by a fixed step. Cross is Steady while the
  // previous slice fades out under a splice, which lasts kFadeSmp samples from the splice.
  enum class Kind : uint8_t { Steady, Decay, Fade, Cross };

  // A voice's loop state, kept in locals while its loop runs. `pd`, `plen` and `ppos` are the previous
  // slice of a Cross voice.
  struct Lane {
    const float* d;
    int len;
    int pos;
    float gain;
    float life;
    float step;
    float drive;
    float driveWord;
    float driveBell;
    float aTail;
    float aEnd;
    const float* pd;
    int plen;
    int ppos;
  };

  // The cut under way, kept in locals while the capture runs. The window covers the first kFadeSmp
  // samples and those from `winEnd` on, the peak rule the first `headEnd` and those from `tailStart`.
  struct CapLane {
    Biquad lp;
    float* dst;
    int pos;
    int len;
    int headEnd;
    int winEnd;
    int tailStart;
    float peak;
    float head;
    float tail;
  };

  static constexpr float kZero = 0.0f;
  static constexpr float kOne = 1.0f;

  static float lerp(float a, float b, float t) { return a + (b - a) * t; }
  static float smoothstep(float t) { return t * t * (3.0f - 2.0f * t); }

  Slice playing(int k) const {
    const Voice& v = v_[static_cast<size_t>(k)];
    return v.on && v.slice >= 0 ? slice_[static_cast<size_t>(v.slice)] : Slice{};
  }

  Law lawFor(const BloomParams& p, float lengthMs) {
    const float amount = smooth::clamp01(p.amount);
    if (amount != wetAmount_) {
      wet_ = amount > 0.0f ? kWetHi * exp2Fast(kWetExp * log2Fast(amount > 1e-12f ? amount : 1e-12f)) : 0.0f;
      wetAmount_ = amount;
    }
    return {p.on ? wet_ : 0.0f, lerp(kSliceLoMs, kSliceHiMs, amount), kSliceLengthFrac * lengthMs, p.tuning.drift};
  }

  // The length of the next cut in samples. AMOUNT's slice drifts by up to the law's drift either way,
  // from the fixed-seed generator, so renders repeat. LENGTH's cap and the floor apply after the drift.
  int nextSlice(const Law& law) {
    lcg_ = lcg_ * 1664525u + 1013904223u;
    const float r = static_cast<float>(static_cast<int32_t>(lcg_)) * (1.0f / 2147483648.0f);
    float ms = law.sliceMs * (1.0f + law.drift * r);
    ms = ms < law.capMs ? ms : law.capMs;
    ms = ms > kSliceMinMs ? ms : kSliceMinMs;
    const int smp = static_cast<int>(ms * kSmpPerMs);
    return smp < kMinSliceSmp ? kMinSliceSmp : (smp > kSliceMax ? kSliceMax : smp);
  }

  // Coefficients that follow the tuning and LENGTH. The constants' own are set once after a reset; the
  // ones that need libm run when their inputs change.
  void prepare(const BloomTuning& t, float lengthMs) {
    if (!prepared_) {
      openLin_ = dbToGainFast(kOwnOpenDb);
      closeLin_ = dbToGainFast(kOwnOpenDb - kOwnHysteresisDb);
      pairLin_ = dbToGainFast(kPairDb);
      capLp_.setLowPass(kLowpassHz, kLowpassQ);
      shelf_.setHighShelf(kShelfHz, kShelfDb, kShelfSlope);
      trimDb_ = -1000.0f;
      skipDb_ = -1000.0f;
      lengthMs_ = 0.0f;
    }
    firstSmp_ = static_cast<int>(t.firstCaptureMs * kSmpPerMs);
    if (t.skipDb != skipDb_) {
      skipDb_ = t.skipDb;
      skipLin_ = dbToGainFast(t.skipDb);
    }
    if (t.trimDb != trimDb_) {
      trimDb_ = t.trimDb;
      trim_ = dbToGainFast(t.trimDb);
    }
    if (lengthMs != lengthMs_) {
      const float scaled = kTauScale * lengthMs < kTauMaxMs ? kTauScale * lengthMs : kTauMaxMs;
      const float tauMs = lengthMs > scaled ? lengthMs : scaled;
      const float endMs = kEndFadeMs < lengthMs ? kEndFadeMs : lengthMs;
      aTail_ = exp2Fast(-kLog2E / (tauMs * kSmpPerMs));
      aEnd_ = exp2Fast(-kLog2E / (endMs * kSmpPerMs));
      lengthMs_ = lengthMs;
    }
    prepared_ = true;
  }

  void runChunk(const float* in, const float* src, float* out, int m, const BloomParams& p, const Law& law, bool keyOpen) {
    if (law.target == 0.0f && wl_ == 0.0f) {
      for (int i = 0; i < m; ++i) out[i] = in[i];
      if (running_) closeAll();
      prevSrc_ = src[m - 1];
      clock_ += static_cast<uint32_t>(m);
      return;
    }
    running_ = true;
    stepKey(in, m, p.keyFromGate, keyOpen);
    if (keyHeld_ && !v_[kWord].on) startWord();
    else if (!keyHeld_ && v_[kWord].on) endWord();

    // With nothing sounding and the levels settled, the call is a copy of the input.
    bool anyOn = false;
    for (const Voice& v : v_) anyOn = anyOn || v.on;
    if (!anyOn && wl_ == law.target && pairScale_ == 1.0f) {
      if (shelfLive_) {
        shelf_.clear();
        shelfLive_ = false;
      }
      for (int i = 0; i < m; ++i) out[i] = in[i];
      prevSrc_ = src[m - 1];
      clock_ += static_cast<uint32_t>(m);
      return;
    }
    float wetBuf[kBlock];
    float wlBuf[kBlock];
    float wlHeld = wl_;
    Run r{in, src, out, wetBuf, &wlHeld, 0, prevSrc_, clock_, &law, &p.tuning};
    if (wl_ != law.target) {
      stepWetLevel(law.target, m, wlBuf);
      r.wlp = wlBuf;
      r.wlStep = 1;
    }
    runSegments(r, m);
    clock_ = r.clock0 + static_cast<uint32_t>(m);
  }

  // The wet level for each of the chunk's m samples while it rides to the target on the smoother.
  void stepWetLevel(float target, int m, float* level) {
    for (int i = 0; i < m; ++i) {
      if (wl_ != target) wl_ = smooth::step(wl_, target, smooth::kSmoothCoef);
      level[i] = wl_;
    }
  }

  // Walks the chunk from one instant to the next. At an instant the capture and splice steps run on
  // that one sample, then the voice changes. The stretch from there to the next instant holds the
  // capture's writes and the voices, which nothing in the schedule can change.
  void runSegments(const Run& r, int m) {
    const bool word = v_[kWord].on;
    int i = 0;
    int next = nextEvent(r, 0, m, word);
    while (i < m) {
      const int from = i;
      if (next == i) {
        clock_ = r.clock0 + static_cast<uint32_t>(i);
        if (word) {
          stepCapture(r.src[i], *r.law);
          stepSplice(*r.law);
        }
        voiceEvents(clock_);
        next = nextEvent(r, ++i, m, word);
      }
      const float last = r.src[next - 1];
      if (from < i) runVoices(r, from, i, false);
      if (i < next) runVoices(r, i, next, cap_ == Cap::Writing);
      prevSrc_ = last;
      i = next;
    }
  }

  // The first sample at or after t0 where something changes besides the voices' plain playing, or m.
  int nextEvent(const Run& r, int t0, int m, bool word) const {
    const int room = m - t0;
    const uint32_t clk = r.clock0 + static_cast<uint32_t>(t0);
    int t = word ? nextScheduled(r, t0, m, clk, room) : m;
    const Voice& w = v_[kWord];
    if (w.on && w.slice >= 0 && w.fadeStep == 0.0f) t = earlier(t, t0 + dueIn(clk, w.staleAt, room));
    for (const Voice& v : v_)
      if (v.on && v.prevOn) t = earlier(t, t0 + (v.pos < kFadeSmp ? kFadeSmp - v.pos : 0));
    return t;
  }

  // The first sample at or after t0 where the capture or the splice does more than write the cut, or m.
  // Waiting for a zero crossing scans the signal for the crossing.
  int nextScheduled(const Run& r, int t0, int m, uint32_t clk, int room) const {
    int t = m;
    if (spliceSet_) t = t0 + dueIn(clk, spliceAt_, room);
    if (cap_ == Cap::Idle) {
      if (armSet_) t = earlier(t, t0 + dueIn(clk, armAt_, room));
    } else if (cap_ == Cap::Writing) {
      t = earlier(t, t0 + capLen_ - 1 - capPos_);
    } else {
      int stop = earlier(t, t0 + dueIn(clk, waitUntil_, room));
      float prev = t0 > 0 ? r.src[t0 - 1] : r.prev0;
      for (int k = t0; k < stop; ++k) {
        const float s = r.src[k];
        if ((prev < 0.0f) != (s < 0.0f)) stop = k;
        prev = s;
      }
      t = stop;
    }
    return t;
  }

  static int earlier(int a, int b) { return b < a ? b : a; }

  // Samples from `clk` until the clock reaches `at`, 0 when it has, and `limit` when that is further.
  static int dueIn(uint32_t clk, uint32_t at, int limit) {
    const int32_t d = static_cast<int32_t>(at - clk);
    if (d > 0) return d < limit ? d : limit;
    return d == INT32_MIN ? limit : 0;
  }

  // The word's slice that has used its age starts the close fade, and a previous slice whose crossfade
  // has run its length drops out. Both fall on one sample, after the schedule's steps.
  void voiceEvents(uint32_t clk) {
    Voice& w = v_[kWord];
    if (w.on && w.slice >= 0 && w.fadeStep == 0.0f && dueAt(clk, w.staleAt)) beginFade(w, kCloseSmp);
    for (Voice& v : v_)
      if (v.on && v.prevOn && v.pos >= kFadeSmp) v.prevOn = false;
  }
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
