peterdelecto/cubevox/(commit log)

2026-10-01 chore: scaffold cubevox repo with unison spec and GUI skeleton
    Own repo. ImGui submodule at the granularbox2 pin, miniaudio 0.11.25,
    Cocoa open panel and Info.plist copied from the granularbox2 proto
    skeleton. Spec in docs/specs covers the shared engine contract, the
    unison effect, the emulator, and the tests.
2026-10-01 feat(unison): chorus-style unison engine, proto emulator, render CLI, tests
    Two LFO-modulated taps on one delay line, cubic reads, DEPTH drives swing
    and wet level through a 20 ms smoother that snaps to exact zero so off is
    bit-identical to dry. Tuning constants are exposed under the emulator's
    collapsed Tuning header and printed as a paste-ready initialiser. Contract
    flags apply only to the engine-only targets; the GUI target carries
    vendored ImGui and ObjC that are not held to -Werror.
    [main.cpp, unison.h]
2026-10-01 feat(unison): fixed per-voice detune via dual-tap shifter, tunable
    Each voice gains a crossfaded sawtooth pitch shifter around its chorus
    centre so the doubler flavour can be blended against the LFO wobble from
    the Tuning panel. Defaults 0 cents leave the chorus unchanged; the fifth
    test pins a 10-cent setting.
    [main.cpp, unison.h]
2026-10-01 fix(proto): Print tuning copies to clipboard and shows on the face
    Finder launches have no stdout, so the pasted line was lost.
    [main.cpp]
2026-10-01 feat(unison): bake owner ear tuning as defaults; detune test tracks tuning
    20/15 ms, 0.60/0.90 Hz, swing 0.5-3.0 ms, wet -4 dB, detune +2/-2 cents,
    window 20 ms. The detune check now derives its band from the shipped
    tuning so retuning moves the band instead of breaking it.
2026-10-01 feat(harmony): Zoom V3 style diatonic harmony with YIN tracker and PSOLA shifter
    Stage 3 is KEY (12 keys, V3 circle order) + MIX on the panel, with the five
    V3 voices (max two) in the menu. Two-stage YIN at 12/48 kHz, Lent PSOLA
    grains keep formants, interval tables are tunable to match the V3 by ear.
2026-10-01 feat(octave): stepped +-12 st octave on a shared pitch front end
    Harmony and Octave both track the dry mic through one tracker and shift it
    in parallel, so neither hears the other's voices. Face order is now
    Harmony, Octave, Unison. Harmony glide surfaces as Tracking speed in tuning.
2026-10-01 feat(slapback): 30-120 ms single repeat with tunable lowpass; per-effect toggles
    INTENSITY is the panel knob; time, lowpass cutoff, feedback and wet level
    are tuning items. Every effect block now carries an on/off checkbox in the
    prototype so stages can be A/B'd (owner 2026-10-01).
2026-10-01 feat(distortion): Boss BD-2 model, two rail-saturating stages with fixed EQ
    DRIVE is the dual audio-taper GAIN pot (exponential, clean at low drive).
    Diodes omitted per owner-supplied circuit analysis (inaudible). Fixed EQ
    fades in from exact passthrough over the first 5 % of DRIVE. Adam's pedal
    is a stock BD-2; Waza S/C notes kept in the spec as reference.
    [distortion.h, main.cpp]
2026-10-01 feat: spring reverb, octave option B, three-column face
    Spring: Parker/Valimaki parametric model from DrumSynthV3 rewritten for
    48 kHz float, with splash levers (C_hf mix, ripple taps, splash diffusers,
    HF cascade, third spring) exposed for ear tuning. Octave B: epoch-aligned
    PSOLA with an independent FORMANT control, selectable against option A.
    Face: three columns, no scroll bar, each effect's Tuning header beneath it;
    --layout probe checks every tuning sub-node fits.
2026-10-01 feat(reverb): CHASM engine (hexefx tank port) selectable against SPRING; face borders and unison labels
    CHASM is DrumSynthV3's cavern/hexefx port rewritten for 48 kHz float with
    delay lengths rescaled; DECAY and WOBBLE take the two reverb knobs when it
    is selected. DrumSynthV3's wobble level table did not transfer (level falls
    2 dB here) and is replaced by a tunable lift. Face: bordered module boxes,
    Unison tuning grouped by chorus / doubler method.
    [chasm.h, main.cpp, reverb.h]
2026-10-01 fix(spring): match DrumSynthV3 by default
    Owner: the port did not sound like DSV3. Line-by-line diff found the
    algorithm faithful; the gap was gain structure (no 0.5 send gain, tank
    trim 0.375 vs 1.5, wet -6 vs -3.1 dB), the spec's pushed splash defaults
    (HF mix, doubled ripple, diffusers), fs/2K cutoffs 8.8 % above DSV3's,
    and laps 4 % short. Defaults now reproduce DSV3 within 0.5 dB level and
    0.4 dB HF/LF at dwell 0/0.5/1 (A/B against DSV3's own header). Splash
    levers remain the departure points.
    [main.cpp, spring.h]
2026-10-01 feat: distortion TONE, reverb MIX, final polish EQ; effects off on open
    TONE follows the BD-2 tone network: flat at noon, treble cut down, boost up.
    Reverb engines now output wet at 0 dB and a MIX knob crossfades; both are
    panel knobs (CLAUDE.md). Polish EQ after reverb: 90 Hz HP, -2.5 dB at
    300 Hz, +1.5 dB at 3.5 kHz, +1.5 dB air shelf. Harmony Intervals node
    removed from the face. Distortion moved to column 2 so every open tuning
    node still fits. Spring-reverb research handover saved under docs/reference.
2026-10-01 feat(reverb): PARKER engine, parametric spring from the research handover
    DAFx-11 M<=100 preset at 48 kHz with fractional stretch, chirp EQ,
    10th-order elliptic, Gajarsky taps/modulation, C_hf, three detuned
    springs, drive/recovery wrapper. Feedback sign settled by echo
    correlation (net negative). gComp 1.0 since this loop lacks the loss
    DAFx-11 compensated. Reverb radio SPRING | CHASM | PARKER. EQ module
    labelled Output EQ.
2026-10-01 fix(proto): compact Output EQ so every open tuning node fits; unison tuning sub-nodes
    The band-grouped EQ overran column 3 with a reverb node open. Frequency and
    gain now share a row for the two peaking bands, low cut and air are single
    labelled sliders, and the Unison tuning splits into Chorus / Doubler /
    Shared nodes. Probe exit 0 with 14 px to spare.
    [main.cpp]
2026-10-01 feat(gate): input soft gate and panel GATE with threshold
    One engine, two instances: a gentle -12 dB soft gate first in the chain
    (menu item) and the THRESHOLD gate after Distortion, before Reverb so
    tails survive. Soft knee, hysteresis, attack/hold/release, dB-domain
    smoothing. Module gap 40 -> 37 px so column 2 still fits.
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2026-10-01 fix(proto): fit the owner's screen; tuning accordion per column
    Window 1440x840 (laptop shows ~847 px), tighter module padding, one
    Tuning header open per column at a time so the probe's one-open invariant
    holds on screen. Also: Detected readout and Fixed voice removed from
    Harmony; input gate defaults -40 dB / hold 100 ms / release 25 ms.
    [main.cpp]
2026-10-01 feat: owner defaults pass; TONE made audible
    Distortion stage-1 LP 3->6 kHz and stack treble -10->-5 dB so TONE at
    noon sits -6 dB at 3 kHz and swings ~16 dB over audible content (it was
    acting on content already -12 dB down). Slapback 70 ms / feedback 0.2.
    Wet level at full is 0 dB on every effect (unison per-voice wet, PARKER
    trim). Panel GATE gentler: hold 150, release 250, range -40, knee 12,
    hysteresis 6. Tests pin the old values explicitly where they tested
    timing physics.
2026-10-01 feat: level rule; every stage trimmed to 0..+0.5 dB at its default, level_test enforces
    Synthetic vocal program at -18 dBFS; per-stage trims in tuning (new
    trimDb on Harmony, Octave A/B, Polish; wetDb on the rest). Chasm and
    Parker re-levelled against Spring by the same measurement.
2026-10-01 feat(octave): option C, asynchronous granular shifter (pedal octaver)
    Unison's dual-tap crossfade generalised to 2 or 4 grains over a 20-80 ms
    window, no tracker; formants move with pitch. Engine radio A | B | C,
    FORMANT only on B. Tests show C's envelope scales with pitch while A's
    stays, and C runs on white noise where PSOLA cannot.
    [main.cpp, octave.h, octave_c.h, pitch_fx.h]
2026-10-01 feat(harmony): shifter engines A | B | C, per-voice FORMANT on B, chromatic mode
    Epoch and granular shifters factored into engine/shifters.h and shared
    with Octave B/C (octave_test output byte-identical before and after).
    Harmony voices pick the engine; B gives each voice its own formant so a
    third and a fifth can be different singers; Chromatic fixes semitone
    intervals and ignores KEY. Level rows for Harmony B/C with trims.
    [harmony.h, main.cpp, octave.h, octave_b.h, octave_c.h, pitch_fx.h, shifters.h]
2026-10-01 fix(proto): TONE opens at 50 %
    Positional initialiser put {} on the tone field, so the app opened fully
    dark while the engine default and the tests sat at noon.
    [main.cpp]
2026-10-01 feat(reverb): vocal defaults for the three engines
    SPRING tension 55 % / dwell 35 %, CHASM decay 45 % / wobble 25 %, PARKER
    tension 50 % / dwell 30 %, MIX 30 %: small amounts, per Adam's own habit.
    [chasm.h, reverb.h, spring.h]
2026-10-01 feat(proto): LED gate-open indicator on both gates
    Green open (within 1 dB of unity), amber in the knee, dark red closed,
    unlit when the gate is off.
2026-10-02 feat(reverb): PARKER SPRING voicing: brighter, splashier, shorter tail
    Owner: dark, not splashy, too much sustain. Wrapper LP 9 kHz, chirp EQ
    off, high band -22 dB, presence +5, taps 0.2, feedback 0.35-0.82,
    a 0.70, wider spring detune. Polarity test now correlates the <400 Hz
    band, where dispersion is small. Radio label PARKER SPRING.
    [main.cpp]
2026-10-02 feat(autotune): pitch correction on the shared front end
    Nearest scale note in the key (or chromatic), correction smoothed by
    RESPONSE, corrected voice replaces dry via the epoch shifter with
    formants held; Octave and Harmony build on the corrected pitch. Six
    tests incl. harmony-follows and a response-time step; level row.
    [autotune.h, harmony.h, octave.h, octave_b.h, octave_c.h, pitch_fx.h]
2026-10-02 feat(proto): AUTOTUNE module; four-column face
    Eleven modules no longer fit three columns with a tuning header open.
    Col 1 Input gate / Autotune / Octave, col 2 Harmony / Unison, col 3
    Slapback / Distortion / Gate, col 4 Reverb / Output EQ. Harmony column
    400 px, Formant slider 60 px.
    [main.cpp]
2026-10-02 feat(autotune): correction feeds Harmony/Octave; RESPONSE, chromatic, key link; sub-sample epochs
    Autotune rebuilt to the spec: nearest scale note (or chromatic) with a
    RESPONSE time constant, shifter A or B, correction added to every
    Harmony/Octave target so their voices sit on the corrected note. Epoch
    shifter gains parabolic sub-sample peak refinement: in-tune passthrough
    through Autotune B improves -34 -> -55 dB, Harmony/Octave B tighten too.
    [autotune.h, main.cpp, pitch_fx.h, shifters.h]
2026-10-02 feat: tuning defaults from the Codex review, owner-filtered
    Applied: autotune response 100 ms, harmony glide 30 ms / mix 25 %, octave
    +12 st / mix 15 %, slapback intensity 25 % and feedback 0.35 (~2.5
    repeats, owner), distortion drive 20 %, input HP 90 Hz, bass bump +2 dB
    (trim re-derived +2.9 dB), reverb mix 15 %, spring and parker dwell 20 %,
    chasm decay 30 % / wobble 15 % / depth 64. Kept: gates, unison, chasm
    wobble lift, parker presence.
    [autotune.h, chasm.h, distortion.h, harmony.h, main.cpp, octave.h, reverb.h, slapback.h]
2026-10-02 build: package.sh makes a self-contained, ad-hoc signed app zip
    GLFW was loaded from /opt/homebrew, so the app crashed on any Mac without
    Homebrew. The packager copies non-system dylibs into Contents/Frameworks,
    rewrites the load paths, re-signs, and refuses to finish if a Homebrew
    path remains.
2026-10-02 feat(proto): Adam's face: hardware knobs + musician tuning sliders, full Print snapshot
    Each module shows its hardware knobs, then a Tuning header with named
    macro sliders (50 % = today). Advanced shows the raw nodes. Print tuning
    emits Macros / Choices / Knobs lines then raw values. Harmony gets three
    voice slots (Low/High/Higher), CHASM a DWELL front end so all reverbs
    share DECAY/DWELL/MIX. Autotune KEY is the shared key; Autotune tuning
    (Pull range, Correct to every note); FORMANT back on the face.
    Fix: Unicode font merge asserted in debug builds; packager now builds in
    its own directory so the dev build keeps asserts.
    [chasm.h, harmony.h, macros.h, main.cpp]
2026-10-02 fix: level rule for MIX stages, owner Unison tuning, even DRIVE taper; stage feedback sim
    - MIX stages (Harmony, Octave, Reverb) trimmed so the wet alone at 100 %
    is unity; Harmony no longer clips at full mix. Multiple harmony voices
    normalised by 1/sqrt(count).
    - Unison: owner's tuning restored (wet -4 dB); level fixed by a
    depth-scaled output trim. Unison tuning sliders widened.
    - Distortion DRIVE: gMin..gMax taper, breaks up at 10 %, top = old 70 %;
    makeup refit, level flat within 0.1 dB.
    - Render: Harmony/Octave run only with their flags.
    - Harmony voice levels Off/Quiet/Loud/Louder, default Low loud, High and
    Higher louder.
    - Stage feedback simulator (prototype-only): monitor-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
    [chasm.h, distortion.h, harmony.h, macros.h, main.cpp, octave.h, spring.h]
2026-10-02 feat(proto): INPUT GATE on/off toggle for A/B against the feedback sim
    Prototype-only; the box has no switch for the soft gate. Opens on.
2026-10-02 feat(proto): cap stage feedback sliders at 75 % of the simulator range
    Defaults moved so the default sound is unchanged.
2026-10-02 feat(autotune): match Adam's hard-tune box
    His clips hold the note within about 2 cents. Ours missed by 7 cents even at
    its fastest because the correction used the tracker's median pitch, one hop
    late. Correction now reads the raw pitch, RESPONSE reaches 1 ms (new default),
    and engine A is the default since B roughens the voice.
    [autotune.h, pitch.h]
2026-10-02 fix(proto): autotune KEY stays live in every-note mode
    KEY was greyed out whenever Correct to every note was on, with nothing on
    the face saying why. Picking a key now leaves every-note mode, and the menu
    reads Every note while it is on.
    [main.cpp]
2026-10-02 fix(proto): stage feedback simulator back on the face
    The owner wants it visible; only Advanced and the input gate tuning stay
    behind Cmd+Shift+D.
    [main.cpp]
2026-10-02 feat(proto): Unison CHARACTER and Gate DECAY become panel knobs
    CHARACTER is the Chorus-to-Double blend, with CHORUS and DOUBLE printed at
    its ends; DECAY is the gate release, the knob gate pedals pair with
    THRESHOLD. Both leave Tuning and print on the Knobs line.
2026-10-02 feat: headline transport row; slapback INTENSITY drives repeats, TIME knob
    The transport row reads as the headline at 1.4x type. Print tuning becomes
    Copy settings to clipboard and loses its text box. Slapback INTENSITY now
    sets level and repeats together, landing on the owner's 2.5 repeats at the
    default 25 %, and TIME is a panel knob from 30 to 150 ms.
2026-10-02 fix(proto): right-justify copy button; header switches as toggle buttons
    At headline size an ImGui checkbox is a large empty square that does not
    read as a switch. STAGE FEEDBACK is now a lit button showing ON or OFF;
    the dev-only Advanced lights when on. The copy button sits at the right
    edge, sized to its full label so Copied never moves it.
    [main.cpp]
2026-10-02 fix(proto): stage feedback Amount back to the full simulator range
    Owner: only Movement keeps the 75 % cap. Amount default returns to 50 %,
    the same sound the capped 67 % made.
    [main.cpp]
2026-10-02 fix(proto): CHASM Wobble slider reaches the full engine range
    The musician slider mapped 100 % to wobble 0.6, about a third of the old
    WOBBLE knob's depth. 100 % is 1.0 again; 50 % stays at today's 0.15.
    [macros.h]
2026-10-02 feat(proto): Unison RATE replaces CHARACTER on the panel
    Chorus and double both put about 20 cents of pitch offset on the copy, so
    CHARACTER barely changed the sound. RATE speeds the chorus from ~0.2 to
    ~6 Hz, narrowing the sweep past today's rate so the pitch swing caps near
    twice today's. Chorus-Double returns to Tuning; both still run together.
    [macros.h, main.cpp]
2026-10-02 feat(proto): pedal mode shows each effect as a stompbox
    A bottom-right button flips the face to a row of pedals in signal order
    with only their panel knobs: round knobs, detented encoders for KEY and
    SEMITONES, and a footswitch LED with the name. The layout probe checks it.
    [main.cpp]
2026-10-02 fix(proto): headline-size Pedal mode button; no Output EQ pedal
    Owner: the mode button was too small and the EQ pedal had no knobs. Eight
    pedals now share the row, which also widens each pedal.
    [main.cpp]
2026-10-02 feat(proto): panel order Autotune, Harmony, Octave
    Autotune and Harmony share the KEY encoder, so they sit together; Octave
    follows. Order is layout only: the three pitch stages run in parallel off
    the dry mic. Harmony's Advanced Levels and Trims split to keep column 2
    inside the window.
2026-10-02 fix(proto): header toggles no longer crash; version label v0.01.00
    toggleButton popped its style colour based on the state after the click,
    so turning STAGE FEEDBACK or Advanced off pushed without a pop and ImGui
    aborted. It now pops on the state it drew with; the layout probe clicks
    both toggles on and off. The face shows VERSION.txt bottom left, bumped
    by tools/bump_version.sh on every change.
    [main.cpp]
2026-10-02 fix(reverb): DWELL clipper gets headroom; retrim wet levels
    All three engines distorted at default DWELL (PARKER 9.5 % THD on a
    -6 dBFS sine) because the soft clip sat at the signal's own level. Each
    clipper now has about 10 dB of headroom, so DWELL saturates only near
    the top of its travel. Wet trims re-land the level rule; CHASM sits at
    the bottom of the window. New reverb_clean test holds THD under 0.5 %.
    [chasm.h, spring.h]
2026-10-02 feat(proto): BYPASS button; input gate gets the Gate's controls
    BYPASS sits above Pedal mode and sends the dry input out while the chain
    and the stage feedback loop keep running. The input gate now shows
    THRESHOLD and DECAY on the face and Mute amount, Fade in and Stay open in
    Tuning, in both views. The probe clicks BYPASS on and off.
2026-10-02 feat: gate runs before distortion, as in Adam's rig
    His chain is V3 (with slapback), noise gate, BD-2, spring. The audio,
    render tool, full view and pedal view now run slapback, gate,
    distortion, reverb.
    [main.cpp]
2026-10-02 revert: gate back after distortion
    Owner: after the drive the gate also mutes the hiss and feedback the
    drive adds, which matters more than matching Adam's pedal order.
    [main.cpp]
2026-10-02 feat(engine): engine A grain delay is settable for autotune
    Grid PSOLA reads each grain at a fixed delay, so its latency is not tied
    to the lowest pitch. Default stays 1040 samples. A sweep on Adam's loop
    shows shorter delays lose his 2-cent hard tune because the tracker's
    measurement then trails the audio; the tracker is the next step.
    [autotune.h, psola.h]
2026-10-02 feat(proto): autotune RESPONSE runs NATURAL to MECHANICAL like the V3
    Adam's V3 knob turns right for a harder snap. The engine keeps responseMs;
    the panel maps knob position through a shared log taper so the H7 matches.
    [autotune.h, main.cpp]
2026-10-02 feat(proto): AUTOTUNE on/off toggle under the pedal knobs
    The footswitch strip does not read as a switch on the autotune pedal. The row
    also spans eight pedals now that Harmony is gone.
2026-10-02 feat(proto): header row spans the window; autotune slide switch
    Header items keep their natural widths and share the spare width evenly. The
    autotune pedal gets a large centred slide switch in place of the button.
2026-10-02 feat(proto): CHASM Wobble tops out at the old 90 % setting
    [macros.h]
2026-10-02 fix(reverb): PARKER loses its hiss and gets its top end back
    The read modulation ran on noise up to ~500 Hz, which hissed at -57 dB above
    4 kHz; a 0.998 pole drops it to -86 dB. The C_hf branch now mixes at -10 dB,
    so the tail is no longer cut at H_low's 4.75 kHz. Wet trim retuned.
    [macros.h]
2026-10-02 feat: new defaults for stage feedback and both gates
    Stage feedback Amount 70 %, Movement 50 %. Input gate -12 dB, DECAY 10 ms.
    Gate -20 dB, DECAY 20 ms. Gate tests pin the -40 dB threshold they measure.
2026-10-02 feat(reverb): SPRING gets PARKER's Drip control
    Drip sweeps the C_lf allpass coefficient and section count the way PARKER's
    Drip does (0.60/0.75/0.85, 80/130/130). 50 % is the old SPRING.
2026-10-02 fix(reverb): INTENSITY sets mix and decay; DWELL stays, MIX goes
    The owner meant INTENSITY as amount plus decay length, like slapback's. DWELL
    is the second knob again.
    [main.cpp, reverb.h]
2026-10-02 feat: Adam's starting settings become the defaults
    The owner's copied settings are baked in: macro start positions, panel knobs
    and choices in the app, and the matching engine tuning defaults for the H7.
    The layout probe now checks that the start positions reproduce the engine
    defaults, and --print-defaults prints a fresh app's settings. SPRING and
    PARKER wet trims are retuned to keep the level rule.
2026-10-02 build: one-line installer puts the prototype on Adam's Desktop
    package.sh now compiles GLFW in statically and builds a universal app, then
    zips it with the sample loops. install.sh downloads the latest release zip
    into ~/Desktop/Vox Processor Prototype.
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2026-10-02 feat(hardware): KiCad project, schematic, parts library and first board placement
    Generated with foreman from tools/build_spec.py; ERC 0, netlist parity
    0/0/0. h7core/fxbox blocks cloned from Teensy-H7-Port 48f1e82. Library
    carries LCSC codes for every part and manufacturer STEPs for the panel
    parts. Board: MCU and power-in islands placed, controls on a provisional
    grid, jacks on the underside, no copper, outline provisional.
    [cubevox.kicad_pcb, cubevox.kicad_sch, fxbox.kicad_sch, h7core_block.kicad_sch]
2026-10-02 feat(hardware): 200x150 board, rear-wall jack order, analog island placed
    Owner rulings 2026-10-02 pm: board 200 x 150 for now; rear wall left to
    right 1/4in out, USB-C, XLR combo, barrel; every jack faces the rear edge
    and sits proud of it. Analog island (preamp, relay, output buffer, ADC
    and DAC feeds) placed right-rear; buck block left-rear; USB-C group with
    ESD and CC resistors at the rear middle; MCU island centred. Netlist
    parity 0/0/0, no on-board courtyard or hole findings.
    [cubevox.kicad_pcb]
2026-10-02 feat(hardware): board turned so the rear edge is at the top; knobs along the bottom
    Owner 2026-10-02: the view reads as the box sits, rear at the top of the
    KiCad view, knobs nearest the player. Rigid 180-degree turn of every
    placed part, islands slid back to keep the rear order (1/4in out, USB-C,
    XLR combo, barrel). Knob layout is the owner's. Netlist parity 0/0/0,
    no on-board courtyard or hole findings.
    [cubevox.kicad_pcb]
2026-10-02 fix(hardware): control rows back inside the outline after the turn
    [cubevox.kicad_pcb]
2026-10-02 fix(hardware): centre the board on the A4 page, everything moved with it
    [cubevox.kicad_pcb]
2026-10-02 feat(hardware): board cleared to jacks, pots, encoders, OLED; rest parked aside; 3 mm fillets
    Owner 2026-10-02: he arranges the panel parts himself. Everything else
    sits in a 10 mm grid right of the outline. Outline 200 x 150 with 3 mm
    corner fillets. Netlist parity 0/0/0.
    [cubevox.kicad_pcb]
2026-10-02 fix(hardware): OLED header onto the board for the owner's layout
    [cubevox.kicad_pcb]
2026-10-02 feat(hardware): refs RVGAIN/ENC101-103/SWBYPASS/SWBOOT/SWRESET, silk pass, control rows at 22.25 mm
    Owner 2026-10-02: control rows y 165 (RV101-RV109) and y 130 (RV110-RV114,
    RVGAIN, ENC101-103), 5 mm side padding, equal pitch. foreman silk applied;
    one 1.0 mm designator on silk per pot/encoder/switch/jack, LCSC/MPN text
    hidden. ERC 0, netlist parity 0/0/0.
    [cubevox.kicad_pcb, cubevox.kicad_sch, h7core_block.kicad_sch]
2026-10-02 feat(hardware): owner's panel grid: 8 stage columns (toggle/pot/pot-or-encoder), OLED + menu encoder centred
    [cubevox.kicad_pcb]
2026-10-02 feat(hardware): SH1106 1.3in OLED module footprint + model; owner's panel layout; refs end in 1
    Footprint OLED-1.3-SH1106-I2C-4P from the vendor drawings (35.4x33.5,
    holes 30.4x28.5, 4-pin header GND/VCC/SCL/SDA, active area on User.1),
    STEP on 8 mm standoffs. J117 pins now GND, 3V3, SCL, SDA. Panel: bypass
    and gain under the jacks, OLED + menu encoder centred, eight stage
    columns with KEY and SEMITONES in columns 1-2. RVGAIN1 / SWBYPASS1 /
    SWBOOT1 / SWRESET1 clear KiCad's annotation warning. ERC 0, parity 0/0/0.
    [cubevox.kicad_pcb, cubevox.kicad_sch, h7core_block.kicad_sch]
2026-10-02 feat(hardware): owner's panel placement (jacks, pots, encoders, OLED, switches)
    [cubevox.kicad_pcb]
2026-10-02 fix(hardware): toggles SW101-SW108 left to right; groups removed, nothing locked
    [cubevox.kicad_pcb, cubevox.kicad_sch]
2026-10-02 docs(hardware): revision 2 analog chain after the schematic audit
    OPA2197 (RRIO), AC-coupled gain legs (DC gain 1), VREF follower isolated
    by 22 R, stage-2 feedback returns to ground, 26 dB + 0-34 dB, 0.1 %
    difference amp, electrolytic coupling, DAC 470 R / 2.2 nF, no jack
    detect (both T pads are the tip), TPS2116 threshold 4.6 V, ADC SCKI from
    SAI1_MCLK_A. Dispositions for A01-A09, I01-I04.
2026-10-02 feat(hardware): revision 2 analog chain in schematic, board and parts
    Implements the accepted audit findings: OPA2197 preamp with AC-coupled
    gain legs (DC gain 1), 0.1 % difference amp, isolated VREF follower
    (22 R + 10 uF), pot-as-feedback stage 2 over 200 R + 100 uF, DAC and
    output coupling as electrolytics, both NCJ6FA-H T pads tied (no sense
    GPIO), ADC SCKI from SAI1_MCLK_A on PE2 with QSPI moved to bank 2.
    ERC 0, netlist parity 0/0/0, owner-placed panel parts unmoved. Adds
    the audit, its response, and the evidence capture.
    [cubevox.kicad_pcb, cubevox.kicad_sch, h7core_block.kicad_sch]
2026-10-02 feat(hardware): M3 corner holes, rest-boss keep-outs, 24 mm panel grid, board STEP
    Four M3 holes 5 mm in from each edge with 7 mm copper seats, two 8 mm
    rest-boss keep-outs at (100,100) and (197,100), stale fxbox m3seat zones
    and the hand-drawn Edge.Cuts circles removed. All three panel rows share
    eight columns at 24 mm pitch centred on the board. STEP export of the
    board with on-board parts only for the enclosure model.
    [cubevox-board.step, cubevox.kicad_pcb]
2026-10-02 fix(hardware): USB-C and barrel jack bodies in the board STEP
    The STEP exporter drops VRML-only models. Both jacks now have an EasyEDA
    STEP beside the VRML with the same basename so --subst-models picks it
    up. The barrel STEP's origin was the bore axis; it is translated into the
    VRML frame (board plane, pins at -x) so it lands where the viewer shows it.
    [cubevox-board.step]
2026-10-02 feat(hardware): bypass toggle and gain pot moved onto the outer 24 mm columns
    SWBYPASS1 to (64.5, 70) and RVGAIN1 to (232.5, 72) so the top row shares
    the panel grid's outer columns. Keep-out zones re-saved by KiCad.
    [cubevox.kicad_pcb]
2026-10-02 docs(hardware): console enclosure decision (spec item 27)
    Three printed parts modelled in Fusion from the board STEP: 10 deg wedge
    tray, rear plate square to the board, 2 mm lid with toggle trough. Records
    the board changes it asks for (J101, J108, OLED standoffs) and the pot
    shaft exposure.
2026-10-02 feat(hardware): revision 3 analog chain, 9 V only, no external flash
    Removes the QSPI flash, the TPS2116 USB power mux and the duplicate M2
    OLED holes. Settings live in internal flash bank 2; USB is data only.
    Codex round 2 (hardware/audit) accepted: stage 1 20 dB, TRS pad -25.7 dB,
    47 uF mic coupling, bipolar C158, R116 330 R, relay pole B as the
    FX_ON_SENSE dry contact, VBUS divider 33k/82k on PA9, output mute relay
    K102 on PD12 with 5VA sense on PC4. ERC 0, netlist parity 0/0/0, panel
    parts unmoved.
    [cubevox.kicad_pcb, cubevox.kicad_sch, h7core_block.kicad_sch]
2026-10-02 feat(hardware): islands placed, rest-boss zones out, fab rules in, placement brief
    MCU, power and analog islands placed from the panel grid; both rest_boss
    rule areas withdrawn by the owner (no board keep-outs for the enclosure);
    foreman rules write puts the JLC 4-layer fab table and netclasses into
    the board; brief gains sections, flow, grids, 36 fixed parts, 42 clusters
    and loses the QSPI and 5V_PRODUCT rows; confirmed 24c1c9e0.
    [cubevox.kicad_pcb]
2026-10-02 chore(hardware): mechanical pass records, 36 fixed parts locked
    register init seeds 29 pending entries; E0001-E0036 lock every owner-placed
    part with a do_not_move courtyard reservation; mechanical gates in ledger
    0012 (outline PASS 222, mouth not measured for J101/J108, J106 model past
    courtyard); state advances to placement.
2026-10-02 layout: move C1->268.00,35.00, C10->268.00,89.00, C101->274.00,89.00, C11->268.00,95.00, C111->274.00,95.00, C12->268.00,101.00, C13->268.00,107.00, C130->274.00,101.00, C134->274.00,107.00, C135->27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
    [cubevox.kicad_pcb]
2026-10-02 layout: move C18->123.50,39.05, D2->130.82,39.05, R4->134.48,39.05, R5->116.18,39.05, R6->127.16,39.05, R7->119.84,39.05 (ledger 0019)
    [cubevox.kicad_pcb]
2026-10-02 layout: move D105->229.59,45.22, D106->234.41,45.22 (ledger 0020)
    [cubevox.kicad_pcb]
2026-10-02 layout: move C112->101.68,53.00, C113->101.68,55.81, C116->101.68,50.19 (ledger 0021)
    [cubevox.kicad_pcb]
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2026-10-02 layout: move C21->87.24,55.96, C22->87.24,60.90, L1->87.24,65.84 (ledger 0022)
    [cubevox.kicad_pcb]
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2026-10-02 layout: move C20->93.49,57.18, C23->97.51,57.18 (ledger 0023)
    [cubevox.kicad_pcb]
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2026-10-02 layout: move C24->102.03,64.41, C25->102.03,61.96 (ledger 0024)
    [cubevox.kicad_pcb]
2026-10-02 layout: move C114->100.50,46.00, C115->103.50,46.00, C19->109.00,46.00, L101->96.00,46.00 (ledger 0025)
    [cubevox.kicad_pcb]
2026-10-02 layout: move C112->99.50,53.00, C113->97.00,53.00, C116->93.50,50.00 (ledger 0026)
    [cubevox.kicad_pcb]
2026-10-02 layout: move C20->92.00,60.90, C23->96.00,64.00 (ledger 0027)
    [cubevox.kicad_pcb]
2026-10-02 layout: move R142->137.00,60.50, R143->139.50,60.50 (ledger 0028)
    [cubevox.kicad_pcb]
2026-10-02 layout: move C21->102.50,68.00, C22->105.50,68.00, L1->97.50,68.00 (ledger 0029)
    [cubevox.kicad_pcb]
2026-10-02 layout: move C24->102.50,63.50, C25->109.50,63.50 (ledger 0030)
    [cubevox.kicad_pcb]
2026-10-02 layout: move D3->112.00,68.00, R10->108.50,68.00 (ledger 0031)
    [cubevox.kicad_pcb]
2026-10-02 layout: move C117->109.50,51.50, C163->115.50,51.50, FB101->107.00,51.50, R151->111.50,51.50, R152->113.50,51.50 (ledger 0032)
    [cubevox.kicad_pcb]
2026-10-02 layout: move C18->122.50,40.50, D2->125.50,40.50, R4->128.50,40.50, R5->120.50,40.50, R6->130.50,40.50, R7->132.50,40.50 (ledger 0033)
    [cubevox.kicad_pcb]
2026-10-02 layout: move C163->116.00,51.50, D3->112.50,68.00, R10->109.00,68.00, R151->112.00,51.50, R152->114.00,51.50 (ledger 0034)
    [cubevox.kicad_pcb]
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2026-10-02 layout: move C15->102.00,98.00, C16->108.00,99.00, R1->108.00,95.50, Y1->105.00,95.50 (ledger 0035)
    [cubevox.kicad_pcb]
2026-10-02 layout: move R27->98.00,94.00, R29->100.00,94.50 (ledger 0036)
    [cubevox.kicad_pcb]
2026-10-02 layout: move C4->102.00,94.50, C59->104.00,94.00, C7->104.50,99.50 (ledger 0037)
    [cubevox.kicad_pcb]
2026-10-02 layout: move C10->114.00,94.50, C11->112.00,94.50, C8->112.00,98.00, C9->110.00,94.50, FB1->110.00,98.00 (ledger 0038)
    [cubevox.kicad_pcb]
2026-10-02 layout: move C55->114.00,98.00, R30->114.00,101.50 (ledger 0039)
    [cubevox.kicad_pcb]
2026-10-02 layout: move C2->95.50,92.00, C56->96.00,90.00 (ledger 0040)
    [cubevox.kicad_pcb]
2026-10-02 layout: move C59->110.00,74.00 (ledger 0041)
    [cubevox.kicad_pcb]
2026-10-02 layout: move C14->94.50,101.00, R2->95.50,88.00, SWBOOT1->89.50,94.00, SWRESET1->89.50,101.00 (ledger 0042)
    [cubevox.kicad_pcb]
2026-10-02 layout: move J3->95.00,81.00 (ledger 0043)
    [cubevox.kicad_pcb]
2026-10-02 layout: move D1->92.00,86.00, R3->95.50,86.00 (ledger 0044)
    [cubevox.kicad_pcb]
2026-10-02 layout: move C1->98.00,73.50, C13->102.00,73.50, C31->108.00,73.50, C32->104.00,73.50, C57->100.00,74.00, C6->106.00,73.50 (ledger 0045)
    [cubevox.kicad_pcb]
2026-10-02 layout: move C12->116.00,79.00, C3->116.00,92.50, C5->116.00,73.00, C58->116.00,89.50, C61->116.00,76.00 (ledger 0046)
    [cubevox.kicad_pcb]
2026-10-02 layout: move C14->79.00,97.00, SWBOOT1->84.00,97.00, SWRESET1->74.00,97.00 (ledger 0047)
    [cubevox.kicad_pcb]
2026-10-02 layout: move D105->229.59,49.00, D106->234.41,49.00 (ledger 0048)
    [cubevox.kicad_pcb]
2026-10-02 chore(hardware): hand-solder clearance rule and reservations
2026-10-02 layout: move C143->179.44,65.50, C144->166.94,65.50, C145->179.19,86.00, ENC101->173.94,75.50, J108->72.50,40.00, J117->135.78,77.50, R127->175.69,65.50, R128->170.69,65.50, R129->175.69,85.50, R142-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
    [cubevox.kicad_pcb]
2026-10-02 layout: move K101->76.00,59.00, K102->76.00,70.00 (ledger 0050)
    [cubevox.kicad_pcb]
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2026-10-03 layout: move J108->72.50,41.00, K101->76.00,60.00, K102->76.00,70.50 (ledger 0053)
    [cubevox.kicad_pcb]
2026-10-03 feat(hardware): output jack J108 is HOOYA PJ-611E (C309282)
    [cubevox.kicad_sch]
2026-10-03 layout: move U104->200.00,79.50 (ledger 0054)
    [cubevox.kicad_pcb]
2026-10-03 layout: move C119->210.00,63.50, C120->207.00,70.50, D107->207.00,63.50, R101->207.00,59.50, R103->206.50,77.50, R144->204.00,63.50 (ledger 0055)
    [cubevox.kicad_pcb]
2026-10-03 layout: move C123->196.00,63.50, C124->193.00,70.50, D108->193.00,63.50, R104->193.00,59.50, R106->193.50,77.50, R145->190.00,63.50 (ledger 0056)
    [cubevox.kicad_pcb]
2026-10-03 layout: move C121->213.50,70.50, C125->186.50,70.50, R102->206.50,79.50, R105->193.50,79.50, R148->213.50,76.00, R149->186.50,76.00 (ledger 0057)
    [cubevox.kicad_pcb]
2026-10-03 layout: move C118->197.50,84.00, C128->206.50,83.50, C129->193.50,83.50, C158->200.50,90.00, R108->206.50,81.50, R109->193.50,85.50, R110->193.50,81.50 (ledger 0058)
    [cubevox.kicad_pcb]
2026-10-03 layout: move C127->227.50,78.50, R111->231.00,90.00, R112->233.00,90.00, R113->229.00,90.00, R114->227.00,90.00 (ledger 0059)
    [cubevox.kicad_pcb]
2026-10-03 layout: move C132->231.00,78.50, C159->239.50,82.00, R116->234.50,78.50 (ledger 0060)
    [cubevox.kicad_pcb]
2026-10-03 layout: move R111->231.00,90.50, R112->233.00,90.50, R113->229.00,90.50, R114->227.00,90.50 (ledger 0061)
    [cubevox.kicad_pcb]
2026-10-03 layout: move C134->133.50,98.00, C44->134.50,101.50, C45->130.00,103.50, C46->133.50,104.00, C47->130.00,101.50, C48->133.50,106.00, C49->130.00,105.50, R20->136.00,98.00 (ledger 0062)
    [cubevox.kicad_pcb]
2026-10-03 layout: move C101->148.00,100.50, C111->148.00,105.50, C33->136.50,105.00, C34->151.00,104.00, C35->148.00,102.50, R16->148.00,98.50 (ledger 0063)
    [cubevox.kicad_pcb]
2026-10-03 layout: move C136->117.00,99.00, C137->117.00,103.50, C138->112.00,105.50, R119->117.00,101.00 (ledger 0064)
    [cubevox.kicad_pcb]
2026-10-03 layout: move C139->155.50,104.50, C161->155.00,100.50, R122->161.00,103.00, R123->161.00,105.00, R147->151.50,101.00 (ledger 0065)
    [cubevox.kicad_pcb]
2026-10-03 layout: move C130->156.00,85.50, C135->166.50,94.50, C160->157.50,96.50, R117->162.00,94.00, R118->164.00,94.00, R146->156.00,92.50 (ledger 0066)
    [cubevox.kicad_pcb]
2026-10-03 layout: move C141->161.00,76.50, R124->161.00,82.00, R125->157.00,76.50 (ledger 0067)
    [cubevox.kicad_pcb]
2026-10-03 layout: move C162->83.50,60.50, D104->69.00,60.00, R120->83.50,57.00 (ledger 0068)
    [cubevox.kicad_pcb]
2026-10-03 layout: move D109->72.50,77.50, Q101->77.50,77.50, R150->81.50,78.50, R153->81.50,80.50 (ledger 0069)
    [cubevox.kicad_pcb]
2026-10-03 layout: move C142->150.00,136.50, C145->179.44,85.50, C147->57.50,154.00, C27->144.50,134.00, C28->141.00,131.00, R126->151.00,133.50 (ledger 0070)
    [cubevox.kicad_pcb]
2026-10-03 layout: move C136->117.00,98.00, C137->118.50,104.00, R119->117.00,100.00, R147->151.50,100.50 (ledger 0071)
    [cubevox.kicad_pcb]
2026-10-03 layout: move R27->97.50,94.00, R29->99.50,94.50 (ledger 0073)
    [cubevox.kicad_pcb]
2026-10-03 layout: move C2->95.00,92.00, R27->97.75,94.00 (ledger 0074)
    [cubevox.kicad_pcb]
2026-10-03 chore(hardware): silk references, brief corrections draft, placement records
    [cubevox.kicad_pcb]
2026-10-03 chore(hardware): brief confirmed, jack references to back silk
    [cubevox.kicad_pcb]
2026-10-03 chore(hardware): J101 face, OLED standoff clearance, pin 11 decision
2026-10-03 layout: move J101->190.00,45.20 (ledger 0080)
    [cubevox.kicad_pcb]
2026-10-03 layout: move C139->155.50,105.00, C160->157.50,97.00, C161->155.00,101.00, C3->116.00,95.50, R146->156.50,93.00 (ledger 0083)
    [cubevox.kicad_pcb]
2026-10-03 layout: move C1->88.00,73.50, C10->104.00,94.50, C11->102.00,94.50, C12->106.00,79.00, C13->92.00,73.50, C14->69.00,97.00, C15->92.00,98.00, C16->98.00,99.00, C2->85.00,92.00, C3->106.00,92.50, C31->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
    [cubevox.kicad_pcb]
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2026-10-03 layout: move C13->94.00,73.50, C31->100.00,73.50, C32->96.00,73.50, C59->102.00,74.00, C6->98.00,73.50 (ledger 0085)
    [cubevox.kicad_pcb]
2026-10-03 layout: move C7->94.50,100.50, Y1->95.00,96.20 (ledger 0086)
    [cubevox.kicad_pcb]
2026-10-03 layout: move C10->107.50,98.00, C11->103.00,94.50, C16->99.00,99.00, C4->93.25,94.50, C55->105.00,98.00, C7->94.50,101.00, C8->103.00,98.00, C9->101.00,94.50, FB1->101.00,98.00, R1->99.00,95.50, R29-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
    [cubevox.kicad_pcb]
2026-10-03 layout: move C15->92.75,98.75, C4->93.35,94.50, C7->94.75,101.00, R1->99.00,95.00, Y1->96.20,96.70 (ledger 0088)
    [cubevox.kicad_pcb]
2026-10-03 layout: change on /h7core_block/HSE_IN,/h7core_block/HSE_OUT,/h7core_block/HSE_XTAL_OUT (ledger 0089)
    [cubevox.kicad_pcb]
2026-10-03 layout: change on /h7core_block/ADC_SCKI_SRC,/h7core_block/I2S_BCLK_SRC (ledger 0090)
    [cubevox.kicad_pcb]
2026-10-03 layout: move C1->86.50,73.50, C13->90.00,73.50, C57->88.25,74.00 (ledger 0091)
    [cubevox.kicad_pcb]
2026-10-03 layout: change on /BUCK5_BST,/BUCK5_SW,/h7core_block/BUCK_BST,/h7core_block/BUCK_SW (ledger 0092)
    [cubevox.kicad_pcb]
2026-10-03 layout: change on /h7core_block/VCAP1,/h7core_block/VCAP2 (ledger 0093)
    [cubevox.kicad_pcb]
2026-10-03 layout: change on /GND,/h7core_block/CC1,/h7core_block/CC2,/h7core_block/USB_DM,/h7core_block/USB_DP,/h7core_block/VBUS (ledger 0094)
    [cubevox.kicad_pcb]
2026-10-03 layout: change on /5V,/GND (ledger 0095)
    [cubevox.kicad_pcb]
2026-10-03 layout: change on /5V,/GND (ledger 0096)
    [cubevox.kicad_pcb]
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2026-10-03 chore(hardware): STEP models for toggles and jacks
    STEP is the first model on the toggle, USB-C, barrel and PJ-611E footprints so the board STEP export includes them. PJ-611E STEP from EasyEDA C309282, aligned to the pads.
2026-10-03 layout: change on /3V3,/GND (ledger 0097)
    [cubevox.kicad_pcb]
2026-10-03 layout: change on /3V3,/GND (ledger 0098)
    [cubevox.kicad_pcb]
2026-10-03 layout: change on /3V3 (ledger 0099)
    [cubevox.kicad_pcb]
2026-10-03 layout: change on /3V3 (ledger 0100)
    [cubevox.kicad_pcb]
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2026-10-03 layout: change on /3V3A,/GND (ledger 0101)
    [cubevox.kicad_pcb]
2026-10-03 layout: change on /5VA,/GND (ledger 0102)
    [cubevox.kicad_pcb]
2026-10-03 layout: change on /9V_JACK (ledger 0103)
    [cubevox.kicad_pcb]
2026-10-03 layout: change on /GND,/VIN_9V (ledger 0104)
    [cubevox.kicad_pcb]
2026-10-03 layout: change on /GND,/h7core_block/VDDA (ledger 0105)
    [cubevox.kicad_pcb]
2026-10-03 layout: change on /GND,/h7core_block/ADC_VCC (ledger 0106)
    [cubevox.kicad_pcb]
2026-10-03 layout: change on /GND,/VREF (ledger 0107)
    [cubevox.kicad_pcb]
2026-10-03 layout: change on /GND (ledger 0108)
    [cubevox.kicad_pcb]
2026-10-03 layout: change on /GND (ledger 0109)
    [cubevox.kicad_pcb]
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2026-10-03 layout: move C143->179.44,60.50, C144->166.94,60.50, C145->179.44,80.50, ENC101->173.94,70.50, J117->135.78,72.50, R127->175.69,60.50, R128->170.69,60.50, R129->175.69,80.50, R142->137.00,53.00, R143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
    [cubevox.kicad_pcb]
2026-10-03 layout: change on /3V3 (ledger 0111)
    [cubevox.kicad_pcb]
2026-10-03 chore(hardware): OLED north move records and 3V3 rebuild
    Brief 0ac6ed47 confirmed, classification regenerated (USB 60 mm), 3V3 copper rebuilt after the owner's 5 mm move.
2026-10-03 layout: move J1->125.39,33.76 (ledger 0113)
    [cubevox.kicad_pcb]
2026-10-03 layout: move RVGAIN1->232.50,65.00, SWBYPASS1->64.50,62.00 (ledger 0114)
    [cubevox.kicad_pcb]
2026-10-03 layout: move D104->74.00,53.60 (ledger 0115)
    [cubevox.kicad_pcb]
2026-10-03 layout: move C162->86.50,60.50, D104->77.00,53.60, D109->74.50,77.50, K101->79.00,60.00, K102->79.00,70.50, Q101->79.50,77.50, R120->86.50,57.00, R150->79.50,80.75, R153->79.50,82.75 (ledger 0118)
    [cubevox.kicad_pcb]
2026-10-03 layout: change on /3V3,/5V (ledger 0119)
    [cubevox.kicad_pcb]
2026-10-03 layout: change on /3V3 (ledger 0120)
    [cubevox.kicad_pcb]
2026-10-03 layout: change on (ledger 0121)
    [cubevox.kicad_pcb]
2026-10-03 layout: change on /5V,/GND (ledger 0122)
    [cubevox.kicad_pcb]
2026-10-03 layout: change on /h7core_block/VDDA (ledger 0123)
    [cubevox.kicad_pcb]
2026-10-03 layout: change on /3V3A (ledger 0124)
    [cubevox.kicad_pcb]
2026-10-03 layout: change on /h7core_block/ADC_VCC (ledger 0125)
    [cubevox.kicad_pcb]
2026-10-03 layout: change on /5VA (ledger 0126)
    [cubevox.kicad_pcb]
2026-10-03 layout: change on /9V_JACK (ledger 0127)
    [cubevox.kicad_pcb]
2026-10-03 layout: change on /h7core_block/VCAP1,/h7core_block/VCAP2 (ledger 0128)
    [cubevox.kicad_pcb]
2026-10-03 layout: change on (ledger 0129)
    [cubevox.kicad_pcb]
2026-10-03 layout: change on /h7core_block/ADC_SCKI_SRC (ledger 0130)
    [cubevox.kicad_pcb]
2026-10-03 layout: change on /h7core_block/VBUS (ledger 0131)
    [cubevox.kicad_pcb]
2026-10-03 layout: change on /h7core_block/HSE_IN,/h7core_block/HSE_XTAL_OUT (ledger 0132)
    [cubevox.kicad_pcb]
2026-10-03 chore(hardware): pad-entry audit tool and repair records
    Straight-on pad entry (canon 132): checker, relay rebuild and 51 repairs.
2026-10-03 layout: move J101->190.00,45.20 (ledger 0134)
    [cubevox.kicad_pcb]
2026-10-03 layout: change on /3V3A,/5VA,/VREF (ledger 0136)
    [cubevox.kicad_pcb]
2026-10-03 layout: change on /3V3 (ledger 0138)
    [cubevox.kicad_pcb]
2026-10-03 layout: change on (ledger 0139)
    [cubevox.kicad_pcb]
2026-10-03 layout: change on /3V3 (ledger 0140)
    [cubevox.kicad_pcb]
2026-10-03 layout: change on (ledger 0141)
    [cubevox.kicad_pcb]
2026-10-03 layout: change on /3V3 (ledger 0142)
    [cubevox.kicad_pcb]
2026-10-03 layout: change on /3V3 (ledger 0143)
    [cubevox.kicad_pcb]
2026-10-03 layout: change on /3V3 (ledger 0144)
    [cubevox.kicad_pcb]
2026-10-03 layout: change on (ledger 0145)
    [cubevox.kicad_pcb]
2026-10-03 layout: change on /3V3A (ledger 0146)
    [cubevox.kicad_pcb]
2026-10-03 layout: change on /3V3A (ledger 0147)
    [cubevox.kicad_pcb]
2026-10-03 layout: change on /3V3A (ledger 0148)
    [cubevox.kicad_pcb]
2026-10-03 feat(reverb): add SPRING B, take PARKER off the face
    PARKER projects past the H7's CPU budget, so the prototype no longer offers it; its engine code stays. SPRING B is the CHASM loop voiced as a spring (in-loop upward sweep, 33/41 ms echoes, light diffusion) at CHASM's cost. CHASM is unchanged.
    [macros.h, main.cpp, reverb.h, spring_b.h]
2026-10-03 layout: change on (ledger 0149)
    [cubevox.kicad_pcb]
2026-10-03 layout: change on /5VA (ledger 0150)
    [cubevox.kicad_pcb]
2026-10-03 layout: change on (ledger 0151)
    [cubevox.kicad_pcb]
2026-10-03 layout: change on (ledger 0152)
    [cubevox.kicad_pcb]
2026-10-03 layout: change on (ledger 0153)
    [cubevox.kicad_pcb]
2026-10-03 docs(layout): record power redundancy cleanup D0110-D0124
    Action plans, closures and RUNLOG row for the via-hop and loop removal on the five power nets.
2026-10-03 feat(reverb): offer CHASM and SPRING B only, SPRING B default
    Adam picks between two reverbs. SPRING's engine code stays but the face no longer offers it; saved states that chose SPRING or PARKER load as SPRING B.
    [main.cpp]
2026-10-03 layout: change on /3V3 (ledger 0155)
    [cubevox.kicad_pcb]
2026-10-03 layout: change on /5V (ledger 0156)
    [cubevox.kicad_pcb]
2026-10-03 layout: change on (ledger 0157)
    [cubevox.kicad_pcb]
2026-10-03 docs(layout): record canon 133/134 cleanup D0125-D0127
    Plans, closures and RUNLOG row for the loop and avoidable-via removal on 3V3, 5V and ADC_VCC.
2026-10-03 layout: change on /3V3 (ledger 0158)
    [cubevox.kicad_pcb]
2026-10-03 layout: change on /3V3 (ledger 0159)
    [cubevox.kicad_pcb]
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2026-10-03 layout: change on /3V3A (ledger 0160)
    [cubevox.kicad_pcb]
2026-10-03 layout: change on /3V3A,/9V_JACK (ledger 0161)
    [cubevox.kicad_pcb]
2026-10-03 layout: change on /3V3A,/9V_JACK (ledger 0162)
    [cubevox.kicad_pcb]
2026-10-03 layout: change on /h7core_block/ADC_VCC (ledger 0163)
    [cubevox.kicad_pcb]
2026-10-03 layout: record owner hand routing D0134 (ledger 0165)
    The owner routed by hand in KiCad. Accept refused on four regression rows
    (drc_board_total, micro, overlaps, right_angles), so the saved bytes are
    committed as-is with register note E0100 and the regressions stay open for
    the router's follow-up declarations.
    [cubevox.kicad_pcb]
2026-10-03 layout: change on /h7core_block/ADC_SCKI_SRC (ledger 0166)
    [cubevox.kicad_pcb]
2026-10-03 layout: change on /VREF (ledger 0167)
    [cubevox.kicad_pcb]
2026-10-03 layout: change on /3V3 (ledger 0168)
    [cubevox.kicad_pcb]
2026-10-03 layout: change on /5V (ledger 0169)
    [cubevox.kicad_pcb]
2026-10-03 layout: change on /3V3,/TRS_R,/h7core_block/VDDA (ledger 0170)
    [cubevox.kicad_pcb]
2026-10-03 layout: move R27->88.15,94.00 (ledger 0171)
    [cubevox.kicad_pcb]
2026-10-03 layout: change on /3V3,/3V3A,/5V,/5VA,/GND (ledger 0172)
    [cubevox.kicad_pcb]
2026-10-03 layout: move C101->148.00,100.87, C111->148.00,105.43, C24->155.00,51.33, C25->148.00,51.67, U4->151.50,51.50 (ledger 0173)
    [cubevox.kicad_pcb]
2026-10-03 layout: move C35->148.00,102.82 (ledger 0174)
    [cubevox.kicad_pcb]
2026-10-03 layout: move C117->156.10,65.60, C163->162.80,63.50, FB101->156.10,61.00, R151->158.80,63.50, R152->160.80,63.50 (ledger 0176)
    [cubevox.kicad_pcb]
2026-10-03 docs(layout): record D0140-D0145 actions, closures and register
    Keeps the action lists and closures beside the accepted ledgers; 0175 is the closure of blocked D0144, kept as a record.
2026-10-03 layout: move C146->70.00,127.00, C147->57.50,127.00, C148->94.00,127.00, C149->81.50,127.00, R130->66.25,127.00, R131->61.25,127.00, R132->90.25,127.00, R133->85.25,127.00 (ledger 0177)
    [cubevox.kicad_pcb]
2026-10-03 layout: move D106->234.35,49.00 (ledger 0178)
    [cubevox.kicad_pcb]
2026-10-03 layout: move C21->86.45,69.47, C22->88.90,69.47, C23->96.28,64.00, C58->106.00,89.98, L1->93.50,68.00 (ledger 0179)
    [cubevox.kicad_pcb]
2026-10-03 layout: move C21->85.85,69.28, C22->88.60,69.28, C3->106.00,92.80, L1->93.50,67.80 (ledger 0180)
    [cubevox.kicad_pcb]
2026-10-03 layout: move C23->96.28,63.85 (ledger 0181)
    [cubevox.kicad_pcb]
2026-10-03 layout: move C23->96.28,63.88 (ledger 0182)
    [cubevox.kicad_pcb]
2026-10-03 layout: change on /TRS_T,/VREF (ledger 0183)
    [cubevox.kicad_pcb]
2026-10-03 layout: move C32->103.86,73.50, D2->125.19,39.50 (ledger 0184)
    [cubevox.kicad_pcb]
2026-10-03 layout: move C18->122.30,40.77 (ledger 0185)
    [cubevox.kicad_pcb]
2026-10-03 layout: move R5->120.40,40.50 (ledger 0186)
    [cubevox.kicad_pcb]
2026-10-03 docs(layout): record D0146-D0155 actions, closures and register
    Step-2 rail rebuilds, VIN/VREF/TRS_T off In2 and the USB move to F.Cu.
2026-10-03 layout: move C55->105.00,98.00 (ledger 0188)
    [cubevox.kicad_pcb]
2026-10-03 layout: change on /3V3,/5V,/GND,/h7core_block/VDDA (ledger 0189)
    [cubevox.kicad_pcb]
2026-10-03 layout: change on /h7core_block/CC2 (ledger 0190)
    [cubevox.kicad_pcb]
2026-10-03 layout: change on /MIC_P (ledger 0191)
    [cubevox.kicad_pcb]
2026-10-03 docs(layout): record D0159 acceptance
    Closure for D0159 (/MIC_P, ledger 0191) has no unintended changes; the acceptance line was left uncommitted by the stopped cleanup agent.
2026-10-03 layout: change on /h7core_block/USB_DM,/h7core_block/USB_DP,/h7core_block/VBUS (ledger 0192)
    [cubevox.kicad_pcb]
2026-10-03 docs(layout): record USB D2 and VBUS link D0160
    D2 flow-through pads were never bridged, so DP/DM stopped at the ESD part, and J1's two VBUS pins sat on separate islands. Ledger 0192: unconnected 169 -> 166, DRC errors 0.
2026-10-03 layout: change on /3V3,/GND,/h7core_block/ADC_DOUT,/h7core_block/ADC_SCKI,/h7core_block/ADC_VCC,/h7core_block/I2S_BCLK,/h7core_block/I2S_DATA,/h7core_block/I2S_LRCLK,C44 (ledger 0193)
    [cubevox.kicad_pcb]
2026-10-03 layout: change on /5VA,/GND,/h7core_block/ADC_DOUT,/h7core_block/ADC_SCKI,/h7core_block/ADC_VCC,/h7core_block/I2S_BCLK,/h7core_block/I2S_BCLK_SRC,/h7core_block/I2S_DATA,/h7core_block/I2S_LRCLK,C44,R2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
    [cubevox.kicad_pcb]
2026-10-03 docs(layout): record codec bus D0161 and D0162
    I2S_BCLK, I2S_LRCLK, I2S_DATA, ADC_SCKI and ADC_DOUT routed MCU to codec on one B.Cu run over the 3V3 island, with a ground via beside every signal via. U8/U6 ground vias moved under the IC bodies so signal pins have straight escapes. ADC_VCC chain rebuilt R20 > C44 > C45 > U8.3. Ledgers 0193, 0194: gate 17 pass, gate 71 21 > 6 fails.
2026-10-03 layout: change on /h7core_block/I2S_LRCLK (ledger 0195)
    [cubevox.kicad_pcb]
2026-10-03 docs(layout): record LRCLK U8 turn D0163
    Lengthened the LRCLK F.Cu leg north of U8 so gate 136 reads it as a turn, not a jog. Ledger 0195.
2026-10-03 layout: change on /GND,/h7core_block/CC1,/h7core_block/CC2,/h7core_block/USB_DM,/h7core_block/USB_DP,/h7core_block/VBUS,C18,D2,J1,R4,R5,R6,R7 (ledger 0196)
    [cubevox.kicad_pcb]
2026-10-03 layout: change on /h7core_block/USB_DM,/h7core_block/USB_DP (ledger 0197)
    [cubevox.kicad_pcb]
2026-10-03 docs(layout): record J1 move and USB reroute D0164-D0165
    Owner moved J1 10.39 mm west. The pair now runs orthogonal with four short chamfers instead of one 45 mm diagonal, coupled from D2 to U1. DP 58.12 mm, DM 57.68 mm of the 60 mm budget. J1 lock re-anchored as E0108.
2026-10-03 layout: change on /h7core_block/USB_DM,/h7core_block/USB_DP (ledger 0202)
    [cubevox.kicad_pcb]
2026-10-03 docs(layout): record owner USB reroute D0168
    Owner's hand reroute of USB_DP/DM (DP 54.99, DM 54.55 mm, 0 vias) with the 0.041 mm DM sliver merged. D0166 retired (declared against a baseline that already held the edit); D0167 amended to D0168.
2026-10-03 layout: change on /3V3,/FX_ON_SENSE,/GND,C162,R120 (ledger 0203)
    [cubevox.kicad_pcb]
2026-10-03 layout: change on /3V3,/GND,C3 (ledger 0204)
    [cubevox.kicad_pcb]
2026-10-03 layout: change on /3V3,/GND,/h7core_block/PWR_LED_A,D3,R10 (ledger 0205)
    [cubevox.kicad_pcb]
2026-10-03 layout: change on /GND,C139,C161 (ledger 0206)
    [cubevox.kicad_pcb]
2026-10-03 docs(layout): record R120/C162, C3, power LED, C139/C161 moves D0169-D0172
    R120/C162 to U1 pin 63 so the FX_ON_SENSE pull-up gets its own 3V3 via and the filter sits at the MCU; C3 0.3 mm north for 0.85 mm via stubs clear of the codec bus lanes; R10/D3 beside the MCU corner decoupler column; C139 1.0 mm and C161 0.75 mm north off SW105.
2026-10-03 layout: change on /3V3,/GND,SWBOOT1,SWRESET1 (ledger 0208)
    [cubevox.kicad_pcb]
2026-10-03 docs(layout): record owner SWRESET1/SWBOOT1 move and stubs D0173
    Owner moved SWRESET1 to (55,88) and SWBOOT1 to (55,98) for reach. Old stubs and vias at the previous spots removed; each GND and 3V3 pad has its own 1.15 mm stub and via. Ledger 0208, unintended 0.
2026-10-03 layout: change on /3V3,/3V3A,/GND,/h7core_block/MUX1_SIG_ADC,/h7core_block/VDDA,C164,C55,FB1 (ledger 0214)
    [cubevox.kicad_pcb]
2026-10-03 feat(hardware): feed VDDA from VDD through FB1, add C164 10uF
    AN4938 2.1.2: VDDA must stay within VDD + 0.3 V while VDD < 1 V. With FB1 fed from the separate 3V3A LDO nothing ordered the two rails. FB1 now takes 3V3, so VDDA follows VDD by construction. C164 (10 uF 0805, C15850) lowers the FB1 filter corner to ~60 kHz and damps its resonance. The generator also carries the J108 PJ-611E swap that was hand-edited into cubevox.json, so a regenerate no longer reverts it. Board: VDDA cluster rebuilt as a straight row FB1 > C8 > C164 > C10 with C9/C11 feeding C164; C55 moved beside R30; 32 mm 3V3A feed removed. ERC 0, DRC 0, D0175 ledger 0214.
    [h7core_block.kicad_sch]
2026-10-03 layout: change on /3V3,/FX_ON_SENSE,/GND,/h7core_block/PWR_LED_A,C139,C161,C162,C3,D3 (ledger 0217)
    [cubevox.kicad_pcb]
2026-10-03 fix(layout): restore 0.30 mm body gaps broken by D0169-D0172
    C3, D3, C162, C139 and C161 moved to clear C58, R10, R120, R147 and C160 by the 0.30 mm floor. body_tight 9 -> 4; the four left are recorded (D104/J108, J108/SWBYPASS1, crystal corner). D0177 ledger 0217.
2026-10-03 layout: change on /INA_O2,/TRS_R,/TRS_T,/VREF,/XLR_2,/XLR_3,C118,C119,C120,C121,C123,C124,C125,C128,C129,C158,D107,D108,R101,R102,R103,R104,R105,R106,R108,R109,R110,R144,R145,R148,R149,U104 (ledger 0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
    [cubevox.kicad_pcb]
2026-10-03 layout: change on /BUF_R,/GND,/OUT_AC,C141,R125,U106 (ledger 0221)
    [cubevox.kicad_pcb]
2026-10-03 feat(layout): input caps 5 mm east of ENC101, C141 beside the buffer
    C120/C121/C124/C125 and the whole input group (26 parts, 64 copper items) shifted +5 mm in x; the J101 verticals jog above the group and VREF's R103 stub is rebuilt on its pad centre. C141/R125 moved from between ENC101 and the OLED to just east of U106 (BUF_R and OUT_AC links routed); U106 reference moved off C141's silk. D0179 ledger 0219, D0181 ledger 0221, unintended 0.
2026-10-03 layout: change on /VREF (ledger 0223)
    [cubevox.kicad_pcb]
2026-10-03 fix(layout): keep VREF's B.Cu run over the 5VA island
    VREF crossed the 5VA/3V3A split on B.Cu to reach R123. It now crosses on F.Cu (over solid In1 GND) and the B.Cu tree is orthogonal runs over 5VA joined at vias; C160, R146 and R112 stubs start on their pad centres. Right angles 2 -> 0. D0183 ledger 0223.
2026-10-03 docs(layout): retire stale open declarations D0001, D0134, D0144
    D0134 (owner hand routing) is in the board since 5d100c2 and its refused rows were repaired by D0135-D0139 (E0100). D0144 was replaced by accepted D0145. D0001 is the first placement pile, superseded by every later accepted placement.
2026-10-03 layout: change on ENC101,ENC102,ENC103,RV101,RV102,RV103,RV104,RV105,RV106,RV107,RV108,RV109,RV110,RV111,RV112,RV113,RV114,RVGAIN1 (ledger 0225)
    [cubevox.kicad_pcb]
2026-10-03 feat(hardware): pots RK09D1130C2P, encoders EC11E to match
    Owner wants the 25 mm pot shaft. C2P (C361173) shares Alps drawing No. 4 with the C1B; only the shaft length differs, so pads stay. Encoders move to EC11E15244B2 (C470754, switch) and EC11E15204A3 (C470710) with the 24.5 mm tip; Alps drawings give EC11E the same PCB layout as EC11N. 3D models are the Alps C1B/EC11N STEPs with the shaft lengthened 5 mm inside the D-flat (tools/model_*.py), measured tips 25.0 and 24.5. Schematic regenerated with every pin on its old net, ERC 0; board D0184 ledger 0225, DRC 0, netlist parity 0/0/0.
    [cubevox.kicad_sch]
2026-10-03 chore(layout): commit unrecorded ledger and closure records
    Foreman wrote these during declare/amend, schematic and closure runs
    but they were never staged, leaving gaps in the audit trail.
2026-10-03 layout: change on J117,R142,R143,U1 (ledger 0227)
    [cubevox.kicad_pcb]
2026-10-03 layout: change on /5VA,/GND,/VA_SENSE,C163,R151,R152 (ledger 0229)
    [cubevox.kicad_pcb]
2026-10-03 layout: change on /GND,/VA_SENSE,C163 (ledger 0231)
    [cubevox.kicad_pcb]
2026-10-03 layout: change on U106 (ledger 0233)
    [cubevox.kicad_pcb]
2026-10-03 layout: change on U1 (ledger 0235)
    [cubevox.kicad_pcb]
2026-10-03 feat(hardware): reassign MCU pins to the edge facing each destination
    The old map left 14 of 35 local nets on the U1 edge facing away from
    their parts. Each movable net now leaves the facing edge in fan-out
    order, I2C moves to I2C2 on the OLED corner, CC1/CC2 come off the MCU
    (USB is data only) and MUTE_N avoids the JTAG pull-up pins. The
    VA_SENSE divider moves beside U106's 5VA pin with its cap at the MCU.
    [cubevox.kicad_sch, h7core_block.kicad_sch]
2026-10-03 layout: change on /5VA,/GND,/VA_SENSE,C130,R151,R152 (ledger 0237)
    [cubevox.kicad_pcb]
2026-10-03 layout: change on U1 (ledger 0241)
    [cubevox.kicad_pcb]
2026-10-03 layout: change on /GND,/MUTE_BASE,/h7core_block/USER_LED,/h7core_block/VCAP1,C12,D1,R150,R153,R2,R3,U1 (ledger 0243)
    [cubevox.kicad_pcb]
2026-10-03 feat(layout): clear the U1 west fan-out, divider north of U106
    R151/R152/C130 move north of U106, away from the OLED. Each part now
    shows one designator. USER_LED moves to PE11 with R3/D1 east of U1, R2
    sits at SWBOOT1, R150/R153 swap so MUTE_N enters from below, and C12
    turns so the I2C and MENU lines leave the east edge straight.
    [h7core_block.kicad_sch]
2026-10-03 docs(hardware): record SAI1, I2C2 and PB4/PB5 reset checks against DS12110
    Codex confirmed the alternate functions and reset pulls the pin study
    relies on, so the respin-critical NOT VERIFIED notes are cleared.
2026-10-03 layout: change on /MUTE_N,/h7core_block/SWCLK,/h7core_block/SWDIO,/h7core_block/SWO (ledger 0246)
    [cubevox.kicad_pcb]
2026-10-03 layout: change on /GND,/SW_BYPASS,D104,K101 (ledger 0248)
    [cubevox.kicad_pcb]
2026-10-03 layout: change on /GND,/h7core_block/NRST,C14 (ledger 0250)
    [cubevox.kicad_pcb]
2026-10-03 layout: change on /3V3A,/GND,C29,C30 (ledger 0252)
    [cubevox.kicad_pcb]
2026-10-04 chore(layout): name the SAI nets fast for canon 17
    The gate now judges every SAI layer change against the 3 mm stitching
    capacitor budget; eight vias are over it.
2026-10-04 layout: change on /3V3,/ENC_KEY_A,/ENC_KEY_B,/GND,C146,C147,R130,R131 (ledger 0255)
    [cubevox.kicad_pcb]
2026-10-04 fix(layout): put ENC102's pull-ups and filter caps on its pins
    They sat 30 mm away across RV103. The pull-ups take 3V3 by trace
    because the plane under the encoders is the 3V3A island. Records the
    retired top-layer clock attempt that hit U8's under-body vias.
2026-10-04 layout: change on /3V3,/3V3A,/5V,/5VA,/GND (ledger 0258)
    [cubevox.kicad_pcb]
2026-10-04 layout: change on /5VA (ledger 0261)
    [cubevox.kicad_pcb]
2026-10-04 layout: change on /5VA (ledger 0262)
    [cubevox.kicad_pcb]
2026-10-04 layout: change on /3V3A (ledger 0264)
    [cubevox.kicad_pcb]
2026-10-04 layout: change on /3V3A (ledger 0267)
    [cubevox.kicad_pcb]
2026-10-04 layout: change on /3V3A (ledger 0268)
    [cubevox.kicad_pcb]
2026-10-04 layout: change on J108 (ledger 0274)
    [cubevox.kicad_pcb]
2026-10-04 feat(layout): In2 becomes a second GND plane, rails routed as traces
    Every layer change on the board was ground-to-power because In2 held
    power islands; with SIG/GND/GND/SIG (canon 10) each change needs only
    a ground via. 5VA and 3V3A now run as B.Cu trees from a new grid
    router that follows canon 132/133/136 by construction. J108 takes its
    PJ-611E STEP model and the tact switches gain theirs, so the panel
    STEP export carries every jack and switch.
2026-10-04 layout: change on /5V (ledger 0277)
    [cubevox.kicad_pcb]
2026-10-04 layout: change on J101 (ledger 0279)
    [cubevox.kicad_pcb]
2026-10-04 feat(layout): move J101 2 mm north for enclosure screw clearance
    Through-plate screws hold the combo jack to the enclosure; the holes did not
    stand proud enough. Brief pin and overhang follow the board. Router seeds its
    tree with copper already joined to the source and only flags vias whose
    other-layer island is fed by another via.
2026-10-04 layout: change on /5V (ledger 0281)
    [cubevox.kicad_pcb]
2026-10-04 layout: change on /5V (ledger 0284)
    [cubevox.kicad_pcb]
2026-10-04 layout: change on /5V (ledger 0286)
    [cubevox.kicad_pcb]
2026-10-04 layout: change on /GND (ledger 0289)
    [cubevox.kicad_pcb]
2026-10-04 chore(layout): record 5V rail finish and J101 move in runlog
    5V is routed with no loops or avoidable vias. The dump no longer treats
    ferrite beads (value '...MHz') as crystals.
2026-10-04 layout: change on /3V3 (ledger 0291)
    [cubevox.kicad_pcb]
2026-10-04 layout: change on /3V3 (ledger 0293)
    [cubevox.kicad_pcb]
2026-10-04 layout: change on /3V3 (ledger 0295)
    [cubevox.kicad_pcb]
2026-10-04 layout: change on J101 (ledger 0297)
    [cubevox.kicad_pcb]
2026-10-04 feat(layout): move J101 2.5 mm south for enclosure screw holes
    Owner correction to the earlier 2 mm north move; J101 now sits 0.5 mm south
    of its D0056 spot. Brief pin and overhang follow. Also: 3V3 via merges
    (U1.100/C56, U1.75/C57, R135/R132), the 3V3 trunk undo, and router fixes
    (raster island grouping, start disk blocked after the first leg).
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2026-10-04 layout: change on /3V3A (ledger 0299)
    [cubevox.kicad_pcb]
2026-10-04 layout: change on /5VA (ledger 0301)
    [cubevox.kicad_pcb]
2026-10-04 layout: change on /3V3A (ledger 0302)
    [cubevox.kicad_pcb]
2026-10-04 layout: change on /5V (ledger 0303)
    [cubevox.kicad_pcb]
2026-10-04 layout: change on /5V (ledger 0304)
    [cubevox.kicad_pcb]
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2026-10-04 layout: change on /3V3A,/5V,/5VA,/h7core_block/HSE_XTAL_OUT,/h7core_block/I2S_BCLK,/h7core_block/I2S_DATA,/h7core_block/I2S_LRCLK (ledger 0306)
    [cubevox.kicad_pcb]
2026-10-04 layout: change on /3V3A (ledger 0308)
    [cubevox.kicad_pcb]
2026-10-04 layout: change on /3V3A (ledger 0309)
    [cubevox.kicad_pcb]
2026-10-04 layout: change on /5V (ledger 0311)
    [cubevox.kicad_pcb]
2026-10-04 layout: change on /h7core_block/I2S_DATA,/h7core_block/I2S_LRCLK (ledger 0312)
    [cubevox.kicad_pcb]
2026-10-04 layout: change on /h7core_block/I2S_LRCLK (ledger 0315)
    [cubevox.kicad_pcb]
2026-10-04 layout: change on /5V,C24 (ledger 0317)
    [cubevox.kicad_pcb]
2026-10-04 layout: change on /h7core_block/ADC_VCC (ledger 0318)
    [cubevox.kicad_pcb]
2026-10-04 layout: change on /GND (ledger 0320)
    [cubevox.kicad_pcb]
2026-10-04 layout: change on /3V3 (ledger 0322)
    [cubevox.kicad_pcb]
2026-10-04 layout: change on /5VA (ledger 0324)
    [cubevox.kicad_pcb]
2026-10-04 layout: change on /3V3A (ledger 0326)
    [cubevox.kicad_pcb]
2026-10-04 fix(layout): pot 3V3A as a pad-to-pad chain; 5VA drop joins its trunk
2026-10-04 layout: change on /5V (ledger 0327)
    [cubevox.kicad_pcb]
2026-10-04 fix(layout): chain toggle pull-ups pad to pad on 3V3
2026-10-04 layout: change on /3V3 (ledger 0328)
    [cubevox.kicad_pcb]
2026-10-04 chore(layout): snapshot owner 3V3 hand routing before fixes
    Owner routed 3V3 pad to pad in KiCad and started the B.Cu trunk.
    Declaration D0281 records it; accept was refused on micro segments,
    an overlap and undeclared via/DRC drops, fixed in the next change.
    [cubevox.kicad_pcb]
2026-10-04 layout: change on /3V3 (ledger 0332)
    [cubevox.kicad_pcb]
2026-10-04 layout: change on /3V3 (ledger 0335)
    [cubevox.kicad_pcb]
2026-10-04 layout: change on /3V3 (ledger 0339)
    [cubevox.kicad_pcb]
2026-10-04 chore(layout): snapshot owner 3V3 routing before dangling via removal
    [cubevox.kicad_pcb]
2026-10-04 layout: change on /3V3 (ledger 0341)
    [cubevox.kicad_pcb]
2026-10-04 chore(layout): snapshot owner 3V3 routing session 2
    [cubevox.kicad_pcb]
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2026-10-04 layout: change on /3V3,/GND,/h7core_block/ADC_VREF,/h7core_block/LDOO,/h7core_block/SWDIO,/h7core_block/USB_DM,/h7core_block/USB_DP (ledger 0347)
    [cubevox.kicad_pcb]
2026-10-04 feat(sch): 3V3 decoupler cleanup (C1/C5/C31/C59 deleted, C57/C61 100n, Cx DVDD)
    Owner-approved plan layout/3v3_decoupler_plan.md: one 100 nF per VDD pin at pins 50/75, C31/C59 dropped as redundant bulk, new C165 100 nF on PCM5102A DVDD (pin 20).
    [h7core_block.kicad_sch]
2026-10-04 layout: change on /3V3,/GND (ledger 0348)
    [cubevox.kicad_pcb]
2026-10-04 layout: move C12->107.15,79.00, C61->105.10,77.52 (ledger 0349)
    [cubevox.kicad_pcb]
2026-10-04 layout: move C46->129.22,99.19 (ledger 0350)
    [cubevox.kicad_pcb]
2026-10-04 layout: move C33->136.43,104.13 (ledger 0351)
    [cubevox.kicad_pcb]
2026-10-04 layout: move C15->92.75,100.75, C16->99.00,101.00, C2->85.60,90.78, C3->106.40,90.28, C56->86.90,90.48, C58->105.10,89.98, C7->95.00,94.50, Y1->96.20,98.70 (ledger 0352)
    [cubevox.kicad_pcb]
2026-10-04 layout: change on /3V3,/GND (ledger 0353)
    [cubevox.kicad_pcb]
2026-10-04 layout: change on /GND,/h7core_block/I2S_LRCLK (ledger 0354)
    [cubevox.kicad_pcb]
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2026-10-04 layout: change on /3V3,/h7core_block/USB_DM,/h7core_block/USB_DP (ledger 0362)
    [cubevox.kicad_pcb]
2026-10-04 feat(sch): add SP809 3V3 supervisor gating TLV75533 EN
    U107 SP809EK-L-2-9 (push-pull active-low, 2.9 V, 140 ms min) drives TLV75533 EN on new net LDO_EN, replacing the 5V tie, so 3V3A comes up only after 3V3 is valid. C166 100 nF at its VCC. No pull-up: the output is push-pull.
    [h7core_block.kicad_sch]
2026-10-04 layout: move C24->155.00,52.08 (ledger 0366)
    [cubevox.kicad_pcb]
2026-10-04 chore(layout): record SP809 supervisor placement (D0307)
    Push-pull output, 140/230 ms delay, TLV755P 120 ohm output discharge, 10 k pot injection 1.3 mA max.
2026-10-04 layout: change on /3V3 (ledger 0367)
    [cubevox.kicad_pcb]
2026-10-05 layout: change on /3V3 (ledger 0370)
    [cubevox.kicad_pcb]
2026-10-05 chore(layout): snapshot owner routing (VA_SENSE, 5V, DAC chain, ADC_VIN, LDO_EN)
    [cubevox.kicad_pcb]
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2026-10-05 layout: move C101->72.40,107.93, C111->72.40,103.37, C130->77.60,85.30, C135->69.75,94.00, C139->65.75,102.70, C141->79.60,79.00, C160->67.50,83.40, C161->63.25,106.95, C165->83.54,103.37, C33->86.25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
    [cubevox.kicad_pcb]
2026-10-05 docs(layout): record output chain placement stage 1 (D0313)
    Stage 1 of the output chain re-placement accepted; register and run log row.
2026-10-05 layout: change on /3V3,/3V3A,/5VA,/GND,/VREF,/VREF_BUF,/VREF_DIV,/h7core_block/CAPM,/h7core_block/CAPP,/h7core_block/LDOO,/h7core_block/VNEG (ledger 0377)
    [cubevox.kicad_pcb]
2026-10-05 docs(layout): record output chain local ties stage 2 (D0315)
    Stage 2 of the output chain re-placement accepted; register and run log row.
2026-10-05 layout: change on /BUF_IN,/BUF_OUT,/BUF_R,/DAC_AC,/DAC_ATT,/DAC_LP,/DAC_OUTL,/GND,/MUTE_N,/OUT_AC (ledger 0380)
    [cubevox.kicad_pcb]
2026-10-05 docs(layout): record output chain analog routing stage 3 (D0317)
    Stage 3 of the output chain re-placement accepted; register and run log row.
2026-10-05 layout: change on /MUTE_N (ledger 0382)
    [cubevox.kicad_pcb]
2026-10-05 feat(sch): split VREF buffer east, local 5VA_W/BIAS_W for output stage
    The VREF follower moves to a new single op-amp U108 (OPA197IDBVR, C221351) with its own 100 nF (C167), so VREF no longer leaves the east side. U106 stays at the west output stage: its A half becomes a tied-off follower (pins 1-2 on U106A_OUT, pin 3 on BIAS_W). The output stage gets a local supply 5VA_W (FB102 from 5V, C168 10 uF, C130 kept at pin 8) and a local bias BIAS_W (R154/R155 10 k divider, C169 10 uF); R123 biases DAC_ATT to BIAS_W. ERC: no new violations.
    [cubevox.kicad_sch]
2026-10-05 layout: move C135->166.50,94.50, C160->157.50,97.00, R117->162.00,94.00, R118->164.00,94.00, R146->156.50,93.00 (ledger 0386)
    [cubevox.kicad_pcb]
2026-10-05 docs(layout): record output stage supply/bias placement stage 4a (D0320)
    Stage 4a accepted; register and run log row.
2026-10-05 layout: change on /3V3,/3V3A,/5V,/5VA,/VREF (ledger 0389)
    [cubevox.kicad_pcb]
2026-10-05 docs(layout): record output stage rails stage 4b (D0321)
    Stage 4b accepted; register and run log row.
2026-10-05 layout: change on /3V3 (ledger 0391)
    [cubevox.kicad_pcb]
2026-10-05 docs(layout): record 3V3 cap-first feed at C165 stage 4c (D0322)
    Stage 4c accepted; register and run log row.
2026-10-05 feat(sch): add 33R series resistors on I2S at U1
    R156 (LRCLK) and R157 (DATA), 33R 0402 (LCSC C25105), sit at the U1 escapes like R29 on BCLK, so each I2S line leaves the MCU through a source resistor. U1 sides become I2S_LRCLK_SRC and I2S_DATA_SRC. ERC: no new violations.
    [h7core_block.kicad_sch]
2026-10-05 layout: change on /GND,/h7core_block/ADC_DOUT,/h7core_block/I2S_BCLK,/h7core_block/I2S_BCLK_SRC,/h7core_block/I2S_DATA,/h7core_block/I2S_DATA_SRC,/h7core_block/I2S_LRCLK,/h7core_block/I2S_LRCLK_SRC,R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
    [cubevox.kicad_pcb]
2026-10-05 docs(layout): record I2S branch to the moved DAC stage 5 (D0324)
    Stage 5 accepted; register and run log row.
2026-10-05 layout: change on /BUF_OUT,/MUTE_COIL,/SW_BYPASS (ledger 0396)
    [cubevox.kicad_pcb]
2026-10-05 docs(layout): record output chain leftovers stage 6 (D0325)
    Stage 6 accepted; register and run log row with the open long runs.
2026-10-06 chore(layout): snapshot owner routing (mic stage, outputs, I2C, encoders, VBUS_SENSE, USB_DM, C6)
    [cubevox.kicad_pcb]
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2026-10-06 layout: move C12->108.75,79.00, C128->211.55,83.50, C129->198.45,85.00, C132->231.07,78.50, C6->106.40,77.22, R102->211.50,79.30, R106->198.50,77.60, R108->211.50,81.40, R109->198.50,87.00, R110->198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
    [cubevox.kicad_pcb]
2026-10-06 docs(layout): record owner audit repair (D0327, D0329)
    Owner routing recorded as D0327, then repaired under D0329 (ledger 0402).
2026-10-06 layout: move C12->109.00,79.00 (ledger 0405)
    [cubevox.kicad_pcb]
2026-10-06 layout: change on /GND,/h7core_block/CC2 (ledger 0411)
    [cubevox.kicad_pcb]
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2026-10-06 chore(layout): record ledgers 0275-0412 and closures D0227-D0332; panel STEP and layout PDF
    Ledger and closure JSON are the audit trail for the output-chain move, 3V3 rail, supervisor and via cleanup. Ignore KiCad temp state and pycache.
    [cubevox-panel-parts.step]
2026-10-06 layout: change on /5V (ledger 0413)
    [cubevox.kicad_pcb]
2026-10-06 layout: finish /5V feed to the input filter, drop the orphan via (D0333)
    The 5V trunk ended in a 9 mm B.Cu stub and a via at (105.55,47.65) that reached nothing. L101.2, C114.1, C115.1 and C19.1 now carry a 0.5 mm F.Cu bus; C19.1 runs straight down to a new via at the trunk corner (106.53,56.8). Via count unchanged, orphan vias 0, allowlist emptied.
2026-10-06 layout: change on /5V (ledger 0414)
    [cubevox.kicad_pcb]
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2026-10-06 layout: move C136->117.75,97.45, C137->117.75,104.00 (ledger 0416)
    [cubevox.kicad_pcb]
2026-10-06 docs(layout): record mic and output chain routing (D0336)
    Five nets routed; PRE_OUT bundle crossing at y 104.05 recorded for later nets.
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2026-10-06 layout: change on /h7core_block/VBUS (ledger 0418)
    [cubevox.kicad_pcb]
2026-10-06 layout: move R16->112.83,92.00 (ledger 0420)
    [cubevox.kicad_pcb]
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2026-10-06 layout: change on /FX_ON_SENSE,/GND,/h7core_block/BOOT0,/h7core_block/NRST (ledger 0422)
    [cubevox.kicad_pcb]
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2026-10-06 layout: move C142->150.06,136.50, C55->113.50,97.00, R126->150.81,133.50, R30->114.33,94.40 (ledger 0425)
    [cubevox.kicad_pcb]
2026-10-06 docs(layout): record mux group routing (D0342)
    Closure D0341, its amendment D0342, ledger 0424 and the RUNLOG row for group 3.
2026-10-06 chore(layout): record ledger 0426
    Ledger written by the group 3 RUNLOG step.
2026-10-06 layout: move C149->86.70,129.60 (ledger 0428)
    [cubevox.kicad_pcb]
2026-10-06 docs(layout): record encoder group routing (D0344)
    Closure D0343, its amendment D0344, ledgers 0427 and 0429 and the RUNLOG row for group 4.
2026-10-06 layout: change on C121,C125,C139,C141,C160,C161,C165,C166,C168,C169,ENC101,ENC102,ENC103,J1,J101,J106,J108,J117,J3,K101,R123,R126,R147,R154,R155,R156,R157,R27,R29,RV101,RV102,RV103,RV104,RV105,RV106,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
    [cubevox.kicad_pcb]
2026-10-06 fix(footprints): move silk that crosses pads or the edge to Fab
    EC11E silk crossed its own EH mounting pads; USB-C, NCJ6FA-H and PJ-002A side segments ran past the board edge. The board instances already carry the change, so library and board match (0 lib_footprint_mismatch).
2026-10-06 docs(layout): record silk pass (D0345)
    Closure D0345, ledger 0431 and the RUNLOG row for the silk pass.
2026-10-06 layout: change on /GND (ledger 0432)
    [cubevox.kicad_pcb]
2026-10-06 layout: change on /3V3,/GND,/POT_MUX_OUT,/h7core_block/I2S_DATA_SRC (ledger 0435)
    [cubevox.kicad_pcb]
2026-10-06 layout: change on /GND (ledger 0436)
    [cubevox.kicad_pcb]
2026-10-06 layout: change on /3V3,/GND,/I2C_SCL,/I2C_SDA,J117 (ledger 0441)
    [cubevox.kicad_pcb]
2026-10-06 feat(hardware): J117 OLED header becomes hanxia 5 mm SMD socket C42379197 (D0352)
    JLC's hand-inserted through-hole headers came out crooked on the previous board. An SMD socket is machine-placed and self-centres in reflow. Library footprint, schematic LCSC fields, spec item 22 and PARTS.md follow the board.
    [cubevox.kicad_sch]
2026-10-06 layout: move C117->157.60,65.60, C166->160.45,49.43, C167->163.85,88.55, C24->155.00,49.08, C25->148.00,48.67, FB101->157.60,61.00, R142->137.06,50.00, R143->139.59,50.00, U107->157.75,48.49, U108->1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
    [cubevox.kicad_pcb]
2026-10-06 docs(layout): correct the D0355 misfire note; the chain, not the foreman, skipped the declare
2026-10-06 docs(hardware): Codex round 5 pre-fab audit, HOLD with 3 FAIL
    J117 CPL origin 14.75 mm off the socket pads, 34 pot/toggle nets unrouted, raw BOM/CPL not JLC-mapped. Eight WARN items recorded in RUNLOG.
2026-10-07 layout: move J117->135.78,57.75 (ledger 0447)
    [cubevox.kicad_pcb]
2026-10-07 layout: change on /GND (ledger 0448)
    [cubevox.kicad_pcb]
2026-10-07 layout: change on C162,C163,C18,R102,R105,R108,R110,R116,R150,R151,R152,R6,R7 (ledger 0450)
    [cubevox.kicad_pcb]
2026-10-07 fix(hardware): Codex round 5 fixes, library footprints, PINMAP and firmware notes
    OLED footprint anchored on the socket pads, L101 marked SMD, USER_LED corrected to PE11, mux power-up and ADC sample-time notes for firmware. Board changes landed under D0356-D0358.
2026-10-07 layout: change on J101,J106,J108 (ledger 0451)
    [cubevox.kicad_pcb]
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2026-10-07 chore(hardware): audit export snapshot (netlist, BOM, CPL, DRC)
    Inputs the round 5 and round 6 audits read.
    [cubevox-bom.csv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]
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2026-10-07 feat(face): reverb TIME replaces DWELL, slapback 60..250 ms, v2.00.00
    Adam (2026-10-07): DWELL stops being useful past 50 % and a time control
    would serve better; he never slaps under 70 ms. INTENSITY now sets mix
    only and TIME sets every engine's decay through the existing curves, so
    TIME 50 % is yesterday's INTENSITY 50 % decay. DWELL stays as a tuning
    field. Slapback TIME runs 60..250 ms (default 100) in both views.
    The level row for slapback was a coin flip on TIME: the test tone cancels
    its own echo at 70 ms and adds at 100 ms. The row now averages over the
    TIME range and a whole-output trimDb (x INTENSITY), as Unison does, lands
    the mean at +0.25 dB.
    [main.cpp, reverb.h, slapback.h]
2026-10-07 feat(emulator): live mic input from the macOS chosen input
    Adam (2026-10-07) wants to sing through the prototype. The transport row
    gains a MIC toggle. On, the loop group's three slots become the capture
    device name and a gain (-12..+24 dB). The device is duplex on whatever
    macOS has chosen for input and output and follows a change while running,
    so an audio interface needs no in-app picker. No mic or no permission
    falls back to playback only with MIC greyed. Info.plist carries the mic
    usage string. Copy button label shortened so the row still fits 1440 px.
    [main.cpp]
2026-10-07 fix(emulator): name the capture rate in the MIC row, log devices at start
    A Bluetooth headset mic runs at 16 kHz and adds 100 ms or more of lag;
    the row now shows the rate so the cause is visible, and startup logs
    both devices with their rates and periods.
    [main.cpp]
2026-10-07 fix(emulator): 64-frame duplex period
    Owner measured 15..25 ms round trip on the built-in mic and speakers at
    128 frames. Duplex costs about four periods, so 64 halves the app's share.
    [main.cpp]
2026-10-07 feat(face): relabel INTENSITY to MIX; docs for 8 slots, MUTE, pots for KEY/SEMITONES
    Adam 2026-10-07: eight slots of two identical pots and a toggle, effect
    and chain order set by firmware. Top-left toggle becomes a global MUTE
    on K102; bypass relay K101 and its dry path go. KEY and SEMITONES move
    from encoders to mux inputs I14/I15, filling the 16:1 mux. Input Gain
    stays analog. DFU is entered from the menu. Slots spec records the
    interview; hardware spec, PINMAP, PARTS and face spec updated to match.
    v2.00.05.
2026-10-07 feat(emulator): BYPASS button becomes MUTE, v2.00.06
    Adam 2026-10-07: the box's top-left toggle is a global mute, so the
    emulator matches. Output is silenced while the chain keeps running;
    the stage-feedback loop hears the silence a muted box would send.
2026-10-07 feat(sch): slots revision, KEY/SEMITONES pots, bypass relay out, MUTE_SW
    ENC102/ENC103 and their debounce RC (R130-R133, C146-C149) become pots
    RV115/RV116 on U101 I14/I15 (POT15/POT16). K101, D104 and the PRE_OUT dry
    path leave, DAC_ATT joins BUF_IN. SWBYPASS1 now drives MUTE_SW (the former
    FX_ON_SENSE); PB7, PB8, PB9, PE0 are no-connect. ERC: 0 errors.
    [cubevox.kicad_sch, h7core_block.kicad_sch]
2026-10-07 feat(firmware): first H7 tree, slots, mux controls, mute, menu, SAI audio
    Arduino STM32 GenH7 core as Teensy-H7-Port's fxbox sketch; engine/ shared
    with the emulator. Slot table in chain order, 16-pot mux scan with KEY and
    SEMITONES stepped with hysteresis, MUTE_SW to XSMT then MUTE_N, menu with
    DFU entry, SAI1 master TX to PCM5102 and slave RX from PCM1808. OLED is a
    Serial stub, settings are RAM only. Compiles with firmware/build.sh; not yet
    run on hardware. Spec item 21: TOGGLE n = slot n.
2026-10-07 layout: change on /3V3,/5V,/BUF_IN,/DAC_ATT,/ENC_KEY_A,/ENC_KEY_B,/ENC_SEMI_A,/ENC_SEMI_B,/FX_ON_SENSE,/GND,/PRE_OUT,/SW_BYPASS,C146,C147,C148,C149,D104,ENC102,ENC103,K101,R130,R131,R132,R133,SWBYPAS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
    [cubevox.kicad_pcb]
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2026-10-07 feat(firmware): SH1106 OLED driver on U8x8, menu lines fit 16 columns
    U8x8 on I2C2 (PB10 SCL, PB11 SDA) behind the Display interface, probed at
    0x3C with the serial stub as fallback. U8x8 tiles are 8 px, so the panel
    is 16 columns at the 8x8 font; menu labels shortened to fit.
    [cubevox.ino, display_sh1106.cpp, display_sh1106.h, menu.cpp, menu.h]
2026-10-07 layout: change on /3V3A,/BUF_IN,/MUTE_SW,/POT15,/POT16 (ledger 0454)
    [cubevox.kicad_pcb]
2026-10-07 layout: change on (ledger 0456)
    [cubevox.kicad_pcb]
2026-10-07 layout: records for the slots airline routing (D0361-D0363)
    Run log row, register entries, ledger 0455, closures and the three action
    lists. D0362 was accepted with no commit because git add raced a concurrent
    commit; its board change shipped in 1bbcbc4 with D0363.
2026-10-07 docs(audit): astra independent schematic and PCB audit, 0 blocking, 7 should-fix, 1 nit
    Codex gpt-6-astra read-only audit after the slots routing. No electrical or
    layout defect found; the should-fix items are documentation drift in
    PARTS.md, PINMAP.md and the library OLED symbol metadata.
2026-10-07 docs(hardware): fix audit F1-F8, parts list and pin map match the schematic
    The audit found the parts list, pin map, spec and OLED library entry out of step with the schematic.
2026-10-07 layout: refill zones after slots routing, RV115/RV116 library ids
    The committed board carried inner-layer fills saved before the five
    routing vias, so DRC without a refill showed 20 clearance errors. Refilled
    in place; footprint ids get the cubevox: prefix for schematic parity;
    netlist export regenerated; audit file records the resolution.
    [cubevox.kicad_pcb]
2026-10-07 layout: remove 42 return vias beside non-critical nets, 275 -> 233 vias
    Canon 17 scopes the adjacent ground via to critical-net layer changes;
    these sat beside 5V, 5VA, 3V3, 3V3A, VREF, VIN_9V, VBUS, BOOT0, NRST,
    SWDIO, MUTE_N, MUTE_SW, MUX_S0/S2, POT_MUX_OUT, XSMT, VA_SENSE, ENC_MENU
    and INA_O2 vias and carried no return. Kept 9 beside the SAI family and
    PRE_OUT and 4 that are the only plane stitch within 8 mm. DRC 0 beyond
    the 9 lib mismatches, 34 unconnected, strict via audit 0 orphans.
    [cubevox.kicad_pcb]
2026-10-07 layout: outline 185x145, holes, fiducials, J106, buttons, RV115/RV116 (ledger 0458)
    Owner 2026-10-07 trims the board from 200x150 to 185x145. Front hole pair sits on the front edge between pots 1-2 and 7-8 (a corner seat lands in the corner pot courtyard). H101/H102 sit at x 59.6/237.4 to stay clear of the J108 hand-solder reservation. Buttons 61.0, boot button y 96.2 to clear C139. Stale routing is re-landed in the next commit.
    [cubevox.kicad_pcb]
2026-10-07 layout: re-land nets after the outline trim (ledger 0459)
    NRST, BOOT0, 3V3, GND, 9V_JACK, G2_RG, POT15/16 and 3V3A re-landed on the moved parts. Docs: spec items 14, 26, 27 carry the 185x145 outline and the new hole poses; brief hole poses and board size updated; RUNLOG row.
    [cubevox.kicad_pcb]
2026-10-07 layout: H101/H102 back to 61/236, J108 east 1.5 mm (ledger 0461)
    Owner 2026-10-07: holes stay 5 mm from the rear and side edges per spec item 26. J108 moves to x 74.0 so its hand-solder box clears H101's seat. E0058 and E0048 are re-added at the new poses in the next commit.
    [cubevox.kicad_pcb]
2026-10-07 layout: POT15 south run to y 173.8, OUT_TIP re-landed, docs and brief for H101/H102/J108 (ledger 0464)
    H103's seat reaches y 173.5, so the POT15 run sits at 173.8. Spec item 26 and the brief carry H101 (61,35), H102 (236,35), J108 x 74.0; RUNLOG row.
    [cubevox.kicad_pcb]
2026-10-07 layout: J106 west to 225 so the H102 boss clears its lug (ledger 0467)
    J106's hand-solder box is re-added unclipped (E0144); the 9V_JACK copper is extended to the new pads with no new vias. Brief J106 pose and RUNLOG updated.
    [cubevox.kicad_pcb]
2026-10-07 layout: m3seats 9 mm for heat-set bosses, J108 east 2 mm, POT15 down the west margin (ledger 0470)
    Seats grow from 7 to 9 mm for the 4.5-5 mm heat-set bosses. J108 to x 76.0 clears H101's boss. POT15 hops under POT16 at y 147.5 and runs the west margin so no copper sits within 4.5 mm of H103. Reservation E0146 follows J108; spec item 26 and the brief carry the 9 mm seat.
    [cubevox.kicad_pcb]
2026-10-07 layout: owner cleanup in KiCad, U6 pin 1/8 stitch out, odd-angle tracks, fiducial silk
    Owner-edited 2026-10-07 after reviewing the trimmed board: removed the
    unnecessary underside stitch between U6 pins 1 and 8, straightened
    tracks at odd angles, removed fiducial silkscreen. kicad-cli DRC on the
    saved file: 9 lib mismatches only, 34 unconnected (POT01-14, TOGGLE1-8,
    still unrouted).
    [cubevox.kicad_pcb]
2026-10-08 layout: hygiene joins, micro-segments, pad entry (ledger 0472)
    Mid-track joins now end on a node and the host segment is split; four micro-segments, 17 diagonal pad entries and five off-angle segments are gone so route_audit, pad_entry_check and the angle check read clean. TOGGLE1/2 clusters rebuilt with straight pad entry. Plan: hardware/layout/actions/hygiene-joins-pad-entry.json, declaration D0377.
    [cubevox.kicad_pcb]
2026-10-08 layout: POT01-16 panel bus, TOGGLE3-8 switch clusters (ledger 0474)
    POT15/16 diagonals replaced by the 16-lane band under U101. 3V3A re-fed and one C142 GND via moved to clear it. TOGGLE trunks to U1 stay unrouted: the corridor cannot take them within the via and jog rules.
    [cubevox.kicad_pcb]
2026-10-08 feat(sch): move TOGGLE1-8 to U1 east rows, MUX_S to PE8-PE12
    U1's east edge interleaved the toggles with MUX_S, VA_SENSE and XSMT, so the toggles had no exit south (commit 2d5c7bc left TOGGLE1-8 unrouted). Pins 28-34, 36, 37 now carry XSMT and the eight toggles in lane order, the MUX selects take PE8-PE12, USER_LED moves to PB7. Firmware pin table and PINMAP follow. Design: hardware/layout/TOGGLE_BUS_BRIEF.md section 2.
    [h7core_block.kicad_sch]
2026-10-08 layout: TOGGLE bus east re-lay, TOGGLE1-8 routed (ledger 0479)
    The pin swap in 965d4b9 frees U1's east rows, so XSMT and the eight toggles leave on F.Cu lanes and cross the SAI/ADC band to a B.Cu trunk that drops into each switch. MUX_S, VA_SENSE, USER_LED, 3V3 and 3V3A re-laid around it; R30, C55, C58, C3, R16, R3, D1, C163, C138 moved. Unconnected 8 -> 0, vias 249 -> 264. Built to hardware/layout/TOGGLE_BUS_BRIEF.md, amended to the as-built geometry (lead-approved corrections to the step, the TOGGLE2 jog and C138). Declaration D0381.
    [cubevox.kicad_pcb]
2026-10-08 layout: chamfer right angles, 3V3 bar to y 107.65, 3V3A hop re-laid
    Canon 44 and 136 fixes on the owner's saved board. The right_angles finding declared in 255a3d5 was a gate failure. Every corner on the TOGGLE bus (switch drops, MUX lanes, VA_SENSE, PRE_OUT) and the plain pre-existing ones are now two 45 degree bends; the step diagonals are split so no 45 run exceeds 6 mm. 3V3 bar moved 0.1 down as one run so C138 keeps 0.2 to it; 3V3A enters both hop vias straight with no dogleg. corner_check.py: 57 corner points to 15; the 15 left are off-pad T junctions and pad-offset loops that need a part or branch moved (listed in RUNLOG). Declarations D0383, D0385.
    Owner edits kept: C138 moved to y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
    [cubevox.kicad_pcb]
2026-10-08 layout: re-lay pre-existing corners at R128, 5VA, 5V, DAC_OUTL, CAPP
    Canon 44: a branch leaves from a pad or via, never mid-trace, and loops around offset pads are re-placed instead. R128 turned vertical so the 3V3 branch leaves its pad; the 5VA feed ends in the east via; C114/C115 re-placed so the 5V chain is one straight; DAC_OUTL takes one 45; C111 moved north so CAPP runs straight. corner_check.py 15 -> 7 points. The 7 left (J1 GND E0120, 3V3 bar/U8 T, USB_DM T, CAPM loop) need a via, a connector or a cap footprint change; RUNLOG lists why. Declaration D0387.
    [cubevox.kicad_pcb]
2026-10-08 feat(sch): re-map U101 west channels to the pot row order
    The west POT rows' order down the band is fixed by their drops, and the vias' x order by U101's pin order; the two disagreed, so verticals stepped across each other's rows. POT09-15 now sit on I8-I14 so that pin order equals row order. Firmware slots.cpp follows, so every knob still reads the same parameter; PINMAP carries the channel table.
    [cubevox.kicad_sch]
2026-10-08 layout: west POT verticals land on one via diagonal
    With U101's west channels re-mapped (f192461), pin order equals the rows' order down the band, so each POT09-16 vertical drops from its fixed pin via to a row-end via on one diagonal (145.6,153.1)-(150.36,158.0) and no vertical passes another net's via. Rows, drops and risers unchanged; vias 264. Declaration D0389.
    [cubevox.kicad_pcb]
2026-10-08 layout: CAPM single offset via C35 shift, U8 3V3 T registered
    C35 moves 0.13 mm south so CAPM runs from U6.4 to C34.2 with one 45 offset instead of a loop; VNEG and C35's GND via follow, C101 and R147 stay. The U8 feed T on the 3V3 bar has no pad that can take both arms without crossing the TOGGLE trunk or the ADC lines, so it is recorded as register exception E0147. The USB_DM via-pair link is held: it raises canon gates 17/20/134/137/56. Declaration D0391.
    [cubevox.kicad_pcb]
2026-10-08 chore(exports): enclosure STEP from board 0843d53
    Board body, pots, toggles, buttons, encoder, OLED, XLR, output jack, DC and USB-C
    placed from the final toggle-bus layout. Origin at the board top-left corner (56,30).
    [cubevox-enclosure.step]
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2026-10-08 docs(enclosure): fastener-free closure spec, box coupon, section drawing
    Owner 2026-10-07/08: dish and lid close with straight PETG bead-and-groove
    runs on all four walls plus a double-bead TPU-GF boot; no screws, inserts,
    cantilever hooks or jack-nut clamping. Hardware spec item 27 superseded,
    H101-H104 stay as rest bosses. Coupon is a shelled 80x60 box with one dish
    and three lids (h 0.5/0.7/0.9) for the owner's pull test.
    [closure-coupon-dish.stl, closure-coupon-lid-05.stl, closure-coupon-lid-07.stl, closure-coupon-lid-09.stl]
2026-10-08 layout: owner re-lay of TOGGLE1/2 and 3V3 vias, zones refilled
    Hand edit in KiCad; gates.sh ALL PASS after refill.
    [cubevox.kicad_pcb]
2026-10-08 docs(spec): Mac app, slot layout and firmware update design
    Interview 2026-10-08. CLAUDE.md panel, slots spec and hardware spec updated to match.
2026-10-08 layout: owner cleanup, 9V and GND silk labels at the barrel corner
    [cubevox.kicad_pcb]
2026-10-08 layout: owner tidy, TOGGLE1 bottom-only into SW101, 3V3A hop y 111.8, RESET/BOOT silk
    [cubevox.kicad_pcb]
2026-10-08 layout: USB pair 45s under 6 mm, VBUS_SENSE lane y 71.5 at 0.8 pitch
    Canon 136 and 51. Brief in hardware/layout/USB_VBUS_BRIEF.md; gates all pass except the owner-accepted D105 silk overlap.
    [cubevox.kicad_pcb]
2026-10-08 feat(sch): pre-fab parts, log gain pot, test points, R7 68k
    SMBJ20CA for D105, R158 100k pull-up on LDO_EN, C170 10uF at U6, R7 68k, RVGAIN1 RK09D117000C (15A), TP1-TP5. Per docs/reference/PREFAB_REVIEW_2026-10-08.md.
    [cubevox.kicad_sch, h7core_block.kicad_sch]
2026-10-08 layout: pre-fab parts and test points, hole clearance 0.30, D105 silk
    Gates ALL PASS. J1 keeps its own 0.255 hole clearance in cubevox.kicad_dru.
    [cubevox.kicad_pcb]
2026-10-08 chore(fab): JLC production files for 5 boards
    [cubevox-B_Cu.gbl, cubevox-B_Mask.gbs, cubevox-B_Paste.gbp, cubevox-B_Silkscreen.gbo, cubevox-Edge_Cuts.gm1, cubevox-F_Cu.gtl, cubevox-F_Mask.gts, cubevox-F_Paste.gtp]
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2026-10-08 feat(firmware): step 0 clock tree, mux hold and VBUS-gated USB
    HSE 25 MHz now drives PLL1 (480 MHz on rev V, 360 MHz on older
    silicon) so PLL3's SAI numbers hold and USB runs from PLL1Q with
    HSI48 off; the generic variant ran everything from HSI. Mux selects
    stay low 1.1 s for U107's 3V3A delay. The CDC device starts only
    while PA9 reads VBUS and stops when it drops, with the self-powered
    descriptor set explicitly. A boot report prints silicon rev, ROM
    bootloader ID and the clock tree whenever a terminal opens the port.
    Astra reviewed the PLL and gating numbers (docs/reference).
2026-10-08 docs(specs): effect registry design for firmware step 1
    Owner interview 2026-10-08: string card ids, knob descriptor fields,
    one reverb per layout, pitch cards as one shared stage with the
    tracker costed once, flagged cost estimates until a board measures
    them, and a built-in bench signal.
2026-10-08 refactor(engine): remove Parker Spring reverb
    Owner 2026-10-08: it does not sound good and is too heavy for the H7.
    Engine, emulator macros and tuning, render tool, tests and specs drop
    SpringC; saved emulator states that picked it load as SPRING B.
    Firmware RAM falls from 71 % to 58 %. CLAUDE.md also gains the
    registry spec pointer. The three file deletions landed in c1b1949.
    [macros.h, main.cpp, reverb.h, spring.h]
2026-10-08 docs(specs): registry interview round 2, drop Harmony card and old Spring
    Harmony's second Key pot conflicted with Autotune's, so it gets no card.
    Chasm and Spring B won the reverb audition; the old Spring engine goes.
    Semitones on a pot drops to -12..+12 so each step is 12 degrees.
2026-10-08 refactor(engine): remove old Spring reverb
    Chasm and Spring B won the audition. Shared clip helpers move to
    common.h; Spring B becomes reverb engine 0 and the fallback.
    [chasm.h, common.h, macros.h, main.cpp, reverb.h, spring.h, spring_b.h]
2026-10-08 feat(firmware): effect registry with card table and knob descriptors
    Cards replace the Effect/Param enums: ten wire-stable ids, display
    names, two knob descriptors each, group, cost percent and measured
    flag. Slots keep only hardware; slotCard() returns the default layout
    until the runtime layout lands in step 2. Semitones is now -12..+12.
    [audio.cpp, controls.cpp, costs.h, menu.cpp, registry.cpp, registry.h, slots.cpp, slots.h]
2026-10-08 chore(repo): prune frozen layout state, consolidate audits, drop stale docs
    Board is frozen at a41fe4b and ordered, so the foreman routing state
    (ledger, closures, actions, register) and its routing helpers leave the
    repo; git history keeps them. Audits, consult packets and reviews now
    live in docs/audits/ with dated names. Old Spring spec, hand-over notes,
    spent Codex packet and face artwork removed. KiCad view state ignored.
    [closure-coupon-skirt-05.stl, closure-coupon-skirt-07.stl, closure-coupon-skirt-09.stl, closure-coupon-wall-05.stl, closure-coupon-wall-07.stl, closure-coupon-wall-09.stl]
2026-10-08 refactor(firmware): tier the sketch into core, board and ui; host test; pinned core
    core/ is pure C++ and compiles on the Mac in firmware_test, so an
    Arduino include there breaks ctest. ChainParams and the Display
    interface move to core; slots keeps only hardware. build.sh refuses
    any core but 3.0.0, prints the gcc line and passes the git describe
    string as CUBEVOX_FW_VERSION.
2026-10-08 feat(firmware): watchdog, fault handlers, reset cause and audio stall watch
    Foundation spec step 4. IWDG1 at 2 s kicked from loop() only. The four
    Cortex-M fault handlers mute by register write, store PC/LR/CFSR/HFSR/
    BFAR/MMFAR in .noinit and reset; the boot report decodes RCC->RSR and
    prints the record or '[boot] fault: none'. A stalled audio block counter
    latches the mute through the normal sequence. First-article checks added
    to the RUNLOG; roadmap spec points at the foundation spec.
    [cubevox.ino, fault.cpp, fault.h, mute.cpp, mute.h]
2026-10-08 feat(firmware): bench commands, flash and terminal tools, per-slot cycle stats
    First run on the WeAct H743. Serial bench commands force a fault, spin for
    the watchdog, stop the audio DMA, enter DFU, force slots off and print
    stats. Stats gain late-block, average and per-slot cycle counts; the USB
    clock line reads PLL1Q directly since the HAL helper does not cover the
    USB mux. BOARD=weact forces USB on (no VBUS divider there); OPT and
    EXTRA_FLAGS are bench knobs, release stays -O2. flash.sh flashes over DFU
    and reads the boot report; term.py is a pyserial-free terminal.
    Results are in hardware/RUNLOG.md.
2026-10-08 docs(audits): Astra review of the engine CPU bench
    Diagnosis confirmed (libm per sample, YIN burst every fourth block).
    Fix order adopted; budget rule to drop from 85 % to 75 % summed average
    plus a worst-block check.
2026-10-08 feat(firmware): vocal clip in flash for the bench
    BOARD=weact bakes samples/adam_vox_sample2_4s.wav (mono, 421 KB) into the
    image; bench command 'v' loops it in place of the SAI input. samples/ is
    ignored: the repo is public. Voice numbers in hardware/RUNLOG.md: the
    default layout averages 105 % of the block budget with real overruns.
2026-10-08 test(engine): A/B guard against a reference commit
    tools/engine_ab.sh builds cubevox-render from a reference commit in a
    worktree, renders a clip through each stage alone and the full chain
    with both builds, and engine_ab_compare.py reports peak difference and
    residual level per case against a tolerance (default bit-exact). Gate
    for the engine CPU pass.
2026-10-08 docs(specs): pitch stage CPU pass design
    Tracker analysis gated by consumer with warm input buffers, stage idles
    for free, spinning Hann window, polynomial exp2 for Autotune, block-rate
    gains. Hard-tune gate stays at 4 cents. Steps with tolerances and the
    bench numbers that gate each one.
2026-10-08 refactor(engine): four-accumulator YIN loops and a tracker test
    coarse() and refine() summed through one accumulator at about 8 cycles
    per multiply-add on the M7. sumSqDiff unrolls by four with independent
    accumulators; frameRms the same. New pitch_test checks every voiced hop
    of a 5 Hz +-30 cent vibrato against the analytic pitch at the centre of
    the tracker's comparison (1.34 cents worst, identical on the old loop),
    steady 220 Hz within 0.5 cent, silence unvoiced, no allocation.
    WeAct, voice clip, all cards on: avg 671090 -> 597865, worst 1104548 ->
    817633, Autotune slot 273005 -> 201671. A/B vs e68171c: 7 cases exact,
    autotune -77.6 dB, octave -75.7 dB, chain -71.4 dB.
    [pitch.h]
2026-10-08 refactor(engine): pitch stage idles for free, tracker runs only for a consumer
    The tracker's rings and decimation low-pass fill every block so the frame
    stays warm; analysis runs at the hop only while Autotune, Harmony or
    Octave A/B is on, and once as a consumer comes on so enable is instant.
    Octave C shifts without a pitch. A card coming on resets its voice. The
    three per-engine low-passed rings fill only while their engine is
    selected. With every stage settled off the block copies through and
    writes the rings only. smooth::kSmoothCoef replaces the per-sample expf
    in the harmony, octave and grain shifter ticks.
    WeAct, voice clip: Autotune slot all-off 182844 -> 5452, chain all-off
    365147 -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
    [harmony.h, octave.h, pitch.h, pitch_fx.h, shifters.h, smooth.h]
2026-10-08 refactor(engine): pitch stage crossfade gains at block rate
    The mix and active smoothers still step once per sample so their path
    and snap points are unchanged; the equal-power sin and cos are evaluated
    at the block edges and interpolated between, exact once settled. Four
    libm calls per sample become four per block.
    WeAct, voice clip, all on: Autotune slot 202417 -> 180516, chain avg
    600261 -> 547176, worst 813551 -> 789829. A/B vs 1c29645: 10 cases
    bit-exact. ctest 16/16.
    [pitch_fx.h]
2026-10-08 refactor(engine): spinning Hann window, fast exp2 and cached glide ratios
    engine/fastmath.h: exp2Fast (degree-6 polynomial on the fraction, integer
    part into the exponent, 3.8e-7 relative over -12..12) and HannRotor (one
    complex multiply per sample, re-initialised per grain or per block; 3.1e-6
    over a 1372-sample grain). PsolaVoice and GrainShifter window grains with
    the rotor; Autotune's per-sample exp2f becomes exp2Fast so the 1 ms
    response smoother stays exact; Octave, Harmony and GrainShifter recompute
    their glide ratio only while the glide moves. Ring wraps compare instead
    of modulo, bounded so GCC 14 can prove the index. fastmath_test pins the
    error bounds.
    WeAct, voice clip, all on: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
    [autotune.h, fastmath.h, harmony.h, octave.h, psola.h, shifters.h]
2026-10-08 feat(firmware): per-slot worst block in the bench stats
    The chain's worst block hides which slot burst; the pitch tracker's hop
    block was being read 90k too low from the chain figures. AudioStats gains
    slotWorst[], printed as '[audio] slot worst', reset with the peaks.
    [audio.cpp, audio.h, cubevox.ino]
2026-10-08 refactor(engine): tracker reads its rings in place, coarse lags in pairs
    Both tracker rings are written twice, at pos and pos + len, so the newest
    span is contiguous in the upper copy and the analysis reads it there; the
    copy step is gone. The coarse YIN pass computes two adjacent lags per
    pass so the loads are shared, since the M7 pairs one load with one float
    op at best. Bit-exact: the coarse pass only picks the centre lag for the
    fine pass, which is unchanged.
    WeAct, voice clip, all on: pitch slot worst block 320k -> 288k, avg
    147k -> 139k; chain avg 515k, worst 727k. A/B vs d971cc2: 10 cases
    bit-exact. ctest 17/17. Astra packet and response on the PSOLA cost
    saved under docs/audits.
2026-10-08 docs(specs): CPU pass 2 design for Unison, Distortion, FFT coarse pitch and budget rule
2026-10-08 refactor(engine): Unison integer-phase LFO, block-edge trim, parked tap, idle path
    CPU pass 2 step U1. The LFO and the shifter sawtooth run on 32-bit turn
    counters with a polynomial sine (sinTurns, 1.6e-7 abs error); the trim is
    evaluated at the block edges and interpolated; a parked shifter reads one
    tap; depth 0 settled copies through and only writes the line. Analytic LFO
    test within 3.7e-5 samples over 10 s. A/B vs e06d829: unison -39.7 dB,
    chain -38.4 dB, other cases exact; the old float phase accumulator is the
    less accurate side (-31.8 dB vs a double-precision phase, new -66.4 dB).
    ctest 17/17. WeAct bench pending.
    [fastmath.h, unison.h]
2026-10-08 refactor(engine): Distortion gains and makeup at block rate, filter sets on change
    CPU pass 2 step D1. Stage gains, makeup and trim are evaluated at the block
    edges and interpolated; the treble shelf is set once per block from the
    block-start tone instead of every sample while TONE glides; tuning-only
    filter coefficients and scalars recompute only when the tuning changes.
    A/B vs 9514f5c: distortion -91.0 dB, chain -96.5 dB, other cases exact.
    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
2026-10-08 feat(firmware): pitch stage state in DTCM
    CPU pass 2 step M1. PitchFx (101,736 B) leaves the Chain struct and is
    placed in the NOLOAD .dtcm_bss section at 0x20000000 that
    h7_h743v_sections.ld already provides. audioInit() zeroes the section and
    constructs the object again in place, because a reset() after zeroing
    would leave the tracker's const anti-alias biquad at zero. Build 575,852 B,
    warning-free. Spec decision 9 corrected: the section mechanism existed.
    [audio.cpp]
2026-10-08 refactor(engine): rational tanh in the Distortion rail
    CPU pass 2 step D2. tanhFast is Eigen's odd 13/6 rational form, clamped
    so inputs at or beyond +-9 return exactly +-1; measured max error 2.6e-7,
    odd symmetry bit-exact. A/B vs feaed12: distortion -90.5 dB, chain
    -92.9 dB, other cases exact. ctest 17/17. WeAct bench pending.
    [distortion.h, fastmath.h]
2026-10-08 refactor(engine): PSOLA grains read with launch-time Catmull-Rom weights
    CPU pass 2 step P1. A grain's delay is constant, so its read fraction is
    fixed: the four weights are computed once at launch and the read index
    steps by one per sample, replacing the per-sample floor, wraps and Horner
    cubic. Grain pool 8 -> 6 (at most 5 live at ratio <= 2). A/B vs 1c57e38:
    autotune -112.3 dB, octave -117.6 dB, chain -92.6 dB, other cases exact;
    hard tune 3.76 cents. ctest 17/17. WeAct bench pending.
    [psola.h]
2026-10-08 refactor(engine): coarse YIN as sixteen block-aligned panes
    CPU pass 2 step F1. The 256-sample coarse window is sixteen panes of one
    block each; every block computes the pane whose newest needed sample has
    just arrived (2,736 MACs), and the hop combines the sixteen rows instead
    of running the 43.8k-MAC burst. Same window, same statistic, same pick at
    the same boundary; enable rebuilds the rows at the last pane boundary.
    New pitch_test oracle (direct CMND in the test) agrees on 100 % of hops
    over the vibrato tone and a voice-like signal. A/B vs e54c85a: all ten
    cases exact. Hard tune 3.76 cents. ctest 17/17. WeAct bench pending.
    [pitch.h]
2026-10-09 refactor(engine): ring-indexed oversampler histories in Distortion
    Spec decision 8 (CPU pass 2, D3). A stub build with the shifts removed
    measured them at 32k cycles per block on the H7, far over the 3k trigger.
    The ring keeps halfBand's tap order and arithmetic; the residual against
    279e3be is float contraction: distortion -90.0 dB, chain -92.8 dB, all
    other cases exact. ctest 17/17. WeAct, voice clip, all cards on:
    Distortion 64.5k -> 58.2k avg; chain avg 381.8k -> 375.4k (58.7 %),
    worst 446.2k (69.7 %), no late blocks. The remaining cost is state
    traffic through the object, not the shifts.
2026-10-09 feat(firmware): bench keys pin the knobs and run the reverb slot as Chasm
    The WeAct has no pots on its mux input, so the bench ran at whatever the
    floating ADC pin gave. 'k' pins every knob at its top position (last step
    for stepped knobs) so the cost table is taken at a defined setting; 'c'
    runs the reverb slot as Chasm so that card can be measured in the default
    layout. Both toggle and persist across terminal sessions, as 'v' does.
2026-10-09 feat(firmware): measured cost table with mean and worst-block lines
    CPU pass 2 step C1 (spec decision 13). costs.h carries two columns per
    card from the WeAct bench at d0f45b2: voice clip, knobs pinned at top,
    per-slot counters, worst as the lowest worst over repeated runs so
    interrupt time inside a block does not count. Octave is the pitch slot
    with Octave on minus off (tracker costed once, in Autotune); Chasm was
    measured in the reverb slot. A fixed term covers the output EQ and the
    sample conversion. Every card is measured. The budget becomes two sums,
    mean <= 75 % and worst <= 95 %, replacing the single 85 % line. Default
    layout: 68 % mean, 82 % worst by the table; 62.8 % / 75.0 % measur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
    [costs.h, registry.cpp, registry.h]
2026-10-09 docs(specs): CPU pass 2 bench results, F2 trial, cost table and two-line budget
    C2. The spec's where-it-stands and estimate tables carry the WeAct
    numbers before and after the pass, the progress table records the bench
    of U1..F1, D3, the F2 trial (built, 65 % pane path on the voice clip,
    reverted) and C1, and a bench-findings section explains the Unison and
    Distortion misses, the polluted worst counters and the bench keys. The
    registry and slots specs replace the 85 % line with the 75 % mean and
    95 % worst-block sums; CLAUDE.md marks the pass done.
2026-10-09 fix(engine): restore Distortion block-rate gains and tanhFast lost in D3
    CPU pass 3 step D4. d0f45b2 replaced distortion.h with a copy that predated
    pass 2's D1 and D2 and kept only the ring histories, so HEAD ran two expf,
    the makeup sqrt and divides, and tanhf every sample and re-set the treble
    shelf per sample while TONE glided. This puts 1c57e38's version back on top
    of the ring: tuning applied on change, shelf once per block, stage gains and
    makeup at the block edges, tanhFast in the rail. The -60 dB A/B could not
    see the loss because tanhFast sits within 1e-5 of tanhf.
    A/B vs c4744ef: distortion -90.0 dB, chain -92.8 dB, other cases exact.
    ctest 17/17. Spec: docs/specs/2026-10-08-cpu-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
    [distortion.h]
2026-10-09 refactor(engine): Spring B dispersers run as a pair, smoother products at block rate
    CPU pass 3 step S1. One section loop advances both halves per iteration so
    the two independent allpass chains overlap in the M7 pipeline; per-chain
    arithmetic and order are unchanged. Loop gain, input scale, dwell drive and
    compensation are evaluated at the block edges and interpolated, exact once
    settled. Both lines are read before either is written; the reads cannot
    reach the write slot (kMinDly 16).
    A/B vs 285600f: all ten cases exact. ctest 17/17. Bench pending.
2026-10-09 refactor(engine): Unison voices in one body, state in locals, block-rate depth
    CPU pass 3 step U2. Both voices are computed in one straight-line body per
    sample; phases, increments and the write position live in locals for the
    block; depth is stepped n times at the block start and swing and wet gain
    are interpolated across the block, exact once settled; a parked-shifter
    block path has no per-sample branches. The centre expression keeps both
    products in one statement so the compiler fuses the same one as before.
    A/B vs 1bad8bd: unison -121.7 dB with every differing sample inside the
    0.2 s depth ramp and exact after it; chain -93.2 dB; other cases exact.
    unison_test LFO analytic 3.67e-5 sampl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
2026-10-09 refactor(engine): Distortion block loop on local state, restricted pointers
    CPU pass 3 step D5. CV_INLINE and CV_RESTRICT macros in common.h; the
    per-sample loop runs on local copies of the poles, biquads, oversamplers
    and smoothers so stores through out cannot alias them.
    A/B vs 1bc59a4: all ten cases exact. ctest 17/17. WeAct, knobs pinned:
    Distortion 47.7k / 64.7k -> 46.3k / 62.2k. The chain is fifteen serial
    stages, so what remains is dependency latency, not reloads.
2026-10-09 refactor(engine): Unison parked path skips the read clamp, hot helpers inlined
    CPU pass 3 step U3. sinTurns folds on an integer test instead of two
    float compares (same value at the fold points). The parked block decides
    once whether base +- swing stays inside [2, kLen-3] and then reads
    unclamped. readCubic, readShifted, wrap, sinTurns and tanhFast are
    CV_INLINE so the two reads per sample can overlap.
    A/B vs 8140b55: all ten cases exact. ctest 17/17. WeAct, knobs pinned:
    Unison 49.1k / 51.0k -> 46.9k / 47.7k; chain 349.9k / 410.8k
    (54.7 % / 64.2 %), late 0. The compares and the call were not the cost;
    the serial read chain is, and the pass stops here for Unison.
    [fastmath.h, unison.h]
2026-10-09 chore(firmware): cost table from the pass 3 bench, spec closed out
    CPU pass 3 step C3. costs.h carries the 71fe7bc WeAct numbers (Unison
    8/8, Distortion 8/10, Spring 10/10; default layout sums 61 / 72 against
    75 / 95). The spec gets its end table and done-when status; CLAUDE.md
    lists it. firmware_test 0 failures, ctest 17/17.
    [costs.h]
2026-10-09 fix(firmware): reverb card picks the engine, menu item removed
    publishParams overwrote reverb.engine with the menu setting after
    controlsApply had set it from the placed card, so a Chasm card ran
    Spring B unless the menu said otherwise. The menu item was meant to go
    when each engine became its own card (update-and-slots spec item 1).
    The bench 'c' override stays and now falls back to the card's engine.
    WeAct: 'c' on, reverb slot 96.4k cycles (Chasm); 'c' off, 61.4k cycles
    (Spring B from the card). ctest 17/17; both firmware builds clean of
    new warnings.
    [cubevox.ino, menu.cpp, menu.h]
2026-10-09 fix(firmware): fault record survives reset again
    Since c34dcaa .dtcm_bss starts at 0x20000000, where the stock .noinit
    also lands, so gStored shared bytes with gPitchFx and the pitch stage's
    constructor cleared the record before faultInit() read it. A forced bus
    fault rebooted with "fault: none". The record moves to its own section
    at the top of DTCM (cubevox_noinit.ld) with a link-time overlap assert;
    the platform script stays a verbatim copy.
    WeAct: forced bus fault now reports pc, cfsr 0x8200, bfar 0xDEADBEE0
    on the next boot; watchdog and stall checks unchanged.
    [fault.cpp]
2026-10-09 feat(firmware): first-article bring-up script
    bringup.py runs the checklist items a board can answer over USB (boot
    report, clocks, SAI rate timed on the host clock, late blocks), drills
    the stall, watchdog, fault and DFU paths, flashes back a build for the
    same board, asks for the bench readings, and logs to hardware/bringup/.
    WeAct dry run: every check passes after the fault-record fix.
2026-10-09 feat(hardware): power switch SWPWR1 on the 9 V input, J101 west to x 175
    SS-12D11-G050 slide switch (C17179528) in series between the barrel jack
    and the SS34, owner-soldered on B.Cu between J101 and J106, out of the JLC
    BOM and CPL. J106 pins now carry 9V_PLUG; the switch returns 9V_JACK. The
    EasyEDA STEP has its origin at the body centre, so the model carries a
    measured offset. Owner routed the nine open connections; gates ALL PASS.
2026-10-09 chore(fab): JLC production files with the power switch
    Gerbers, drills, BOM and CPL from layout 5bbee4b. SWPWR1 is owner-soldered
    and stays out of the BOM and CPL; both keep 75 lines / 216 parts.
2026-10-10 feat(hardware): 25 mm gain pot with divider law, relay-switched 1/4" pad
    RVGAIN1 becomes the RK09D1130C2P (C361173) wired as a divider: pin 3 on
    G2_BOT through R116 470R to G2_RG, new R159 1k from G2_INV to G2_RG, so
    the gain knob adds 0 to +30 dB on top of the fixed 20 dB and never
    attenuates.
    K103 (G6K-2F-Y DC5, same part and driver set as the mute relay K102)
    shorts the 25.7 dB 1/4" pad resistors R102 and R105 when de-energised,
    so the rest state is MIC and the SM58 on an XLR-to-1/4" cable reaches
    the preamp without the pad. PAD_EN on U1 PB8 (high = PEDAL) drives Q102
    through R160/R161 with D110 across the coil. K103 pin 5 carries LINE_N
    and pin 6 IN_N so the N leg routes on one layer ne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
2026-10-10 feat(hardware): pre-fab audit fixes, pad relay K103 routed, rail test pads
    PAD_EN on PE11 (pin 41), K103/D110/Q102/R160/R161/R159 placed and routed.
    Audit (docs/audits/2026-10-09-prefab-mega-audit.md, tools/mega_audit.py):
    one 3V3 copper loop and two acute off-pad Ts cut, 18 bends at pad or via
    edges, 29 off-centre ends, 3 split runs, 8 stair-steps re-laid; 12 parts
    moved under 0.5 mm. TP6-TP11 on 3V3A, 5V, 5VA, 5VA_W, VREF_BUF, VDDA with
    symbols in both sheets (tools/tp_space.py picks the spots). gates.sh ALL
    PASS, ERC 0.
2026-10-10 fix(hardware): tidy owner-moved rail test pads TP6, TP10, TP11
    Owner repositioned TP6, TP7, TP8, TP10, TP11 and added silk net labels.
    TP10 and TP11 sat 0.013 and 0.1 mm off the x of the pad they stub from,
    leaving a sliver and a bend inside the pad that the route audit read as a
    stray and a copper loop. Both now sit on the pad x with one straight stub;
    TP6 ends at centre with 0.5 mm chamfer legs. gates.sh ALL PASS.
2026-10-10 fix(hardware): pre-fab audit fixes, pad relay on NC contacts, MUX_S0 pull-down
    Five read-only audits (fab limits, assembly, electrical, ground return,
    renders) against c2635eb; reports under docs/audits/2026-10-10-prefab-*.md.
    K103 had IN_P and LINE_N on the NO contacts, so coil off left the 25.7 dB
    pad in circuit; c4788e2 wants coil off = MIC. IN_P moves to pin 2 and
    LINE_N to pin 7 (NC); IN_N stays on COM pin 6; the board is re-laid with
    a B.Cu lane between the relay pad rows. C127 now feeds U105.8 on F.Cu in
    the 5VA chain. The GND via inside D2.2 goes. R162 100k pulls MUX_S0 low:
    PE12 is the ROM bootloader's SPI4 SCK while PE11 holds its NSS, and a
    floating clock could lock the bootloade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
2026-10-10 fix(hardware): R162 as the MUX_S0 corner at U101, LINE_P single 45
    Owner moved R162 east of U101 pin 10 and re-laid LINE_P at C121 as one
    7.6 mm diagonal. Pad 1 of R162 is now the trace corner (vertical in from
    the north, straight west into pin 10), which removes the off-pad T; the
    collinear MUX_S0 split at the old spot is merged; the angles gate cap
    goes from 6 to 8 mm since the shorter cap only forced a 0.6 mm split.
    gates.sh ALL PASS, mega_audit loops 0 jogs 6 merge 0 tees 2.
2026-10-10 chore(hardware): final pre-production audit, library nicknames on the relay set
    Fab, plane, assembly and electrical re-checks at d267881 pass on every
    changed area; reports under docs/audits/2026-10-10-prefab-final-*.md.
    K103, D110, Q102 and R159-R161 now carry the cubevox: library nickname
    the schematic uses. Two firmware items stay open (PAD_EN driven from the
    menu with MIC default and 0 dB trim; DFU entry on encoder release).
2026-10-10 chore(fab): JLC production files v3 from 81a100f
    Gerbers, drills, BOM and CPL for the 4-layer board with the pad relay on
    its NC contacts, R162 on MUX_S0, rail test pads and the audit fixes.
    Same 16 plot files as v2; BOM 73 lines / 223 parts, CPL 223 rows with
    rotations 0 to 359. Owner-soldered J101, J106, J108, SWPWR1 and the
    test pads stay out. Upload v3 only.
2026-10-10 fix(hardware): JLC footprints for U107, U108, C19; production v4
    The H7 core block came from a KiCad-library project, so U107 (SOT-23),
    U108 (SOT-23-5) and C19 (EIA-6032 tantalum) kept stock footprints whose
    zero orientation is 180 degrees from JLC's. The v3 CPL therefore had all
    three turned round. Each now uses the easyeda2kicad footprint for its
    LCSC number (C412495, C221351, C8649) at the same centre; the track
    ends, TP10, the U107 ground via and the C19 5 V via follow the 0.13 to
    0.30 mm pad shifts. Every assembled asymmetric part is now on a JLC
    footprint. gates.sh ALL PASS, mega_audit loops 0, ERC 0.
    Production v4: BOM 73 lines / 223 parts, CPL 223 rows, U107 90, U108
    180, C19 180 de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
2026-10-12 fix(firmware): drive the pad relay, MIC default, mute before DFU
    PAD_EN was never driven, so K103 never switched and MIC mode added a
    +25.7 dB digital trim the hardware spec had retired. The setting default
    now matches the coil-off hardware state.
2026-10-12 refactor(firmware): knob filter and debounce move to core with tests
    Smoothing, stepping and debounce were pure logic inside board files with
    no host test.
2026-10-12 refactor(firmware): pure host-tested menu, input events, muted jack switch
    ui/ read pins and entered DFU itself, so none of it could be tested. The
    chain view wrote nine rows into an eight-row frame; it now lists the
    eight slots without a title. K103 switches only while the output is
    fully muted.
2026-10-12 feat(firmware): pixel canvas, Hyperlegible fonts, page-at-a-time OLED flush
    The U8x8 tile mode could only draw one 8x8 font and cleared the panel
    on every change. Screens keep their content until the OLED GUI spec;
    the header export picks up the current 9X12 E.
2026-10-12 refactor(firmware): honest knob curves, one pin table, untorn stats
    The registry described Decay as linear and Response with min > max, so
    the app would learn wrong curves. Pins were repeated outside pins.h and
    the 64-bit stats were read while the block IRQ could write them.
2026-10-12 chore(firmware): warnings fail the build, host test under ASan and UBSan
    Warnings in our sources went unseen and the chain view overflow was found
    only by chance. The gate recompiles our translation units with -Werror
    and treats the STM32 core and copied platform code as system headers.
2026-10-12 fix(firmware): pin decode through digitalPin, mute until the panel is read
    portOf/maskOf decoded Arduino pin indexes as PinNames, so SAI landed on
    PE0-PE4 and the fault handler wrote past GPIOK. The boot report now
    prints the decoded pins for bringup.py. Boot no longer unmutes before
    the knobs are seeded, layouts reject duplicate cards, and the mute
    sequence and bench parser move to their own tested modules.
2026-10-12 test(firmware): WeAct bench run after the structure pass, 0 failed
    Confirms the pin decode fix on silicon (SAI on PE2-PE6, fault record
    stored), clocks, block rate, stall mute, watchdog and DFU entry.
2026-10-12 feat(firmware): layout and settings record in flash bank 2
    Layout and menu settings reset at every power-up. Records append to a
    log in two bank 2 sectors, erases run without blocking the loop, and a
    flash ECC fault in bank 2 erases that sector instead of looping. WeAct
    bench: record survives a watchdog reset and a DFU reflash, 0 late
    blocks through erase and save.
2026-10-12 feat(firmware): panel self-test for the first board
    Swapped mux channels, dead or reversed pots and toggles, a stuck relay or
    a dead OLED would otherwise surface as effect bugs. bringup.py --panel
    walks every control and flags a channel that moves out of turn. WeAct
    bench: every command runs, relays step through the mute sequence, 0 late.
2026-10-12 test(firmware): emulator-to-firmware parity sweep
    Adam tuned the effects in the emulator, which maps knobs with its own
    code. The sweep fails on any drift; two known mismatches stay listed
    for the owner: Unison chorus-double blend and Chasm treble cut.
2026-10-12 fix(firmware): Unison blend and Chasm brightness match Adam's emulator
    The box fixed the Chorus-Double blend at 50 % (2 cents detune, half the
    swing) and Chasm's input treble cut at 0.99; Adam tuned with blend 0 %
    and Brightness 85 % (0.985). The parity sweep now has no open mismatch.
2026-10-13 feat(firmware): JSON serial protocol, live layout apply with fade
    The Mac app needs hello, get/set_layout, status and enter_dfu. Output
    goes through a non-blocking queue so a silent host can't stall the loop
    into the watchdog. The core's 3-packet CDC receive queue dropped and
    replayed bytes when the loop fell behind; build.sh raises it to 32.
    Engine clears spread over silent blocks keep the swap inside budget.
    WeAct bench: protocol_check all passed, swap worst block 458553 of
    640000 cycles, 0 late.
2026-10-13 docs(firmware): bench ops as framed JSON, drills only in bench builds
    A USB overflow turned stray bytes into bench letters that stopped audio
    and erased the record. No single byte may act on a performance box, and
    the release image should not carry fault, spin or erase drills.
2026-10-13 feat(firmware): bench ops as framed JSON, drills only in bench builds
    and erased the record. Bytes outside a JSON line are now ignored and
    counted; every action needs a parsed bench request whose op the build's
    table allows. Fault, spin, erase, stop-audio, panel and override code
    compiles only with CUBEVOX_BENCH, so the release image lacks it (nm).
    Core and board land together because the letter path spans both.
    Build variants get their own output dirs and a PID lock; CI builds and
    gates both. Host tools share one letter map, checked against the
    firmware table by ctest. WeAct: bench image bring-up 0 failed and
    protocol_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
2026-10-15 chore(hardware): SH1106 OLED model, STEP bodies for the JLC footprints
    Post-order mechanical pass. J117 courtyard follows the module body; the
    .step siblings let the KiCad STEP export carry every part for the
    enclosure. No copper changes.
2026-10-15 chore(hardware): rev-B patch for the post-order OLED-area copper
    The v4 layout is frozen at JLC. The 3V3/GND rework near J117 from the
    2026-10-10 OLED session lives here until a rev B opens.
2026-10-15 docs(app): Mac app design, one page with slots, bank and headroom meter
    Owner interview 2026-10-15. Saved layouts and the three screens are out;
    Update is one button shown only when a release is newer.
2026-10-15 feat(app): the page, slots, card bank, headroom meter, bottom bar
    Web Awesome 3.14.0 Default theme dark, vendored, no network. Tokens in
    tokens.css only; four inks overridden in OKLCH after the APCA gate
    failed Web Awesome's quiet text. Keyboard placement and drag and drop.
2026-10-15 feat(app): update flow, app bundle, installer and release workflow
    One Update button when a release is newer. Firmware by DFU with the
    bundled static dfu-util, then the app swaps its own bundle and
    relaunches on the same port. Release job on tag v* attaches
    cubevox.bin, cubevox.app.tar.gz and install.sh.
2026-10-15 feat(app): dropping a reverb replaces the placed reverb
    The second reverb card stays live in the bank. Dropping it on a slot empties
    the slot holding the other reverb, so one drag swaps engines. Owner 2026-10-15.
2026-10-17 refactor(firmware): core and ui audit pass, one source of truth per constant
    Card to engine mapping lives in the card table; slot, knob, timing and
    flash-word constants are defined once; enum-indexed tables are
    static_asserted. Knob steps are clamped at the registry edge, the record
    debounce no longer underflows, emit reports truncation, the framer
    rejects NUL, replies get a reserved queue tail. Sketch policy (actions,
    layout name) moved into ui/core with tests. Host test now builds -O2 with
    -Wshadow -Wdouble-promotion -Wundef -Wformat=2.
2026-10-17 refactor(firmware): board audit pass, every failure path reports
    Flash bank 2 checks the unlock, bounds every busy wait, rejects bad
    sectors and reports a failed erase or save. SAI and DMA errors are
    counted and printed. Controls re-seed every pot when the layout changes.
    One enterDfu() flushes the pending record, mutes and resets. USB pins
    and the SAI port come from pins.h. Loop policy (publish gate, canvas
    handoff, layout recovery) is pure and host-tested. README and the
    structure spec describe the tree as it is.
2026-10-17 fix(firmware): flash timeout leaves PG/SER set, named octave engine index
    A timed-out erase or program left its command bit set with the flash
    unlocked, so the next operation raised PGSERR and failed too. The octave
    engine index is now cv::kOctaveGranular in the engine header, shared by
    the firmware and the emulator. Boot report and slot tables follow the
    report* naming and std::array rule.
2026-10-24 docs(specs): field update design, UF2 bootloader and app at 0x08020000
    Mac app parked 2026-10-24; Adam updates the box by dragging a .uf2 onto the
    CUBEVOX drive. Bootloader in sector 0, CRC image header, shared boot block
    with a boot-fail counter, shop steps and drills. Teensy-H7-Port copies in
    firmware/platform/ become owned board code.
2026-10-24 docs(specs): field update spec to the proper bar, owner intent folded in
    Open source and pid.codes ids, serial from UID, OLED update-mode screens,
    DIAG.TXT and a bank 2 diagnostic log, ECC read-fault handling, MENU-held
    entry, 60 s no-host timeout, cubevox UF2 family id, pure C boot decision
    with host tests, bank 2 sectors 3-7 reserved for Adam's data. No signing
    (owner). Mac-app spec marked superseded on the box side.
2026-10-24 docs(specs): drop pid.codes and licence process from the field update spec
    Two-person project; the box meets two computers. Bootloader uses the test
    id 1209:0001, the app keeps 0483:5740. Roadmap starts at the code.
2026-10-24 test(firmware): split firmware_test.cpp into test/firmware by subject
    Fourteen files by tier and module, explicit list in CMake, same 566 check
    lines and the same 17,023 check calls. checkRegistryBounds compared two
    ChainParams with memcmp across never-set padding; it now compares a byte
    copy of the same object.
2026-10-24 feat(firmware): link at 0x08020000, image header, update request
    The TinyUF2 bootloader owns bank 1 sector 0, so the application links at 0x08020000 with a 32-byte CRC image header at +0x400 that the bootloader checks before it jumps. enter_dfu records an update request in the shared DTCM boot block and resets into the bootloader; ROM DFU stays a shop path behind BOOT0. The Teensy-H7-Port copies in firmware/platform/ become owned board/ code on stock STM32duino 3.0.0 with one linker script, firmware/cubevox.ld. hello gains serial (the MCU UID), status gains boot_fails and update_reason, and the firmware version string derives from VERSION.txt so the header, hello, the OLED and the release fi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
2026-10-24 feat(firmware): diagnostic log entry contract in boot_block.h
    Bank 2 sector 2 holds an append-only log of 256-byte CvDiagEntry records. The application writes them at boot after a non-power-on reset and when it requests update mode; the bootloader lists the newest in DIAG.TXT. One definition here so both programs and the host tests agree on the layout, the magic and the CRC trailer.
2026-10-24 feat(bootloader): TinyUF2 cubevox board, OLED update screens, DIAG.TXT
    TinyUF2 at a pinned upstream commit, patched through firmware/bootloader/patches, with a cubevox board and a WeAct bench board. The bootloader owns bank 1 sector 0, decides from the shared DTCM boot block (MENU held, app request, invalid or unreadable image, boot-fail count) and otherwise jumps to 0x08020000. In update mode it enumerates as a CUBEVOX drive that accepts only the cubevox UF2 family, draws its state on the OLED with the project fonts, and serves DIAG.TXT. A flash ECC double error during a read records the address and erases that app sector. The same screens.c renders numbered proof PNGs on the host.
2026-10-24 fix(ui): confirm screen keeps the version on the Now running row
    The two-row layout left the version touching the instructions with no spacer. versionTag clips any suffix to vX.YY.ZZ, so 'Now running vX.YY.ZZ' always fits one row and the spacer rows stay blank.
2026-10-24 feat(ci): bootloader job, uf2 release assets, update drills, Adam's guide
    CI builds both bootloader boards with the toolchain the firmware job installs and checks every .uf2 with stamp_image.py. A release attaches cubevox-vX.YY.ZZ.uf2, cubevox.bin for the shop ROM path and the bootloader binary, asserts the tag equals VERSION.txt, and no longer waits for the parked Mac app. bringup.py --update runs the thirteen update drills from the spec and cubevox_port.py can wait for the CUBEVOX volume. docs/update-guide.md is Adam's one page, worded from the approved screens.
2026-10-24 feat(bootloader): flash log in DIAG.TXT, bank 2 faults keep the image
    DIAG.TXT grows to 2048 bytes and lists the newest sixteen entries of the diagnostic log in bank 2 sector 2, read-only, with torn and blank counts. A flash read fault whose address lies in bank 2 records the address and keeps the prior reason; it never marks the image invalid, and the reader skips the sector until the application clears the address. The UF2 write state resets on every mount so a different file after a cut copy needs no power cycle; the erased-sector map re-arms with it. Bootloader version 0.02.
2026-10-24 feat(firmware): diagnostic log in bank 2 sector 2
    core/entry_log is a fixed-size append log over the shared FlashIo, which now lives in core/flash_io together with the word program, blank test and erase poll the layout record also uses. board/diag_service fills CvDiagEntry records: one at boot after any reset that is not a plain power-on or that left a fault record, and one before the box requests update mode, flushed with a bounded wait. Sector 2 joins the bank 2 map and the ECC recovery path, which also honours a fault address the bootloader recorded and clears it after a clean scan. Host tests cover scan, append, torn and bad-CRC entries, erase when full, drops and flush timeout.
2026-10-24 feat(tools): flash.sh through the CUBEVOX drive, toolchain pin, selftest in CI
    flash.sh takes Adam's path by default: enter_dfu over serial, wait for the drive, copy the .uf2, wait for the port, print the boot report. --rom keeps the ST ROM DFU write at the application start for a box whose application is unreachable, and --help lists both. build.sh pins the xpack toolchain like the bootloader script. CI runs the bootloader host self-test. The shop ROM asset is named cubevox-rom-0x08020000.bin so the parked app's old download name can never land on the bootloader. The guide tells Adam what to do when a copy stops partway.
2026-10-24 feat(tools): flash.sh waits for the drive to leave before the port returns
    cubevox_port.py --wait-volume --gone waits a bounded time for the CUBEVOX volume to unmount. flash.sh uses it after the copy, so a drive that stays mounted ends the run with an error quoting what cp said instead of a silent wait for a port that never comes. The CI bootloader job runs the host self-test after both board builds.
2026-10-24 refactor(firmware): one fault record definition for both programs
    CvFaultRecord, its magic, the fault kinds, the clock steps and the boot reasons move into boot_block.h with inline name functions. The application's fault module and boot health report call them, and the bootloader's DIAG.TXT writer drops its hand-mirrored copies. Host tests pin the offsets, values and every name string; the bootloader self-test proves the DIAG.TXT text is unchanged.
2026-10-24 docs: screens, tools and status follow what shipped today
    The spec's Adam steps, failure table, shop steps and drills name the approved screen sentences instead of the old titles, and its build.sh row drops the USB-id claim. CLAUDE.md says updates go by .uf2 onto the CUBEVOX drive. The index marks the field-update spec as built on the host side. The firmware README names the update drills.
2026-10-24 refactor: remove the WeAct stand-in, the guide and the bootloader release asset
    The WeAct H743 board was a temporary test stand-in and is not in the build path, so every WeAct path goes: the bootloader board, the second UF2 family id, BOARD=weact in the build and flash scripts, the USB always-on branch, the bring-up options, the CI step, the old bring-up logs and the doc sentences. The wrong-file drill now uses a file the stamp tool makes with a foreign family id. Adam needs no guide; the screens are the instructions. The bootloader binary is shop-only and leaves the release page.
2026-10-24 docs(specs): polish stages, top switch and the final menu order
    Owner 2026-10-24: POLISH COMP, a gentle always-available vocal compressor at the end of the chain, and POLISH EQ are ON/OFF rows; the menu stays one row per item with no sub-pages; the top-left switch is assigned MUTE or BYPASS in the menu; the eight rows get their final order.
2026-10-24 feat(firmware): ink metrics and proportional text on the canvas
    The font export now measures ink left and ink width per glyph and a space advance per face, and the canvas spaces 9X12 and 16X24 text by ink plus a 3 px gap and centres on ink, so labels no longer sit left-heavy and gaps no longer vary with the glyph. Tabular digit calls keep a fixed cell for rolling values. 5x7 stays fixed pitch and byte-identical, which the approved menu and update screens depend on.
2026-10-24 feat(engine): POLISH COMP, polish EQ row, top switch and the final menu
    A gentle feed-forward vocal compressor closes the chain before the polish EQ: RMS detector with a 150 Hz sidechain high-pass, -24 dBFS threshold at the level the voice actually has, 2.2 to 1 with a 6 dB knee, 10 ms attack, 150 ms release, 12 dB ceiling, makeup set by the level test on program scaled to the loops' level so ON is unity within a third of a dB on all three loops. The menu becomes eight rows in their final order with POLISH COMP and POLISH EQ as ON/OFF rows and TOP SWITCH as MUTE or BYPASS; bypass crossfades the output to the dry input over 50 ms with the chain still running. Settings gain the three fields, t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
2026-10-24 feat(ui): the owner's final menu, INPUT and OUTPUT as MIC or LINE
    Seven rows in the owner's order: INPUT, OUTPUT, TOP SWITCH, POLISH COMP, POLISH EQ, UPDATE FIRMWARE with a chevron, EXIT. Each row shows its current value and a click cycles it. The chain-order row goes; the chain view stays as a renderer for its proof. INPUT LINE is the 1/4" pad relay, formerly PEDAL. OUTPUT MIC is a 30 dB digital trim before the DAC, formerly INSTRUMENT at 12 dB, so a mixer mic channel needs no gain change when the box is inserted. Record bytes unchanged.
2026-10-24 feat(ui): menu rows at a 9 px pitch with the 1 px edge rule
    Seven rows leave room, so the list draws at a 9 px pitch with the text 1 px inside each row band: rows at 1, 10, 19, 28, 37, 46 and 55, two pixels between glyph rows, the last pixel line blank. Only the menu list changes; the other screens keep the 8 px grid. Owner 2026-10-24.
2026-10-24 feat(engine): POLISH COMP tunings with FIRM default, 4-pole sidechain, soft ceiling
    Three named compressor tunings, GENTLE, MEDIUM and FIRM, each with its own makeup solved on program at the loops' level; FIRM is the default by the owner's ear: -30 dBFS, 4 to 1, 4 dB knee, 3 ms attack, 100 ms release, 18 dB ceiling on reduction. The sidechain high-pass is 4-pole so a 50 Hz thump no longer ducks the voice at the firmer settings. A soft ceiling closes the chain tail after the output trim, bit-exact below -2 dBFS and never past full scale, so makeup plus a fast transient cannot wrap the DAC. cubevox-render renders any tuning for listening.
2026-10-24 feat(ui): runtime screens, voice ribbon, knob readout and MUTED with 2-frame dissolves
    The box's OLED shows three runtime screens: the input level as a ribbon scrolling at 50 px/s mirrored around row 32 with a dithered rim, a knob readout with the slot and card on top, the parameter name in 9X12 and the value in tabular 16X24 digits that roll when they change, and MUTED or BYPASS from the top-switch setting. Every screen change is one 2-frame Bayer dissolve at 25 fps; the voice screen walks 1 px every 60 s against burn-in. A pure GUI state machine owns the timings and is host-tested, 27 frames are golden against the owner's proof renderer, and the menu is unchanged. Spec docs/specs/2026-10-2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
2026-10-24 feat(ui): readout values sit in a fixed field per parameter, no re-centring
    Owner 2026-10-24: nothing on the readout moves sideways as a value changes. Each parameter's value row is laid out once from its widest rendering, a sign cell when the range is signed, the digit cells of its widest number, a space and the unit, centred once. The current value is right-aligned into the cells, a short number leaves its leading cell blank, the sign keeps its own cell, the unit never moves, and only digits roll in place. KEY text sits at a fixed left edge in its field. Eleven golden frames change by design; the other sixteen are byte-identical.
2026-10-24 test(ui): readout sweep proves nothing moves laterally
    Every card and knob in the registry is swept through its whole range, 18 parameters and 3,852 settled frames, and the test measures the pixels: each digit cell, the sign cell, the unit's first and last lit columns and the key name's left edge must sit where the first frame put them, so one pixel of lateral movement fails the build. Owner 2026-10-24.
2026-10-24 docs(specs): solder jig for the underside jacks
    A printed jig holds the four through-hole parts that hang from the underside and face the rear wall, combo J101, 1/4-inch J108, barrel J106 and the slide switch SWPWR1, while the owner hand-solders them after JLC assembles the top side. The STL is the printable export and the spec index lists the design.
2026-10-24 fix(tooling): decimal version bump, release gates, script and spec fixes
    Closes the tooling audit (build/audit/tidy-tooling.md): A1-A2, B1-B11,
    C1-C19, except B12 and C12, which need the owner.
    bump_version.sh read minor 08 and 09 as octal and wrote 00. release.yml
    published without the host suite or the bootloader selftest; it now has
    a tests job and creates a draft release with the .elf for the shop.
    build.sh takes OUT=, pins arduino-cli, removes a half-built image, prints
    a budget block and proves the release image holds no bench-only
    function. flash.sh waits for the box's boot line and refuses a header
    version that differs from VERSION.txt. The linker asserts the core's
    .noinit fits DTC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
2026-10-24 fix(audio): power-fail mute, knob rest, audio restart, SAI errors, pots
    Closes the audio audit (build/audit/tidy-audio-io.md): A1-A3, B1,
    B3-B6, C2-C5, and the engine audit's B6. B2 and C1 belong to the engine
    files.
    VA_SENSE on PB1 now feeds an ADC analog watchdog whose ISR drops XSMT
    and MUTE_N on a 5VA sag and releases after 500 ms stable. A knob tracks
    after a touch and publishes its rest position once still for 200 ms, so
    a pot turned to a stop reads exactly 0 or 1. A SAI or DMA error zeroes
    the TX ring, restarts the stream at most three times a minute, then
    latches the mute; SAI1_IRQn is enabled and every error is counted. The
    output trim ramps across one block, a NaN block is zeroed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
2026-10-24 fix(engine): retrim reverbs, smooth knob steps, drop dead variants
    Closes the engine audit (build/audit/tidy-engine.md): B1-B5, B7, C1-C9.
    B6 (the OUTPUT ramp) landed with the audio fixes.
    level_test builds the reverb rows through the registry, and the Spring
    and Chasm wet paths are retrimmed to unity at the box's settings.
    Unison's swing glides per sample, Octave and Autotune reset only at a
    settled-zero crossfade, and Autotune's crossfade waits for a tracked
    pitch, so knob steps and toggles no longer click. No libm call remains
    in a per-sample loop; gains are computed at block edges and
    interpolated. Harmony, Octave A and B, Autotune B, the dual-tap shifter
    and the non-oversampled distort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
2026-10-24 fix(bootloader): cable, clock and write failures, option bytes, header lock
    Closes the bootloader audit (build/audit/tidy-boot.md): A1, B1-B13,
    C1-C8, plus the health audit's A2, A4 and C4. C9 (a .clangd comment)
    waits on the lead.
    Every reader accepts image header versions from 1 up and the first 32
    header bytes are frozen. Update mode watches VBUS_SENSE: a pulled cable
    disconnects USB, shows "The cable came out." and restarts the 60 s
    timeout. A failed flash write is not counted and stops the update on
    screen and in DIAG.TXT; a transfer restarts cleanly on a different file;
    a dragged .bin, .zip or other wrong file gets the wrong-file screen. The
    bootloader arms IWDG at 16 s on the jump pa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
2026-10-24 fix(bootloader): read the compiler pin and sector size from the firmware scripts
    The bootloader build read the xpack pin with its own sed line, so the
    two scripts could drift and the tooling test flagged it. build.sh and
    flash.sh now source firmware/cv_define.sh for the sector size and ask
    firmware/build.sh --toolchain for the compiler. README and the
    field-update spec say so. The built image is byte-identical.
2026-10-24 refactor(core): chain walk and BYPASS mix move to core with a host test
    Closes the engine audit's C6 and the wiring the tooling, audio and
    engine agents left in files they did not own.
    core/chain_run holds runStage, runChain and mixBypass with no board
    state, and test/firmware/core_chain_run.cpp checks the routing, the
    shared PitchFx call, the copy-back, the NaN guard, per-stage timing and
    the equal-power BYPASS fade. audio.cpp calls them and behaves the same.
    chain_params.cpp and audio.cpp carry comments that match the code.
    build.sh drops the analogRead sampling define; nothing calls analogRead.
    README describes the ADC setup, the SAI error handling, the new status
    fields and the new modu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
2026-10-24 chore(bringup): cable screen and option-bytes check in the drills, bench rows
    Closes what the bootloader fixes left in other files: the .clangd note
    on the UF2 family id, the bring-up script's new cable screen and its
    drill 1 check that DIAG.TXT reports BOR level 3 with sector 0
    protected, the bench checklist's bootloader rows (4 and 8 updated,
    BO13 to BO22 added), the knob_step comment and the foundation spec's
    module tree, which now name core/chain_run.
2026-10-24 fix(ui): one SH1106 driver for app and bootloader, deaf splash, flat glyph
    Closes the UI audit (build/audit/tidy-ui.md): A1, B1, B2, B5, B7,
    C1-C7. B3, B4 and B6 moved to the health files.
    The app drops U8g2 and Wire. The bootloader's SH1106 driver is one C99
    file both programs compile, each with its own bus. The app sends one
    page per loop pass, gets a result back, keeps a failed page dirty and
    restarts the panel at once after the first failure and then once a
    second, with one [WARN] per run and one [oled] line on recovery, so a
    NACK can no longer lock the I2C handle and stall the loop. A panel that
    answers later is picked up within a second. The menu ignores clicks and
    turns until the fac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
2026-10-24 fix(health): stall watch, record recovery, planned reset, option bytes report
    Closes the health audit (build/audit/tidy-health.md): A1, A3, A4,
    B1-B5, C1, C2, C5-C9, plus the UI audit's B3, B4 and B6 and the audio
    and bootloader wiring. C3 (a build.sh check) goes to the final pass.
    The stall watch arms at each stream start and ignores a stream the
    audio module latched, so a slow OLED init can no longer latch the mute
    before the first block. A stall now mutes, logs an audio entry and
    resets the box once flash is idle. ECC recovery carries the newest
    intact record out of a faulted sector before erasing it, so a torn save
    boots on the last good state, never the defaults, and a sector that will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
2026-10-24 fix(firmware): wire the UI and health fixes, frame gate, docs and bench rows
    Closes what the UI and health fix passes left in files they did not
    own, the health audit's C3, and the README refresh.
    The sketch starts the panel through the shared driver and drops the
    stub display and the version tag; the stub files are gone. The menu
    shows "Starting the update." from the confirm click until the reset.
    The warn gate counts .c files and bounds every frame at 1152 B, which
    leaves processHalf 136 B and refuses a fourth block buffer. build.sh
    fails when the core's .noinit holds data inside the fault record's
    slot. The bench stats op prints the never-used stack. The boot report
    names the OLED pins a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
2026-10-25 docs(claude): names list and the Harmony line
    The owner asked for one list of the words the project uses for the
    enclosure, the panel, the effects, the screens, the update path and
    the people, after coined labels caused confusion in two sessions.
    The Harmony line now says the engine is out of the code.
2026-10-25 chore(release): keep the ROM .bin off the release page, track the motion proof scripts
    The release now attaches the .uf2 and the .elf only; the ROM DFU image
    stays in the cubevox-firmware CI artifact, so Adam sees no .bin beside
    the .uf2 (owner 2026-10-24; the field-update spec already says so).
    tools/oled-proof's motion renderer and GIF writer are tracked, since the
    pixel references under test/firmware/golden come from them; their GIF
    output is ignored.
2026-10-25 feat(fonts): 16X24 Final redraw on the box, firmware on Final fonts
    The owner settled every 16X24 glyph on named proposal sheets: 2, 1
    corners, counters as their own shapes, flush 3-row terminals, the 0 as
    a rounder O. The firmware now draws all three Final fonts. The widest
    key name is 116 px, so its field starts at x 6, and the Threshold field
    is 94 px. proof.js drops 0/O for this font, since the box never draws
    the letter O in 16X24. Goldens re-cut from the motion proof.
2026-10-28 docs(specs): solder jig rev 4 as built, OLED adapter plan and build
    The jig spec now records rev 4 as printed and used: shadow pockets with
    floors cut to the measured parts, lips, lead-in chamfer, corner webs.
    The OLED adapter spec is new. The real module's holes sit about 1 mm
    north of the board's holes, so a printed adapter with pegs in the
    board's holes and ribbed posts for the module's holes bridges them,
    the offset a user parameter. Section 4 and 5 hold the Fusion build and
    its measured checks.
2026-10-29 fix(firmware): board 1 bring-up, reset cause through the boot block, v2.00.39
    First power-up of board 1 passed every board check; three defects sat around the board. TinyUF2's jump calls HAL_RCC_DeInit(), which clears RCC_RSR before the application reads it, so the boot report had no reset cause: bootloader v0.04 reads the register once at start, clears it and stores it in the boot block (resetFlags, block version 2), and the application reads it from there alone. Both flash scripts took dfu-util 0.11's 'No error condition is present' status line for an error; one filter now lives in firmware/dfu_util.sh. bringup.py drills 5 and 6 read a DIAG.TXT macOS had cached at mount time and parsed a '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
2026-10-29 feat(bootloader): update screens on Myrtle 5x7, v0.05
    The application moved to the Myrtle fonts, but the bootloader kept drawing the Stylized Hyperlegible 5x7, whose glyphs differ, so the update screens showed the old font. Flashed on board 1 over BOOT0; the drive reports v0.05.
2026-10-29 docs(specs): readout card, proof D approved
    The owner approved proof D on 2026-10-29: the readout redrawn as one effect's card with a strip, knob pictures and a switch picture. The spec records the geometry, the panel row order and the open decisions. The renderer is kept; the sheets stay out of the tree; nothing is built.
2026-10-30 docs(specs): OLED adapter final, split pins at hole size
    Three prints settled the adapter. Crush ribs under the nozzle width
    printed solid and entered no hole; plain pegs entered and held nothing;
    tapered snap barbs were drawn. The owner then set the pins to the hole
    diameters with a 0.5 mm slot and printed: fits and holds. The spec
    records that geometry, the owner's seat, boss and wall, the two barb
    features left in error, and the printing note (supports under the
    frame; the earlier support-free claim was wrong).
2026-10-30 fix(firmware): pots follow the panel columns, ON/OFF on a flip, v2.00.40
    The slot table assumed the pots sit left to right in silkscreen order,
    but the board places POT03/POT15 in column 1 and POT01/POT02 in
    column 8, so every slot's toggle sat one column right of its pots.
    Slot N now takes the toggle and the two pots of column N, knob A the
    upper pot.
    A slot toggle flip raises the readout with ON or OFF on the value row,
    same hold, priority and dissolve as a knob move; the first debounced
    level after power-on raises nothing. The readout card spec is set
    aside in favour of this.
2026-10-30 feat(firmware): REVERB and DEBUG menu rows, load figure on the face
    The menu list scrolls, nine rows with seven visible. REVERB shows the
    reverb card in the layout, SPRING or CHASM, and a click swaps it
    through the same path as a layout from the app, so the audio fades and
    resets and the record saves. DEBUG, a reserved settings byte, draws the
    worst audio block of the last second as a percent at the bottom right
    of the voice screen.
2026-10-30 feat(firmware): ribbon from the output, self-scaling, input bar on the left
    The voice ribbon now follows the left output sample as written to the
    DAC, after output trim and the soft ceiling. Its height window tracks
    the loudest recent output (instant rise, 10 dB/s fall, top never under
    -30 dBFS, 44 dB span) so it fills at any output level. A 2 px input
    bar at columns 1-2 over the ribbon's rows, linear in dB from -50 to
    0 dBFS, and the ribbon moves to columns 4-127 with 62 levels.
2026-10-30 feat(fonts): Myrtle 7X12, a narrow sibling of 9X12, with the readout name proof
    A 6 px body in a 7 px cell, 12 px tall, 2 px stems, the same 50 glyphs
    as Myrtle 9X12, so "8 SPRING REVERB" fits a 128 px row with the slot
    number. readout_name_proof.cpp draws the candidate readout screens
    through the firmware canvas and readout_name_sheet.py composes the
    sheets the owner picked from (B0, then C0 with the name centred).
2026-10-30 feat(firmware): readout title bar in Myrtle 7X12, v2.00.43
    The readout's first row is now a lit bar over rows 0 to 13 with the
    slot number and card name in capitals, black, centred, in the narrow
    7X12 font with a 2 px ink gap (owner pick C2, 2026-10-30). The
    parameter name moves to row 16; the value row is unchanged. The toggle
    readout keeps the bar. 26 of 30 goldens re-cut from the motion proof.
2026-10-30 feat(engine): Spring Reverb as three parallel springs with more chirp
    Three springs at 37, 45 and 56 ms in parallel replace the two halves
    feeding each other (a ring of three put every echo on one 138 ms lap).
    32 disperser sections per spring at 0.80, a chirp sign tuning (up by
    default), drive 8x down to 4x, in-loop treble loss 6 to 9 kHz, bass cut
    200 Hz, a 5 kHz one-pole on the return. Owner ask 2026-10-30: more
    splash, chirp and liquid, less harsh. wetDb retuned by level_test.
2026-10-30 feat(firmware): lowercase units, centred values, boxed meter, v2.00.44
    Readout units read st, ms, dB and %, the value row centres on the
    width of what it draws and re-centres by half a cell only when a digit
    appears or vanishes, the autotune key names centre on their own width.
    The input meter is a 1 px box at columns 1 to 9, rows 8 to 56, with 16
    two-row segments, always drawn on the voice screen; the ribbon starts
    at column 13 with 57 levels and treats output under -60 dBFS as
    silence. Spring Reverb cost 15 points from the board's boot worst.
    Specs: OLED GUI Readout, Value field and Voice; Spring B decisions;
    the input conditioning spec and its index row.
2026-10-30 feat(firmware): input conditioning block and the Input gate revision
    HPF and LPF ahead of the slots, settings bytes 6 and 7, HPF/LPF/GATE LEARN
    menu rows, the Input gate retuned with its release on the DECAY pot, the
    noise floor in the status reply.
2026-10-30 feat(firmware): amount knob on the lower pot of every slot
    Owner 2026-10-30: MIX, DEPTH and DRIVE sit in the same place on every card.
    Unison, Slapback, Distortion and both reverbs swap so the amount knob is
    knob B, the lower pot. Octave already had Mix there.
2026-10-30 feat(tools): menu font proof sheet, three 7X12 candidates
    Owner 2026-10-30: the menu text is too small. A0 and B0 at a 12 px pitch,
    A1 at 13 px, every full label measured to fit beside its widest value.
2026-10-30 docs(specs): menu order input to output, every layout holds one reverb card
    Owner 2026-10-30: INPUT, HPF, LPF, REVERB, POLISH COMP, POLISH EQ, OUTPUT,
    TOP SWITCH, DEBUG, UPDATE FIRMWARE, EXIT; the REVERB row never reads NONE,
    so a layout without a reverb card is invalid.
2026-10-30 feat(firmware): menu order input to output, every layout holds one reverb card
    TOP SWITCH, DEBUG, UPDATE FIRMWARE, EXIT. A layout without a reverb card is
    invalid, so the REVERB row never reads NONE.
    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
2026-10-30 docs(specs): six small firmware additions, bench of v2.00.50 in the run log
    Owner list 2026-10-30: slot toggle crossfade, DC blockers after Octave and
    the reverb, ceiling ahead of the trim, late block passes dry, PVD brownout
    mute, power-on release order. Owner bench of v2.00.44 to v2.00.50 all good.
2026-10-30 docs(specs): power-on release waits 6 s for the output cap, output at zero through the relay close
    Owner 2026-10-30: the pop at power-on is the 10 uF / 100 kOhm output
    coupling's leftover DC, 1 s time constant, plus any signal at the instant
    the contacts meet. Next board: 10 kOhm bleed.
2026-10-30 feat(firmware): slot crossfade, DC blockers, ceiling before trim, dry late block, PVD mute, power-on order
    Owner list 2026-10-30, docs/specs/2026-10-30-output-safety-design.md: an
    8 ms equal-power crossfade on every slot toggle; 5 Hz DC blockers on the
    wet output of Octave and the reverb; the soft ceiling ahead of the output
    trim; a late block makes the next pass the dry input, counted as
    dry_blocks; the PVD interrupt (level 6, 2.85 V) drops MUTE_N at once; the
    power-on release waits 6 s for the output cap with the output at zero.
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2026-10-30 docs(specs): Fusion module replaced by the regenerated STEP on the 8 mm seat
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2026-10-31 docs(runlog): board 1 loop bench, unity, floors, pedal noise, latency 3.4 ms and 30.6 ms with Autotune
2026-10-31 feat(tools): loop bench scripts, latency by one-clock play-and-record and spectrum by band
    The method behind the 2026-10-31 run log row: the box in the Scarlett loop
    minus the cable straight gives the box's latency to the sample; the
    spectrum script splits a capture into tone harmonics and noise per band.
2026-10-31 docs(specs): Doubler card design and the POLISH EQ voicing spec
    Doubler: four PSOLA copies of the lead with formant, detune, wobble, timing and a shared room; DISTANCE and VOICES pots; reads the pitch ring and runs the tracker on its own. POLISH EQ: the owner's 2026-10-31 spec file enters the repo; its index row already existed.
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2026-10-31 feat(doubler): Doubler card, four formant-shifted copies of the lead
    New library card with DISTANCE and VOICES. Four PSOLA voices read the pitch front end's ring, each with its own formant move, detune, slow wobble and timing; one highpass and shelf on the gang sum; a shared small room; unity power at every knob position, the lead leaving above 80 %. The tracker runs whenever the card is on and Autotune's correction releases with its fade. Cost row 19/21 is a host estimate; layoutValid refuses it until a bench fits it. Spec docs/specs/2026-10-31-doubler-design.md.
2026-10-31 feat(firmware): gangtest build variant, Gang in Autotune's slot with the budget lines off
    VARIANT=gangtest builds an image labelled -gang that replaces the loaded layout at boot with the default layout and Gang in slot 2, without writing the record, and skips OverAvg and OverWorst in layoutValid. A listening image for the owner, not a ship image.
2026-10-31 feat(gang): retune 1, each copy is another person
    Owner 2026-10-31: the copies sounded too similar to the input. Each copy now has a pitch offset of a few semitones (pitchSt, fractional), a formant offset of a few semitones and its own tone shelf, then the wobble and the delay make it another performance. trimDb 3.1 dB.
2026-10-31 feat(gang): solo per voice, an emulator tuning hook
    GangParams::solo, a bit per voice; a soloed copy keeps its fade at 1 and the others sit at 0, the lead follows the law from the soloed power. The emulator's GANG tuning header gains a Solo node with four checkboxes and a Wobble node split out of Pitch so the column fits. The firmware never sets solo.
2026-10-31 feat(gang): simplified, time-only DISTANCE, lags to 200 ms, scatter and drift
    Owner 2026-10-31: the room, the DISTANCE EQ and the sine wobble go. The voice ring grows to 230 ms so lags reach 200 ms; DISTANCE scales each copy's lag by (1 + d); every lag change lands in a quiet gap at both the old and the new lag so no copy bends mid-word; timing scatter per word and a slow random pitch drift, both off by default; the owner's four voices as defaults; trimDb 2.1 dB.
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2026-10-31 feat(gang): WIDTH replaces DISTANCE, the line runs low, high, low, high
    Owner 2026-10-31. The upper pot spreads each copy's pitch offset from ±0.01 st to its full value; the lags are fixed at 1.2 × their sliders; copies 2 and 3 swap places and the +3 copy is +2.75.
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2026-10-31 feat(gang): breath out, the working set as defaults, a melodic bottom tenth on WIDTH
    Owner 2026-10-31. Breath removed, output bit for bit unchanged. Defaults: contour 0.8/1.2/0.7/1.1, level scatter 2 dB, timing scatter 12 ms, drift 15 cents, epoch align on; trimDb 1.0. WIDTH: pitch factor 0.003 at the bottom, 0.08 at the 10 % knee, 1 at the top; formant factor 0, 0.08, 1, so the bottom tenth is four plain detuned doubles for an instrument or a melodic line.
2026-10-31 feat(crowd): in tune at the bottom of WIDTH, and WIDTH glides
    Owner 2026-10-31: an instrument through the bottom tenth must not be out of tune. Knee 0.025, so the widest copy sits about 7 cents off at 10 %; drift and contour scale with WIDTH to nothing at the bottom. WIDTH itself is smoothed over 20 ms, which removes a one-block pitch spike on knob steps that predates this change. WIDTH 1 output is unchanged.
2026-10-31 feat(crowd): a fifth trial voice, another sex, age and body size
    Owner 2026-10-31. Outside the VOICES law, off by default, with its own level, lag, solo bit and sliders: pitch, formant to ±6 st, contour, tilt, breath under the copy, fry at phrase ends, a third-formant peak, a nasal notch, jitter and shimmer. Three presets: woman, older man, big man. With it off the output is bit for bit v2.00.68.
2026-10-31 feat(crowd): voice 2 is the owner's higher voice; per-copy tilt and shimmer; peak and notch out
    Owner 2026-10-31: the trial's higher voice, pitch +3, formant +1.65, contour 1.2, tilt +2, shimmer 1, replaces the second copy at its 100 ms lag. Tilt and shimmer are per-copy controls on all four and follow the WIDTH factor, so the bottom of the knob stays an exact double. Peak and notch leave the trial voice as inaudible.
2026-10-31 feat(crowd): voice 5 out, per-copy tilt and shimmer out, voice 2 back
    Owner 2026-10-31: the trial voice did not earn a place and the higher voice 2 is reversed. Voice 2 returns to pitch +2.75 st, formant -1.0 st, tone shelf -4 dB; engine/crowd_trial.h and the per-copy tilt and shimmer controls go. The default tuning reproduces the three v2.00.68 output hashes bit for bit.
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2026-10-31 feat(crowd): epoch align off by default; WIDTH pitch top at two thirds
    Owner 2026-10-31: WIDTH caused too much pitch variation, so the factor that feeds the pitch offsets, the drift and the contour deviation tops at 2/3 (kWidthPitchTop); formant offsets and lags keep the full factor. Epoch align starts off. Default-tuning hashes pinned as v2.00.74.
2026-10-31 perf(crowd): CPU pass; epoch align and the shadow ring removed
    Owner 2026-10-31. Grain launches found per launch, Hann window from a table, grain loop split at the ring seam, DC blocker dropped, one shared shelf filter, gap detector on four accumulators, per-block libm cached, tracker fine pass skipped while Autotune is off, ring sized for a 150 ms lag ceiling. Host cost 3.94 to 1.61 us per block for the card and 1.75 to 1.04 us for the pitch stage with Autotune off; DTCM 121,088 to 69,376 B. Epoch align and the shadow ring go: the box could never reach the control. Hashes pinned as v2.00.75 with a fourth on the shipped tuning.
2026-10-31 fix(crowd): clean switching, gap floor follows the signal, level holds across WIDTH, out-of-range notes
    Owner 2026-10-31, the correctness findings. Crowd holds its last period through its ramp and lays a start-up grain, so the off switch no longer clicks and the on switch has no hole. The gap floor sits 20 dB under the recent phrase level with a 6 dB re-arm, so lags land whatever the noise floor. A WIDTH-following trim (trimBottomDb) keeps every WIDTH within 0.5 dB over 30 s. Notes the tracker reads out of range take the plain path. Grains never read past the valid span. The render tool refuses non-finite and out-of-range values. The crowdtest image keeps the stored layout. Hashes re-pinned.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
2026-10-31 refactor(crowd): clean-up pass; tone shelf named, cost row and tracker split, one source for bounds
    Owner 2026-10-31, the clean-up findings. tilt becomes shelf everywhere the tone shelf is meant; Gang- and Doubler-era aliases go; stale comments corrected. costs.h gains kTracker, added once when Autotune or Crowd is placed, kCrowd set from the CPU pass host figure at 50.4k cycles per host us, board bench owed. Period and ratio bounds live once. Tests split under 40 lines; the voices-differ test compares colour at equal pitch; parity's tuning compare is a static_assert. No behaviour change: all four pinned hashes pass unchanged.
2026-10-31 docs(crowd): spec consolidated to the present card with a dated log
    The laws, the interface, the chain, the wiring, the tests and the cost state the card at v2.00.77 once. The day's additions and removals (first cut, Simplified, WIDTH, enhancements, voice 5, the voice 2 swap, the CPU, correctness and clean-up passes) are one dated log with the commit that holds each removed thing.
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2026-11-01 feat(crowd): eight copies; four raised 1.75 st and lagged 75 ms more
    Copies 5 to 8 each mirror a tuned copy: its lag target plus 75 ms before
    scatter, its pitch plus 1.75 st, own scatter and drift seeds; every copy
    3 dB down. The ring reaches 225 ms (kCrowdMaxLagMs), 51,024 B; each copy
    goes plain when its own reach is all unvoiced. The live copies render
    first and mix four at a time with the crowd sum and both shelf sums in
    registers, bit-exact. Host cost at VOICES 80 %, WIDTH 50 %: 1.57 us for
    four copies, 2.40 us for eight (kCrowd 19 / 21, estimate; a board bench
    is owed). trimDb 2.1, trimBottomDb 0.7; level rows within the rule.
    Hashes re-pinned for the eight-copy card.
2026-11-01 fix(pitch): correctness pass; halfway hold, clamped range, equal-power crossfade, glide from 0, rawHz guard
    Hysteresis of 0.15 st on the halfway point stops trills between two
    scale notes. A clamped flag on the tracker eases the voice at the band
    edges instead of jumping. Equal-power crossfades keep level through
    grain and enable fades. The first note after a reset glides from zero
    at RESPONSE. The target follows the newest frame within a fifth of the
    median, the median otherwise, so a leap lands on its own hop while
    noise cannot pull the target.
2026-11-01 feat(bootloader): v0.06 restarts on eject, not inside the last block
    macOS showed "disk not ejected properly" after every update because the
    box reset while the CUBEVOX drive was still mounted. Patch 12 gives
    msc.c two weak hooks: the last block calls board_dfu_written() once,
    and a host eject calls board_msc_ejected(). The board marks the boot
    block and shows the Done screen on the write, keeps the drive mounted,
    and resets 20 ms after the eject or when the cable comes out. flash.sh
    and bringup.py eject the drive after a complete copy.
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2026-11-01 docs(pitch): Autotune spec consolidated with the present front end; INDEX rows
    Present decisions first (RESPONSE law, rawHz within a fifth of the
    median, the halfway hold, clamped frames, grid PSOLA and the latency
    law, equal-power crossfade, hard-tune gate), then the pitch front end
    as built (ring, tracker gating, idle and replay, crossfades, reset
    rule, DTCM, cost rows), then a dated log. The old front-end spec and
    the CPU-pass spec point at it; the registry spec's Harmony and Crowd
    cells are corrected; the Crowd spec carries the clean-up rows, the
    scatter clamp and the run 3 re-pin.
2026-11-01 feat(costs): Crowd row from the board, 13 % mean and 15 % worst
    The crowd bench layout on the box measured Crowd at 78.7k cycles mean
    (12.3 %) and 94.97k worst (14.8 %), lowest worst over two 24 s runs.
    The host estimate of 19 and 21 came from the 50.4k ratio; the board
    sits at the pitch code's ratio. Crowd in slot 4 in place of Unison now
    sums under both lines, so the layout test asserts acceptance with sums
    built from the rows. The hello fixture follows the row.
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2026-11-01 feat(menu): swap Unison and Mob from a row after REVERB
    The slot that holds Unison or the Crowd card now swaps between them from the menu, the way the REVERB row swaps Spring and Chasm. The row's label names the slot, so the menu holds its labels in the frame to repaint when only the slot changes. The Crowd card's display name is now Mob, so the row reads UNISON or MOB, and the hello fixture follows the registry.
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2026-11-01 feat(costs): rows from the stress run, Autotune, Distortion, Crowd and Chasm worsts
    The 2026-11-01 stress run (four layouts, two runs each, sweeps of
    SEMITONES, reverb MIX and the Crowd knobs) read the pitch slot at 16.5
    to 16.8 % worst against the 16 % the rows summed to, Distortion at 10.1
    to 10.6 %, Crowd at 15.6 to 15.9 % and Chasm at 16.0 % mean and 16.5 to
    16.9 % worst. The rows now cover the lowest run worst per layout. The
    stress run is the method of record, so costs.h says so. The hello
    fixture follows the rows.
2026-11-01 fix(tools): stress.py counts every row check as a gate, passed or not
    Only failing slot rows entered the gate list, so "20 of 33 passed" hid
    that the passing rows were never counted. Each placed card's mean and
    worst now add a gate either way, and the count is the number of checks.
2026-11-01 feat(firmware): user LED shows the mean audio load, v2.00.84
    The LED toggled every 500 ms, which only said the loop runs, and the watchdog already guards that. Now it is lit for the mean load's share of each half second, from the mean block time over the last whole second (LoadWindow keeps a mean beside the worst), and dark while audio is not running, has stalled or is latched. The rule is pure in core/load_led.h so the emulator shares it. Owner 2026-11-01.
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2026-11-01 fix(emulator): playback-only device until MIC is picked; LED from core/load_led.h
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2026-11-01 fix(engine): Distortion's fixed treble cut halved to -2.7 dB, v2.00.91
    Owner 2026-11-01: the distortion had become a bit dark. Measured on Adam's clip at DRIVE 60 %, TONE noon: 2 to 4 kHz sat 6.2 dB under the dry voice, at every DRIVE; the top boost was not the cause. Halving the BD-2's post-clip shelf puts it 3.7 dB under at noon and lets TONE full up reach 1.8 dB over. The prototype's macro anchors move with it so parity holds.
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2026-11-01 docs(bloom): AMOUNT is loudness only; grains fixed at 63 ms, cut every 118 ms
2026-11-01 feat(menu): Formant is Octave's alternate in slot 3; slot 7 cycles Gate, Lo-fi, Bloom
    Owner 2026-11-01: formant should be an alternate for octave rather than slot 7. SLOT 3 row swaps OCTAVE and FORMANT like the UNISON/MOB row; the emulator's slot 3 and slot 7 switches follow.
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2026-11-01 fix(engine): KEY step glide, Lo-fi coefficient ramp, pitch stage cost
    A KEY change moved Autotune's correction a semitone inside one grain and read
    x1.059 knob_step. Lo-fi's float-accumulated ramp ended 32 ulp short and the
    snap stepped the high-pass. Octave or Formant without Autotune now carries
    the pitch stage's own cost.
2026-11-01 feat(bloom): LINGER 20 ms to 3 s, tails run their whole fade
    The 2.5 s age limit cut every tail above about 1.5 s. It now holds only
    while a word lasts, where a slice can stick. The tail law drops its
    120 ms floor so short settings shorten the tail; 80 ms and up unchanged.
2026-11-02 fix(bloom): CHATTER audit fix pass, dry holds at every AMOUNT
    CPU: settled paths, bounded voice loop, cheaper idle; the engine benches 7.80 ns a sample against 12.09 on clang. Correctness: cut-with-gap rule, key blip, a mid-chunk fade click. Cleanup: LENGTH and AMOUNT names, six tuning keys, rewritten bloom_test. Level: the trim sits on the wet alone (-14.5 dB), so the dry stays at unity at every AMOUNT (owner 2026-11-01).
2026-11-02 fix(spring): Spring audit cleanup pass, reverb DC blocker out
    The Spring cleanup and correctness audits found dead options, loose
    tests, shared parts copied between reverbs and work done on silence.
    Adam's clips now set the Spring level (+0.31 dB). The wet DC measured
    under -129 dBFS on both reverbs, so the DC blocker did nothing and goes.
    Spring's CPU line takes the board figure, 83.4k / 84.0k cycles.
2026-11-02 docs(specs): audit ledger doc fixes, emulator switches, warm rings
    The coverage check of every audit found spec lines that no fix pass
    owns: the emulator has four card switches, the pitch rings are warm
    only while the stage runs, POLISH EQ is built, CHATTER's trim is one
    constant, and the level rule names Formant and the reverb crossfade.
2026-11-02 fix(echo): Echo and Unison audit fix pass, dry holds, rows from the bench
    The three Echo audits found a slow per-sample path, a glide that stalled
    short of the knob, loose tests and mismatched names. Echo now runs about
    four times faster on the Mac. Echo's and Unison's dry stays at unity at
    every setting, with the trim on the wet alone. The Input gate and Gate
    rows take the 2026-11-01 stress run.
2026-11-02 fix(ci): host tests pass without Adam's clips and on other compilers
    CI has no samples/ (Adam's clips stay out of git) and an older clang.
    The emulator check now plays two synthetic voiced clips when samples/
    is absent, and MOB's output fingerprint is compared only on the
    compiler that recorded it; the runs still have to agree everywhere.
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2026-11-02 perf(pitch): Octave and Formant audit fix pass, kOctave 2 / 2
    Octave runs a 65-instruction fast loop with one fade, Q18 delays and a
    single Hann rotor; its trim, Mix default (10 %) and Semitones-0 crossfade
    follow the audits. Formant gets a 15-entry trim table fit on Adam's
    clips, the grain floor shared with MOB, a 0.04 s power window and a
    bit-exact silence skip. AutotuneVoice::tick is inlined on the M7.
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2026-11-02 fix(costs): Echo, MOB and both reverb rows from the 11-02 stress run
    The stress run of v2.01.11 read Echo's worst block at 2.1 % against its 2 % estimate and MOB at 13.5 % mean and 16.7 % worst against 13 and 16, so both rows sat under what the box spends. Spring and Chasm read inside their model estimates and are now measured rows. v2.01.12.
2026-11-02 perf(autotune): Autotune audit fix pass, KEY glide, kAutotune 3 / 5
    Bundle A (two-grain PSOLA rewrite, cross-multiplied lag scan, midiOf with one Newton step) cuts Autotune's host time by a fifth to a third; the tracker reads the caller's ring, so DTCM falls by 15 kB. A KEY change mid-note now glides over 50 ms instead of jumping, trimDb is +0.35 dB from Adam's clips, and the tests pin hard tune in Adam's register.
2026-11-02 docs(specs): Autotune fix pass, KEY glide, gates and registry cards
    The Autotune spec states v2.01.13: the KEY glide, the hard-tune gates at about twice the readings with 4 cents kept as the ceiling for a future CPU change, trimDb +0.35 dB, 61,420 B of DTCM, the new rows, and the lead's call on the 98 Hz KEY step. The registry spec lists Formant, Lo-fi and Chatter and the present groups.
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2026-11-02 fix(costs): Lo-fi and CHATTER rows from the board, v2.01.15
    The stress run of v2.01.14 read Lo-fi at 3.0 % mean and 4.9 % worst against its 2 / 2 estimate, and CHATTER at 1.9 / 3.7 % inside its 3 / 5. Both rows now carry the board's figures.
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2026-11-02 feat(engine): Distortion audit fixes and stage-major rewrite
    Distortion audits of 2026-11-02, owner: fix all. Five stage loops a chunk with a branch-free knee rail, a settled path, closed-form smoothers and the object in DTCM; TONE follows the knob at DRIVE 0; the treble shelf interpolates across a moving block; trim and makeup refit on Adam's clips; DRIVE under 4 % is off, on at 5 %, with a 16 ms smoothstep fade; NaN-proof knobs; tuning clamps and render ranges; clip rows fail on an empty clip.
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2026-11-04 feat(engine): Mob 2 audition card, vibrato, drift and onset jitter
    Owner 2026-11-04: an audition build to hear whether four copies with a
    vibrato, a pitch drift and an onset jitter of their own sound like
    separate singers. A mode of the Crowd engine so Mob stays bit-exact and
    DTCM is unchanged; DRIFT scales every modulation, VOICES steps 0 to 4
    then MOB; the slot 4 switch cycles UNISON, MOB and MOB 2.
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2026-11-04 feat(engine): Yawn RANGE spreads -12 st to +6 st through noon, v2.01.23
    The owner asked for the throat to move both ways with the far ends at
    -12 st and +6 st and no effect at noon. The zero-at-noon curve returns
    and the reversed linear one goes. The pitch stage takes shifts to 12 st
    from this card while the Formant card's SHIFT knob keeps its 7. At -12 st
    four grains overlap; the ring and lookahead hold, the window sum stays
    flat, and the bench puts the worst case 1.10 ns a sample over Formant.
2026-11-04 feat(tools): Fusion decal add-in, Image and Text Decal spec with UX audit
    One-button Decal add-in with a plain-Python core under ctest, and the
    step-by-step user-walk spec for the two add-ins that replace it, with
    its user-experience audit folded in. The spec is written; the add-ins
    in it are not built.
2026-11-04 feat(tools): lid inlay pipeline and simplified floral decal
    Vector art to lid-face mask, polygon trace with a settable simplify
    tolerance and minimum piece, and the Fusion bake by the slab route.
    art_simple.py makes the simplified candidates; D2 is baked (5,895
    sketch lines against 28,098). The pattern keeps off the window plus
    the hole clearance only: the 38.5 x 37 mm rectangle is the module's
    pocket under the lid, not a recess in the face.
2026-11-04 docs(specs): stage survival, decal add-in and image/text decal specs
    The fifteen stage failures with their fixes and drills, the one-button
    decal add-in as built, and the image and text decal add-ins written as
    the user's walk with the UX audit that shaped them. Index rows for all
    three.
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2026-11-04 feat(engine): Growl throat follows each syllable; Mob 2 removed, v2.01.24
    GROWL turns up the rasp and the throat drop together: each syllable drops
    the throat from -5 st toward -12 st at GROWL 100 % and it returns over
    300 ms. Yawn's follower, onset detector and sweep move to
    syllable_sweep.h, shared by both cards; Yawn hashes identical. Mob 2
    failed the owner's audition and comes out; Mob hashes identical.
2026-11-04 refactor(engine): shared files audit fix pass
    One slot fade for every card (engine gain linear, dry one minus it), so a
    toggle no longer bumps 3 dB for 8 ms. Shared helpers in one place
    (rbjCorner, dbToGain, kLog2E, kTurn32, keep/advanceBy, soft clip in
    reverb_parts.h), NaN-safe clamps and exp2Fast, the dead rotor grain gone.
    Every card hashes identical except Distortion's glides, -88 dB.
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2026-11-04 perf(engine): Unison audit fix pass
    The copies wait until the line passes the farthest tap, so switch-on has
    no tick; swing and LFO speeds glide over 150 ms; the settled path,
    cached increments and split loops cut the host cost about 40 %. The 50 ms
    line moves to DTCM. Bit-exact steps hash equal; the rest sits under
    -98 dB at any knob.
2026-11-04 perf(engine): Lo-fi audit fix pass
    The AMOUNT cap moves into the engine so the pot is the law, the dead
    quantizer columns go, a cubic tanh table and fast corners cut the
    settled block from 15.5k to 9.6k model cycles, and the trim lands the
    default at +0.08 to +0.29 dB. Structure changes hash equal; the table
    sits at -77.6 dB worst.
2026-11-04 fix(engine): Gate and Input gate audit fix pass
    Attack and Decay are travel times on both gates, the Input gate's
    detector is the larger of two 13.3 ms maxima with a 30 ms hold, the
    engine's off fade matches the 8 ms linear slot fade, and bad samples
    read 0. The settled block costs about a quarter of what it did.
2026-11-04 fix(core): slot fade follows an S curve, v2.01.30
    The straight-line fade bent the blend where it started and stopped,
    which showed on Lo-fi's toggle on low notes. The S curve leaves and
    reaches its ends flat and still sums the two gains to one. Lo-fi's
    enable at 220 Hz reads x1.0097 and is judged; its disable reads x1.058
    and stays a note. The owner chose the S curve and kept the gates' new
    Decay law and threshold hold.
2026-11-04 perf(engine): POLISH audit fix pass
    The output tail lives once in BlockFlow::run for the box, the host and
    the tests; GENTLE and MEDIUM leave POLISH COMP; a NaN guard on the sum of
    squares resets comp and EQ; 32-sample blends at both joins. Hashes equal
    except the BYPASS fade (-89.5 dB) and the notch setter (-139 dB).
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2026-11-04 chore(tools): tooling audit fix pass
    Render-tool range checks for every stage's tuning, stress.py sweeps and
    bench ops for BYPASS, POLISH COMP and EQ, cost rows from the stage passes
    (all false until the stress run), shared helpers in the files no stage
    pass owned. 69 renders hash equal.
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2026-11-05 fix(engine): ring mod carrier snaps to the nearest note
    The carrier glided after every pitch the tracker gave, so scoops and vibrato
    dragged it. It now holds the nearest note (the Autotune key's scale when placed,
    every semitone otherwise) with 0.2 st hysteresis and jumps on a note change.
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2026-11-05 fix(engine): ring mod waits 60 ms before following a new note
    One jumping tracker frame moved the carrier, so it wavered and re-tracked.
    A new note must now win for 60 ms; the margin is 0.3 st.
2026-11-05 fix(engine): Throat drop no longer bends the pitch; 100 Hz high-pass
    A moving throat slid every grain's pulse, so onsets wavered up to 0.48 st. The
    voice now anchors each pulse where the rest throat puts it. The owner asked for
    a 100 Hz high-pass on the wet.
2026-11-05 fix(engine): pitch tracker catches note onsets
    At mid-phrase onsets the tracker read unvoiced up to 244 ms, so every pitch card
    held the old note and then stepped up to 3.4 st. A clear 20 ms estimate now
    holds the pitch until the tracker voices, with a 15 ms handoff.
2026-11-05 feat(engine): Deepthroat snarls harder toward the top of GROWL
    Owner asked for more snarl as GROWL rises: the bite peak tops at +10 dB, the rasp
    jitter at 0.55, and a lopsided clip grows with GROWL squared.
2026-11-05 fix(engine): ring mod enters on the landed note after a gap
    After a gap the carrier held the old note, then stepped along the voice's scoop,
    so the wet ran through wrong pitches. The wet now ducks to dry in a gap and fades
    in once the pitch holds still.
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2026-11-05 fix(pitch): cut the tracker's onset and switch-on spikes
    The onset refinement summed all 13 lags in one block, so unvoiced onset blocks cost 1.3x a voiced
    hop; it now walks downhill from the coarse lag, capped at 8. The switch-on reset cleared 62 KB with
    newlib-nano's byte-loop memset, about 300k cycles in one block on the box; the ring now clears 512
    floats a block while the stage rests, and the tracker clears by word.
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2026-11-05 fix(chatter): cut the slices from the card's own input
    Chatter cut its slices from a copy of the block leaving the last pitch-stage slot, so they missed
    every card between that slot and Chatter. Owner rule 2026-11-05: every effect takes its input from
    the effect before it.
2026-11-05 fix(deepthroat): growl what reaches the slot
    Deepthroat cut its voice and its dry from the pitch stage's ring, so Octave, Formant, Unison and
    Echo ahead of it were lost at every MIX. It now keeps a ring of its own input and cuts on the
    tracker's grid shifted by the pitch the input carries. Owner rule 2026-11-05: every effect takes
    its input from the effect before it.
2026-11-05 fix(ringmod): track the pitch of the card's own input
    The carrier followed the shared tracker's pitch of the raw voice, so with Octave ahead it sat on
    the unshifted note. Ring mod now owns a tracker and a ring on its slot input and leaves the pitch
    group. Owner rule 2026-11-05: every effect takes its input from the effect before it.
2026-11-05 chore(cards): remove Sympath
    Sympath failed the owner's audition (2026-11-05). The card, its engine and tests, its stress layout
    and the app's row come out; the reverb slot cycles Spring and Chasm again.
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2026-11-05 fix(boot): seal the boot block so junk RAM is wiped
    After a ROM DFU session the boot report printed a fault made of junk: the block passed on blockVersion >= 1 alone. Block version 3 adds a seal word; the bootloader keeps a block only when the seal matches, and the app trusts version 3 blocks only with it.
2026-11-05 perf(board): word-wise memset, memcpy and memmove
    newlib-nano's versions are byte loops, about 5 cycles a byte, so every enable-time clear (Unison's line, Chatter's 46 KB, the tracker's block sums) cost far more than it should. The board's own versions move 16 bytes a pass. stress.py now flips Unison and Chatter so the box run measures their switch-on.
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2026-11-05 chore(tools): ship three more clips with the emulator
    Owner 2026-11-05: the electric piano loop, the amen break and the broken glass go in samples/ as they are, beside Adam's clip.
2026-11-05 chore(cards): remove Ringer
    Owner 2026-11-05: Ringer failed the audition. Slot 6 cycles Distortion and Deepthroat; DTCM drops from 67.4 % to 57.0 % with its tracker gone.
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2026-11-05 fix(polish): VOX EQ ON keeps the tail inside the level rule; stress measures VOX EQ at ON+CUTS
    At ON, rumble under 40 Hz in one of Adam's clips reached POLISH COMP, whose make-up lifted it 5 dB and pushed the tail to +1.88 dB RMS with no audible gain. A 40 Hz 4th-order high-pass now runs ahead of the comp whenever VOX EQ is on. The tail rows are judged again. stress.py sets vox_eq to cuts for its measurement and restores it.
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2026-11-05 fix(engine): re-fit trims on the cleaned clips; onset estimate waits past a hop block
    Adam's three clips lost their room rumble below 40 Hz (2026-11-05, originals in samples/original/). Formant's trim table, Lo-fi's make-up table and trim, and the VOX EQ and POLISH COMP trims were fitted on the rumble and are re-fitted. The onset estimate no longer lands on a block that also closes a hop, which the rumble had been hiding; Crowd's burst hashes move with it.
2026-11-05 feat(led): user LED brightness follows the mean load, flashes on a late block
    PB7 (TIM4_CH2) runs 12-bit PWM at 1 kHz. The level is the square of the
    mean load's share of the layout limit, a faint glow at idle and full at
    the limit, so an even climb in load reads as an even climb in light. A
    late, dry or overrun block holds the LED full for 100 ms. Dark while
    audio is stopped, stalled or latched. The emulator draws the same level.
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2026-11-07 feat(ui): the voice screen draws the chain output as an oscilloscope trace
    The scrolling ribbon is replaced by a scope: 103 columns of 8 samples
    (17.2 ms), a 1 px trace of joined column runs, the horizon line alone in
    silence. Every audio block writes one block into a ring in the block
    flow, the chain output after the NaN guard and ahead of POLISH COMP, or
    zeros for a silenced or dry block, so the trace never freezes. The frame
    starts at the rising crossing before the strongest peak in a 1100-sample
    span, so a vowel holds still. The scale keeps the ribbon's window top
    and floor and sets the height by a measured crest of 4.3, the dry
    voice's 90th percentile peak over RMS on Adam's clips.
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2026-11-07 feat(ui): the scope's scale fits each frame
    Each frame's own peak sets the height, so the loudest excursion lands on
    the top or bottom row at any level, and an echo tail or a quiet passage
    fills the screen. Between frames the scale falls 3 dB and rises at
    once. The floor rule stays so noise draws the line. The crest constant
    goes; the trigger's hysteresis is 5 % of the span's largest sample.
2026-11-07 fix(ui): the scope's silence is a fixed level; the floor rule goes
    The ribbon's floor rule called anything within 6 dB of the quietest
    recent tick silence. A decaying echo tail is a run of new quietest
    ticks, so the scope drew the whole tail as the line while it was
    audible. A frame whose peak is under -54 dBFS now draws the line and
    nothing else decides silence. The scale never fits below -40 dBFS, so
    hiss draws as a thin band and a tail shrinks into the line. The output
    level meter and the output energy path that fed it are removed; the
    input meter is untouched.
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2026-11-07 docs: level rule no longer names Harmony
    Harmony left the code 2026-10-24; the MIX-knob stages are Octave,
    Formant and the reverbs.
2026-11-07 fix(board): log dropped diag entries, check update-path returns, prune WeAct leftovers
    The diag log lost entries with no line, and the watchdog start, flush,
    flash lock, tick start and DMA restart dropped their results. One
    contract in boot_block.h now holds the clock, flash and option-byte
    numbers both programs use; one CRC step, one build lock, one define reader.
2026-11-07 refactor(engine): raise three cost rows to their readings; one copy of shared code
    kAutotune, kReverbChasm and kOctave worst now cover the board's readings.
    Swappable slots read one table; Growl uses InputRing; one block-coefficient
    holder, quarterTurn and sinTurns replace hand copies. Dead test hooks,
    decimals, oledName, the output energy sum and stale includes are gone.
    PolishEq is VoxEq, PitchFxParams is PitchCardParams.
2026-11-07 chore: drop the crowdtest build, park the prototype's build, fix Dwell as constants
    Mob is an ordinary card and flash.sh could not install the crowdtest
    image. cubevox-proto builds only with CUBEVOX_BUILD_PROTO=ON. Dwell has
    not been a knob since 2026-10-07; each reverb now holds its drive and
    compensation as two constants, bit-exact on the host.
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2026-11-10 fix(ui): splash covers the power-on wait, v2.01.74
    The face showed MUTED for the 4 s between the splash and the relay closing. The owner read it as the MUTE toggle's state and flipped the toggle, which then muted the box. MUTED now shows only for the toggle or a fault.
2026-11-10 fix(engine): soft notes pluck in Apraxia and Deepthroat
    A note that began below the onset level never started its sweep, so the throat sat at a fixed shift for the whole note. The sweep now starts on the first block with drive. Adds the soft-note tests, a VOX EQ stage fade test, and brings the Apraxia and VOX EQ specs to the code.
2026-11-10 fix(firmware): serial reader budget, failed restart, swap clear, clock wrap
    A host that kept sending held loop() in the serial reader until the watchdog fired; the reader now handles one line per pass. A failed stream restart no longer stands the stall watch down. A slot switched on across a layout swap starts from a cleared engine. The hello reply fits the reply reserve. The power-on relay wait and the late-block flash survive the millisecond counter's wrap.
2026-11-10 fix(ui): press across the menu timeout, mux guard latch, scope reset
    A MENU press held across the 15 s timeout reopened the menu on release. The pots went unread for 1.1 s when the millisecond counter wrapped. The voice screen could return with the trace from before the readout. The OLED GUI, scope and polish specs state the box as built.
2026-11-10 fix(bootloader): stopped copy, image check before Done, block filter, v0.07
    A copy that stopped partway left the Writing screen up forever, and a corrupt file showed Done before its check. A file based outside the application region was partly written before it was refused. The update cleared a bank 2 fault address the application still needs. The cable, host, block and eject rules move into a pure session with host tests, and the image check gains partial-image cases.
2026-11-10 fix(engine): pitch cards switch on without a gap or a dip
    Formant and Apraxia switched on behind a running Autotune played 17 to 24 ms of digital silence, and Octave from rest dipped at full MIX, because each card read a ring it had not yet filled. A card now stays off until its ring holds what its voices read. Formant at MIX 0 no longer keeps Autotune's tracker running, and a card coming back after a range dropout starts from reset voices.
2026-11-10 fix(firmware): a fourth stream fault in a minute restarts the box
    The owner replaced the mute latch on 2026-11-10: when the restart budget runs out the box mutes, logs the cause and takes the planned reset, as a stall does. A failed restart takes the same path. The latch state, its status field and its boot report line go.
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2026-11-10 fix(firmware): a power cut never leaves the layout record in update mode
    A power cut during the recovery from a bad flash word made every later start fault, and three faulting starts end in update mode. Each record sector now carries a read limit that survives a reset, so a sector faults at most once per power-on, and a start that learned a bad word gives its failed-start count back. A sector with a torn entry takes no more appends, a failed save is retried, and the sequence counts records a later build wrote. A host test cuts power at every step of a save, an erase and a recovery.
2026-11-10 feat(bench): stream fault and failed restart ops, scripted drills
    No bench op could raise a stream fault, so the drill for the restart on a fourth fault needed hands on the box. Two bench-only ops and three drills in bringup.py run it from the Mac and read the result from the port and DIAG.TXT.
2026-11-10 fix(engine): pitch cards keep their rings while off and switch on at once
    A pitch card with its toggle off wrote nothing into its ring, so every switch-on waited 40 ms or more for history. Each card now copies its slot input into its ring while off, the tracker is primed from the ring, and the switch-on fade holds the power its law intends. Octave's step through SEMITONES 0 is held at every voice phase. Tests pin the grain pair to the chain-order rule.
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2026-11-10 docs(specs): the readout dissolves between a slot's three readouts
    The toggle section said any knob or flip on the shown slot refreshed in place, while the dissolve section and the code dissolve between a slot's knobs and its toggle. The owner is fine with either, so the spec follows the box.
2026-11-10 fix(engine): switch-on hold lifts at most 6 dB, v2.01.84
    The hold works from a 1.3 ms power reading that a consonant can fool, and a +12 dB cap let a wrong reading make the voice four times louder for a moment. The largest lift the tones needed was 3.2 dB, and every switch-on bar holds at +6 dB.
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2026-11-10 fix(board): USB receive never sticks under a request flood, v2.01.87
    The core's receive callback armed the OUT endpoint with no buffer when its queue was full. The packet landed at address 0 and moved the write position over unread bytes, and a second arming from Serial.read lost the transfer-complete interrupt, so the box stopped taking requests until a power cycle. Our callback leaves the endpoint off when the queue is full and lets Serial.read arm it. bringup.py --flood drills it.
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2026-11-10 fix(ui): menu SLOT rows run in slot order on any layout
    The rows kept a fixed family order and only the label numbers followed the layout, so SLOT 8 could sit above SLOT 5. One function now maps list position to row for the layout, and drawing and clicks both use it.
2026-11-11 docs(specs): protector redone as a low cup that grips the lid
    The 2026-11-07 design stalled on how the boot would reach the lock. The owner ruled out growing the boot, so the cup holds the lid's side walls with pads and the boot, lid and dish stay as they are.
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2026-11-11 docs(specs): protector hold uses the TPU-GF data sheet stiffness
    The owner named the material, Siraya Tech TPU-GF. Its data sheet gives 450 MPa in bending, so the 300 MPa guess and the 10 N hold are replaced.
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2026-11-11 feat(enclosure): protector made a plain cup; seam measured for a snap
    Owner chose the plain cup, then pointed at the seam between lid and dish. The spec's claim that the seam cannot catch is corrected with the measured shape.
2026-11-11 feat(enclosure): protector snaps into the lid seam on solid walls
    Owner pointed at the seam and accepted 38.6 mm. Two snap ribs on the solid side walls replace the pads and fingers; a USB-C notch joins the rear wall because the rim is taller. Spec rewritten to match the model.
2026-11-11 fix(enclosure): protector knob pockets sit on the shaft axes
    17 pockets were 0.7 mm off in y: they were placed from a detail at the shaft tip, not the 6 mm shaft's axis. With 0.5 mm of room the knobs would not have seated.
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2026-11-13 fix(bootloader): INFO_UF2.TXT rebuilt with DIAG.TXT, v0.08
    The drive stays up after the last block since v0.06, and INFO_UF2.TXT was rebuilt only at a USB connect, so Installed kept the old version after a copy that failed the image check. Drill 7 on board 1 caught it under v0.07.
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2026-11-13 docs(specs): stage survival revised against the code at v2.01.90
    The survey of the firmware found the spec out of date: POLISH COMP is gone, the Input gate is a card, the NaN guard cannot name a slot, the reset wait has a 3 s cap, the mux wait holds the first snapshot, and the noinit section is full. Each After section now says where the change lands.
2026-11-13 docs(specs): a crash restarts the box as it was; safe start dropped
    Owner 2026-11-13: a stage box comes back in the state the musician expects and shows no fault-finding screen. F7 loses its all-cards-off start and the remembered card; every restart is the warm restart, with the panel read again.
2026-11-13 docs(specs): a restart mid-song never ends in update mode
    Owner 2026-11-13: failing to start before a gig and restarting mid-song are different cases. Once the box has run 5 s since power-on, a warm start zeroes the failed-start counter at once.
2026-11-13 docs(specs): stage survival rewritten from the owner's rules
    An audit of the earlier text found 23 faults, six of them ways the box would fail on stage. The spec now has two mechanisms: a restart that brings the box back as it was with a code on screen, and a small overload net that never leaves a card out. MENU at a start no longer enters update mode. stress.py gains the costliest layout the menu builds, measured at 44.1 % worst block.
2026-11-13 fix(bootloader): MENU at a start no longer enters update mode, v0.09
    The bootloader read MENU on every reset, so a crash while the singer's finger was on MENU ended on the silent update screen. Owner 2026-11-13: the menu's Update firmware item is the way in; the MENU path is not needed.
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2026-11-13 feat(board): a fault restarts the box as it was, with a code on screen
    Stage-survival spec section R. A box-caused reset is a warm start: audio starts before the panel, the mux scan and the relay skip their power-on waits, K103 is driven again, and the splash shows ERROR A1 to A4, C1 or W1 for 6 s. Once the box has run 5 s it marks the boot block, and a warm start by the same image zeroes the failed-start counter, so a restart mid-song never ends in update mode. Audio that does not start on a warm start resets again as A4. Blocks pass silence until the first snapshot.
2026-11-13 feat(bench): survival drills run hands-free from the Mac
    bringup.py --survival runs the stage-survival drill table on the costliest layout. The burn bench op forces late blocks, the boot report prints the restart code, and the load rule reads the same toggles as the snapshot so the bench force masks reach it.
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2026-11-13 fix(bench): overload drills burn inside one card's slot
    A burn outside every card kept blocks late after the costliest card went, so the load rule took every card and the one-card drill could not pass. burn takes a slot, its cycles count as that card's, and the load from outside the cards gets its own drill.
2026-11-13 docs(specs): survival drills pass on board 1 with v2.01.94
    All 12 hands-free drills passed on the rerun, so the index row no longer says the overload drills are being rerun.
2026-11-13 fix(chain): a card swapped into an off slot goes in without the fade
    Picking a card from the menu dipped the whole output for about 100 ms even when the slot's bypass toggle was off. A layout change whose changed slots are all off, and which changes nothing an on slot plays from, is now adopted at once; the changed engines clear one per block and the slot stays off until its engine has cleared.
